nguyenduchan/coutingmachine/pcb/STM32G030C8T6/STM32_PINOUT.html

# STM32G030C8T6 — Chân GPIO & nối mạch

Tài liệu pinout cho compact counting-machine carrier (board 150×100 mm, nguồn 24 V). MCU thay ESP32-S3; nguồn chân = stm32_pinmap.py.

U1 STM32G030C8T6 Package LQFP-48 · 7×7 mm LCSC C529329 GPIO dùng 33 / 48 pad Clock HSI (không crystal MCU) Nạp USB-UART CH340 + BOOT0

## 1. Tất cả chân chip STM32G030C8T6 (LQFP-48)

Mỗi chân có hai lớp mô tả:

- General — khi nào chân này được dùng trên STM32G030 nói chung (chức năng silicon / AF điển hình), không phụ thuộc board máy đếm.
- Project — trên carrier này chân nối gì; nếu DÙNG thì tại sao chọn đúng chân đó; nếu KHÔNG DÙNG thì vì sao để trống.

Nguồn SoT project: stm32_pinmap.py. AF general theo datasheet / RM STM32G0.

48

Pad LQFP

33

GPIO tín hiệu dùng

5

Nguồn / reset

10

Không dùng (NC)

DÙNG có net trên PCB NGUỒN VDD / VSS / VBAT / VREF / NRST KHÔNG DÙNG pad để trống / floating

Chân KHÔNG DÙNG: không hàn dây, không kéo cứng lên/xuống. Đặc biệt PF0/PF1 và PC14/PC15 (OSC) — để floating; FW cấu hình Analog hoặc Input no-pull. MCU chạy HSI, không gắn crystal.

Pad | Cạnh | Tên chân | Trạng thái | Net board | General (chip) · Project (board này)
1 | W | PC13 | KHÔNG DÙNG | — | GeneralGPIO đa năng. Trên G030 còn map RTC_OUT (xung 1 Hz từ RTC), WKUP2 (đánh thức từ Standby/Shutdown), đôi khi LED status. ProjectKhông dùng. Máy đếm chạy liên tục, không Standby/RTC lịch. Giữ floating làm dự phòng LED “alive” nếu respin sau.
2 | W | PC14 | KHÔNG DÙNG | — | GeneralMặc định OSC32_IN: vào thạch anh 32,768 kHz (LSE) cho RTC chính xác. Có thể GPIO nếu LSE tắt — không hard-tie nếu có thể bật LSE sau. ProjectKhông dùng. Không cần timestamp tuyệt đối; clock hệ thống = HSI. Pad trống, không kéo GND/3V3.
3 | W | PC15 | KHÔNG DÙNG | — | GeneralMặc định OSC32_OUT: cặp với PC14 khi gắn LSE. Chỉ GPIO khi LSE off. ProjectKhông dùng. Cùng lý do PC14 — không gắn crystal 32 kHz.
4 | W | VBAT | NGUỒN | +3V3 | GeneralDomain backup (RTC, backup registers). Có thể nuôi pin lithium khi mất VDD. Không có pin riêng thì phải nối VBAT = VDD. ProjectNối chung +3V3. Vì sao: không pin backup trên carrier; vẫn cấp VBAT đúng datasheet để domain nội không float.
5 | W | VREF+ | NGUỒN | +3V3 | GeneralTham chiếu dương ADC (và analog liên quan). Thường = VDD hoặc nguồn ref ngoài ổn định hơn. Không để hở. ProjectNối +3V3. Vì sao: không đo ADC field (cảm biến digital qua opto) nhưng chân bắt buộc có nguồn; = VDD là cấu hình chuẩn khi không cần Vref riêng.
6 | W | VDD | NGUỒN | +3V3 + C_MCU | GeneralNguồn core + I/O (thường 2,0–3,6 V). Mọi GPIO lấy mức từ VDD. Cần tụ decoupling sát chân. ProjectTừ U6 AMS1117-3.3, C_MCU 100 n + C_MCU2 1 µ. Vì sao: rail logic duy nhất cho STM32, TMC logic, pull-up opto.
7 | W | VSS | NGUỒN | GND | GeneralGround chip — mốc 0 V. Nối plane GND chắc, via ngắn. ProjectNối GND board. Vì sao: mốc chung CH340, opto emitter, TMC GND.
8 | W | PF0 | KHÔNG DÙNG | — | GeneralMặc định OSC_IN (HSE): thạch anh / dao động 4–48 MHz cho clock chính xác (UART baud chặt, timer đo). GPIO nếu HSE off. ProjectKhông dùng. Clock MCU = HSI; Y1 12 MHz chỉ cho CH340. HSI đủ USART1 nạp và STEP.
9 | W | PF1 | KHÔNG DÙNG | — | GeneralMặc định OSC_OUT (HSE): cặp PF0. Không nối cứng lên/xuống nếu sau bật HSE. ProjectKhông dùng. Cùng chính sách PF0.
10 | W | NRST | NGUỒN | /NRST | GeneralReset phần cứng active-low. Chuẩn STM32: pull-up + tụ + nút (hoặc supervisor). Kéo xuống = reset core/peripheral. ProjectR_NRST PU, C_NRST, SW_NRST. Vì sao: nạp UART cần pulse NRST khi giữ BOOT0; vận hành dùng nút khôi phục treo FW.
11 | W | PA0 | DÙNG | /BUP ← U44.C | GeneralGPIO / ADC_IN0 / TIM2_CH1 / USART2_CTS… Thường: nút, cảm biến analog, PWM/timer, wake-up. Pin đầu port A — dễ nhớ trong FW. ProjectIN đếm 24 V qua PC817. Vì sao PA0: cạnh Tây sát cụm opto → trace ngắn; đủ AF timer nếu sau đếm cạnh cứng; không cần ADC vì opto đã digital.
12 | W | PA1 | DÙNG | /IN2 ← U45.C | GeneralGPIO / ADC_IN1 / TIM2_CH2 / USART2_RTS… Cùng họ PA0 — cặp tín hiệu hoặc ADC thứ hai. ProjectDI phụ J_IN2. Vì sao PA1: liền PA0 trong cụm đếm/DI; cùng cạnh W → bus opto gọn, không bắt chéo.
13 | S | PA2 | DÙNG | /IN3 ← U46.C | GeneralGPIO / ADC_IN2 / TIM2_CH3 / USART2_TX… Hay UART2 TX hoặc PWM. ProjectDI phụ J_IN3. Vì sao PA2: tiếp cụm PA0–3; USART1 đã ở PA9/10 nên không chiếm PA2 cho UART2.
14 | S | PA3 | DÙNG | /CNT5 ← U47.C | GeneralGPIO / ADC_IN3 / TIM2_CH4 / USART2_RX… Cặp RX với PA2; hoặc timer/ADC. ProjectĐếm IR 5 V (J_CNT5). Vì sao PA3 (không PD1): bốn kênh đếm/DI liền PA0–3 cạnh opto; PD1 để spare HMI. SoT = pinmap.
15 | S | PA4 | DÙNG | /STEP → U3 | GeneralGPIO / ADC_IN4 / SPI1_NSS / TIM14_CH1… Thường CS SPI hoặc GPIO xung. ProjectTMC1 STEP. Vì sao PA4: cạnh Nam hướng đế StepStick; có thể timer AF sau; R_PD tránh false-step lúc boot Hi-Z.
16 | S | PA5 | DÙNG | /DIR → U3 | GeneralGPIO / ADC_IN5 / SPI1_SCK… Clock SPI1 hoặc GPIO. ProjectTMC1 DIR. Vì sao PA5: cặp STEP trên cạnh S; board không dùng SPI1 (không flash/sensor SPI) → giải phóng cho DIR.
17 | S | PA6 | DÙNG | /EN_TMC → U3 | GeneralGPIO / ADC_IN6 / SPI1_MISO / TIM3_CH1 / TIM16_CH1… PWM hoặc MISO. ProjectTMC1 EN (active-low). Vì sao PA6: gom STEP/DIR/EN một cụm A; R2 PU→3V3 = driver tắt khi reset (fail-safe).
18 | S | PA7 | DÙNG | /STEP2 → U4 | GeneralGPIO / ADC_IN7 / SPI1_MOSI / TIM3_CH2 / TIM14… MOSI hoặc PWM. ProjectTMC2 STEP. Vì sao PA7: tiếp cụm TMC cạnh S; motor 2 cùng kiểu wiring, dễ copy FW.
19 | S | PB0 | DÙNG | /DIR2 → U4 | GeneralGPIO / ADC_IN8 / TIM3_CH3 / TIM1_CH2N… PWM / complementary timer hoặc analog. ProjectTMC2 DIR. Vì sao PB0: pad liền sau PA7 trên LQFP Nam — DIR2 cạnh STEP2.
20 | S | PB1 | DÙNG | /EN_TMC2 → U4 | GeneralGPIO / ADC_IN9 / TIM3_CH4 / TIM1_CH3N / TIM14… Cùng họ PB0. ProjectTMC2 EN. Vì sao PB1: kết thúc cụm TMC trên cạnh S; R2B PU giống TMC1.
21 | S | PB2 | DÙNG | /LED_RUN → R → D_LEDRUN → GND | GeneralGPIO “trung tính” (ít AF). Thường LED status / heartbeat / flag phần mềm. ProjectLED RUN (xanh), active-high. Vì sao PB2: spare giữa TMC/PWR; Hi-Z boot = LED tắt. FW nháy ~1–2 Hz.
22 | S | PB10 | DÙNG | /PWM_OUT1 → U_PWR1.4 | GeneralGPIO / TIM2_CH3 / I2C2_SCL… Hay PWM công suất hoặc I2C2 clock. ProjectPWM MOSFET ch1. Vì sao PB10: AF timer phù hợp PWM; cạnh S→E gần U_PWR; không dùng I2C2 → không xung đột.
23 | S | PB11 | DÙNG | /PWM_OUT2 → U_PWR2.4 | GeneralGPIO / TIM2_CH4 / I2C2_SDA… Cặp I2C với PB10 hoặc PWM kênh 2. ProjectPWM MOSFET ch2. Vì sao PB11: cặp PB10; hai PWM liền nhau, cùng timer dễ hơn rải PA11/12.
24 | S | PB12 | DÙNG | /PWR_EN1 → U_PWR1.5 | GeneralGPIO / TIM1_BKIN / SPI2_NSS… Break timer hoặc CS SPI2; thường GPIO enable tải. ProjectEN MOSFET ch1. Vì sao PB12: tách EN khỏi PWM (fail-safe 2 lớp); cạnh cụm PWR.
25 | E | PB13 | DÙNG | /PWR_EN2 → U_PWR2.5 | GeneralGPIO / TIM1_CH1N / SPI2_SCK… Complementary PWM hoặc SPI2 clock. ProjectEN MOSFET ch2. Vì sao PB13: đối xứng PB12; không dùng SPI2 trên carrier.
26 | E | PB14 | DÙNG | /PWR_FAULT ← U_PWR*.6 | GeneralGPIO / TIM1_CH2N / SPI2_MISO / TIM15_CH1… PWM/MISO; hay input fault open-drain. ProjectFault chung 2 module (OD + PU). Vì sao PB14: một GPIO wire-OR tiết kiệm chân; cạnh FAULT pin module SE.
27 | E | PB15 | DÙNG | /VIB_CTRL → U_VIB.3 | GeneralGPIO / TIM1_CH3N / SPI2_MOSI / TIM15… PWM/MOSI hoặc DO công suất. ProjectCTRL SSR rung. Vì sao PB15: liền cụm PWR cạnh E; R_PD = OFF lúc boot; SSR on/off không cần PWM cao tần.
28 | E | PA8 | DÙNG | /VIB_FAULT ← U_VIB.4 | GeneralGPIO / TIM1_CH1 / MCO (clock out)… PWM TIM1 hoặc xuất clock debug. ProjectFault rung. Vì sao PA8: tách PWR_FAULT để FW phân biệt nguồn lỗi; cạnh U_VIB; không cần MCO sản xuất.
29 | E | PA9 | DÙNG | /UART_TX → CH340 RX | GeneralUSART1_TX (AF quan trọng trên G030) / TIM1_CH2… Cổng serial chính nạp bootloader ROM và log. ProjectTX → CH340. Vì sao PA9: bắt buộc USART1 cho USB-UART boot; không remap tự do như một số dòng khác.
30 | E | PC6 | DÙNG | /LED_ERR → R → D_LEDERR → GND | GeneralGPIO / TIM3_CH1… PWM, capture, hoặc DI/LED. ProjectLED ERR (đỏ). Vì sao PC6: cạnh E gần USB/STATUS silk; báo PWR_FAULT / VIB_FAULT / lỗi SW.
31 | E | PC7 | KHÔNG DÙNG | — | GeneralGPIO / TIM3_CH2… Cặp timer với PC6. ProjectKhông dùng. PC6 đã lấy cho ERR; giữ spare.
32 | E | PA10 | DÙNG | /UART_RX ← CH340 TX | GeneralUSART1_RX / TIM1_CH3… Cặp bắt buộc với PA9 cho USART1. ProjectRX ← CH340. Vì sao PA10: cặp USART1 cố định với PA9; chéo TX/RX chuẩn.
33 | E | PA11 | KHÔNG DÙNG | — | GeneralGPIO / USART1_CTS / TIM1_CH4… Flow-control hoặc timer. Trên G030 không phải USB_DM (không có USB device). ProjectKhông dùng. USB đi CH340; PWM tải đã ở PB10/11. Không nối D−.
34 | E | PA12 | KHÔNG DÙNG | — | GeneralGPIO / USART1_RTS / TIM1_ETR… Cặp flow-control PA11. Không phải USB_DP trên G030. ProjectKhông dùng. Không RTS/CTS (nạp thủ công BOOT+NRST). Không nối D+.
35 | E | PA13 | DÙNG | /SWDIO + R_SWDIO PU | GeneralSWDIO — dữ liệu Serial Wire Debug. Hầu hết board giữ + pull-up cho ST-Link nạp/breakpoint. AF IR_OUT hiếm dùng. ProjectSWD data + PU 10k. Vì sao vẫn nối: bỏ J_DBG (lot nhỏ) nhưng pad + R cho phép kẹp probe sửa FW; không để float.
36 | E | PA14 | DÙNG | /SWCLK + SW_BOOT | GeneralSWCLK (clock SWD) và trên G030 lấy mẫu BOOT0 lúc reset: cao = bootloader hệ thống, thấp = flash user. ProjectSWCLK + nút BOOT lên 3V3, R_BOOT PD. Vì sao PA14: một chân làm debug clock và chọn boot UART qua USB — không cần chân BOOT0 rời.
37 | N | PA15 | DÙNG | /TM_CLK → J_DISP.1 | GeneralGPIO / SPI1_NSS / TIM2_CH1 / USART2_RX… CS SPI hoặc GPIO bit-bang (protocol LED). ProjectTM1637 CLK. Vì sao PA15: cạnh Bắc gần J_DISP; bit-bang không cần SPI HW; SPI1 đã giải phóng cho TMC GPIO.
38 | N | PD0 | DÙNG | /TM_DIO → J_DISP.2 | GeneralGPIO trên G030C8 (port D ở LQFP48). Ít AF bắt buộc; thường GPIO / EVENTOUT. ProjectTM1637 DIO. Vì sao PD0: liền PA15 cạnh N → CLK/DIO ngắn tới XH-4; open-drain bit-bang phù hợp module 5 V.
39 | N | PD1 | KHÔNG DÙNG | — | GeneralGPIO (LQFP48). Có thể SPI2_SCK trên một số map; chủ yếu spare. ProjectKhông dùng. Không phải /CNT5. Để trống cạnh HMI; đếm 5 V = PA3.
40 | N | PD2 | KHÔNG DÙNG | — | GeneralGPIO / TIM3_ETR… Trigger timer ngoài hoặc DI. ProjectKhông dùng. Spare HMI / mở rộng sau.
41 | N | PD3 | DÙNG | /KEY_C3 → J_KEY.8 | GeneralGPIO. Ít AF bắt buộc — phù hợp ma trận phím, LED, CS. ProjectKeypad COL3. Vì sao PD3: pad Bắc W→E khớp J_KEY pin8 (đông nhất) → zero crossover PCB.
42 | N | PB3 | DÙNG | /KEY_C2 → J_KEY.7 | GeneralGPIO / SPI1_SCK / TIM2_CH2… Sau khi bỏ JTAG full, PB3 thường free SPI/GPIO. ProjectKeypad COL2. Vì sao PB3: tiếp chuỗi Bắc map J_KEY; không dùng SPI1.
43 | N | PB4 | DÙNG | /KEY_C1 → J_KEY.6 | GeneralGPIO / SPI1_MISO / TIM3_CH1… ProjectKeypad COL1. Vì sao PB4: cùng chuỗi map keypad không bắt chéo.
44 | N | PB5 | DÙNG | /KEY_C0 → J_KEY.5 | GeneralGPIO / SPI1_MOSI / TIM3_CH2 / I2C1_SMBA… ProjectKeypad COL0. Vì sao PB5: hết khối COL; I2C1 không dùng (không EEPROM/sensor I2C).
45 | N | PB6 | DÙNG | /KEY_R3 → J_KEY.4 | GeneralGPIO / I2C1_SCL / USART1_TX (remap) / TIM1… Thường SCL hoặc UART remap. ProjectKeypad ROW3. Vì sao PB6: USART1 cố định PA9/10 → PB6 rảnh cho hàng phím; map đúng J_KEY pin4.
46 | N | PB7 | DÙNG | /KEY_R2 → J_KEY.3 | GeneralGPIO / I2C1_SDA / USART1_RX remap… ProjectKeypad ROW2. Vì sao PB7: cặp I2C không dùng → giải phóng làm ROW; liền PB6.
47 | N | PB8 | DÙNG | /KEY_R1 → J_KEY.2 | GeneralGPIO / I2C1_SCL (AF khác) / TIM16_CH1… ProjectKeypad ROW1. Vì sao PB8: tiếp chuỗi ROW Bắc → J_KEY.
48 | N | PB9 | DÙNG | /KEY_R0 → J_KEY.1 | GeneralGPIO / I2C1_SDA / TIM17_CH1 / IR_OUT… ProjectKeypad ROW0 (J_KEY pin1). Vì sao PB9: pad 48 góc NW Bắc khớp pad1 giắc → ROW0–3 rồi COL0–3 đúng thứ tự vật lý.

### Tóm tắt chân không dùng trên board

Pin | Pad | General — khi nào dùng | Vì sao project không dùng
PC13 | 1 | RTC_OUT, WKUP2, GPIO status | Không Standby/RTC lịch
PC14, PC15 | 2–3 | Thạch anh LSE 32 kHz cho RTC | Không cần giờ tuyệt đối; HSI đủ
PF0, PF1 | 8–9 | Thạch anh HSE clock chính | HSI; Y1 chỉ cho CH340
PC7 | 31 | TIM3 PWM / capture | PC6 đã dùng LED ERR
PA11, PA12 | 33–34 | USART1 CTS/RTS, TIM1; không USB trên G030 | USB=CH340; không flow-control
PD1, PD2 | 39–40 | GPIO / timer ETR | Spare HMI; CNT5 = PA3

### LED ngoài GPIO (thụ động)

Ngoài RUN/ERR trên PB2/PC6, board có LED nguồn và LED hoạt động cảm biến không tốn GPIO:

- D_LED24 / D_LED3V3 — rail +24V / +3V3 có điện.
- D_LEDBUP / D_LEDCNT5 — đếm: +3V3 → R → LED → /BUP hoặc /CNT5; sáng khi opto kéo collector thấp (có vật chắn).
- D_LEDIN2 / D_LEDIN3 — cùng kiểu cho DI phụ.

Pad đã gán net trên PCB; track để đi dây tay.

## 2. Vai trò MCU trong project

Board carrier điều khiển máy đếm viên: đọc cảm biến đếm (cách ly opto), chạy tối đa 2 động cơ bước (TMC2209), điều khiển tải 24 V (module MOSFET), rung máng (SSR), hiển thị TM1637 + keypad, nạp/log qua USB.

#### Vì sao STM32G030?

Đủ GPIO (31 chân dùng), USART1 cố định cho CH340, giá SMT JLCPCB thấp, LQFP48 dễ layout cạnh DIN. Không cần Wi-Fi/BT như ESP32 cũ.

#### SoT (source of truth)

pcb/STM32G030C8T6/stm32_pinmap.py → gen_compact_carrier.py · verify_compact.py · BOM.md. Firmware Cube chưa có trong repo — tài liệu này mô tả phần cứng.

## 3. Chính sách định chân — lý do tổng thể

Quy tắc vàng: nhóm tín hiệu theo cạnh LQFP để dây PCB ngắn, khớp vị trí giắc field (N/S) và module driver (S/SE).

Tây (W) → Opto / đếm Nam (S) → TMC Đông/SE → PWR / VIB / UART Bắc (N) → HMI

Cạnh LQFP | Pad | Nhóm chức năng | Lý do
Tây (W) | 1–12 | PA0–PA3 đếm + nguồn | Opto U44–U47 nằm giữa board, gần cạnh Bắc (giắc cảm biến). PA0–3 sát cụm opto → trace ngắn, nhiễu ít.
Nam (S) | 13–24 | TMC1/TMC2 STEP·DIR·EN | Đế StepStick + J_MOT* ở cạnh dưới. STEP/DIR cần cạnh xung sạch — gom một cạnh, có R pull-down fail-safe.
Đông (E) | 25–36 | PWM/EN/FAULT, VIB, USART1, SWD | U_PWR / U_VIB ở SE; CH340 + USB ở NE. USART1 chỉ có trên PA9/PA10 (fixed AF).
Bắc (N) | 37–48 | TM1637 + keypad | J_DISP / J_KEY ở cạnh trên. Keypad ROW/COL map đúng thứ tự pad1→8 (W→E) → 0 crossover.

## 4. Sơ đồ khối hệ thống

## 5. Sơ đồ chân LQFP-48 (nhìn từ trên, pin 1 góc NW)

Màu theo nhóm chức năng. Chân xám = nguồn / NC. Số = pad LQFP.

Opto TMC PWR/VIB HMI UART/SWD Power/Reset NC / spare

## 6. Đếm & DI — Opto PC817 (U44–U47)

Cảm biến field 24 V / 5 V không nối thẳng vào GPIO. NPN open-collector kéo LED phía primary của PC817; collector phía MCU kéo xuống → GPIO đọc mức thấp khi có tín hiệu.

STM32 | Net | Opto | Giắc field | Chân linh kiện | Lý do dùng
PA0 pad11 | /BUP | U44 pin4 (C) | J14 pin3 OUT · hoặc J15 pin3 | BUP-30S Black OUT · fiber OUT | Kênh đếm chính 24 V. PA0 sát cạnh W → gần cụm opto. Pull-up R48 10k.
PA1 pad12 | /IN2 | U45 pin4 | J_IN2 pin3 SIG | PLC start / jam / DI phụ | DI dự phòng cùng rail SNS 24 V; cách ly giống BUP.
PA2 pad13 | /IN3 | U46 pin4 | J_IN3 pin3 SIG | Stop / dự phòng | Cặp với IN2; pad13 vẫn gần W/S góc — vẫn cụm opto.
PA3 pad14 | /CNT5 | U47 pin4 | J_CNT5 pin3 OUT | IR through-beam 5 V | SKU rẻ đếm 5 V; R series 1k (không 2k2). Không dùng PD1 — SoT là PA3.

### Pinout giắc liên quan

#### J14 BUP-30S (XH-4)

1 +24V_SNS (Brn) · 2 GND (Blu) · 3 OUT (Blk) → opto · 4 CTRL→+V Light ON (Wht)

#### J_CNT5 (XH-3)

1 +5V · 2 GND · 3 /OPTO_IN_5V → U47. Module TTL active-high cần transistor OC ngoài.

## 7. Động cơ bước — TMC2209 (U3 / U4)

MCU chỉ điều khiển logic STEP / DIR / EN. Pha động cơ ra J_MOT* từ module — không lấy giắc sẵn trên StepStick (layout DIN cạnh dưới).

STM32 PA4 STEP → U3 pad STEP + R_PD → TMC2209 → J_MOT1 A1/A2/B1/B2 → NEMA17

STM32 | Net | Module | Chân TMC (StepStick) | Fail-safe | Lý do
PA4 | /STEP | U3 | STEP | R_PD_STEP → GND | Xung bước motor 1. Timer PWM/GPIO toggle trong FW. PD tránh false-step khi MCU Hi-Z lúc boot.
PA5 | /DIR | U3 | DIR | R_PD_DIR | Hướng quay. Cùng cạnh S với STEP → cặp tín hiệu ngắn.
PA6 | /EN_TMC | U3 | EN (active-low) | R2 pull-up → 3V3 | PU giữ driver tắt khi reset/boot (an toàn). FW kéo LOW để enable.
PA7 | /STEP2 | U4 | STEP | R_PD_STEP2 | Motor 2 — SKU đắt / trục phụ.
PB0 | /DIR2 | U4 | DIR | R_PD_DIR2 | Liền pad với STEP2 trên cạnh Nam.
PB1 | /EN_TMC2 | U4 | EN | R2B PU | Cùng chính sách fail-safe như TMC1.

MS1/MS2/UART trên module TMC NC trên carrier — microstep cấu hình trên Jumpers module. VMOT qua PTC_MOT 1.1 A riêng từng kênh.

## 8. Tải 24 V — MOSFET + rung (U_PWR / U_VIB)

STM32 | Net | Đích | Chân module | Lý do
PB10 | /PWM_OUT1 | U_PWR1 | pin 4 | PWM điều khiển duty tải 24 V (van, blower…). R_PD_PWM1: boot Hi-Z = OFF.
PB11 | /PWM_OUT2 | U_PWR2 | pin 4 | Kênh 2 độc lập — 1 output = 1 module cắm rời.
PB12 | /PWR_EN1 | U_PWR1 | pin 5 | Enable cứng; tách khỏi PWM để fail-safe 2 lớp (EN OFF + PWM PD).
PB13 | /PWR_EN2 | U_PWR2 | pin 5 | Tương tự kênh 2.
PB14 | /PWR_FAULT | U_PWR1+2 | pin 6 (wire-OR OD) | Chung một net + R_PWR_FLT PU — tiết kiệm GPIO; FW đọc lỗi quá dòng/quá nhiệt module.
PB15 | /VIB_CTRL | U_VIB | pin 3 | Bật/tắt SSR máng rung (bowl feeder). R_PD_VIB = OFF lúc boot.
PA8 | /VIB_FAULT | U_VIB | pin 4 | Fault riêng rung; R_VIB_FLT PU. Tách khỏi PWR_FAULT để FW biết nguồn lỗi.

## 9. HMI — TM1637 + Keypad 4×4

### TM1637 (J_DISP)

STM32 | Net | J_DISP | Module | Lý do
PA15 | /TM_CLK | pin 1 | CLK | Bit-bang TM1637. Cạnh Bắc gần J_DISP. Gợi ý FW: open-drain (module thường 5 V logic, MCU 3.3 V OK với hầu hết module).
PD0 | /TM_DIO | pin 2 | DIO | Data 2-wire. J_DISP pin3=+5V, pin4=GND — driver trên module, không hàn SOP-20 trên board.

### Keypad (J_KEY) — map không bắt chéo

J_KEY xoay 90°: pad1 Tây → pad8 Đông. LQFP cạnh Bắc từ Tây→Đông: PB9…PB3 rồi PD3. Gán ROW0–3 rồi COL0–3 đúng thứ tự đó → PCB không cần vias bắt chéo.

J_KEY pin | STM32 | Net | Vai trò
1 | PB9 pad48 | /KEY_R0 | Hàng 0
2 | PB8 pad47 | /KEY_R1 | Hàng 1
3 | PB7 pad46 | /KEY_R2 | Hàng 2
4 | PB6 pad45 | /KEY_R3 | Hàng 3
5 | PB5 pad44 | /KEY_C0 | Cột 0
6 | PB4 pad43 | /KEY_C1 | Cột 1
7 | PB3 pad42 | /KEY_C2 | Cột 2
8 | PD3 pad41 | /KEY_C3 | Cột 3

FW điển hình: scan matrix — drive ROW lần lượt, đọc COL (hoặc ngược lại) với debounce.

## 10. USB-UART & Boot (CH340C)

STM32 | Net | Nối tới | Lý do
PA9 | /UART_TX | CH340 RX (chéo TX→RX) | USART1_TX là AF cố định trên G030 — bắt buộc cặp này cho USB-UART.
PA10 | /UART_RX | CH340 TX | USART1_RX. Không DTR/RTS auto-boot — nạp thủ công bằng nút.
PA13 | /SWDIO | R_SWDIO 10k → 3V3 | SWD data; không hàn J_DBG (lot nhỏ tiết kiệm). Vẫn có thể gắn đầu dò nếu cần.
PA14 | /SWCLK + BOOT0 | R_BOOT 10k→GND; SW_BOOT kéo lên 3V3 | Trên G030, PA14 đóng vai trò SWCLK và lấy mẫu BOOT0. Giữ BOOT + pulse NRST → vào bootloader UART.
NRST pad10 | /NRST | R_NRST PU, C_NRST, SW_NRST | Reset phần cứng chuẩn ST.

Quy trình nạp: giữ SW_BOOT → nhấn/nhả SW_NRST → nhả BOOT → flash qua cổng COM CH340 (STM32CubeProgrammer / stm32flash).

## 11. Chân nguồn MCU

Pad | Tên | Net | Ghi chú
4 | VBAT | +3V3 | Không dùng pin pin — nối chung 3V3.
5 | VREF+ | +3V3 | Tham chiếu ADC = VDD (chưa dùng ADC field).
6 | VDD | +3V3 | Từ AMS1117 U6; có C_MCU / C_MCU2.
7 | VSS | GND | Ground.

Chuỗi nguồn board: J1 → D3 → F1 → +24V → U2(MP1584) → +5V → U6(AMS1117) → +3V3 → U1. Crystal Y1 12 MHz chỉ cho CH340 — MCU chạy HSI, không gắn HSE.

## 12. Chân chưa dùng (NC) — nhắc lại

Trên carrier này các chân dưới không bao giờ được đọc/xuất trong vận hành. Cột General ở mục 1 mô tả khi nào chân đó dùng trên chip nói chung. Để floating; FW Analog hoặc Input no-pull. Không hard-tie PF0/PF1 hay PC14/PC15.

Pin | Pad | General — khi nào dùng | Vì sao không dùng trên board
PC13 | 1 | RTC_OUT / WKUP2 / GPIO | Không Standby, không RTC lịch
PC14, PC15 | 2–3 | LSE 32 kHz | HSI đủ; không cần giờ tuyệt đối
PF0, PF1 | 8–9 | HSE crystal | HSI; Y1 chỉ nuôi CH340
PC7 | 31 | TIM3 PWM / capture | PC6 đã dùng LED ERR
PA11, PA12 | 33–34 | USART1 CTS/RTS (không phải USB) | USB = CH340; không flow-control
PD1, PD2 | 39–40 | GPIO / TIM3_ETR | Spare HMI; CNT5 = PA3

## 13. Bảng tổng hợp GPIO đã dùng

Pad | Pin | Net | Hướng | Nối tới | Chân đích | Lý do ngắn
11 | PA0 | /BUP | IN | U44 | C (4) | Đếm 24V chính
12 | PA1 | /IN2 | IN | U45 | C (4) | DI phụ
13 | PA2 | /IN3 | IN | U46 | C (4) | DI phụ
14 | PA3 | /CNT5 | IN | U47 | C (4) | Đếm IR 5V
15 | PA4 | /STEP | OUT | U3 TMC1 | STEP | Xung bước M1
16 | PA5 | /DIR | OUT | U3 | DIR | Hướng M1
17 | PA6 | /EN_TMC | OUT | U3 | EN | Enable M1 (AL)
18 | PA7 | /STEP2 | OUT | U4 TMC2 | STEP | Xung bước M2
19 | PB0 | /DIR2 | OUT | U4 | DIR | Hướng M2
20 | PB1 | /EN_TMC2 | OUT | U4 | EN | Enable M2
22 | PB10 | /PWM_OUT1 | OUT | U_PWR1 | 4 | PWM tải 1
23 | PB11 | /PWM_OUT2 | OUT | U_PWR2 | 4 | PWM tải 2
24 | PB12 | /PWR_EN1 | OUT | U_PWR1 | 5 | EN tải 1
25 | PB13 | /PWR_EN2 | OUT | U_PWR2 | 5 | EN tải 2
26 | PB14 | /PWR_FAULT | IN | U_PWR1+2 | 6 OD | Fault chung
27 | PB15 | /VIB_CTRL | OUT | U_VIB | 3 | SSR rung
28 | PA8 | /VIB_FAULT | IN | U_VIB | 4 | Fault rung
29 | PA9 | /UART_TX | OUT | CH340 U5 | RX | USART1 TX
32 | PA10 | /UART_RX | IN | CH340 U5 | TX | USART1 RX
35 | PA13 | /SWDIO | I/O | R_SWDIO | — | SWD
36 | PA14 | /SWCLK | I/O | SW_BOOT | — | SWCLK+BOOT0
37 | PA15 | /TM_CLK | OUT | J_DISP | 1 | TM1637 CLK
38 | PD0 | /TM_DIO | I/O | J_DISP | 2 | TM1637 DIO
41 | PD3 | /KEY_C3 | I/O | J_KEY | 8 | Key col3
42 | PB3 | /KEY_C2 | I/O | J_KEY | 7 | Key col2
43 | PB4 | /KEY_C1 | I/O | J_KEY | 6 | Key col1
44 | PB5 | /KEY_C0 | I/O | J_KEY | 5 | Key col0
45 | PB6 | /KEY_R3 | I/O | J_KEY | 4 | Key row3
46 | PB7 | /KEY_R2 | I/O | J_KEY | 3 | Key row2
47 | PB8 | /KEY_R1 | I/O | J_KEY | 2 | Key row1
48 | PB9 | /KEY_R0 | I/O | J_KEY | 1 | Key row0

## Tham chiếu file

- pcb/STM32G030C8T6/stm32_pinmap.py — SoT tên chân
- pcb/STM32G030C8T6/gen_compact_carrier.py — netlist & placement
- pcb/STM32G030C8T6/BOM.md — BOM + pinout giắc
- pcb/STM32G030C8T6/verify_compact.py — kiểm tra pinmap

Một số đoạn cũ trong PCB_REVIEW.md / README ESP32 mô tả pin khác (ESP32-S3 hoặc map PWM cũ). Khi lệch, luôn tin stm32_pinmap.py.

Counting Machine · STM32G030C8T6 pinout · sinh từ pinmap project · mở file này bằng trình duyệt
