nguyenduchan/coutingmachine/3d_model/freecad/out/_snapshot_front.png

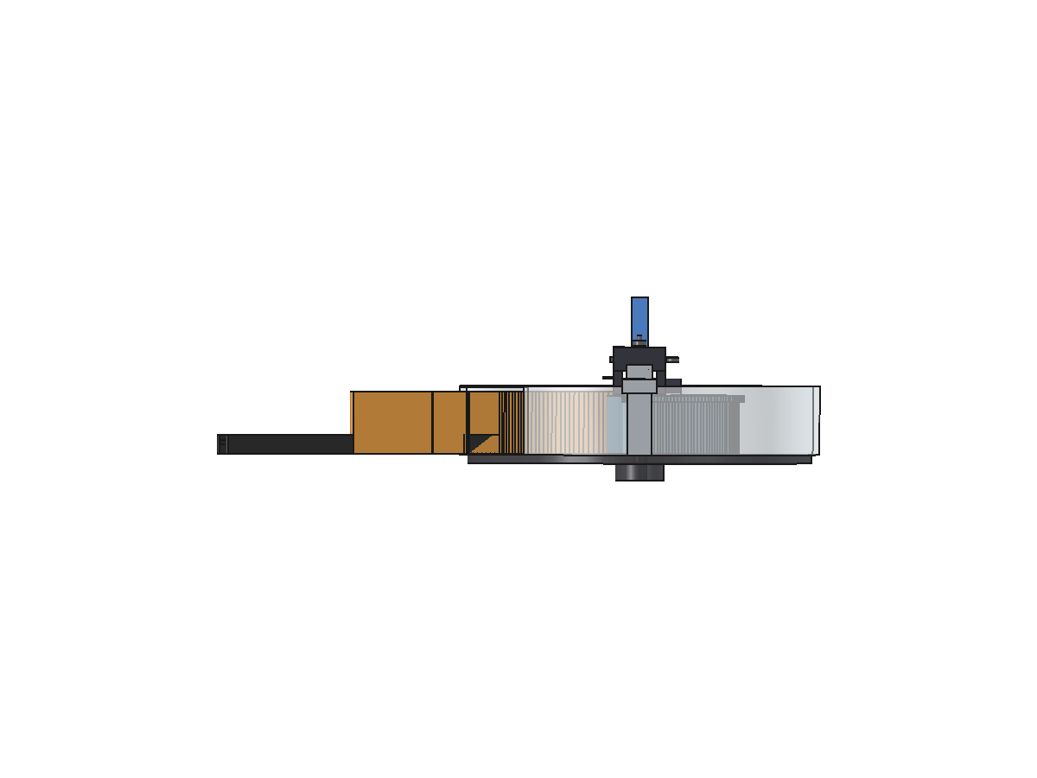
3d_model/freecad/out/_snapshot_front.png
