nguyenduchan/coutingmachine/3d_model/freecad/out/_snapshot_iso.png

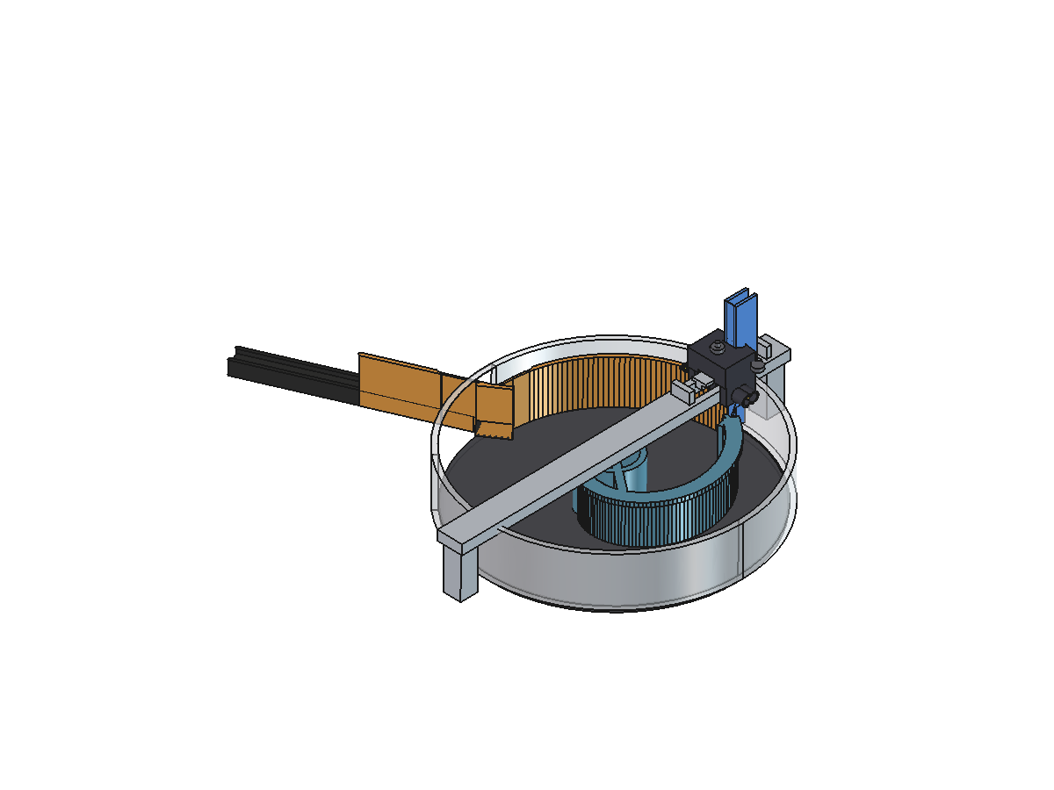
3d_model/freecad/out/_snapshot_iso.png
