nguyenduchan/coutingmachine/3d_model/freecad/out/exit_tray_topview.png

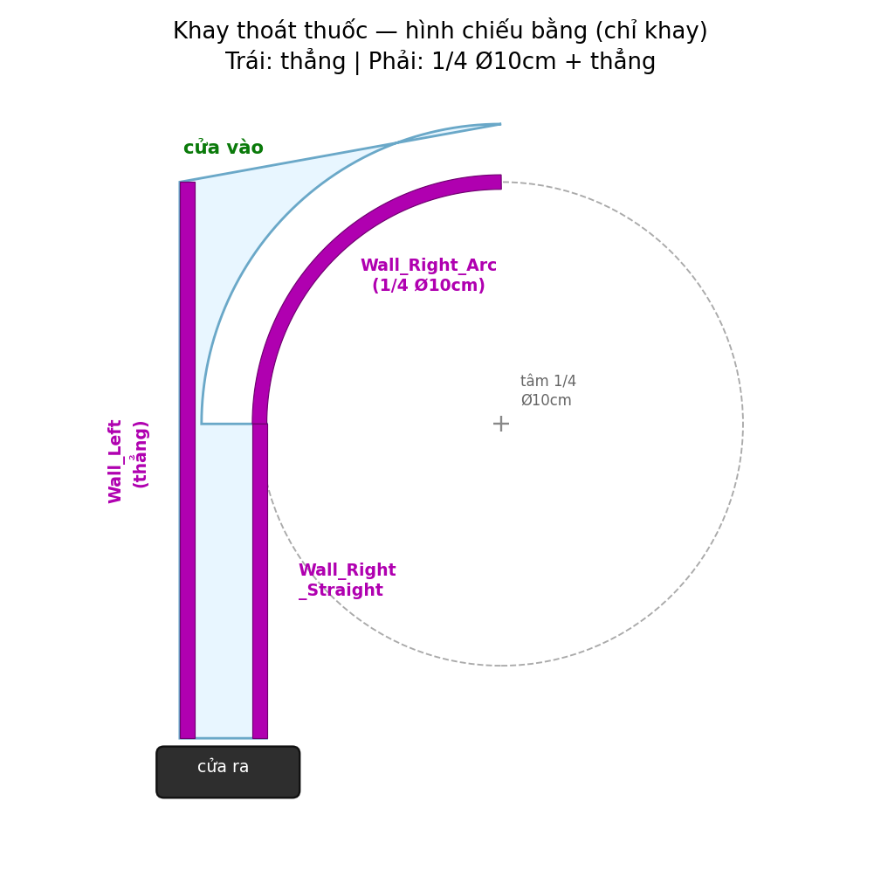
3d_model/freecad/out/exit_tray_topview.png
