nguyenduchan/coutingmachine/3d_model/freecad/out/l_flap_pill_path_choice.png

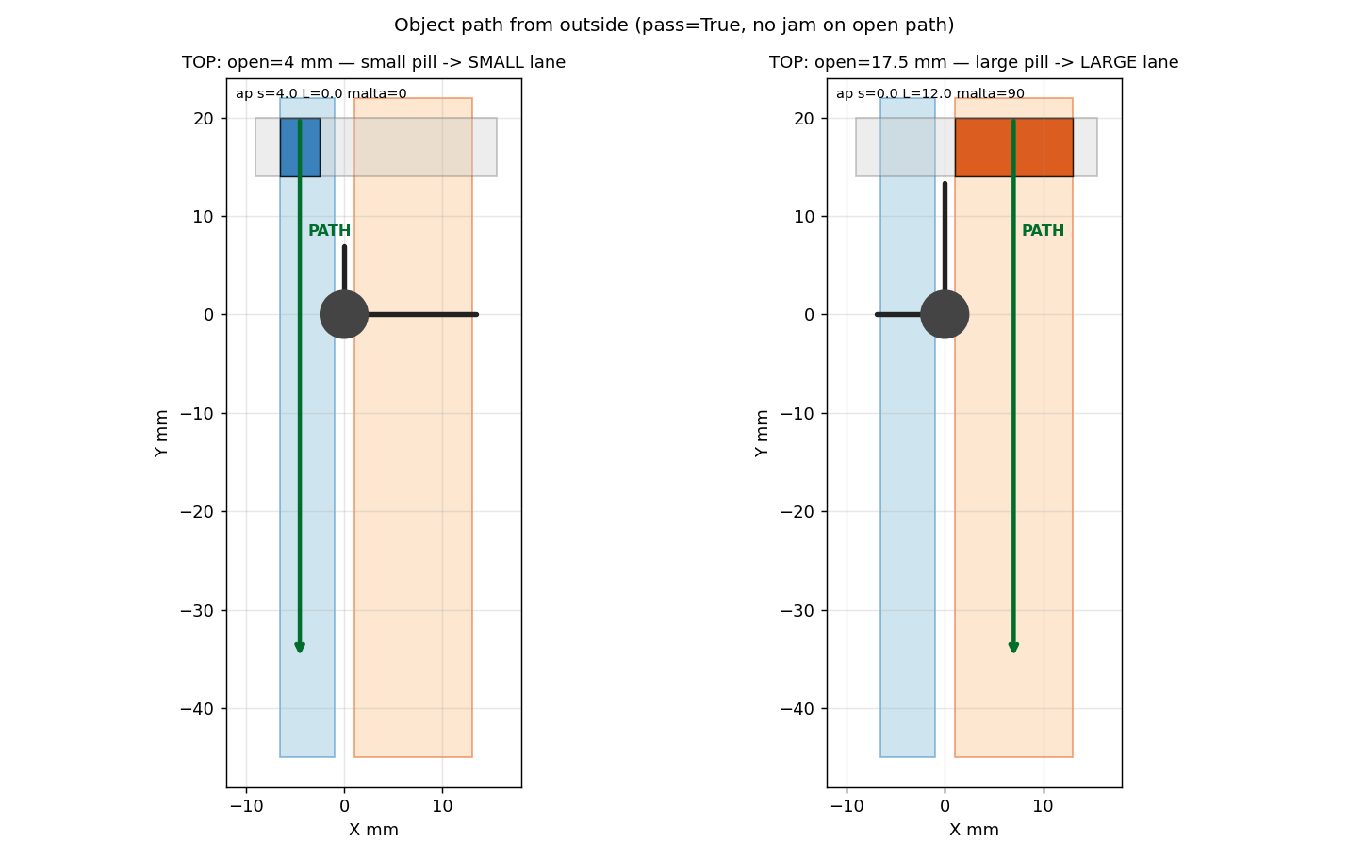
3d_model/freecad/out/l_flap_pill_path_choice.png
