nguyenduchan/coutingmachine/3d_model/freecad/out/l_flap_topview_open0_cover_small.png

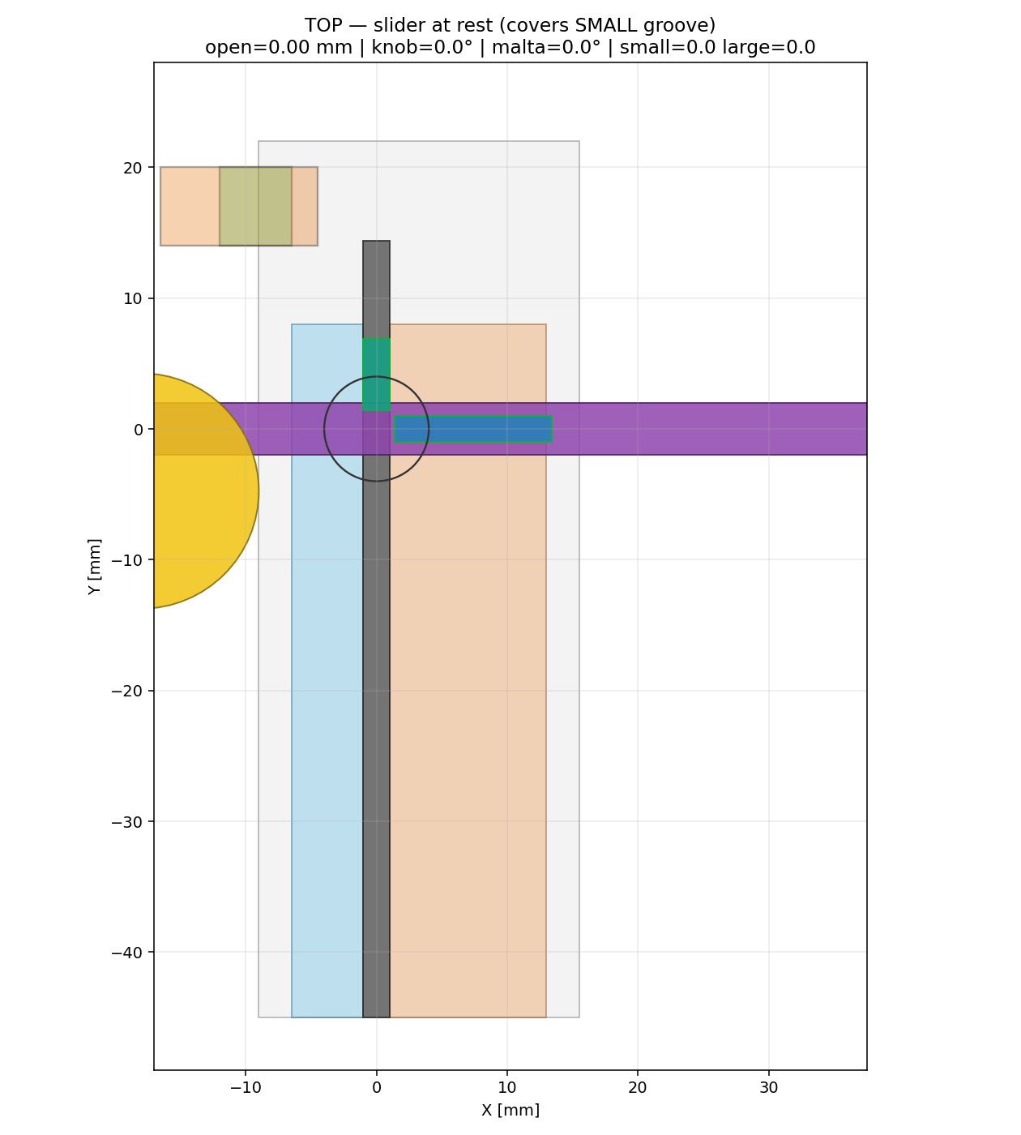
3d_model/freecad/out/l_flap_topview_open0_cover_small.png
