nguyenduchan/coutingmachine/3d_model/freecad/out/ref_frame_01.jpg

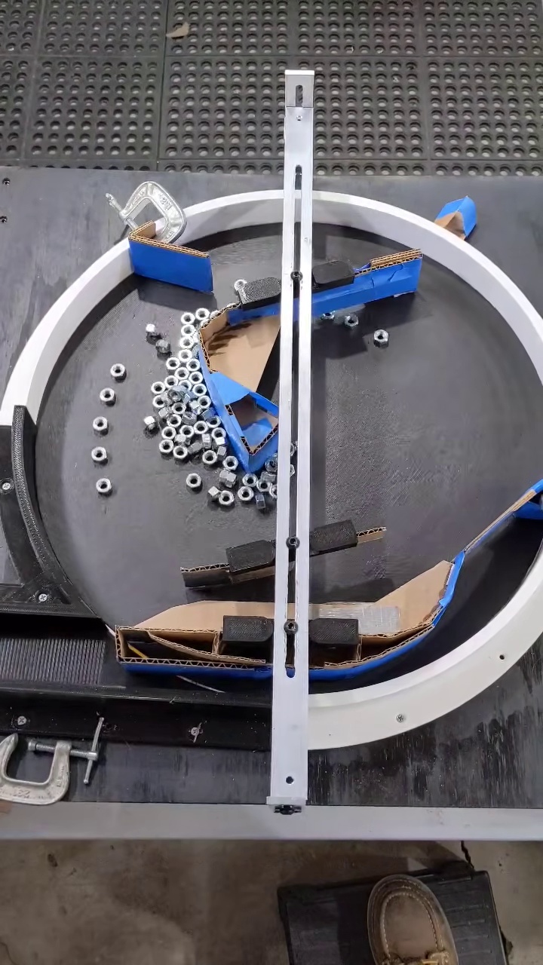
3d_model/freecad/out/ref_frame_01.jpg
