nguyenduchan/coutingmachine/3d_model/freecad/out/ref_schaner_thumb2.jpg

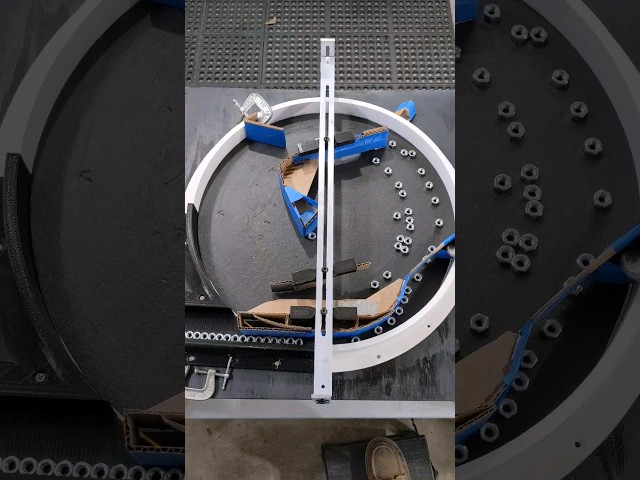
3d_model/freecad/out/ref_schaner_thumb2.jpg
