nguyenduchan/coutingmachine/3d_model/out/base_cavity.png

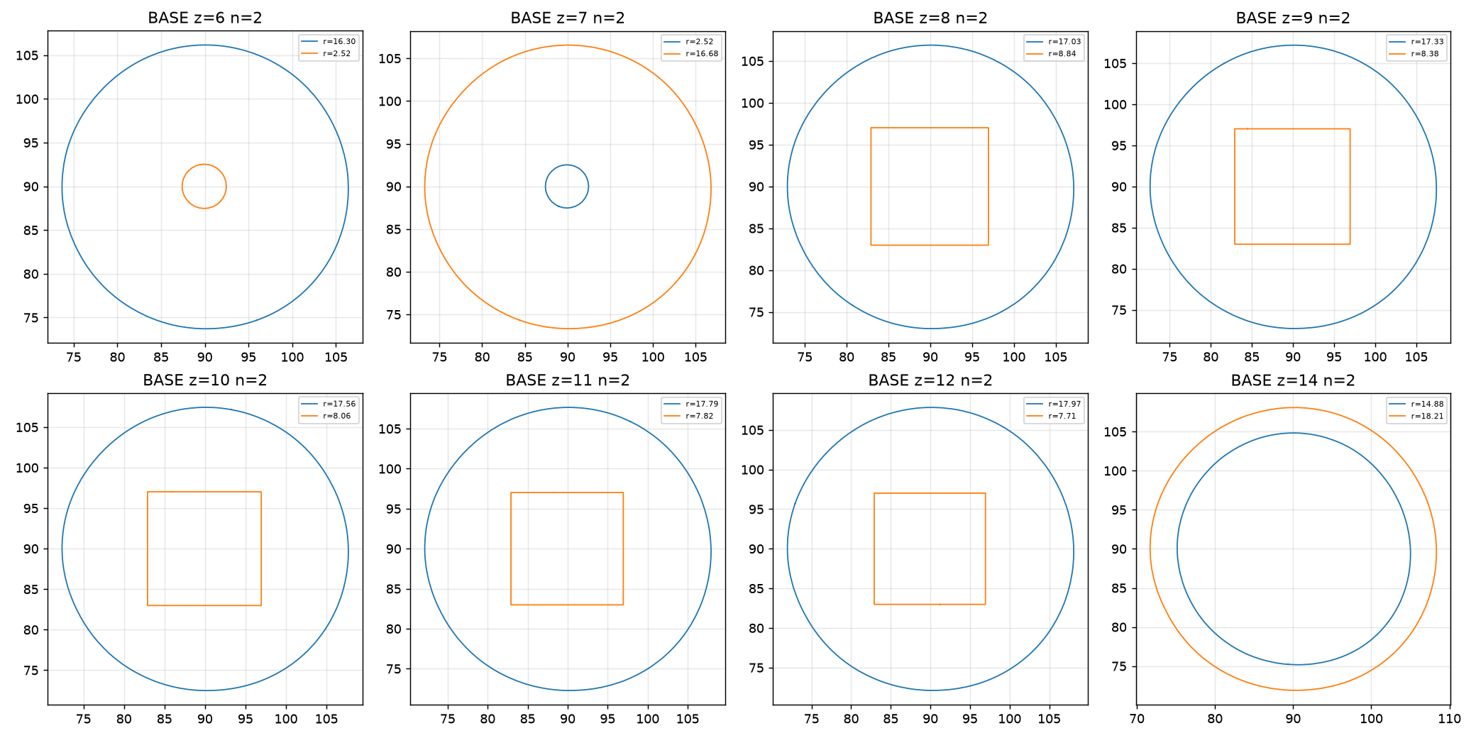
3d_model/out/base_cavity.png
