nguyenduchan/coutingmachine/3d_model/out/khop_noi_preview.png

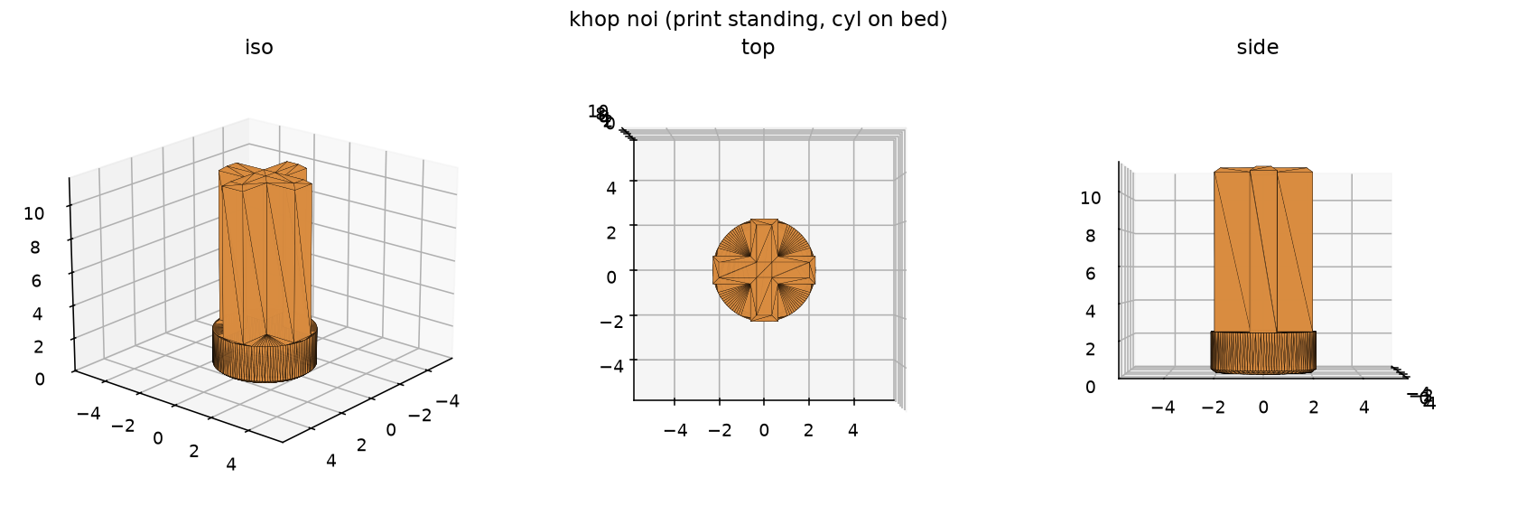
3d_model/out/khop_noi_preview.png
