nguyenduchan/coutingmachine/3d_model/out/slice_base.png

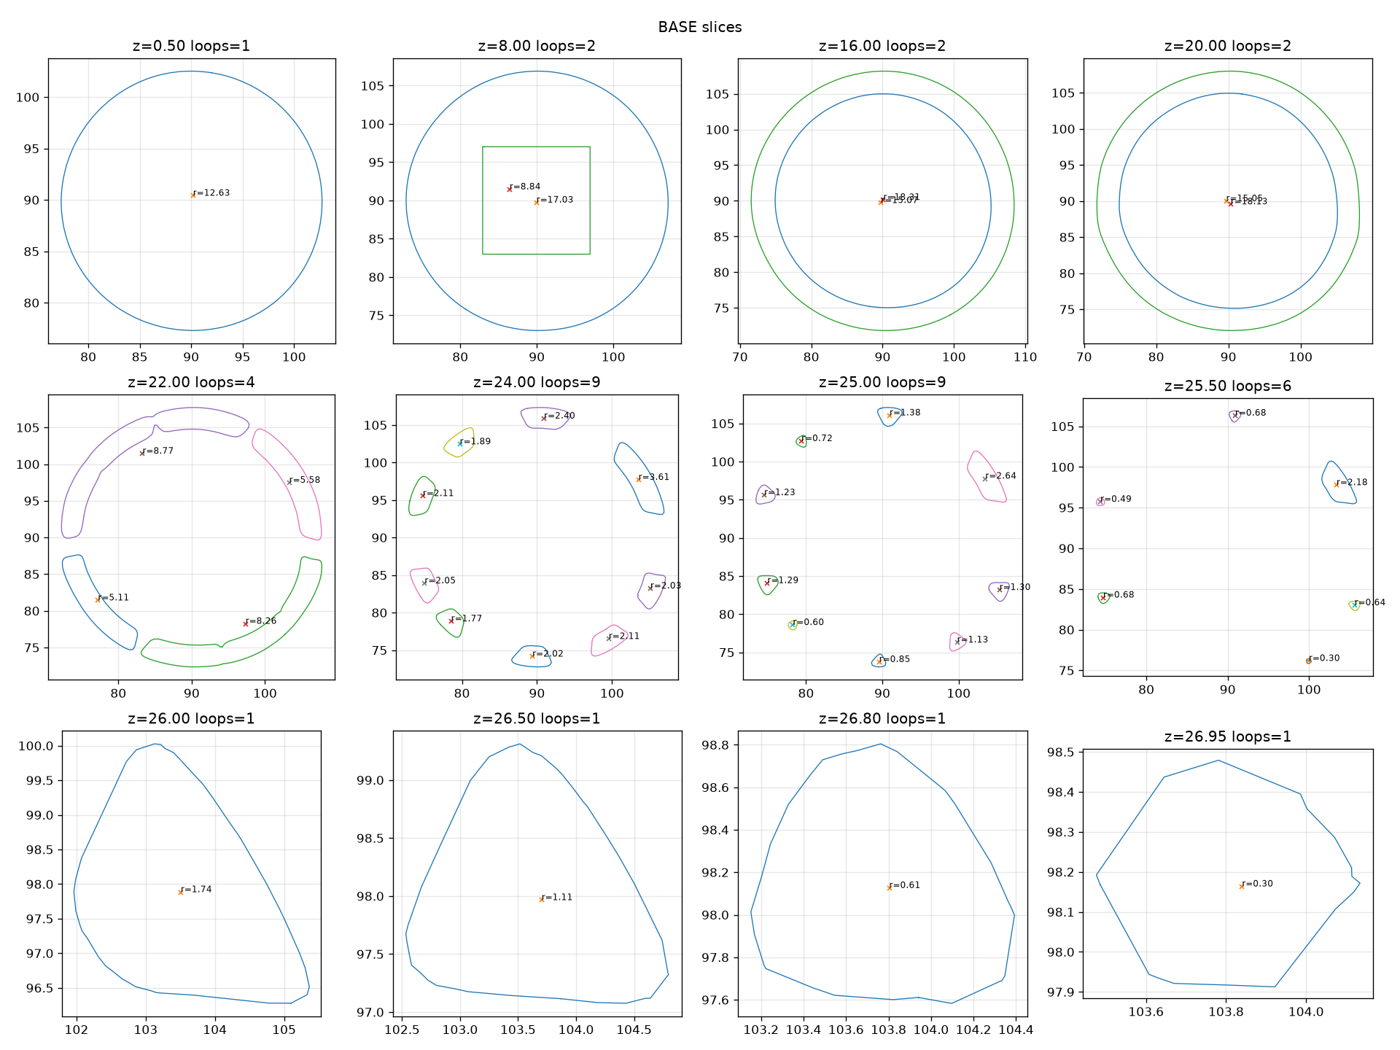
3d_model/out/slice_base.png
