nguyenduchan/coutingmachine/3d_model/out/slice_conejo.png

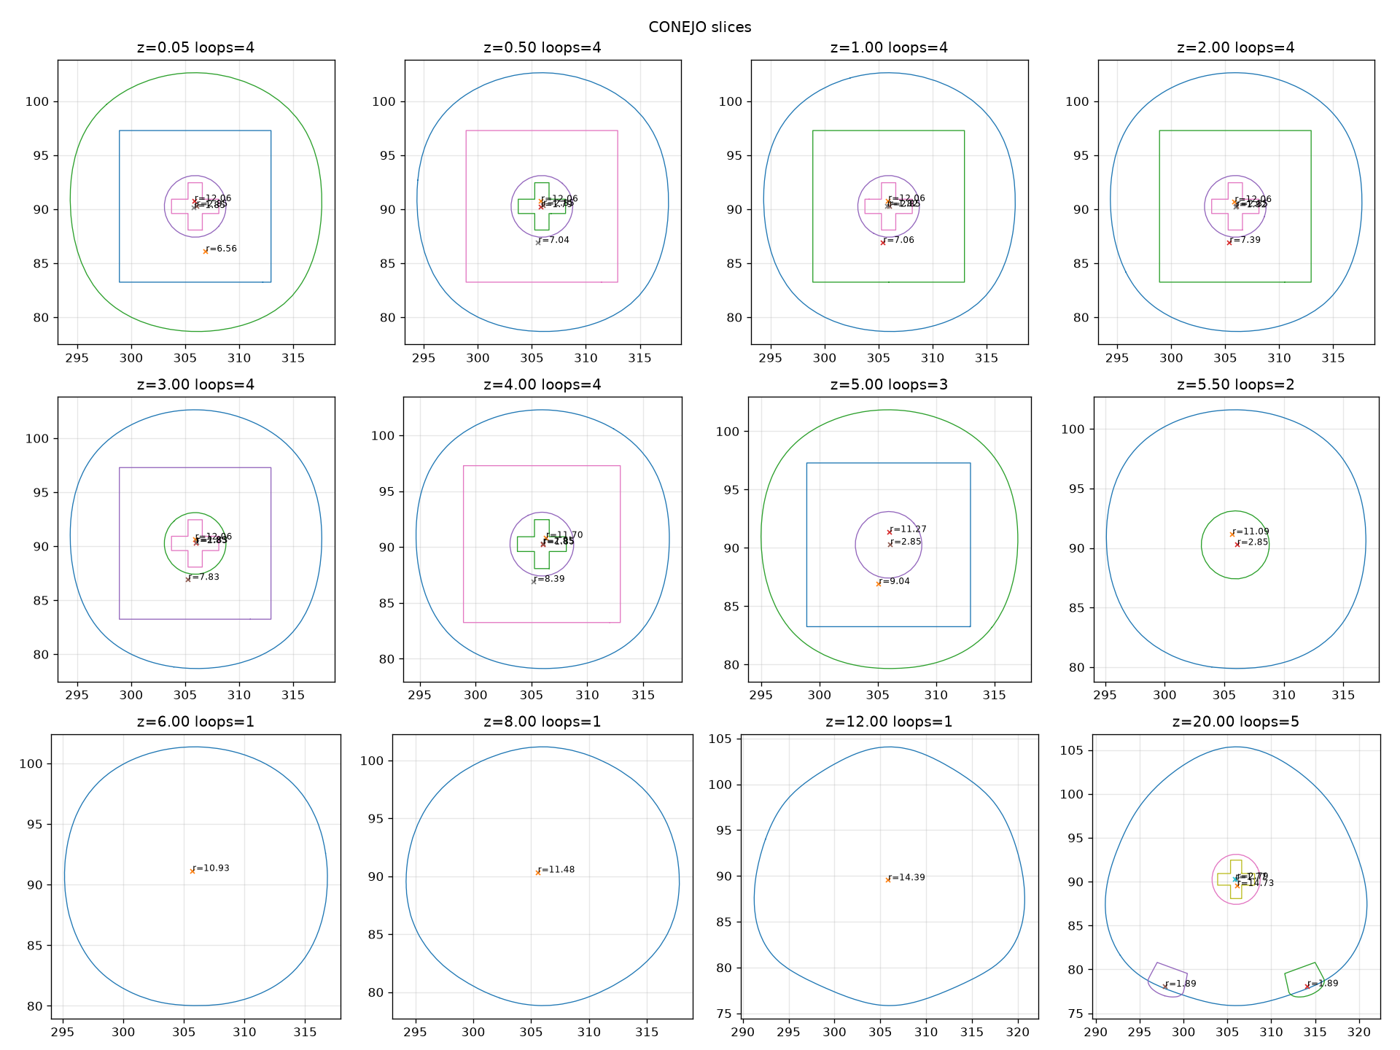
3d_model/out/slice_conejo.png
