nguyenduchan/coutingmachine/3d_model/out/view_base.png

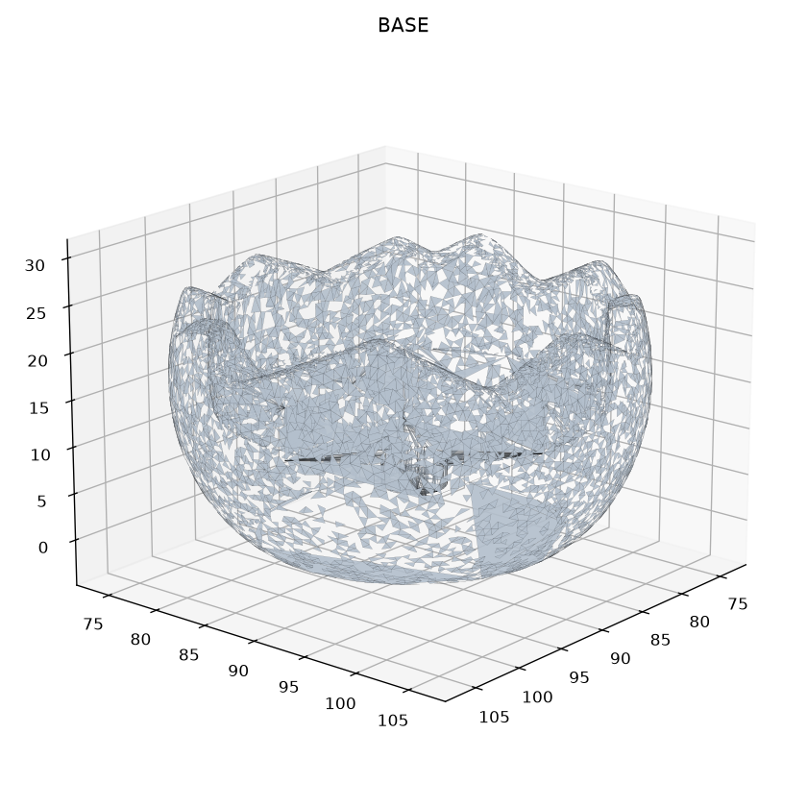
3d_model/out/view_base.png
