nguyenduchan/coutingmachine/3d_model/out/view_base_top.png

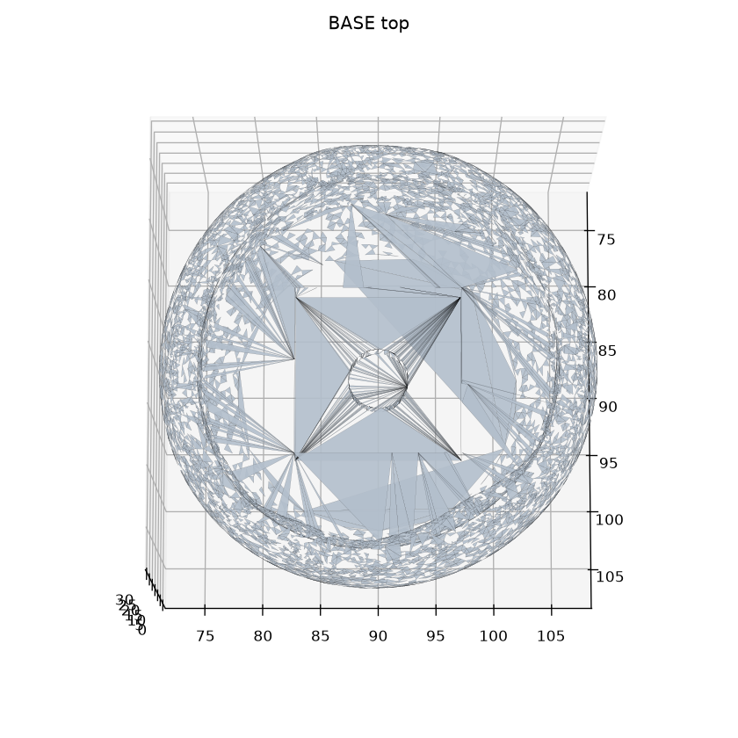
3d_model/out/view_base_top.png
