nguyenduchan/coutingmachine/3d_model/out/view_conejo.png

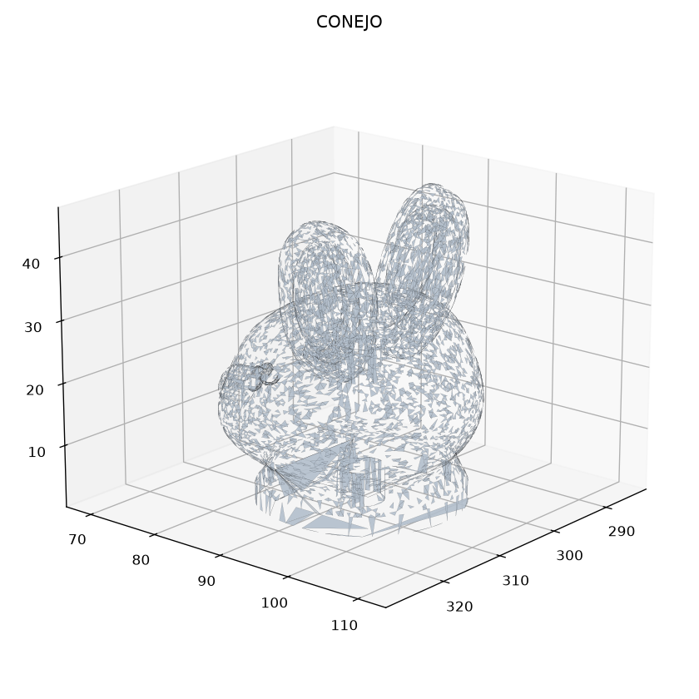
3d_model/out/view_conejo.png
