nguyenduchan/coutingmachine/3d_model/out/view_conejo_bot.png

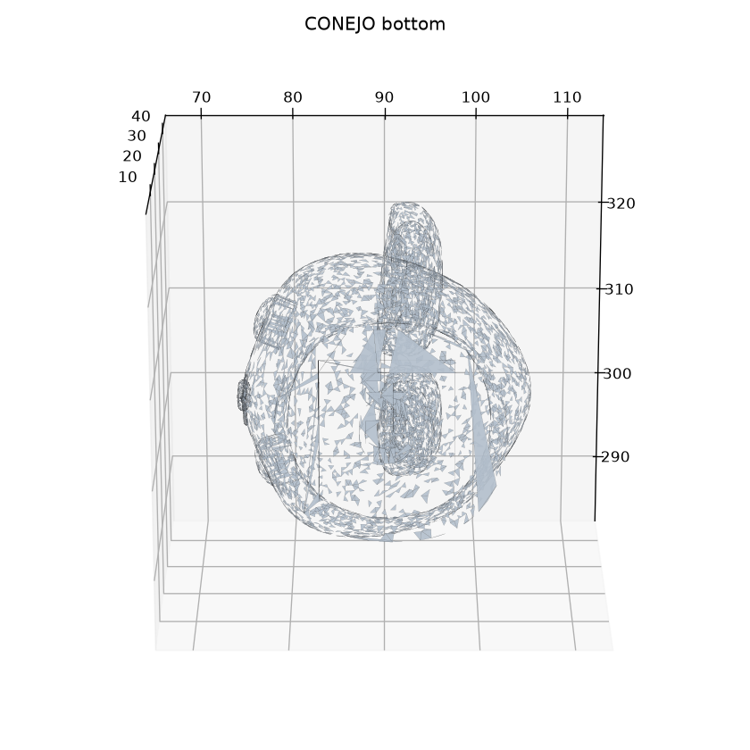
3d_model/out/view_conejo_bot.png
