nguyenduchan/coutingmachine/3d_model/out/zoom_plus.png

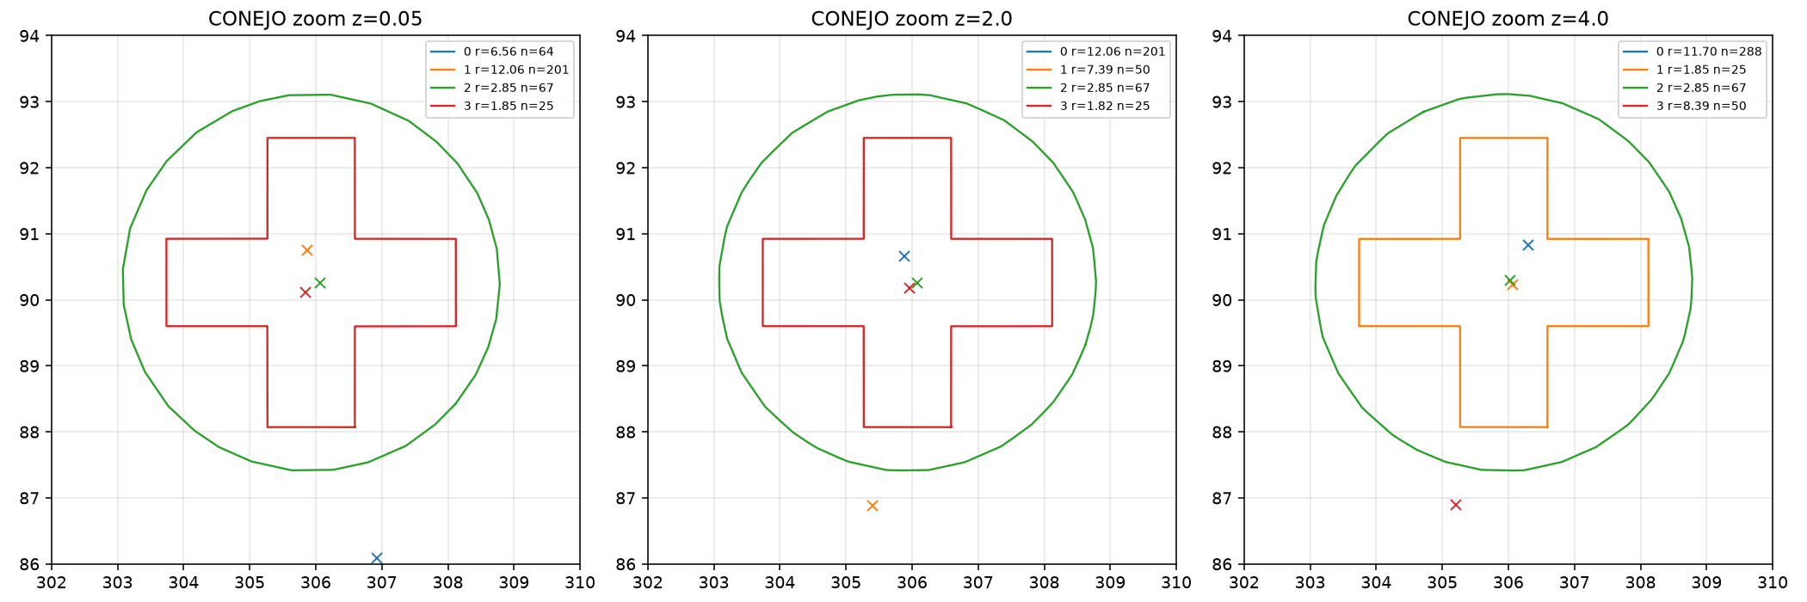
3d_model/out/zoom_plus.png
