nguyenduchan/coutingmachine/3d_model/sim/meshes/tube_l_exit/_disc_texture.png

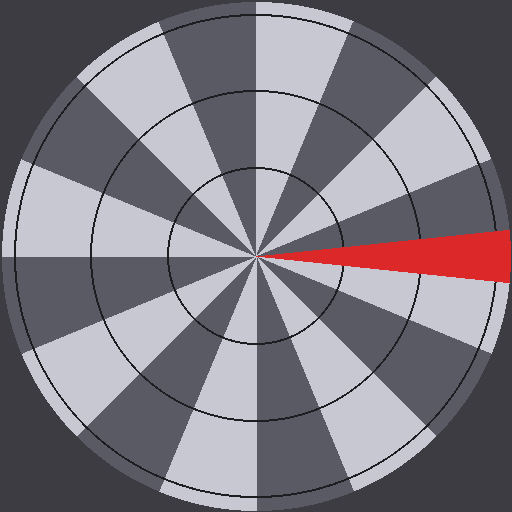
3d_model/sim/meshes/tube_l_exit/_disc_texture.png
