nguyenduchan/coutingmachine/3d_model/step_cq/step_feeder/assembly_reference.step

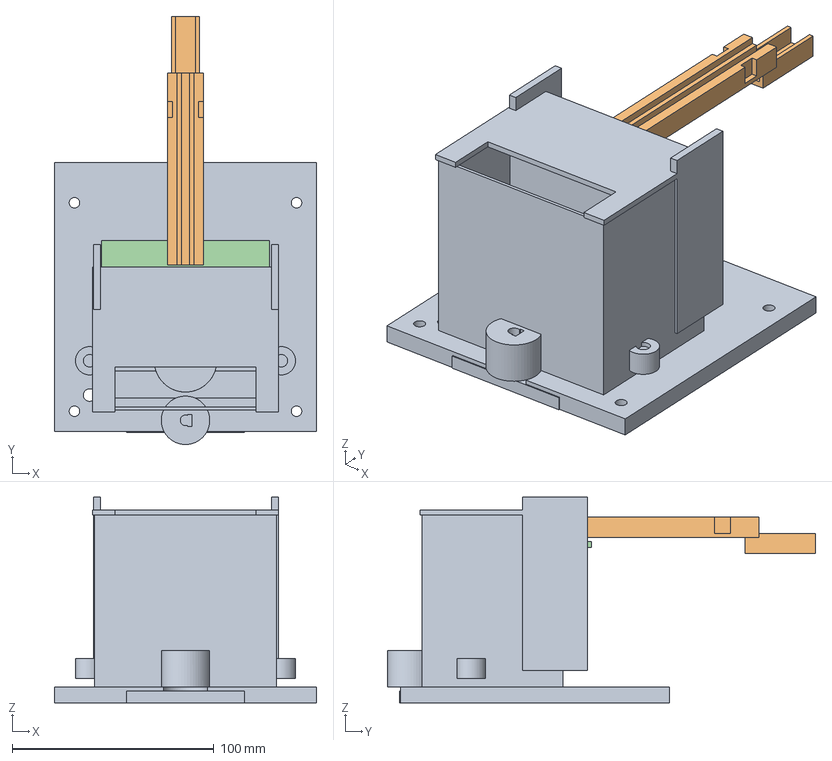
[picture p23: CAD file, 2026-07-30]
3d_model/step_cq/step_feeder/assembly_reference.step
130.0 x 212.0 x 102.0 mm
