nguyenduchan/coutingmachine/3d_model/stl_cq/assembly_spiral_exploded.stl

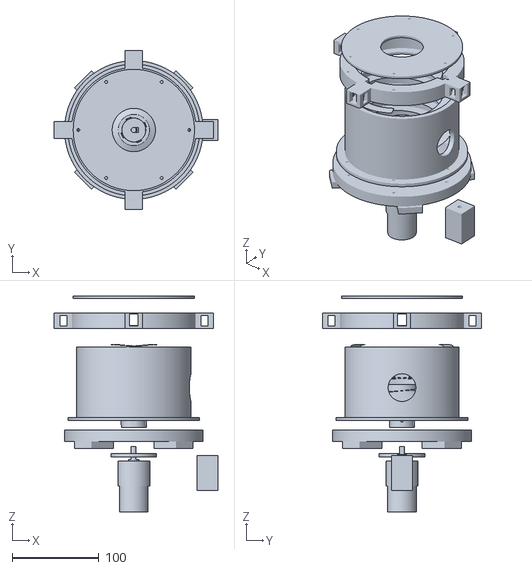
[picture p24: CAD file, 2026-07-28]
3d_model/stl_cq/assembly_spiral_exploded.stl
189.0 x 184.0 x 249.4
