nguyenduchan/coutingmachine/3d_model/stl_cq/step_feeder/assembly_exploded.stl

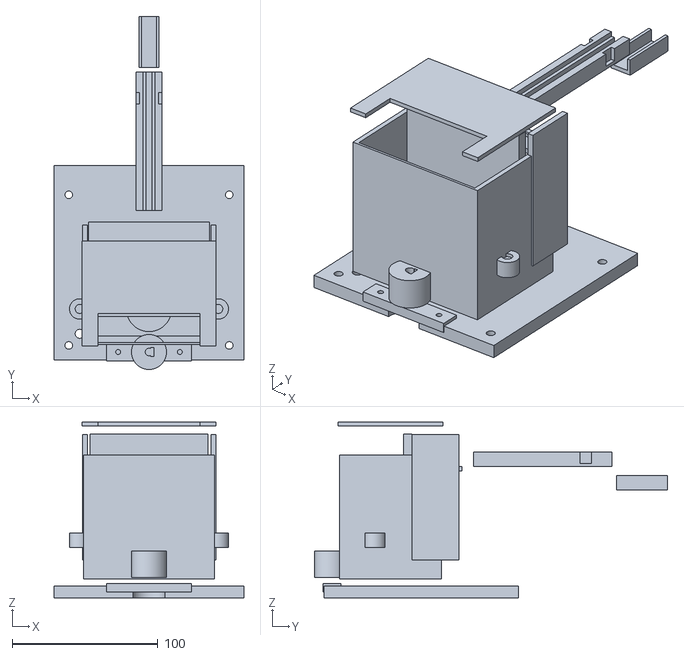
[picture p25: CAD file, 2026-07-30]
3d_model/stl_cq/step_feeder/assembly_exploded.stl
130.0 x 242.0 x 120.5
