nguyenduchan/coutingmachine/3d_model/out/Classic_Style_assembled.stl

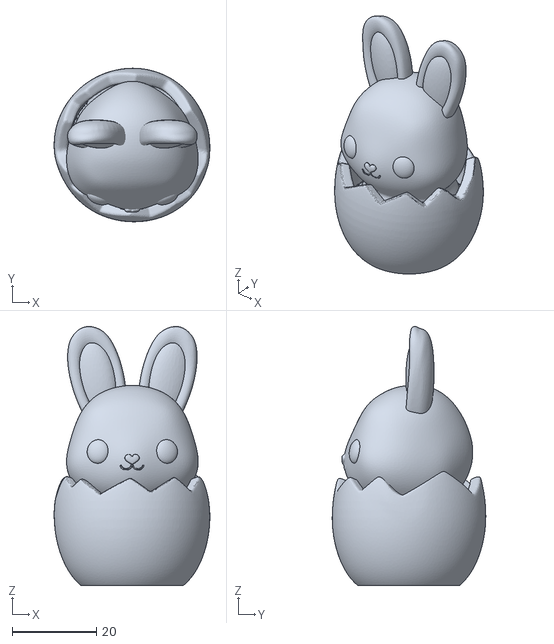
[picture p26: CAD file, 2026-09-13]
3d_model/out/Classic_Style_assembled.stl
36.9 x 36.4 x 61.3
