nguyenduchan/coutingmachine/3d_model/stl/assembly_reference.stl

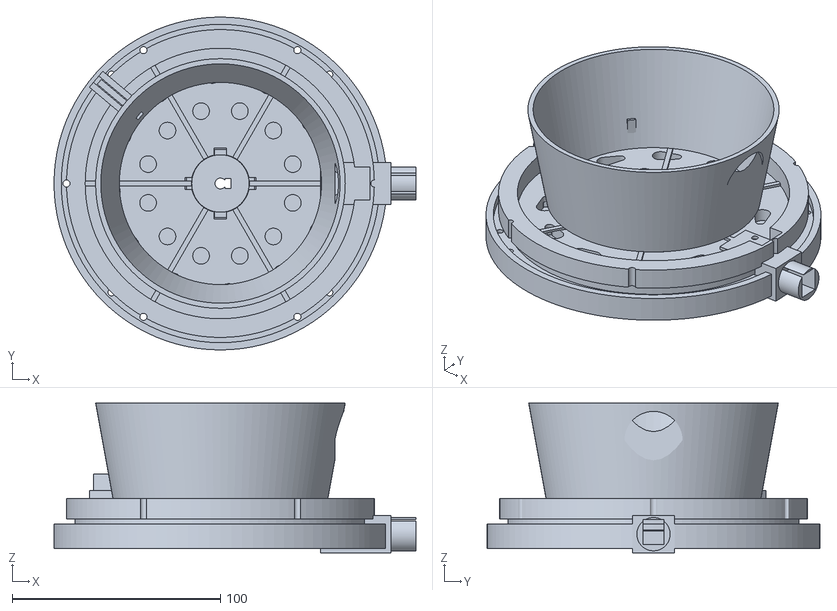
[picture p27: CAD file, 2026-07-28]
3d_model/stl/assembly_reference.stl
174.0 x 160.0 x 72.0
