nguyenduchan/coutingmachine/3d_model/stl_cq/assembly_with_motor_preview.stl

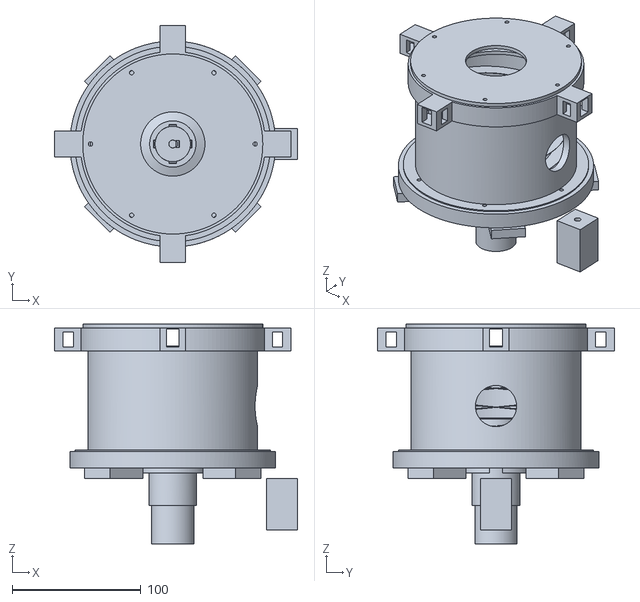
[picture p28: CAD file, 2026-07-28]
3d_model/stl_cq/assembly_with_motor_preview.stl
189.0 x 184.0 x 171.0
