nguyenduchan/coutingmachine/3d_model/step_cq/assembly_spiral_reference.step

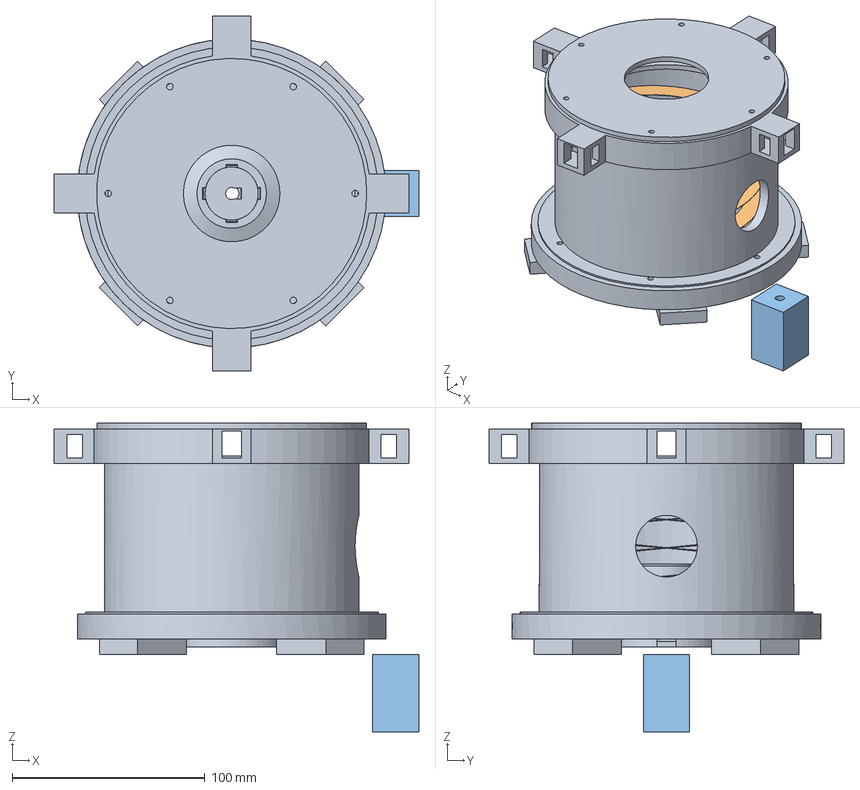
[picture p29: CAD file, 2026-07-28]
3d_model/step_cq/assembly_spiral_reference.step
189.0 x 184.0 x 160.0 mm
