nguyenduchan/coutingmachine/3d_model/step_cq/assembly_reference.step

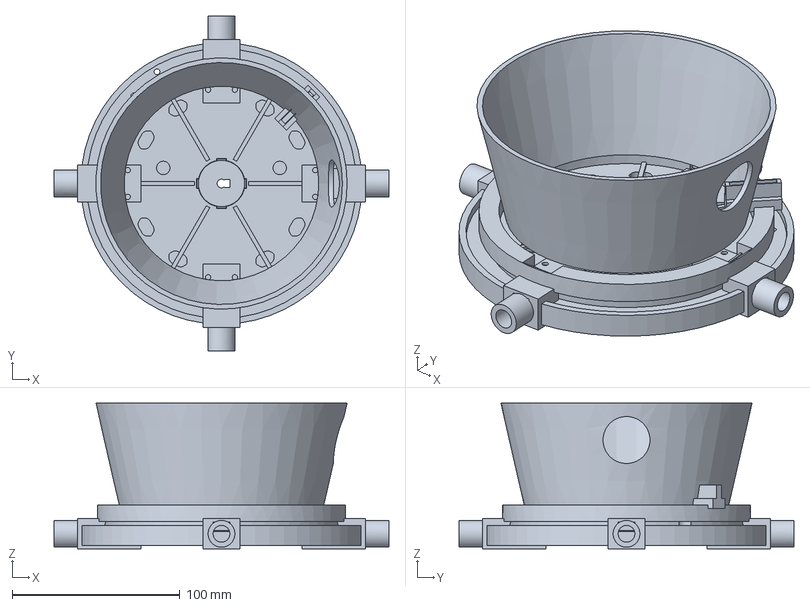
[picture p30: CAD file, 2026-07-28]
3d_model/step_cq/assembly_reference.step
200.0 x 200.0 x 87.0 mm
