nguyenduchan/coutingmachine/3d_model/step_cq/assembly_exploded.step

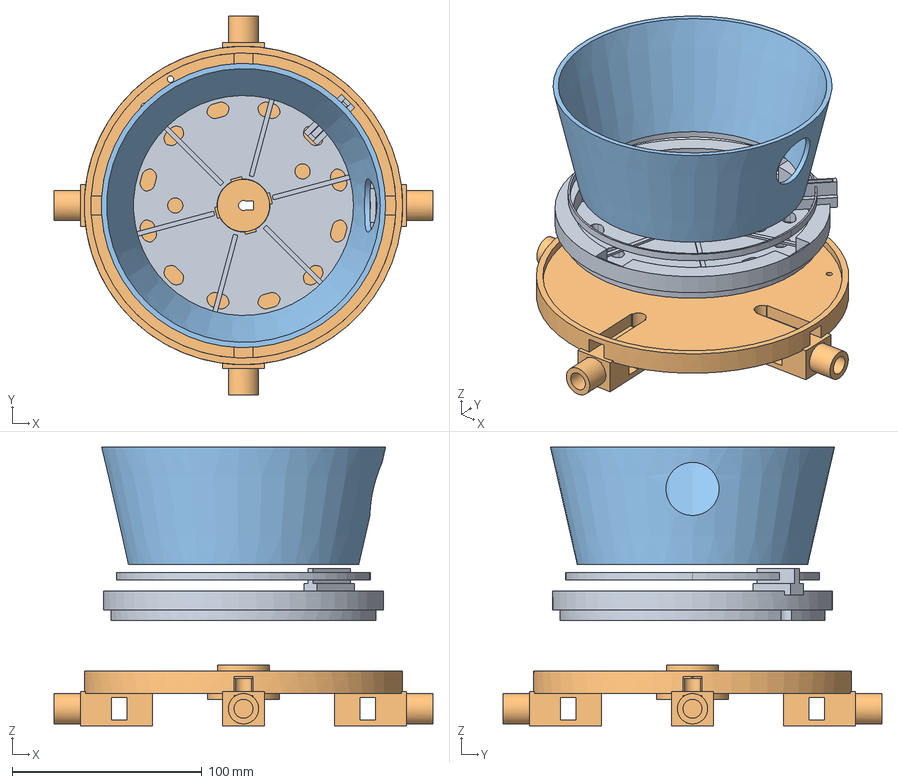
[picture p31: CAD file, 2026-07-28]
3d_model/step_cq/assembly_exploded.step
200.0 x 200.0 x 147.0 mm
