nguyenduchan/coutingmachine/3d_model/freecad/out/28byj48_reference_split.FCStd

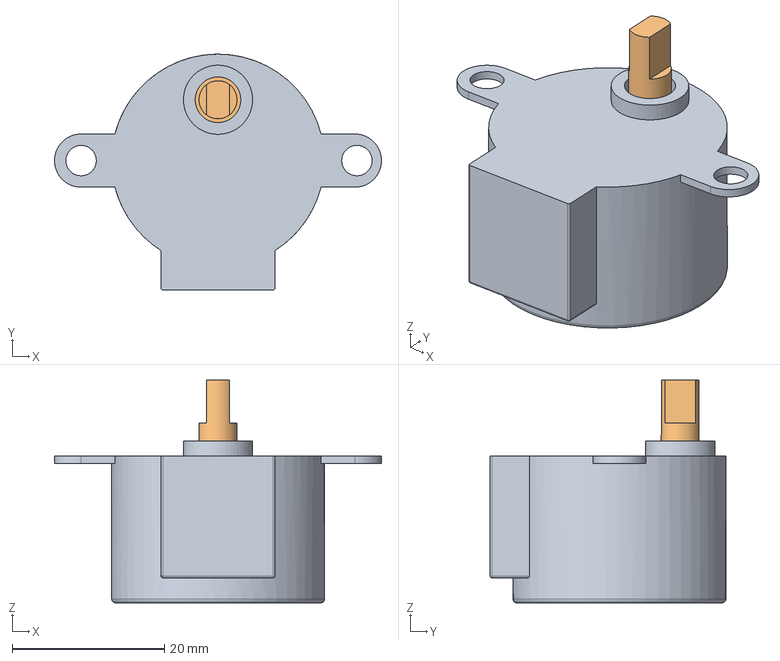
[picture p32: CAD file, 2026-09-07]
3d_model/freecad/out/28byj48_reference_split.FCStd
43.0 x 31.0 x 29.3 mm
BYJ_Motor_Ref
BYJ_Motor_Shaft_Ref
