nguyenduchan/coutingmachine/3d_model/freecad/out/byj_motor_print_in_place/BYJ_Motor_PrintInPlace.stl

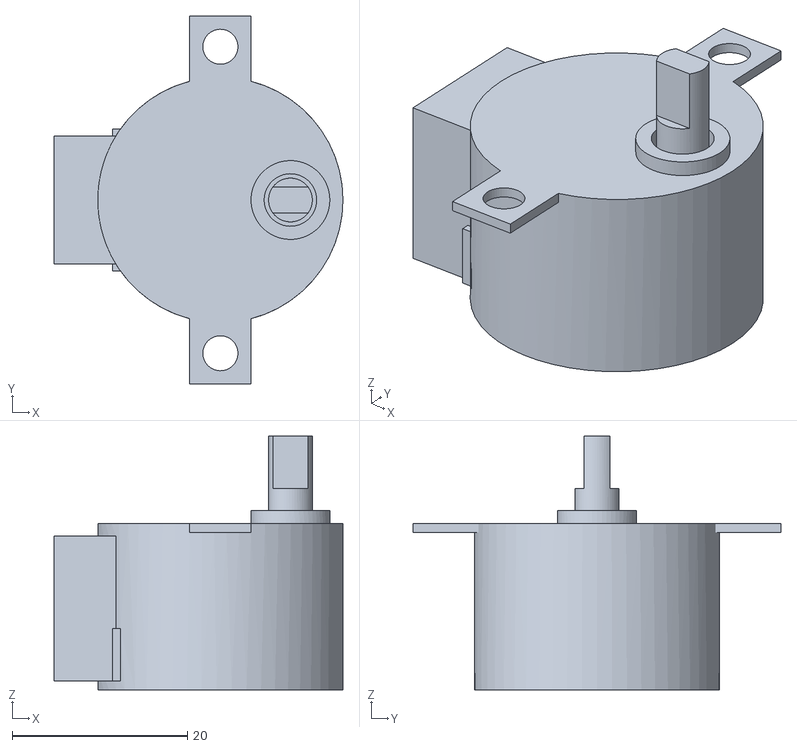
[picture p33: CAD file, 2026-09-07]
3d_model/freecad/out/byj_motor_print_in_place/BYJ_Motor_PrintInPlace.stl
33.0 x 42.0 x 29.0
