nguyenduchan/coutingmachine/3d_model/freecad/out/byj_rack_print/Guide_Rod_Cap_A.stl

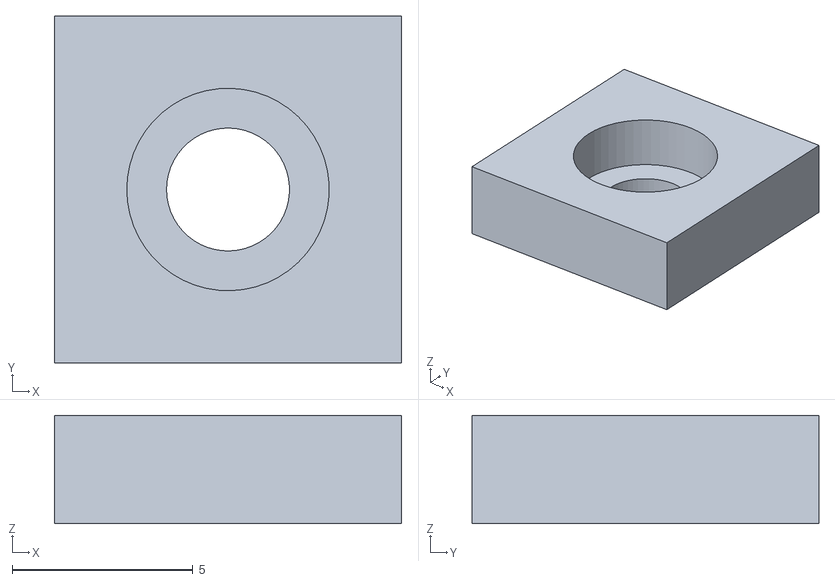
[picture p34: CAD file, 2026-09-07]
3d_model/freecad/out/byj_rack_print/Guide_Rod_Cap_A.stl
9.60 x 9.60 x 3.00
