nguyenduchan/coutingmachine/3d_model/freecad/out/tube_l_exit_gate_parts/Exit_Dial.FCStd

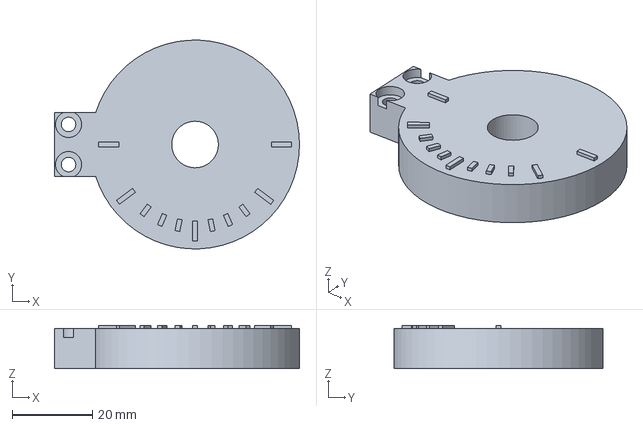
[picture p35: CAD file, 2026-08-18]
3d_model/freecad/out/tube_l_exit_gate_parts/Exit_Dial.FCStd
61.0 x 51.9 x 10.8 mm
