nguyenduchan/coutingmachine/3d_model/freecad/reference/28BYJ-48_original.FCStd

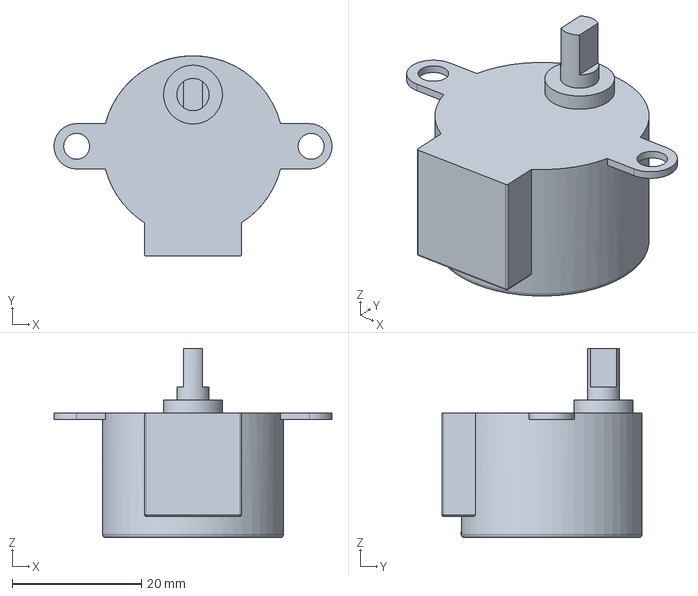
[picture p36: CAD file, 2026-09-07]
3d_model/freecad/reference/28BYJ-48_original.FCStd
43.0 x 31.0 x 29.3 mm
