nguyenduchan/coutingmachine/3d_model/out/Classic_Style_khop_noi.stl

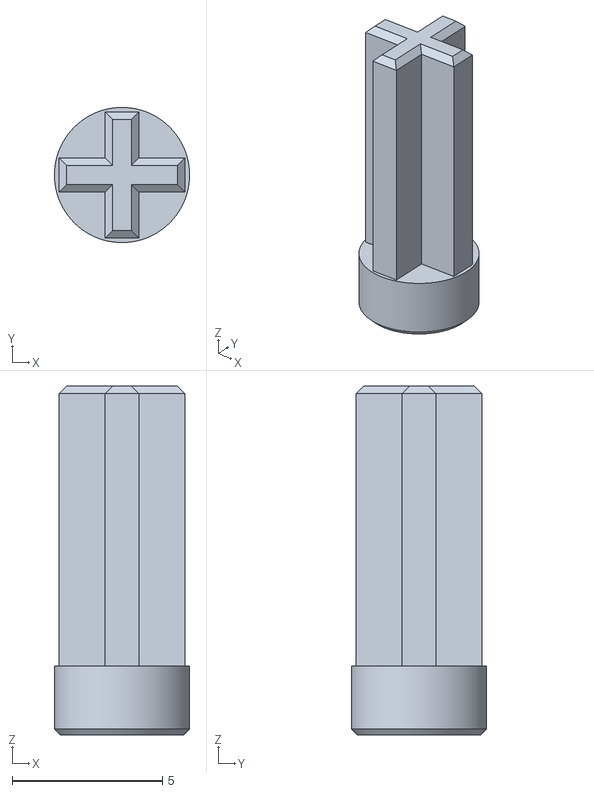
[picture p37: CAD file, 2026-09-13]
3d_model/out/Classic_Style_khop_noi.stl
4.49 x 4.49 x 11.6
