nguyenduchan/coutingmachine/3d_model/sim/meshes/rotary_linear/RL_Bearing_Rail_N.stl

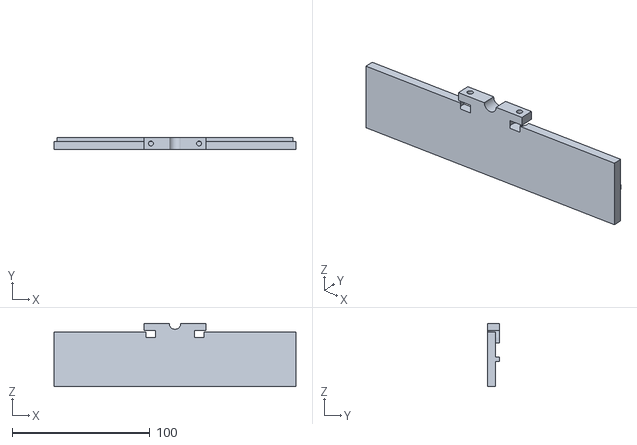
[picture p38: CAD file, 2026-08-03]
3d_model/sim/meshes/rotary_linear/RL_Bearing_Rail_N.stl
175.9 x 8.50 x 45.9
