nguyenduchan/coutingmachine/3d_model/step_cq/cover.step

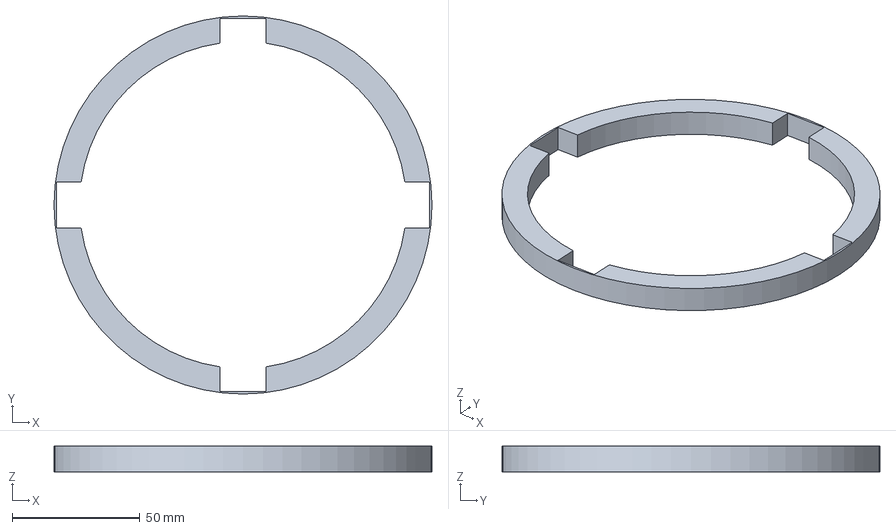
[picture p39: CAD file, 2026-07-28]
3d_model/step_cq/cover.step
148.0 x 148.0 x 10.0 mm
