nguyenduchan/coutingmachine/3d_model/step_cq/fixed/base.step

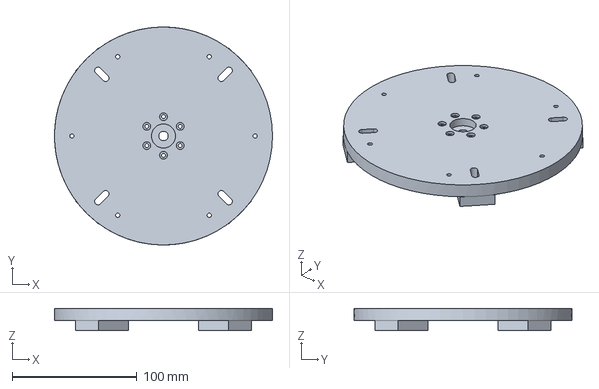
[picture p40: CAD file, 2026-07-28]
3d_model/step_cq/fixed/base.step
175.0 x 175.0 x 18.0 mm
