nguyenduchan/coutingmachine/3d_model/step_cq/moving/rotor_spiral.step

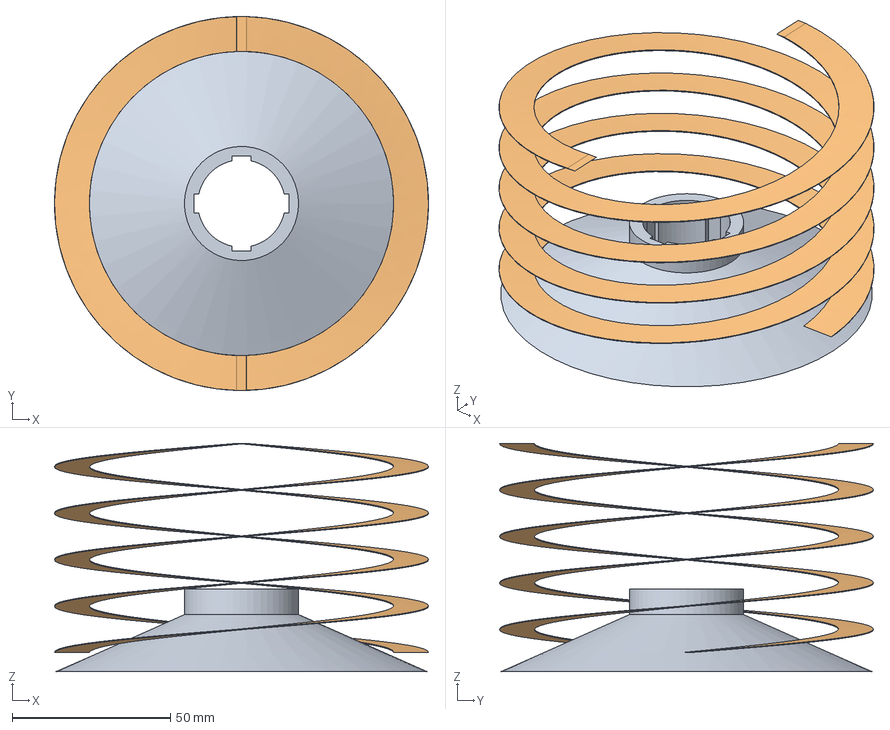
[picture p41: CAD file, 2026-07-28]
3d_model/step_cq/moving/rotor_spiral.step
118.0 x 118.0 x 72.0 mm
