nguyenduchan/coutingmachine/3d_model/step_cq/reference/geared_motor_GB37_24V.step

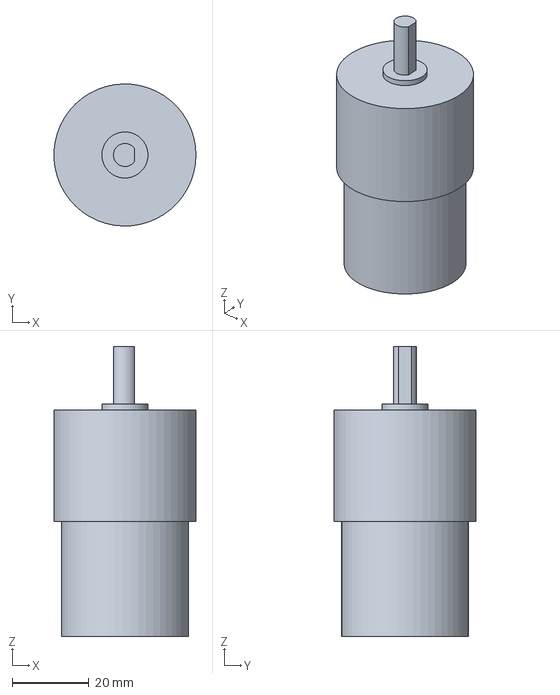
[picture p42: CAD file, 2026-07-28]
3d_model/step_cq/reference/geared_motor_GB37_24V.step
37.0 x 37.0 x 75.5 mm
