nguyenduchan/coutingmachine/3d_model/step_cq/step_alt/fixed/funnel_V.step

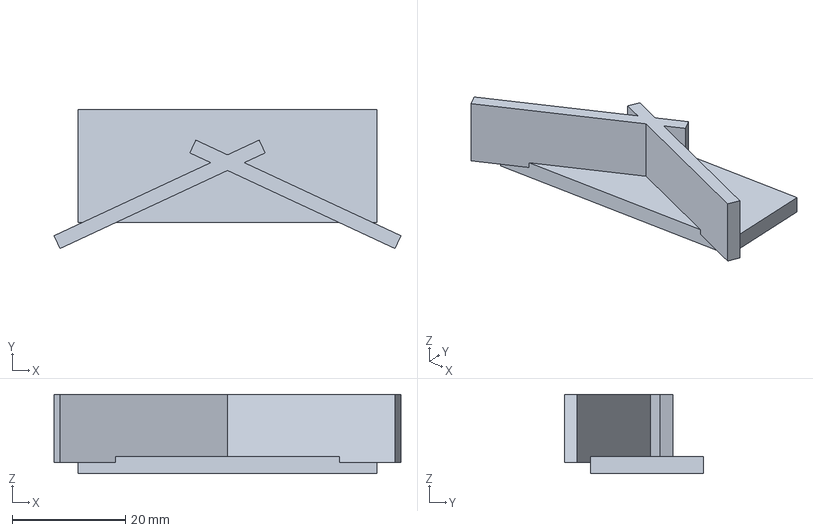
[picture p43: CAD file, 2026-07-30]
3d_model/step_cq/step_alt/fixed/funnel_V.step
61.3 x 24.6 x 14.0 mm
