nguyenduchan/coutingmachine/3d_model/step_cq/step_alt/moving/yoke_group_B.step

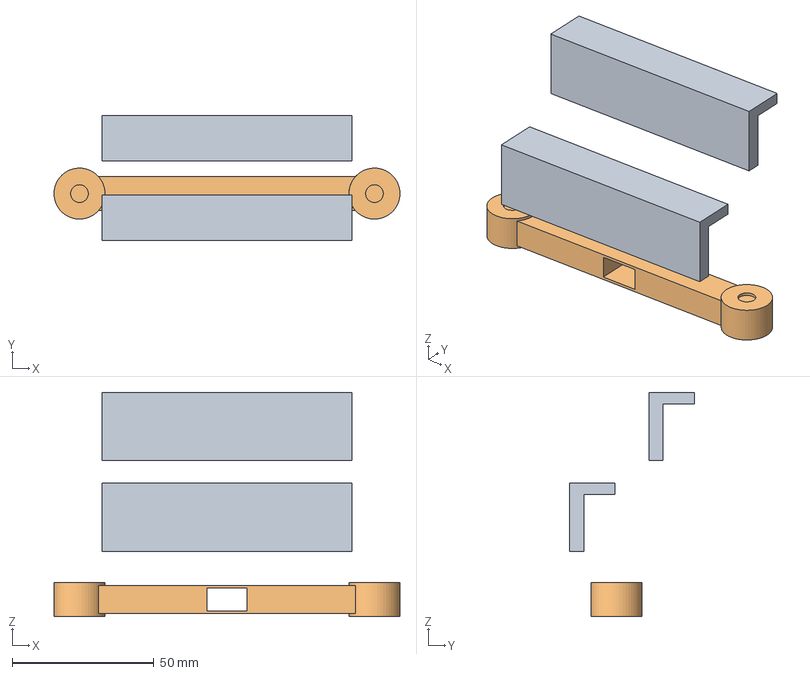
[picture p44: CAD file, 2026-07-30]
3d_model/step_cq/step_alt/moving/yoke_group_B.step
122.0 x 44.0 x 79.0 mm
