nguyenduchan/coutingmachine/3d_model/step_cq/step_feeder/fixed/fixed_steps.step

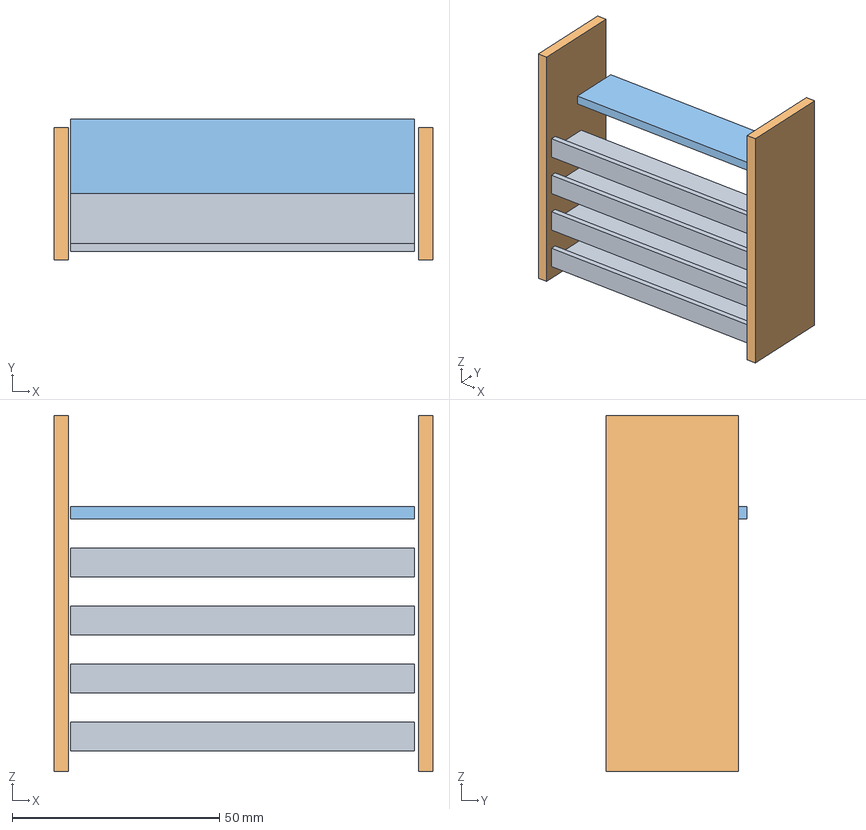
[picture p45: CAD file, 2026-07-30]
3d_model/step_cq/step_feeder/fixed/fixed_steps.step
91.5 x 34.0 x 86.0 mm
