nguyenduchan/coutingmachine/3d_model/step_cq/step_feeder/moving/drive_hub.step

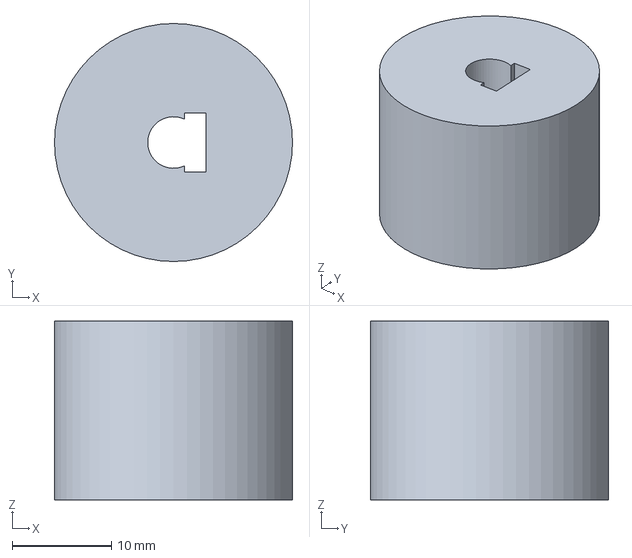
[picture p46: CAD file, 2026-07-30]
3d_model/step_cq/step_feeder/moving/drive_hub.step
24.0 x 24.0 x 18.0 mm
