nguyenduchan/coutingmachine/3d_model/stl/outlet_chute.stl

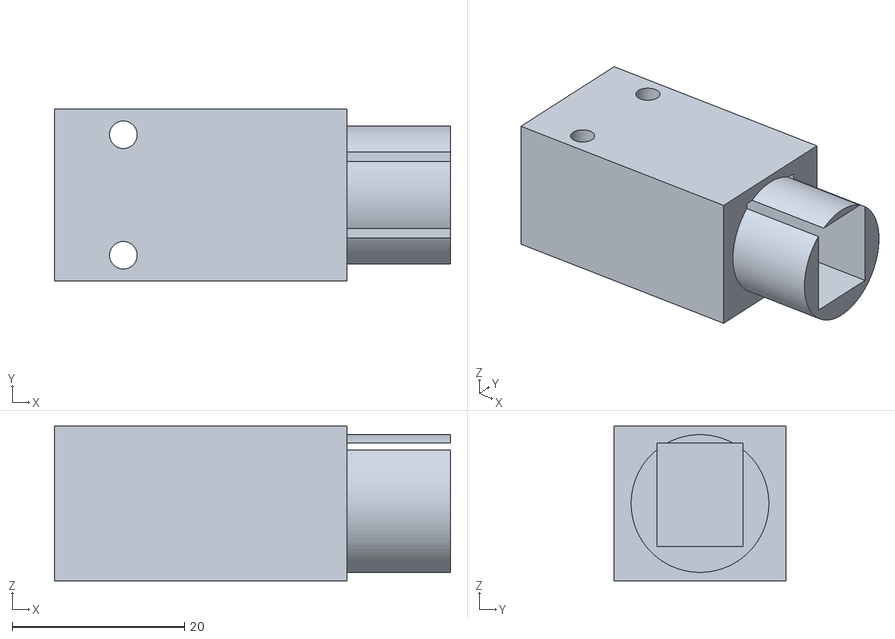
[picture p47: CAD file, 2026-07-28]
3d_model/stl/outlet_chute.stl
46.0 x 20.0 x 18.0
