nguyenduchan/coutingmachine/3d_model/freecad/out/byj_rack_print/Slide_Bar.stl

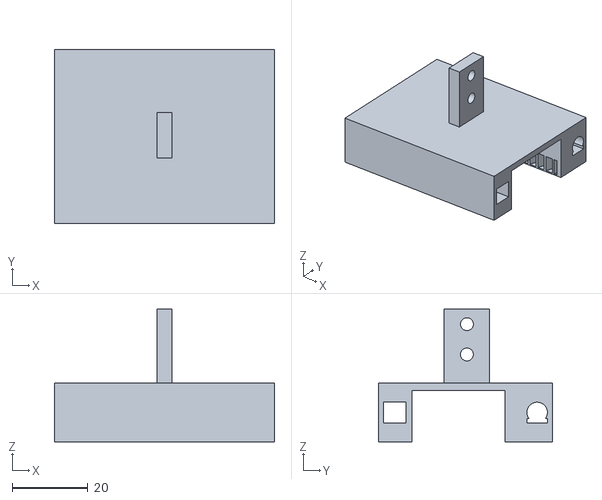
[picture p48: CAD file, 2026-09-07]
3d_model/freecad/out/byj_rack_print/Slide_Bar.stl
58.1 x 45.9 x 35.1
