nguyenduchan/coutingmachine/3d_model/freecad/out/byj_rack_stage.FCStd

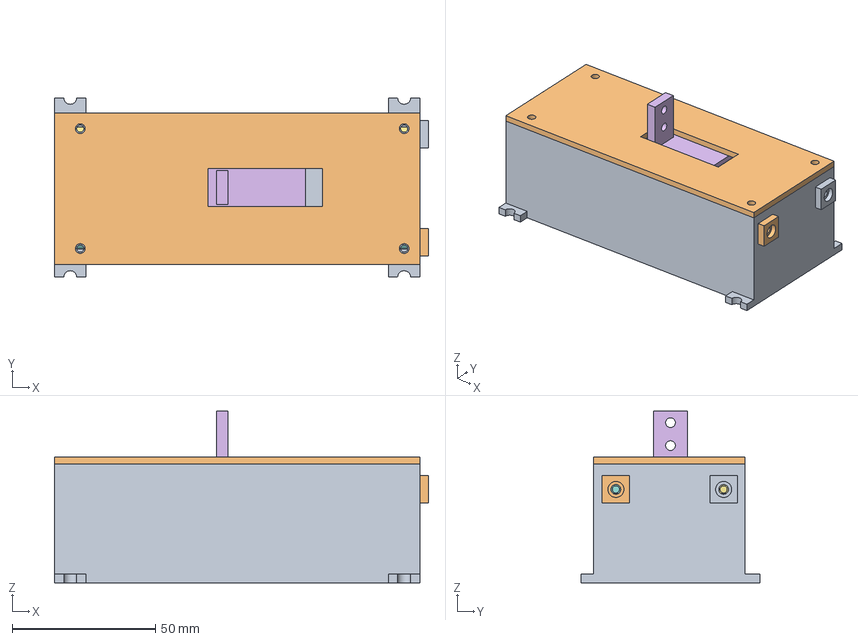
[picture p49: CAD file, 2026-09-07]
3d_model/freecad/out/byj_rack_stage.FCStd
130.6 x 62.6 x 59.9 mm
Housing
Housing_Lid
BYJ_Motor
BYJ_Motor_Shaft
Pinion
Slide_Bar
Guide_Rod_A
Guide_Rod_B
Guide_Rod_Cap_A
Guide_Rod_Cap_B
Limit_Switch_Min
