nguyenduchan/coutingmachine/3d_model/freecad/out/tube_l_exit_gate_parts/Entry_Gate_Post.FCStd

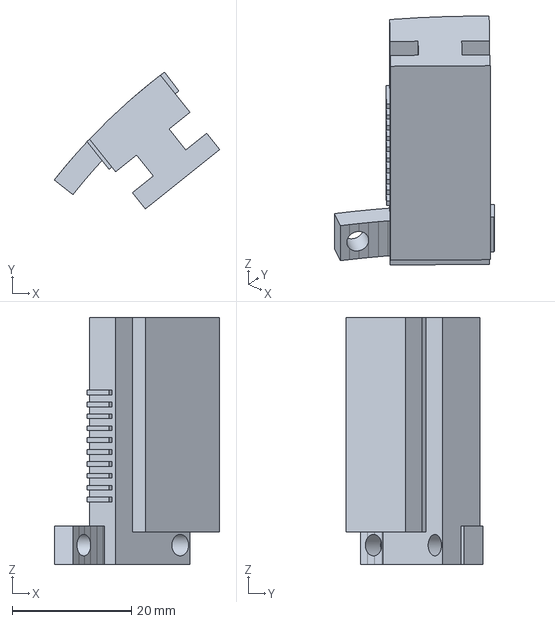
[picture p50: CAD file, 2026-08-18]
3d_model/freecad/out/tube_l_exit_gate_parts/Entry_Gate_Post.FCStd
27.8 x 23.0 x 41.5 mm
