nguyenduchan/coutingmachine/3d_model/sim/meshes/rotary_linear/RL_Knob.stl

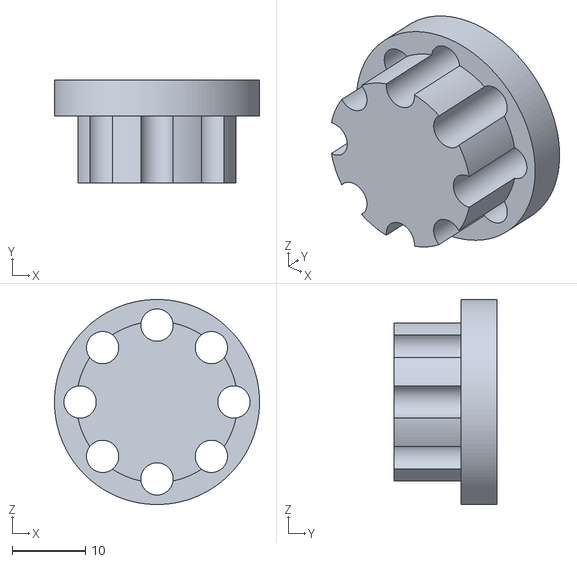
[picture p51: CAD file, 2026-08-03]
3d_model/sim/meshes/rotary_linear/RL_Knob.stl
28.0 x 14.0 x 28.0
