nguyenduchan/coutingmachine/3d_model/sim/meshes/tube_l_exit/Spring_Height_2.stl

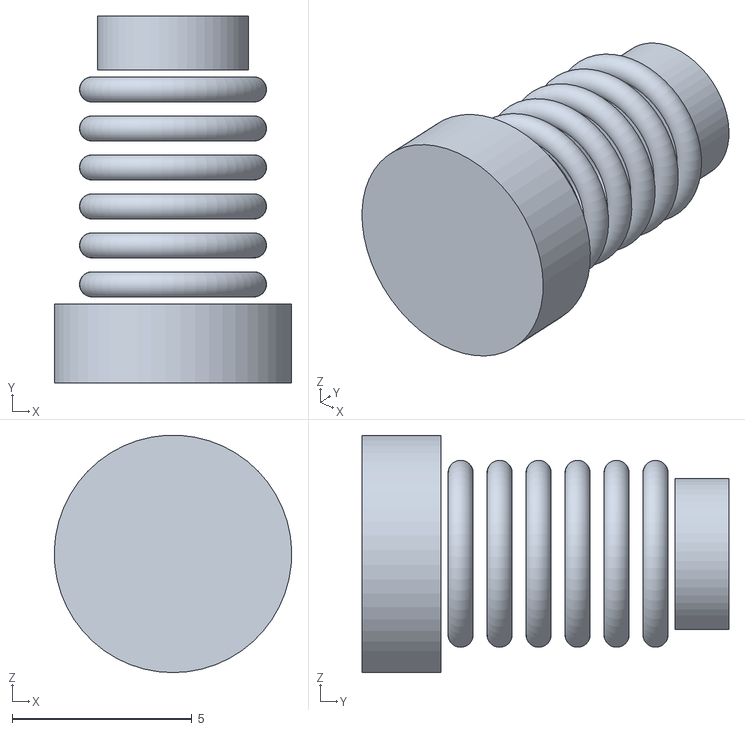
[picture p52: CAD file, 2026-08-13]
3d_model/sim/meshes/tube_l_exit/Spring_Height_2.stl
6.60 x 10.2 x 6.59
