nguyenduchan/coutingmachine/3d_model/step_cq/drive_hub.step

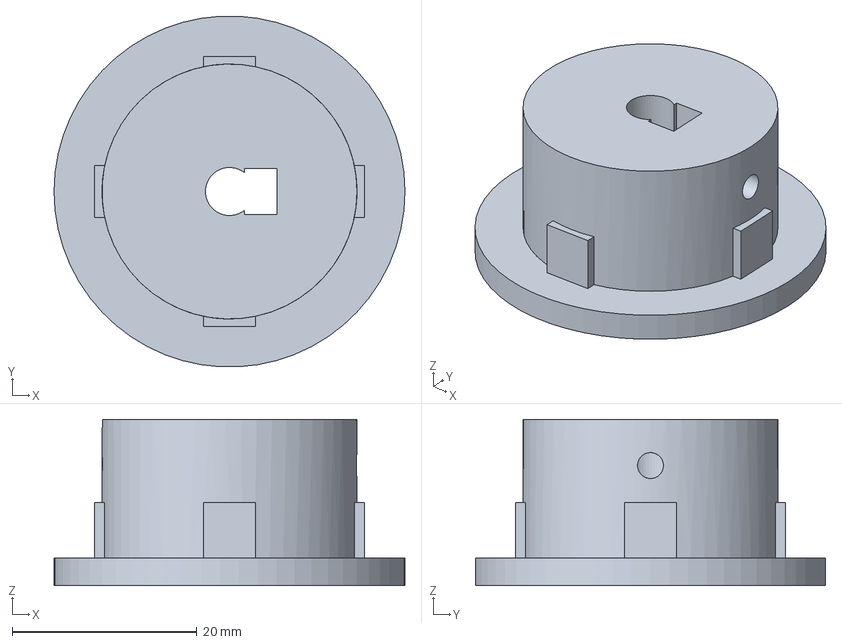
[picture p53: CAD file, 2026-07-28]
3d_model/step_cq/drive_hub.step
38.0 x 37.9 x 18.0 mm
