nguyenduchan/coutingmachine/3d_model/step_cq/fixed/motor_clamp.step

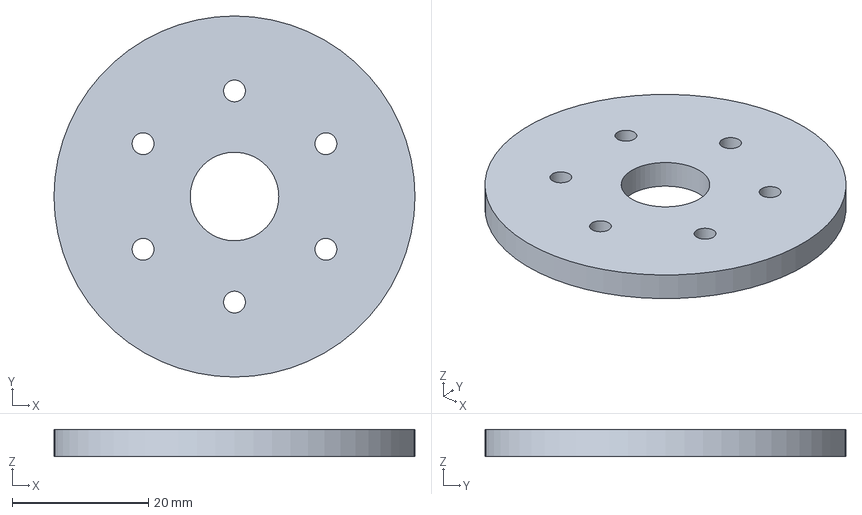
[picture p54: CAD file, 2026-07-28]
3d_model/step_cq/fixed/motor_clamp.step
53.0 x 53.0 x 4.00 mm
