nguyenduchan/coutingmachine/3d_model/step_cq/moving/shaft_collar.step

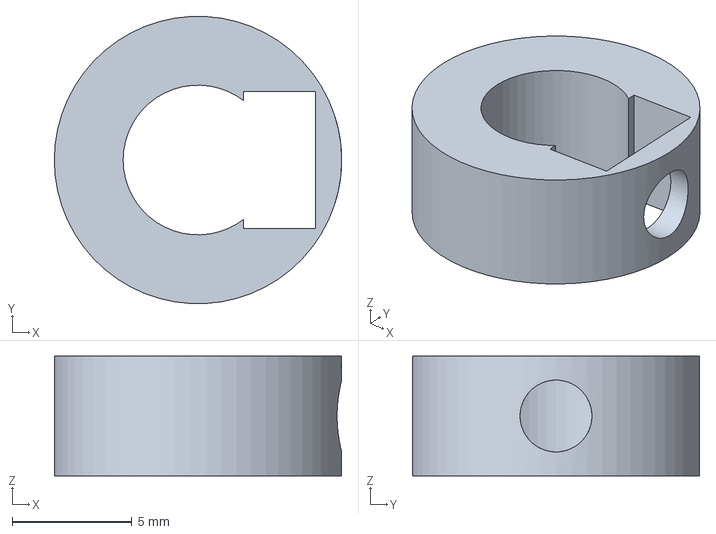
[picture p55: CAD file, 2026-07-28]
3d_model/step_cq/moving/shaft_collar.step
12.0 x 12.0 x 5.00 mm
