nguyenduchan/coutingmachine/3d_model/step_cq/step_alt/fixed/rail.step

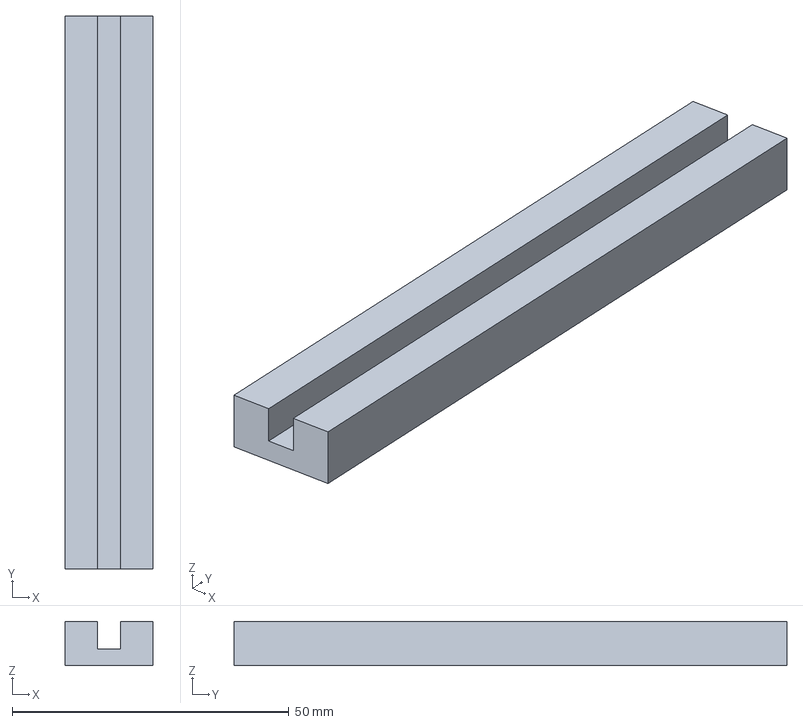
[picture p56: CAD file, 2026-07-30]
3d_model/step_cq/step_alt/fixed/rail.step
16.0 x 100.0 x 8.00 mm
