nguyenduchan/coutingmachine/3d_model/step_cq/step_alt/moving/cam_A.step

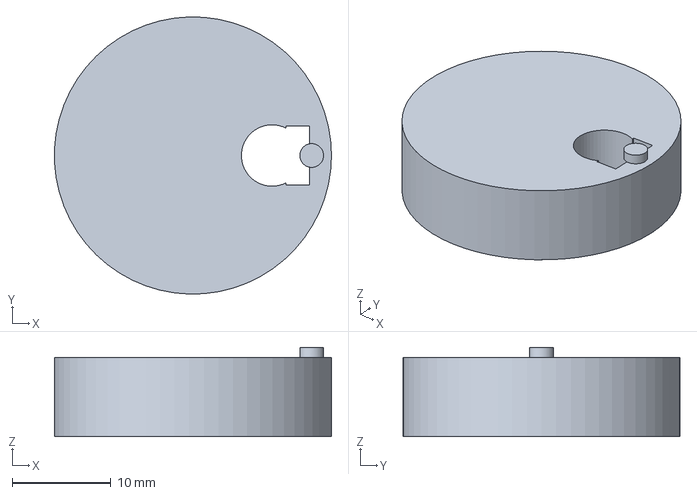
[picture p57: CAD file, 2026-07-30]
3d_model/step_cq/step_alt/moving/cam_A.step
28.0 x 28.0 x 9.00 mm
