nguyenduchan/coutingmachine/3d_model/step_cq/step_feeder/fixed/motor_clamp.step

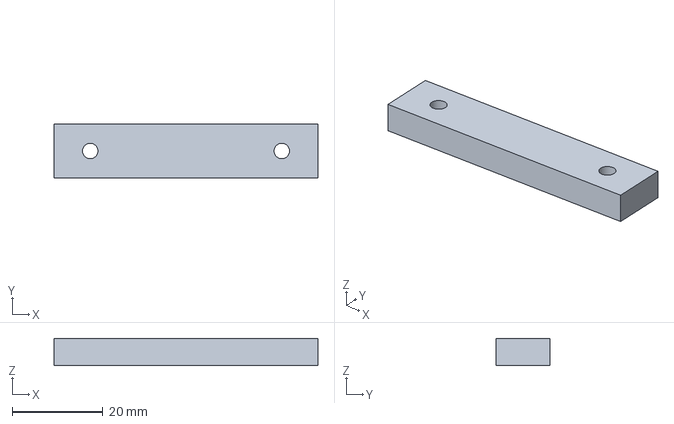
[picture p58: CAD file, 2026-07-30]
3d_model/step_cq/step_feeder/fixed/motor_clamp.step
58.3 x 12.0 x 6.00 mm
