nguyenduchan/coutingmachine/3d_model/step_cq/step_feeder/moving/move_plates.step

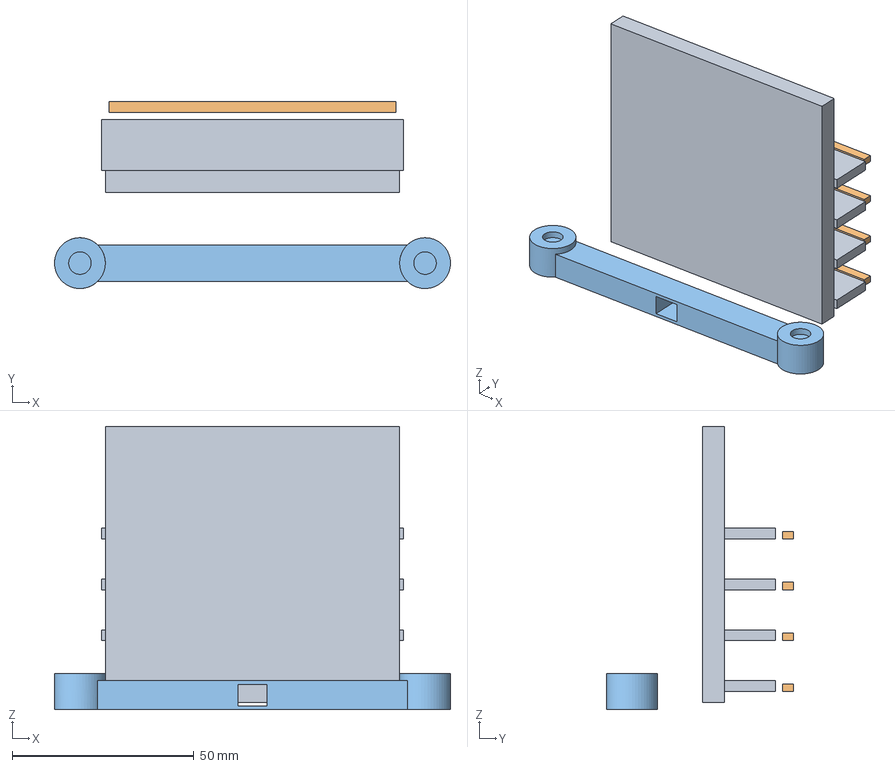
[picture p59: CAD file, 2026-07-30]
3d_model/step_cq/step_feeder/moving/move_plates.step
109.0 x 51.5 x 78.0 mm
