nguyenduchan/coutingmachine/3d_model/freecad/out/byj_rack_print/Guide_Rod_B.stl

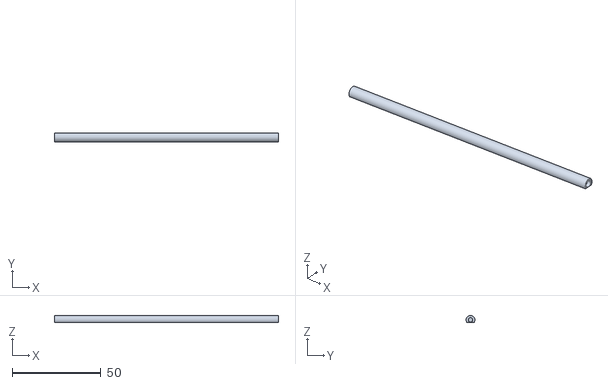
[picture p60: CAD file, 2026-09-07]
3d_model/freecad/out/byj_rack_print/Guide_Rod_B.stl
126.0 x 5.00 x 4.00
