nguyenduchan/coutingmachine/3d_model/freecad/out/tube_l_exit_gate_parts/Exit_Knob.FCStd

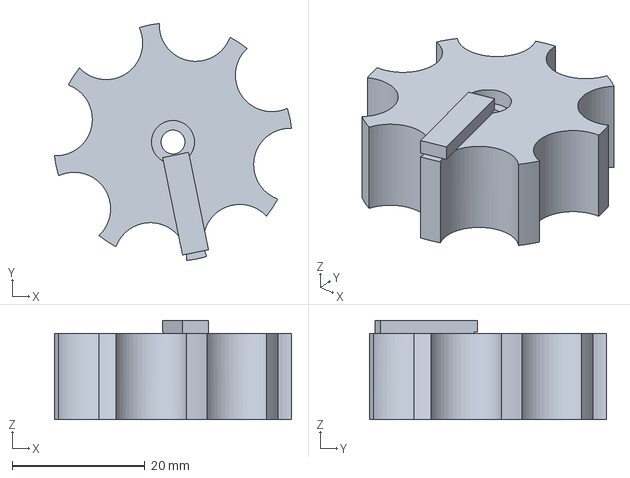
[picture p61: CAD file, 2026-08-18]
3d_model/freecad/out/tube_l_exit_gate_parts/Exit_Knob.FCStd
35.8 x 35.8 x 15.0 mm
