nguyenduchan/coutingmachine/3d_model/sim/meshes/rotary_linear/RL_Bearing_Cap_S.stl

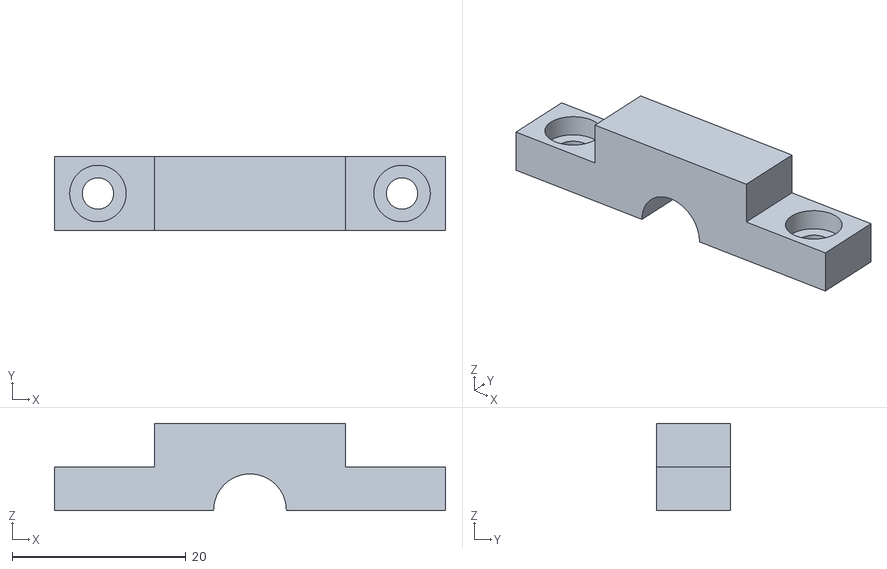
[picture p62: CAD file, 2026-08-03]
3d_model/sim/meshes/rotary_linear/RL_Bearing_Cap_S.stl
45.0 x 8.50 x 10.1
