nguyenduchan/coutingmachine/3d_model/sim/meshes/tube_l_exit/Height_Scraper.stl

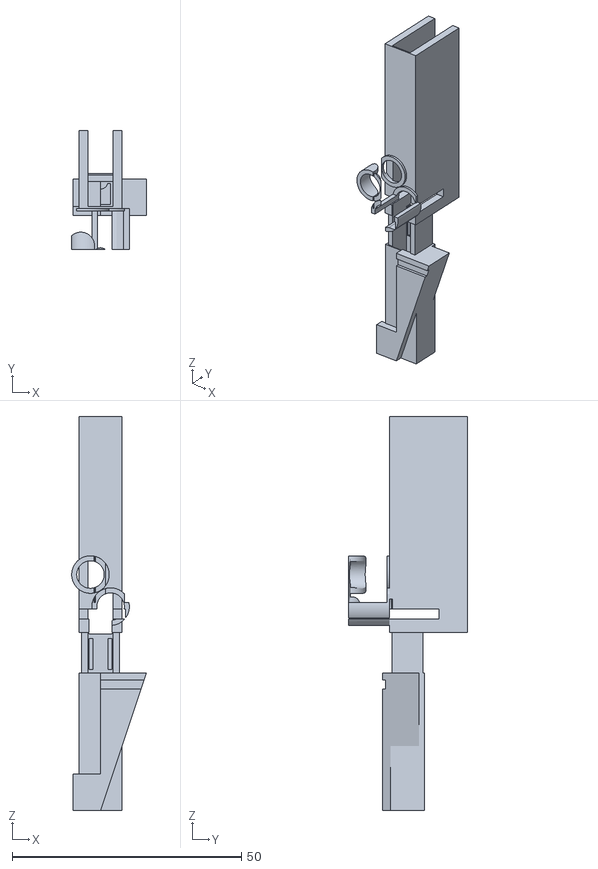
[picture p63: CAD file, 2026-08-13]
3d_model/sim/meshes/tube_l_exit/Height_Scraper.stl
16.3 x 26.0 x 86.0
