nguyenduchan/coutingmachine/3d_model/step_cq/fixed/outlet_chute.step

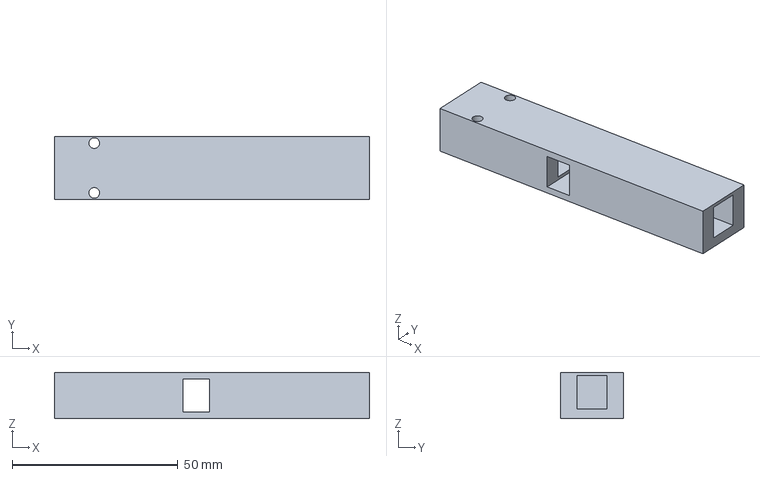
[picture p64: CAD file, 2026-07-28]
3d_model/step_cq/fixed/outlet_chute.step
95.0 x 19.0 x 14.0 mm
