nguyenduchan/coutingmachine/3d_model/step_cq/moving/rotor_grooved.step

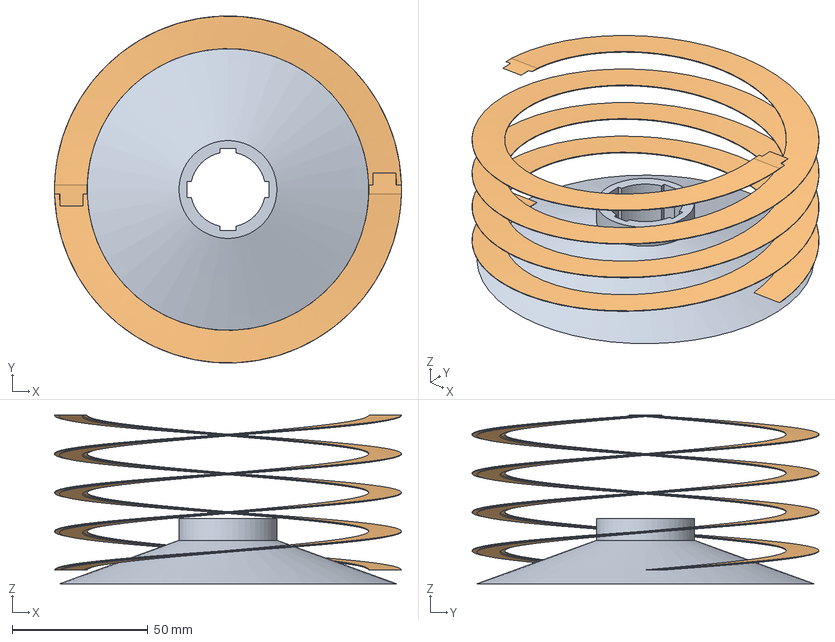
[picture p65: CAD file, 2026-07-28]
3d_model/step_cq/moving/rotor_grooved.step
127.6 x 127.6 x 62.0 mm
