nguyenduchan/coutingmachine/3d_model/step_cq/outlet_chute.step

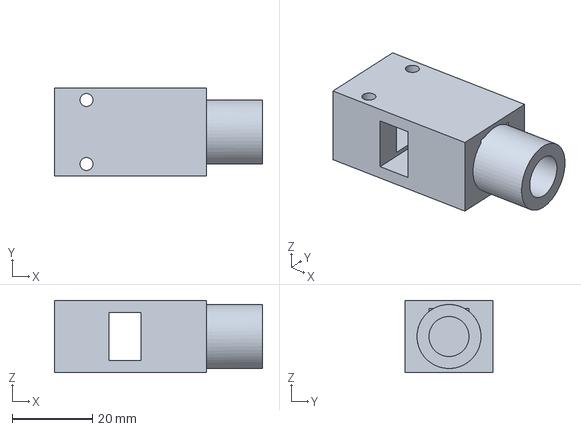
[picture p66: CAD file, 2026-07-28]
3d_model/step_cq/outlet_chute.step
52.0 x 22.0 x 18.0 mm
