nguyenduchan/coutingmachine/3d_model/step_cq/step_alt/fixed/base.step

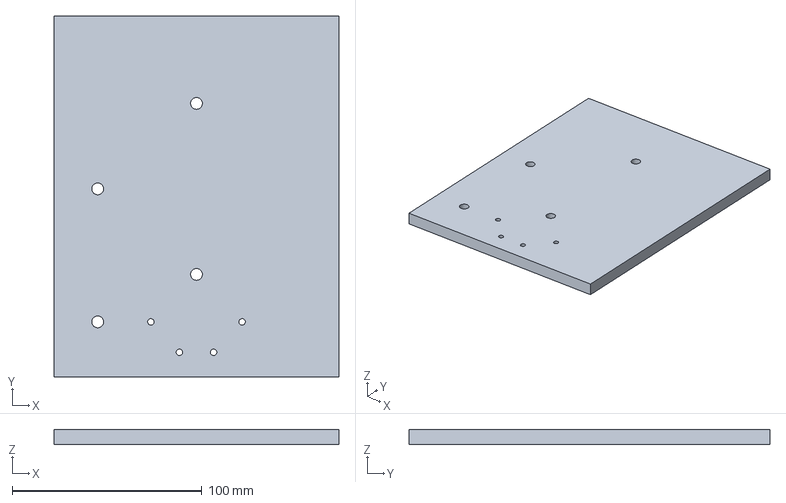
[picture p67: CAD file, 2026-07-30]
3d_model/step_cq/step_alt/fixed/base.step
150.0 x 190.0 x 8.00 mm
