nguyenduchan/coutingmachine/3d_model/step_cq/step_alt/moving/follower_pin.step

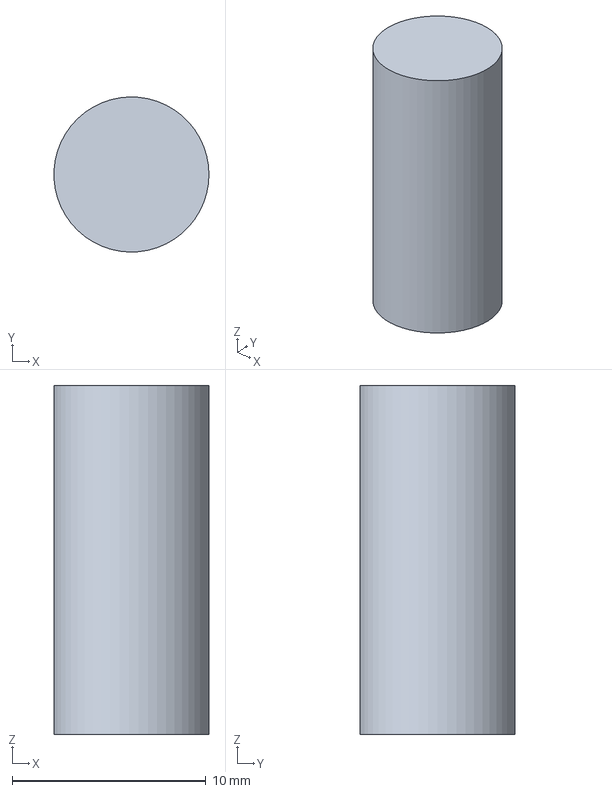
[picture p68: CAD file, 2026-07-30]
3d_model/step_cq/step_alt/moving/follower_pin.step
7.99 x 8.00 x 18.0 mm
