nguyenduchan/coutingmachine/3d_model/step_cq/step_feeder/fixed/lid.step

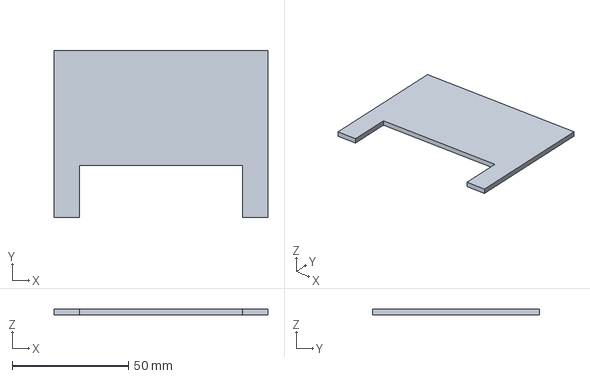
[picture p69: CAD file, 2026-07-30]
3d_model/step_cq/step_feeder/fixed/lid.step
92.0 x 72.0 x 2.50 mm
