nguyenduchan/coutingmachine/3d_model/step_cq/step_feeder/moving/cam.step

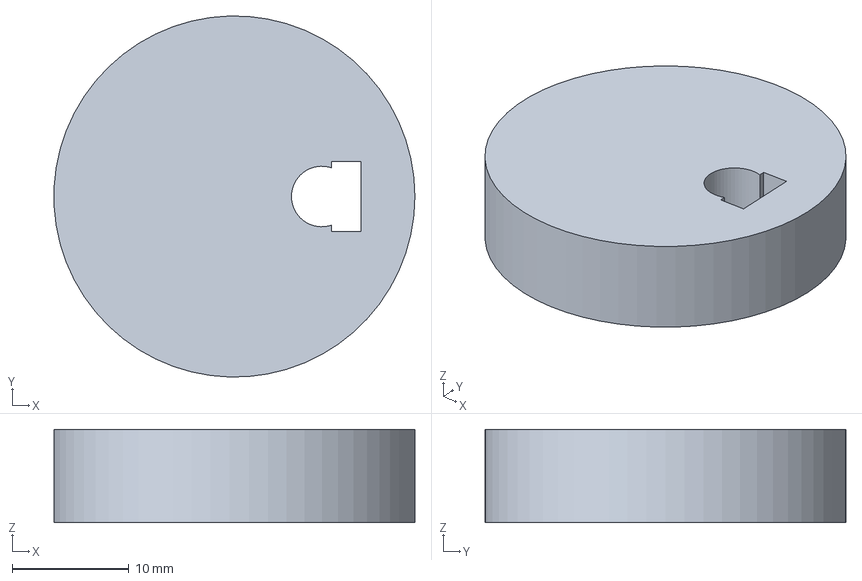
[picture p70: CAD file, 2026-07-30]
3d_model/step_cq/step_feeder/moving/cam.step
31.0 x 31.0 x 8.00 mm
