nguyenduchan/coutingmachine/3d_model/stl/brush_arm.stl

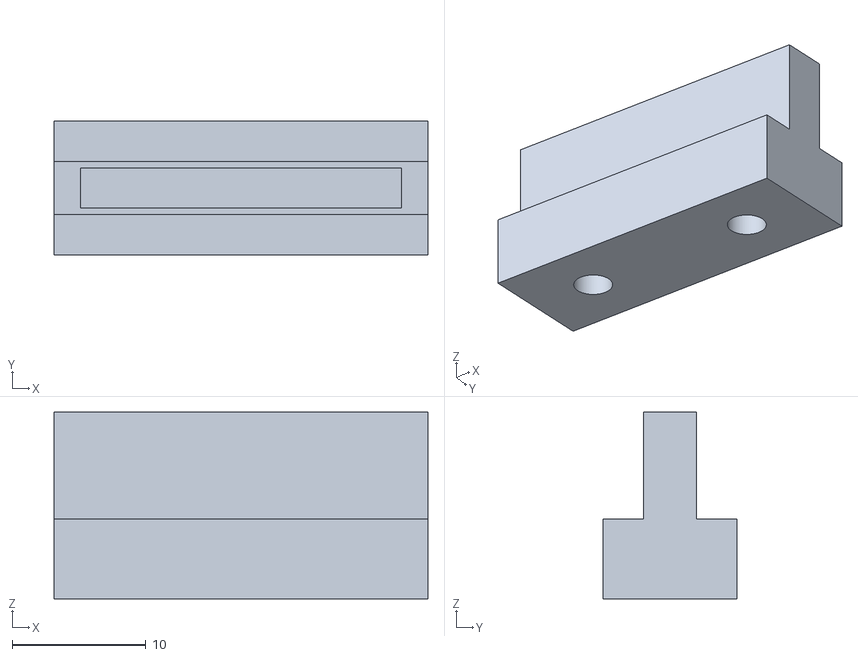
[picture p71: CAD file, 2026-07-28]
3d_model/stl/brush_arm.stl
28.0 x 10.0 x 14.0
