nguyenduchan/coutingmachine/3d_model/freecad/out/disc_access_lid.FCStd

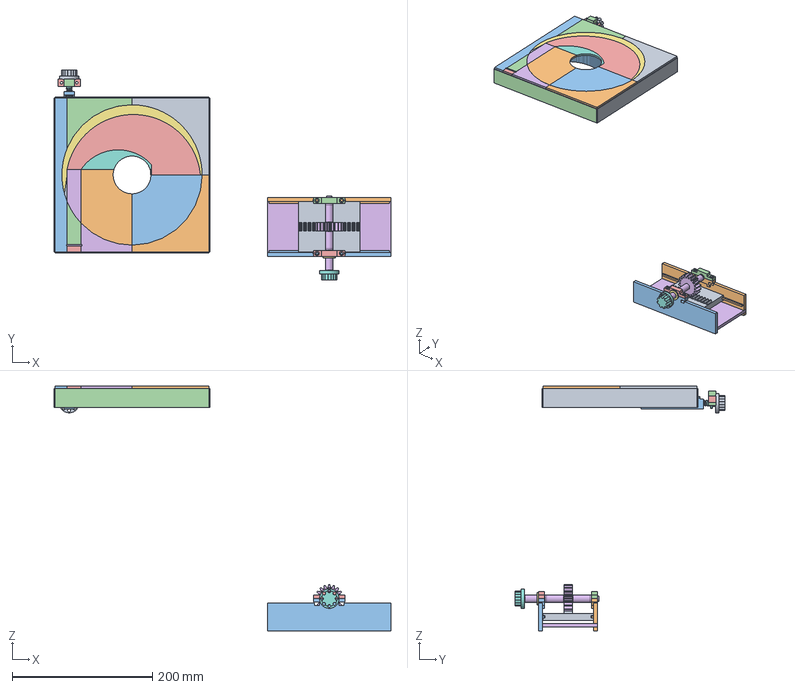
[picture p72: CAD file, 2026-08-14]
3d_model/freecad/out/disc_access_lid.FCStd
480.3 x 299.8 x 348.5 mm
Lid_Top_Out_NE
Lid_Top_Out_SE
Lid_Top_Out_W
Lid_Top_Out_NW
Lid_Top_Funnel_Roof
Lid_Top_Chute_Roof
Lid_Top_Rim_Pocket
Lid_Top_Deck_N
Lid_Top_Deck_S_Rim
Lid_Top_Deck_S_Hub_L
Lid_Top_Deck_S_Hub_R
Lid_Top_Out_SW_Chute_Above
Lid_Top_Out_SW_Chute_Below
Lid_Top_Out_SW_Rest
Lid_Bottom_Floor
Lid_Bottom_Rim_Pocket
Lid_Bottom_Deck_S_Rim
Lid_Fill_Outside
Lid_Wall_Arc_In
Lid_Wall_Arc_Out
Lid_Wall_Chute_In
Lid_Wall_Chute_Out
Lid_Wall_Wide
Lid_Wall_Mouth
Lid_Wall_Sq_E
Lid_Wall_Sq_N
Lid_Wall_Sq_W
Lid_Wall_Sq_S
Lid_Wall_Rim_Arc
Lid_Wall_Chute_End
Width_Adjust_Bar
Width_Lead_Screw
Width_Knob
Width_Nut
Width_Rail
Width_Retainer_Base
Width_Retainer_Cap
Height_Pinion_Shaft
Height_Friction_Washer
Height_Knob
Height_Adjust_Bar
Height_Bearing_Rail_S
Height_Bearing_Rail_N
Height_Bearing_Cap_S
Height_Bearing_Cap_N
RL_Rail_Bridge
