nguyenduchan/coutingmachine/3d_model/freecad/out/tube_l_exit_gate_parts/Exit_Inner_Wall_2.FCStd

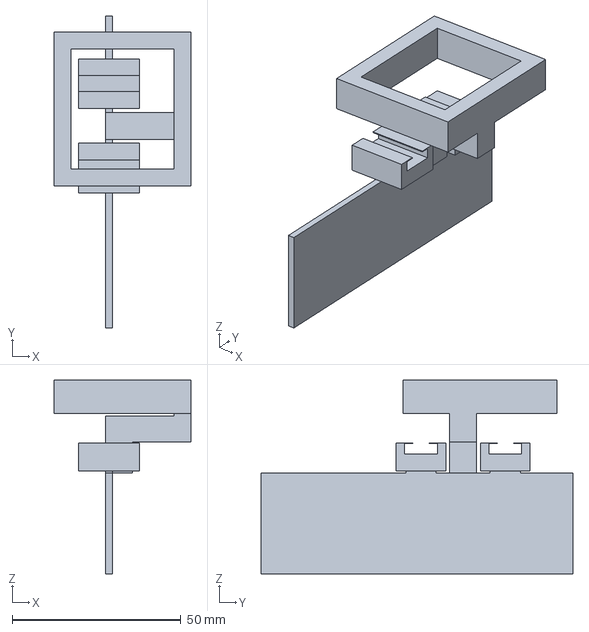
[picture p73: CAD file, 2026-08-18]
3d_model/freecad/out/tube_l_exit_gate_parts/Exit_Inner_Wall_2.FCStd
40.6 x 92.4 x 57.5 mm
