nguyenduchan/coutingmachine/3d_model/sim/meshes/rotary_linear/RL_Pinion_Shaft.stl

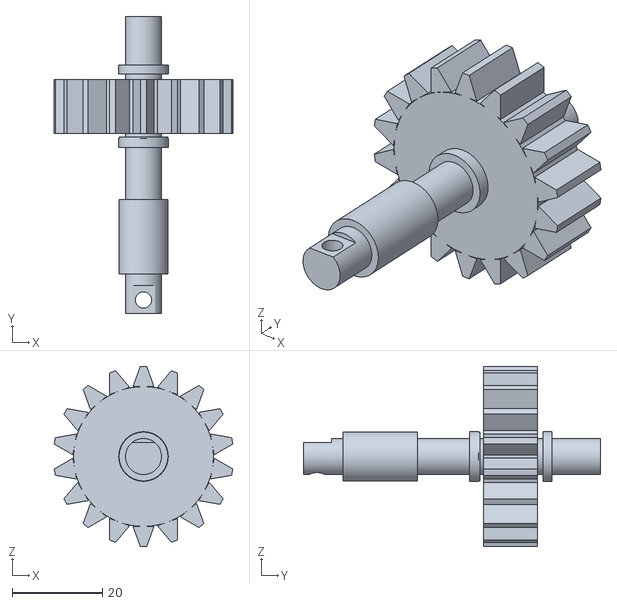
[picture p74: CAD file, 2026-08-03]
3d_model/sim/meshes/rotary_linear/RL_Pinion_Shaft.stl
39.6 x 65.9 x 40.0
