nguyenduchan/coutingmachine/3d_model/step_cq/fixed/rim_rail_gate.step

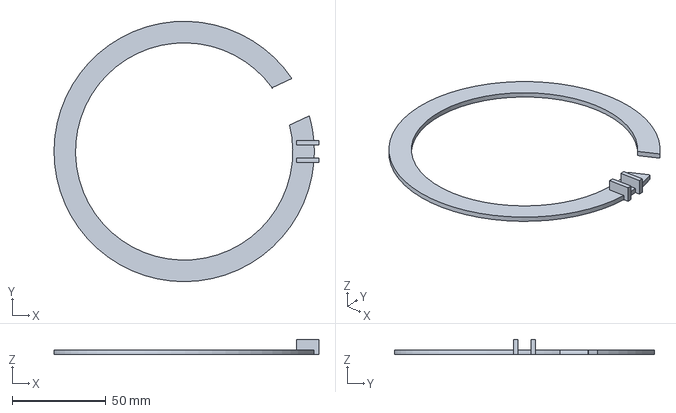
[picture p75: CAD file, 2026-07-28]
3d_model/step_cq/fixed/rim_rail_gate.step
141.5 x 139.0 x 8.00 mm
