nguyenduchan/coutingmachine/3d_model/step_cq/moving/conical_disc.step

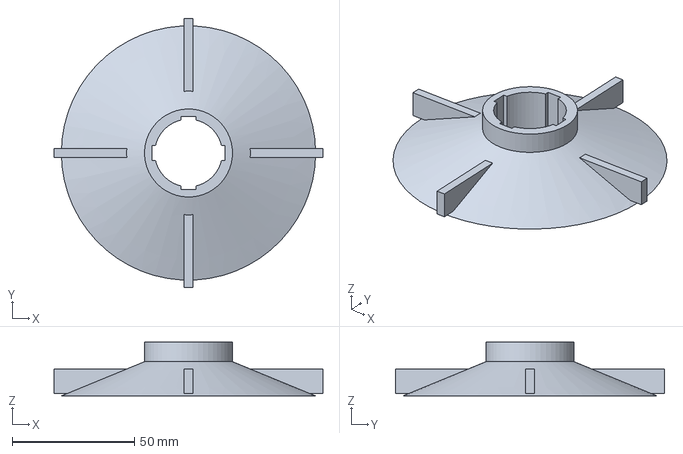
[picture p76: CAD file, 2026-07-28]
3d_model/step_cq/moving/conical_disc.step
110.0 x 110.0 x 22.0 mm
