nguyenduchan/coutingmachine/3d_model/step_cq/step_alt/moving/drive_hub.step

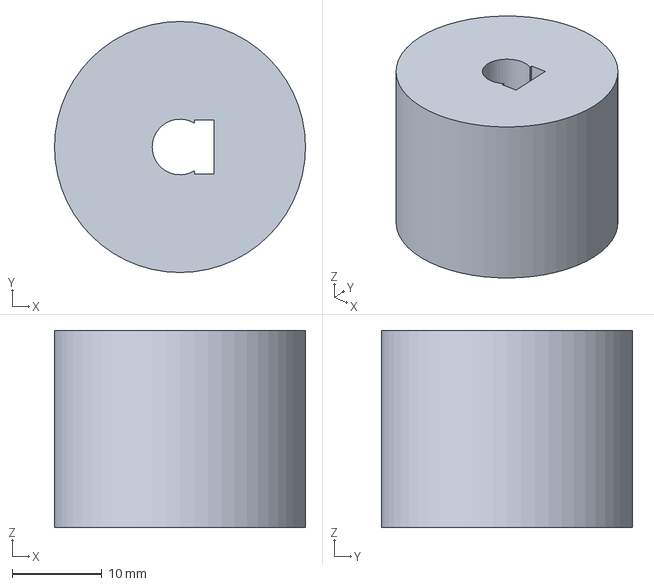
[picture p78: CAD file, 2026-07-30]
3d_model/step_cq/step_alt/moving/drive_hub.step
28.0 x 28.0 x 22.0 mm
