nguyenduchan/coutingmachine/3d_model/step_cq/step_feeder/fixed/base.step

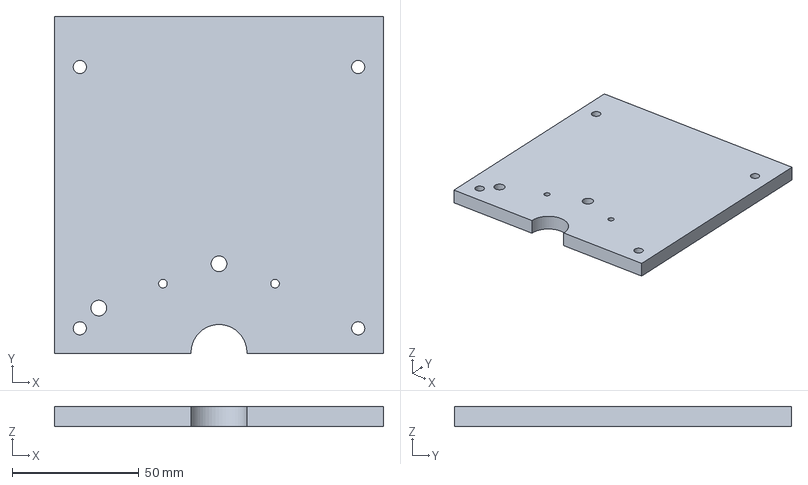
[picture p79: CAD file, 2026-07-30]
3d_model/step_cq/step_feeder/fixed/base.step
130.0 x 133.2 x 8.00 mm
