nguyenduchan/coutingmachine/3d_model/freecad/out/byj_rack_print/Housing.stl

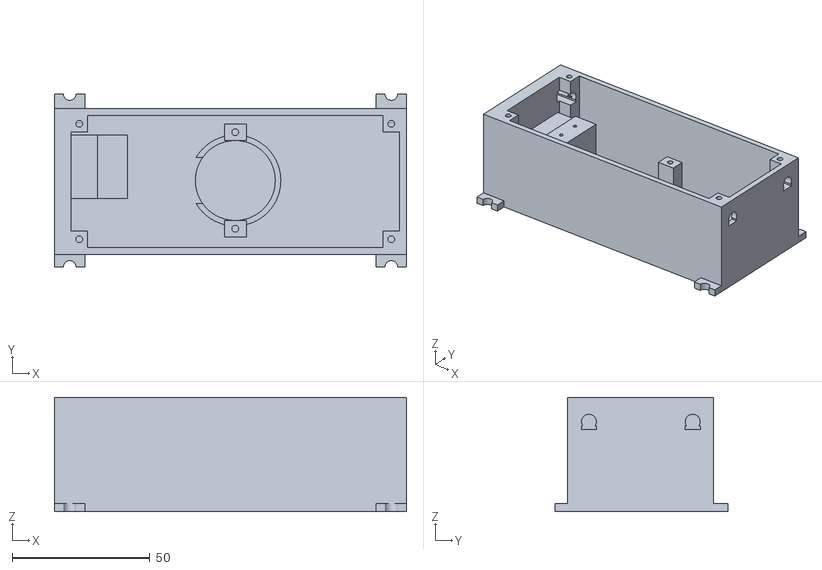
[picture p80: CAD file, 2026-09-07]
3d_model/freecad/out/byj_rack_print/Housing.stl
127.6 x 62.6 x 41.4
