nguyenduchan/coutingmachine/3d_model/freecad/out/jgb37_motor_bracket.FCStd

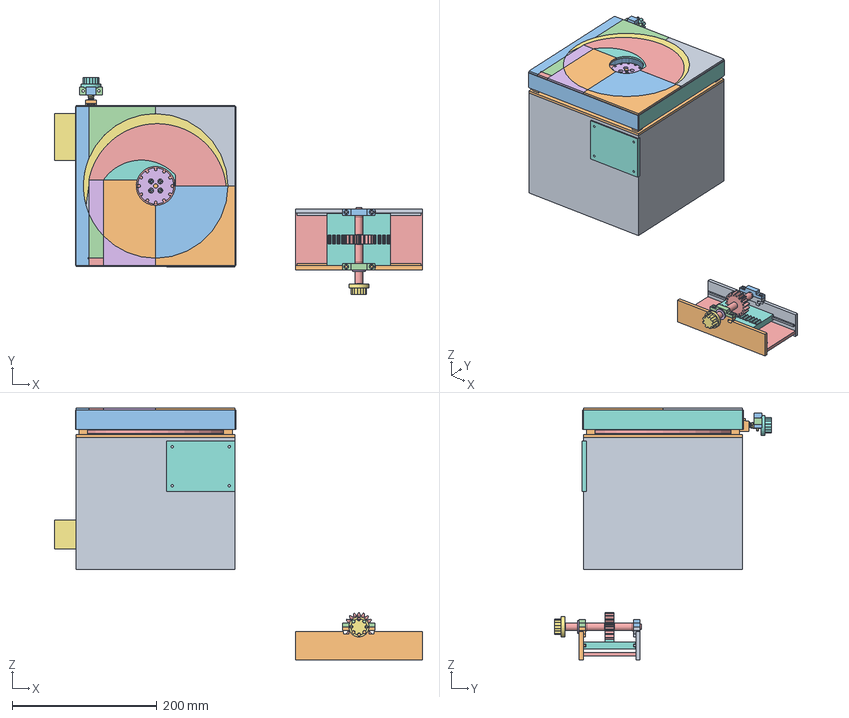
[picture p81: CAD file, 2026-08-14]
3d_model/freecad/out/jgb37_motor_bracket.FCStd
509.1 x 299.8 x 348.5 mm
Housing_Shell
Housing_Lid
Housing_Shelf
Mount_Stem
Mount_Lid
Mount_Web
Mount_Floor_Pad
Mount_Brace_0
Mount_Brace_1
JGB37_Gearbox
JGB37_Boss
JGB37_Shaft
JGB37_Can
JGB37_Rear_Boss
JGB37_Terminal_L
JGB37_Terminal_R
Coupler_Body
Shaft_Cylinder
Bearing_Upper_Race
Bearing_Lower_Race
Disc_Plate
Hub_Body
Drawer_Shell
Panel_Bezel
Lid_Top_Out_NE
Lid_Top_Out_SE
Lid_Top_Out_W
Lid_Top_Out_NW
Lid_Top_Funnel_Roof
Lid_Top_Chute_Roof
Lid_Top_Rim_Pocket
Lid_Top_Deck_N
Lid_Top_Deck_S_Rim
Lid_Top_Deck_S_Hub_L
Lid_Top_Deck_S_Hub_R
Lid_Top_Out_SW_Chute_Above
Lid_Top_Out_SW_Chute_Below
Lid_Top_Out_SW_Rest
Lid_Bottom_Floor
Lid_Bottom_Rim_Pocket
Lid_Bottom_Deck_S_Rim
Lid_Fill_Outside
Lid_Wall_Arc_In
Lid_Wall_Arc_Out
Lid_Wall_Chute_In
Lid_Wall_Chute_Out
Lid_Wall_Mouth
Lid_Wall_Sq_E
Lid_Wall_Sq_N
Lid_Wall_Sq_W
Lid_Wall_Sq_S
Lid_Wall_Rim_Arc
Lid_Wall_Chute_End
Width_Adjust_Bar
Width_Lead_Screw
Width_Knob
Width_Nut
Width_Rail
Width_Retainer_Base
Width_Retainer_Cap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
