nguyenduchan/coutingmachine/3d_model/freecad/out/tube_l_exit_gate_parts/Bowl_Tube.FCStd

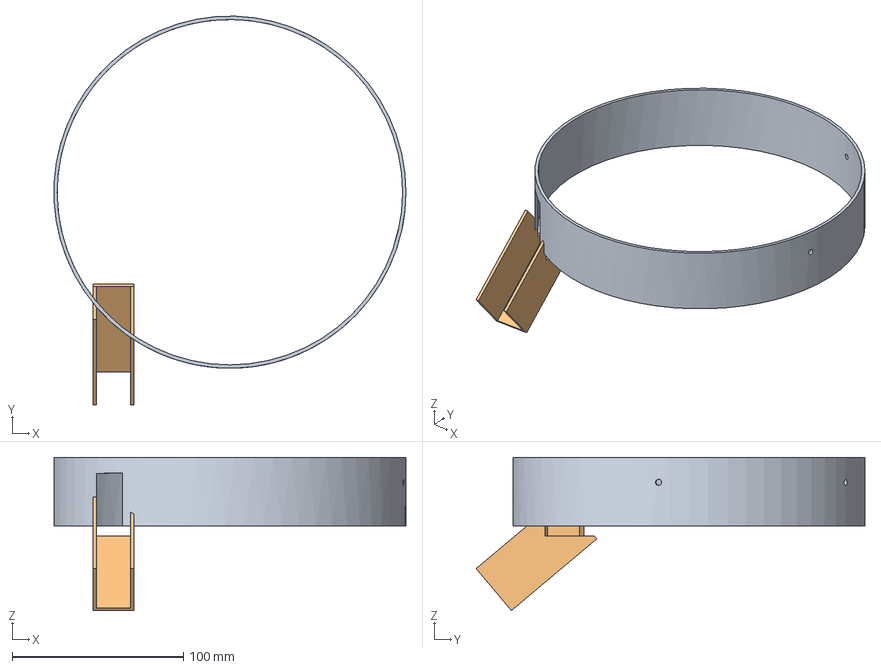
[picture p82: CAD file, 2026-08-18]
3d_model/freecad/out/tube_l_exit_gate_parts/Bowl_Tube.FCStd
205.5 x 226.9 x 89.4 mm
Bowl_Tube_Wall
Bowl_Tube_Exit_Chute
