nguyenduchan/coutingmachine/3d_model/step_cq/fixed/spiral_track.step

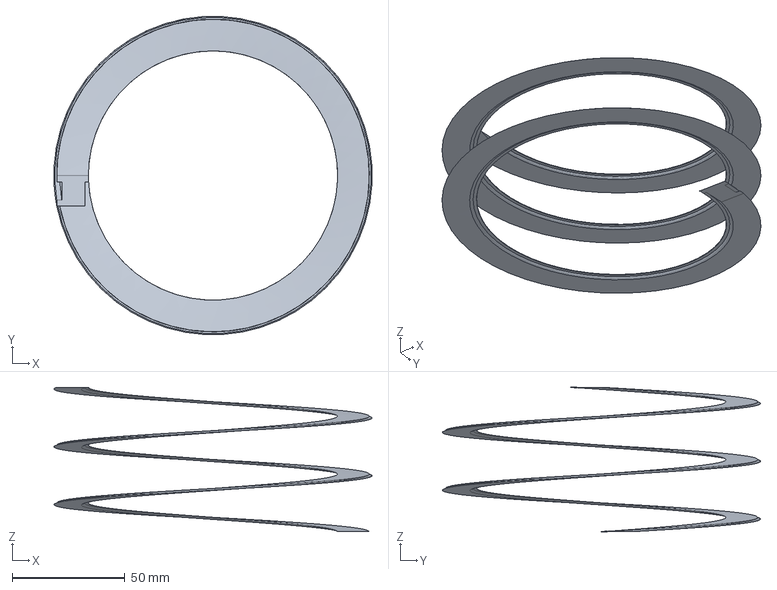
[picture p83: CAD file, 2026-07-28]
3d_model/step_cq/fixed/spiral_track.step
140.9 x 140.9 x 64.0 mm
