nguyenduchan/coutingmachine/3d_model/step_cq/moving/drive_hub.step

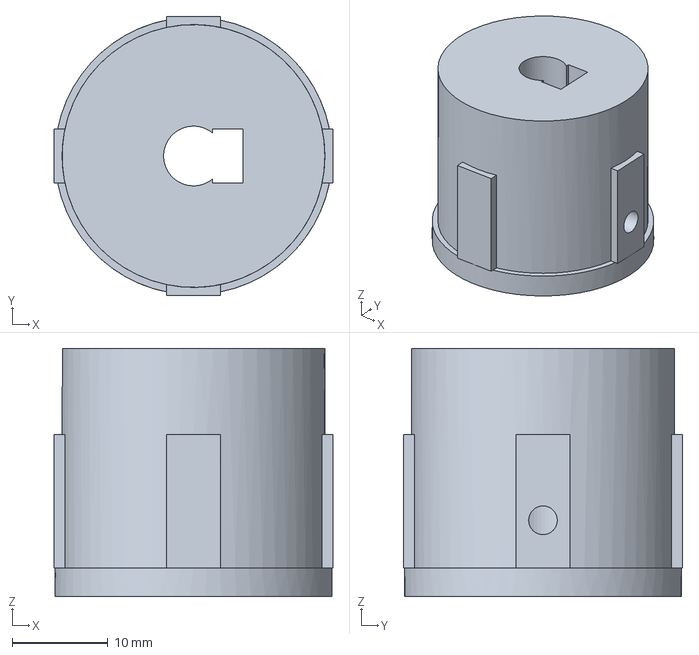
[picture p84: CAD file, 2026-07-28]
3d_model/step_cq/moving/drive_hub.step
29.2 x 29.2 x 26.0 mm
