nguyenduchan/coutingmachine/3d_model/step_cq/step_alt/fixed/motor_clamp.step

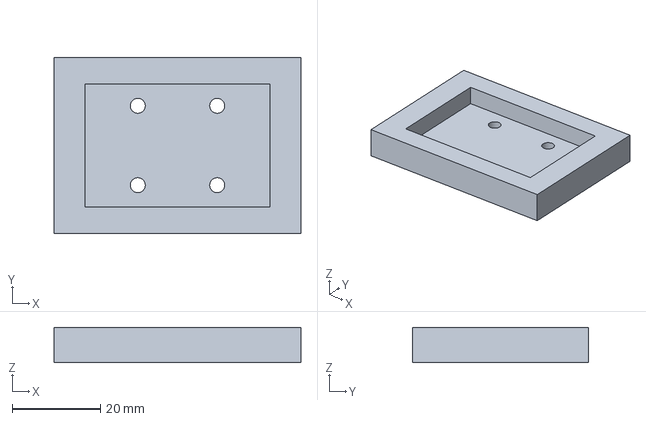
[picture p85: CAD file, 2026-07-30]
3d_model/step_cq/step_alt/fixed/motor_clamp.step
56.0 x 40.0 x 8.00 mm
