nguyenduchan/coutingmachine/3d_model/step_cq/step_alt/moving/yoke_group_A.step

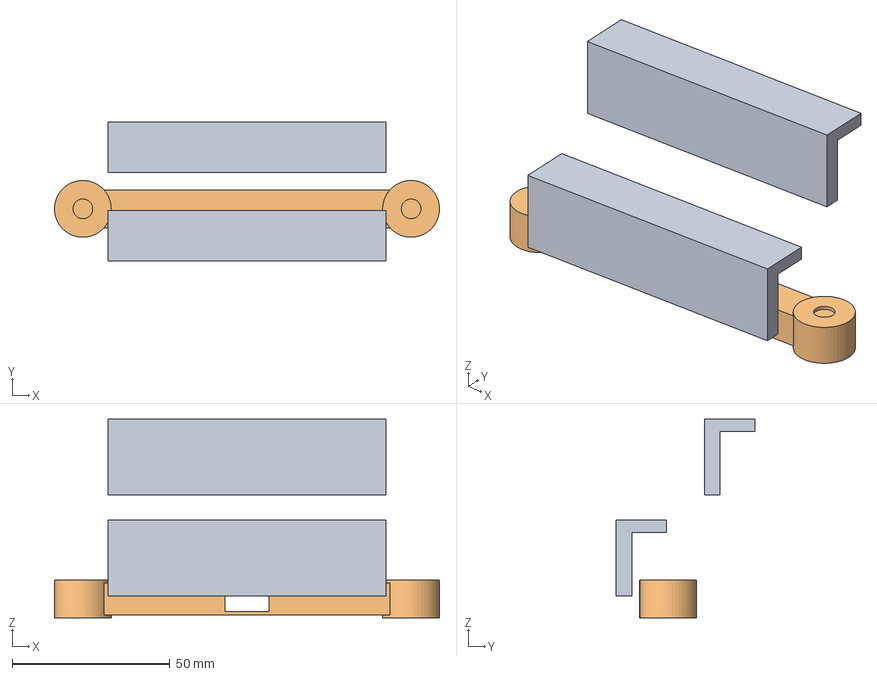
[picture p86: CAD file, 2026-07-30]
3d_model/step_cq/step_alt/moving/yoke_group_A.step
122.0 x 44.0 x 63.0 mm
