nguyenduchan/coutingmachine/3d_model/step_cq/step_feeder/fixed/hopper.step

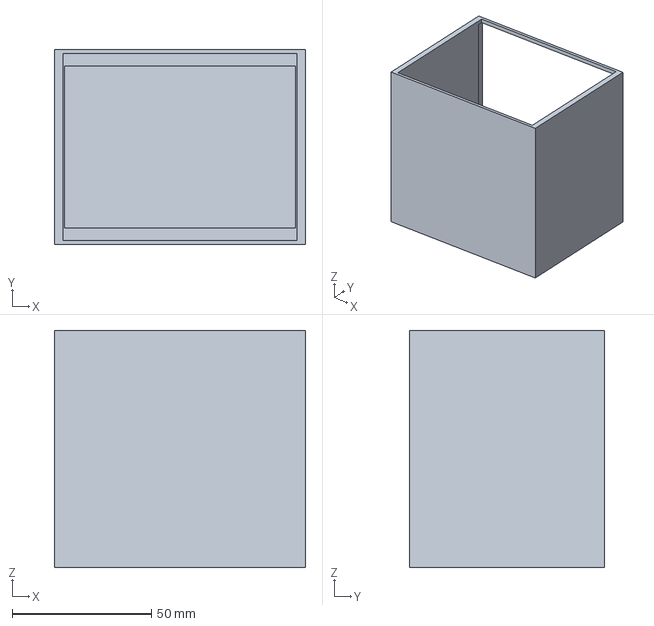
[picture p87: CAD file, 2026-07-30]
3d_model/step_cq/step_feeder/fixed/hopper.step
90.0 x 70.0 x 85.0 mm
