nguyenduchan/coutingmachine/3d_model/stl/base_plate.stl

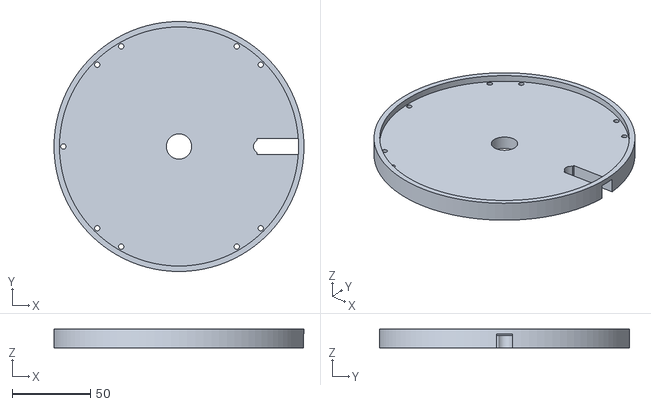
[picture p88: CAD file, 2026-07-28]
3d_model/stl/base_plate.stl
160.0 x 160.0 x 12.0
