nguyenduchan/coutingmachine/3d_model/freecad/out/byj_rack_print/byj_rack_print_plate.stl

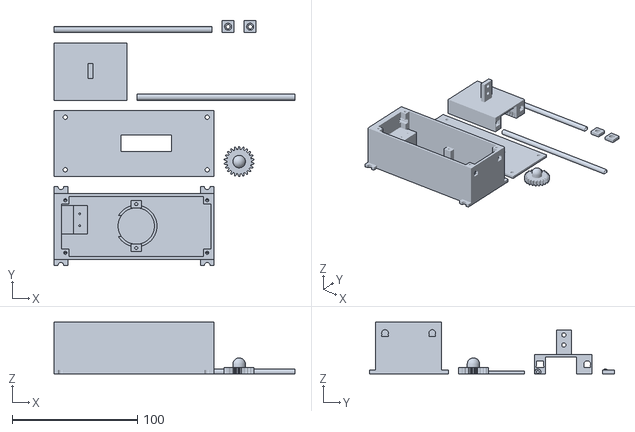
[picture p89: CAD file, 2026-09-07]
3d_model/freecad/out/byj_rack_print/byj_rack_print_plate.stl
192.1 x 195.0 x 41.4
