nguyenduchan/coutingmachine/3d_model/freecad/out/rotary_linear.FCStd

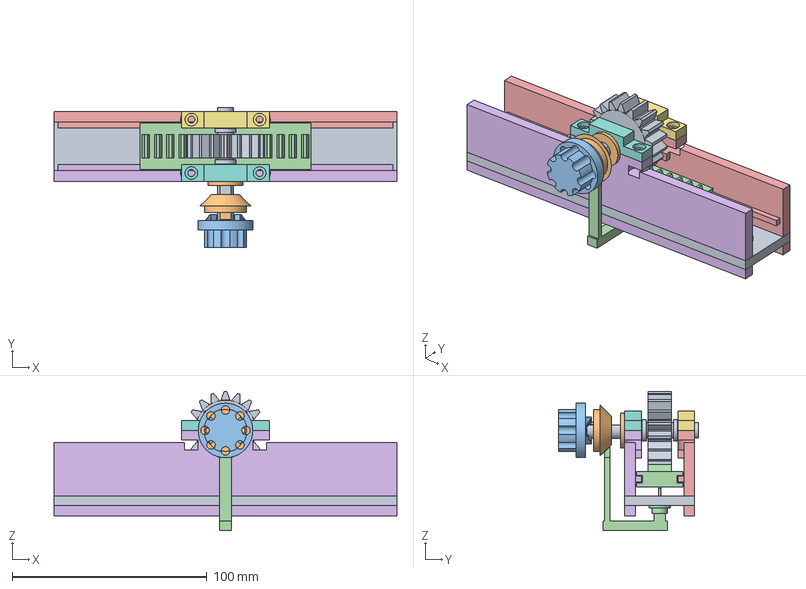
[picture p90: CAD file, 2026-08-14]
3d_model/freecad/out/rotary_linear.FCStd
175.9 x 71.9 x 71.3 mm
RL_Pinion_Shaft
RL_Friction_Washer
RL_Knob
RL_Follower
RL_Bearing_Rail_S
RL_Bearing_Rail_N
RL_Bearing_Cap_S
RL_Bearing_Cap_N
RL_Rail_Bridge
RL_Cam_Sleeve
RL_Cam_StopPin
RL_Detent
