nguyenduchan/coutingmachine/3d_model/freecad/out/tube_l_exit_gate_parts/Entry_Gate_Knob.FCStd

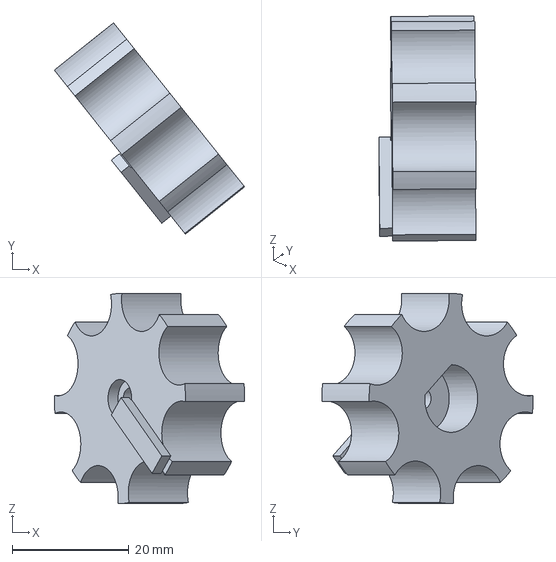
[picture p91: CAD file, 2026-08-18]
3d_model/freecad/out/tube_l_exit_gate_parts/Entry_Gate_Knob.FCStd
32.6 x 36.2 x 36.0 mm
