nguyenduchan/coutingmachine/3d_model/sim/meshes/tube_l_exit/Scale_Width.stl

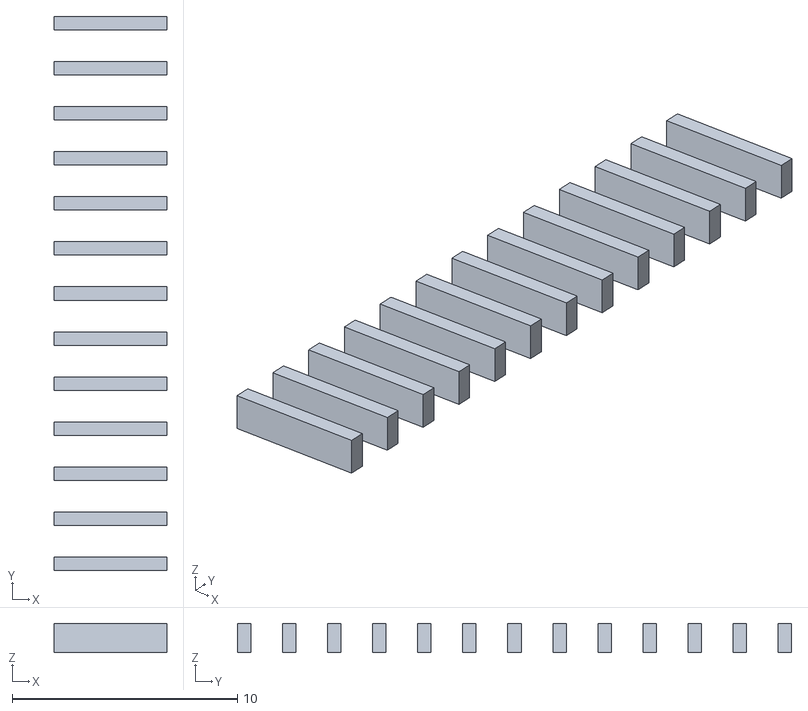
[picture p92: CAD file, 2026-08-13]
3d_model/sim/meshes/tube_l_exit/Scale_Width.stl
5.00 x 24.6 x 1.30
