nguyenduchan/coutingmachine/3d_model/step_cq/fixed/lid.step

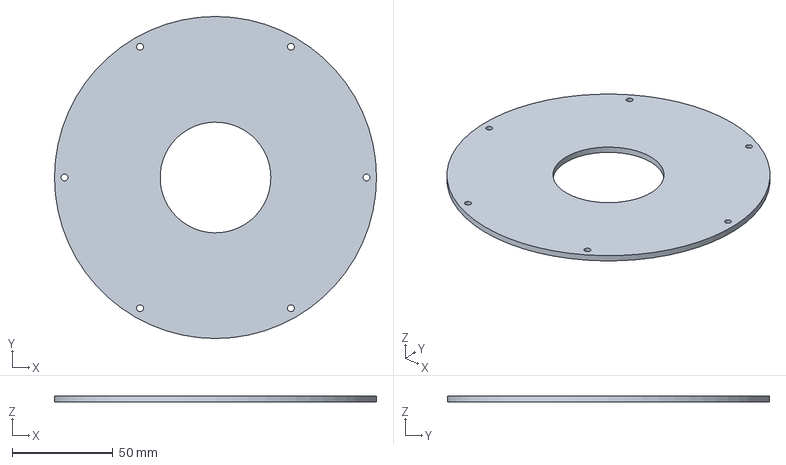
[picture p93: CAD file, 2026-07-28]
3d_model/step_cq/fixed/lid.step
160.0 x 160.0 x 3.00 mm
