nguyenduchan/coutingmachine/3d_model/step_cq/step_alt/fixed/hopper.step

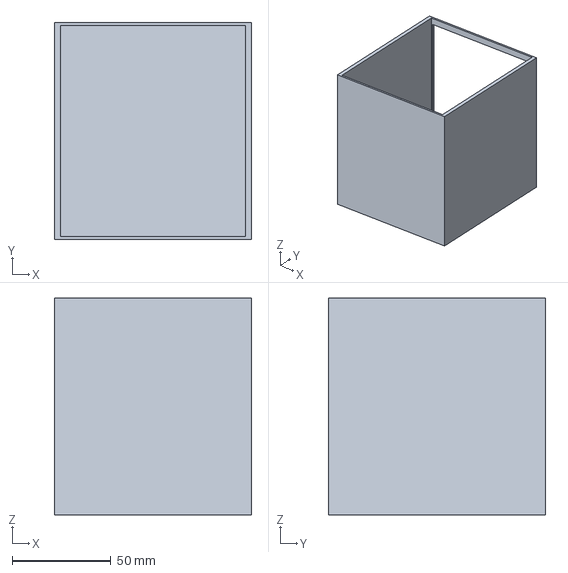
[picture p94: CAD file, 2026-07-30]
3d_model/step_cq/step_alt/fixed/hopper.step
100.0 x 110.0 x 110.0 mm
