nguyenduchan/coutingmachine/3d_model/step_cq/step_feeder/fixed/guide_rod.step

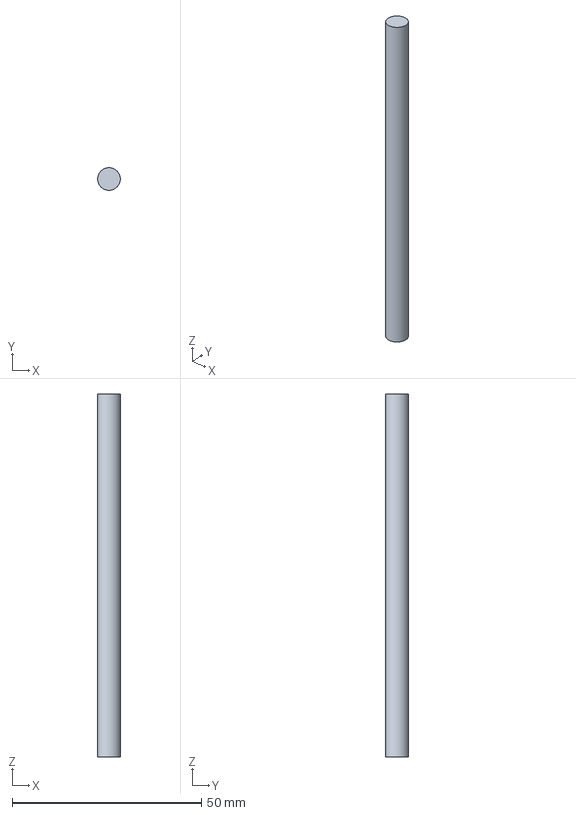
[picture p95: CAD file, 2026-07-30]
3d_model/step_cq/step_feeder/fixed/guide_rod.step
5.99 x 6.00 x 96.0 mm
