nguyenduchan/coutingmachine/3d_model/stl/hopper.stl

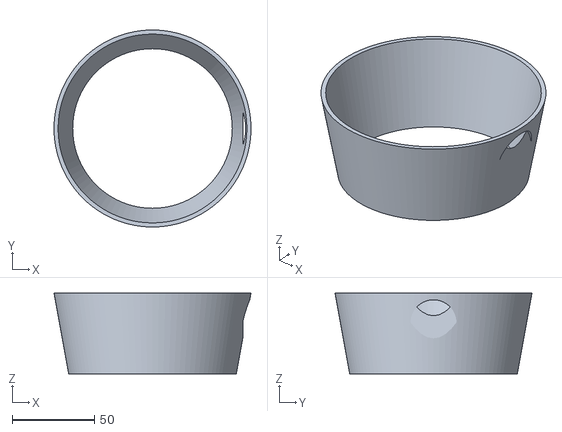
[picture p96: CAD file, 2026-07-28]
3d_model/stl/hopper.stl
120.0 x 120.0 x 49.0
