nguyenduchan/coutingmachine/3d_model/freecad/out/byj_rack_print/Housing_Lid.stl

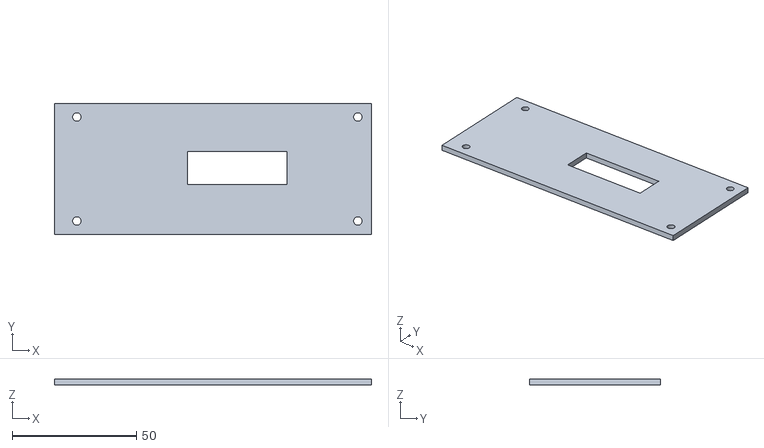
[picture p97: CAD file, 2026-09-07]
3d_model/freecad/out/byj_rack_print/Housing_Lid.stl
127.6 x 52.9 x 2.50
