nguyenduchan/coutingmachine/3d_model/freecad/out/l_flap_divert.FCStd

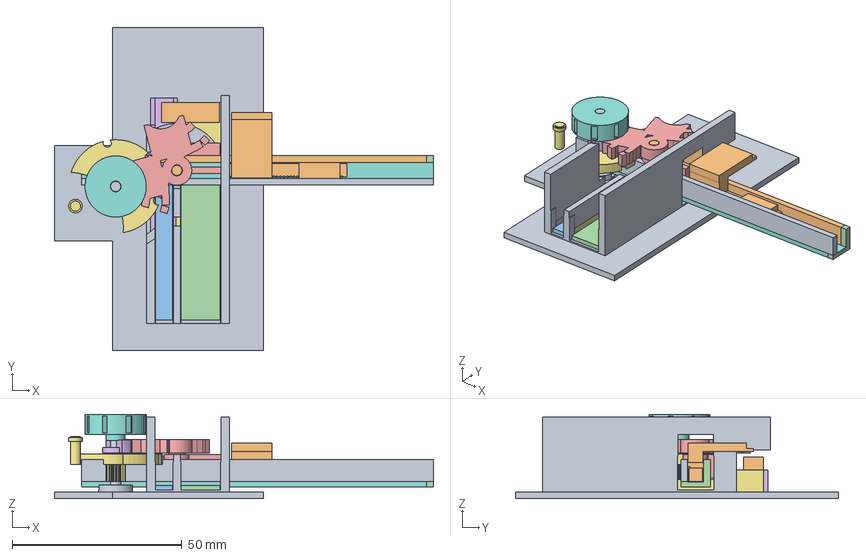
[picture p98: CAD file, 2026-08-10]
3d_model/freecad/out/l_flap_divert.FCStd
111.5 x 95.0 x 24.8 mm
Divert_Frame
Gap_Slider
Lane_Fill_Small_5p5
Lane_Fill_Large_12
Inlet_Pill_Passage
Guide_Chute_Small
Guide_Chute_Large
Slider_Rail_Base
Slider_Rail_Wall_NegY
Slider_Rail_Wall_PosY
Slider_Rail_Stop_L
Slider_Rail_Stop_R
Malta_Cross
Geneva_Driver
Gear_Drive_Disc
Drive_Knob
Knob_Shaft
Pivot_Pin
