nguyenduchan/coutingmachine/3d_model/freecad/out/tube_l_exit_gate_parts/Entry_Gate_Cam.FCStd

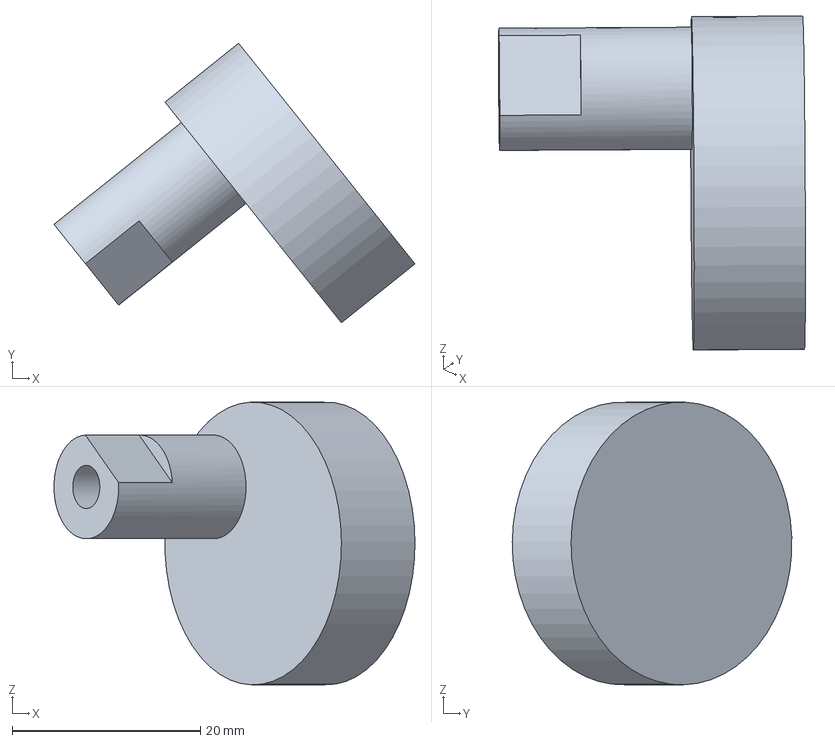
[picture p99: CAD file, 2026-08-18]
3d_model/freecad/out/tube_l_exit_gate_parts/Entry_Gate_Cam.FCStd
38.3 x 29.7 x 30.0 mm
