nguyenduchan/coutingmachine/3d_model/sim/meshes/rotary_linear/RL_Follower.stl

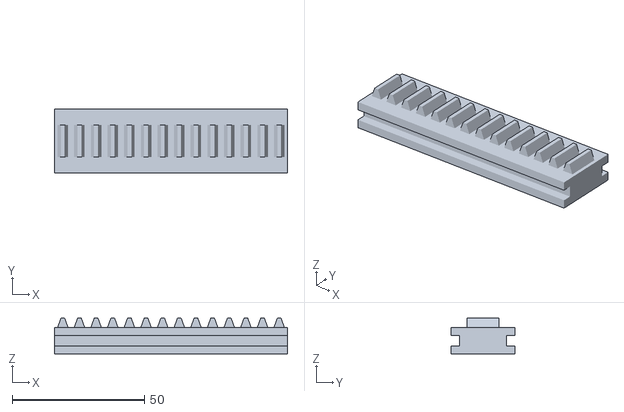
[picture p100: CAD file, 2026-08-03]
3d_model/sim/meshes/rotary_linear/RL_Follower.stl
88.0 x 24.0 x 13.5
