nguyenduchan/coutingmachine/3d_model/step_cq/base_plate.step

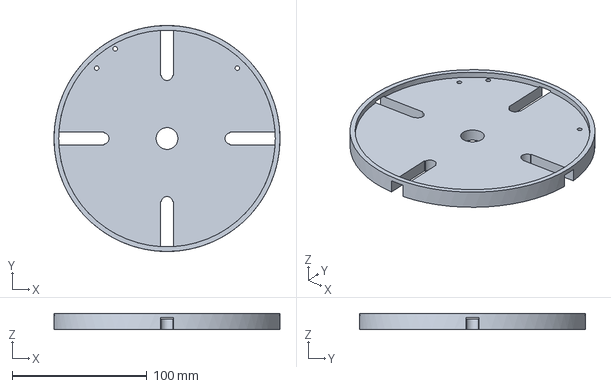
[picture p101: CAD file, 2026-07-28]
3d_model/step_cq/base_plate.step
168.0 x 168.0 x 12.0 mm
