nguyenduchan/coutingmachine/3d_model/step_cq/fixed/frame_riser.step

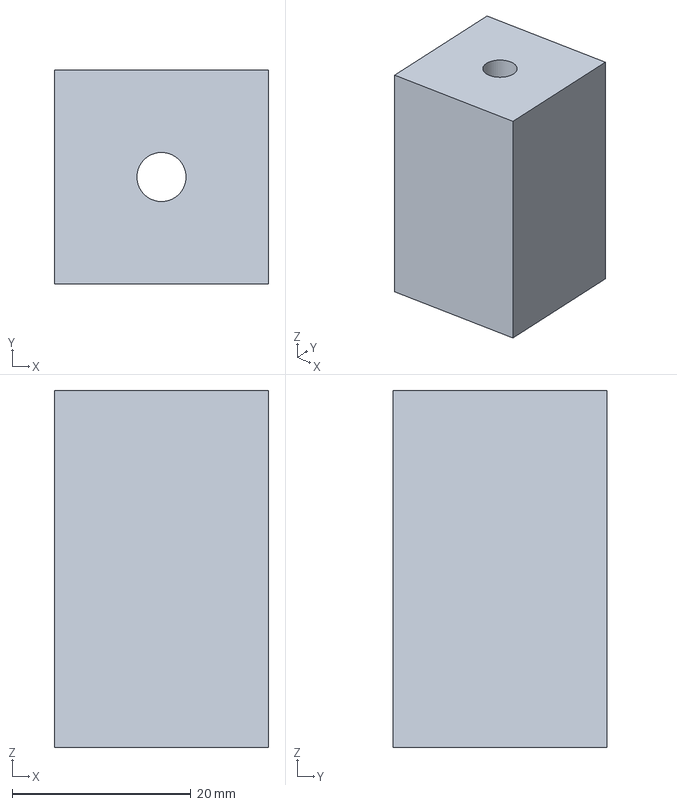
[picture p102: CAD file, 2026-07-28]
3d_model/step_cq/fixed/frame_riser.step
24.0 x 24.0 x 40.0 mm
