nguyenduchan/coutingmachine/3d_model/step_cq/step_feeder/fixed/orientation_rail.step

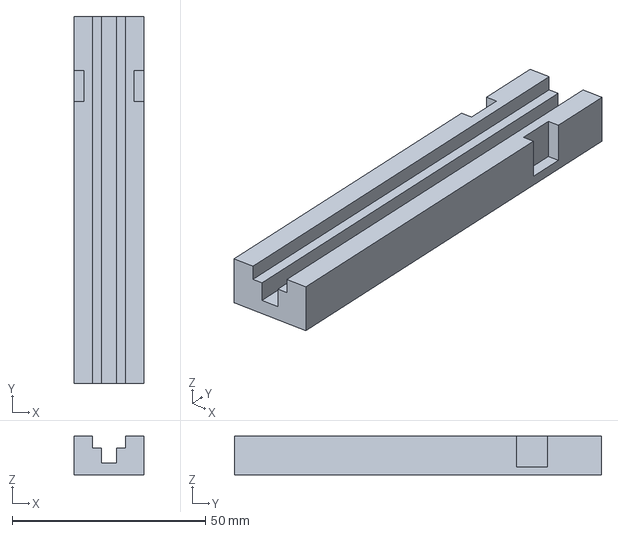
[picture p103: CAD file, 2026-07-30]
3d_model/step_cq/step_feeder/fixed/orientation_rail.step
18.0 x 95.0 x 10.0 mm
