nguyenduchan/coutingmachine/3d_model/stl/drive_hub.stl

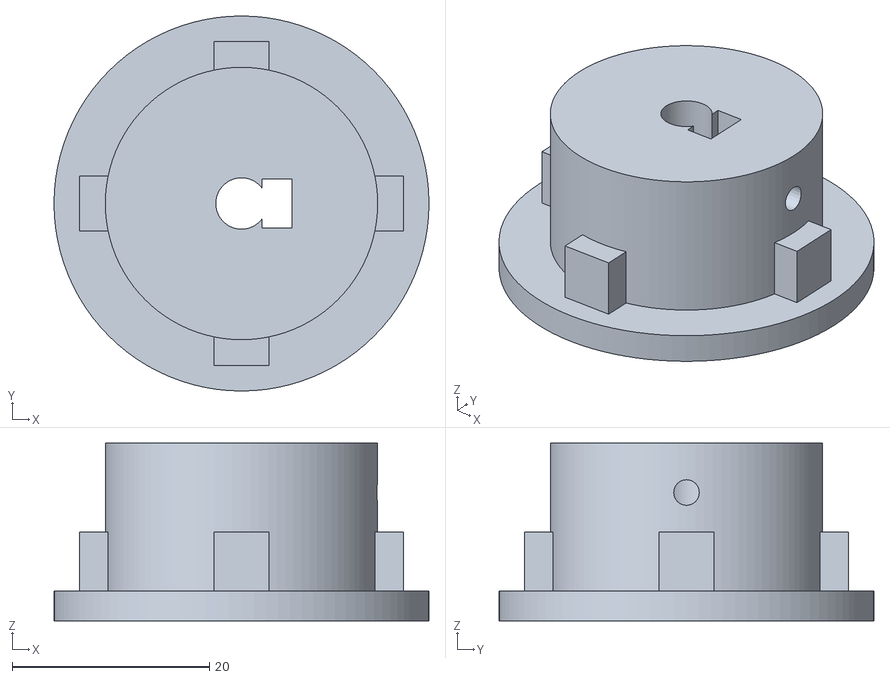
[picture p104: CAD file, 2026-07-28]
3d_model/stl/drive_hub.stl
38.0 x 38.0 x 18.0
