nguyenduchan/coutingmachine/3d_model/freecad/out/tube_l_exit_gate_parts/Exit_Slide.FCStd

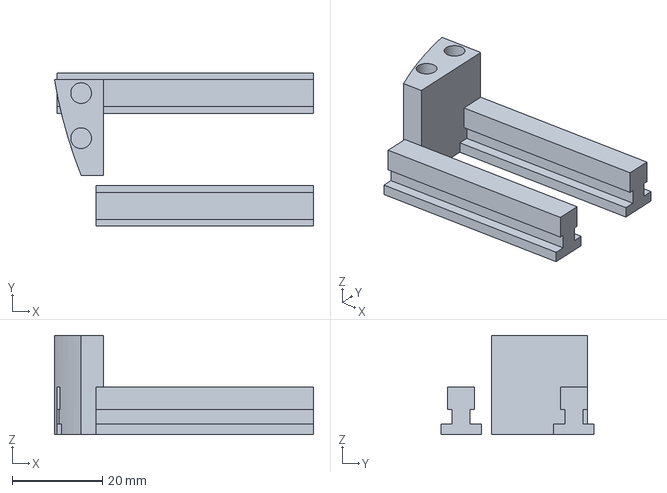
[picture p105: CAD file, 2026-08-18]
3d_model/freecad/out/tube_l_exit_gate_parts/Exit_Slide.FCStd
57.4 x 34.0 x 22.0 mm
