nguyenduchan/coutingmachine/3d_model/freecad/out/width_chute_selector.FCStd

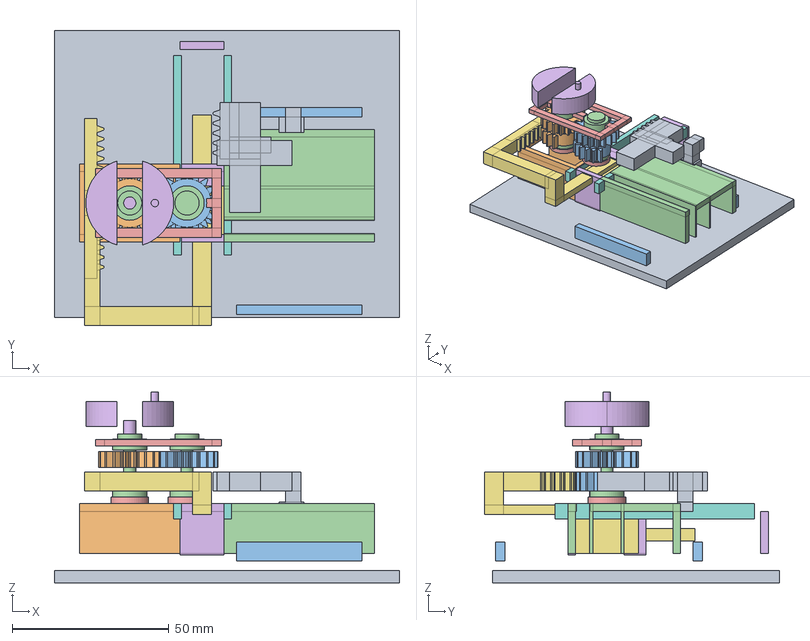
[picture p106: CAD file, 2026-08-10]
3d_model/freecad/out/width_chute_selector.FCStd
110.0 x 94.0 x 60.8 mm
Base_Plate
Inlet_Chute_20mm
Cassette_Rails
Chute_Cassette_Body
Gear_Deck_On_Inlet
Width_Gate_Fixed
Slider1_Aperture_Rack
Slider1_Y_Rails
Slider2_Cassette_Rack
Gear1_Knob_Drive
Gear2_Cassette_Drive
Shaft_Bearings_Both_Sides
Upper_Bearing_Frame
Knob_Shaft
