nguyenduchan/coutingmachine/3d_model/sim/meshes/tube_l_exit/Guide_System.stl

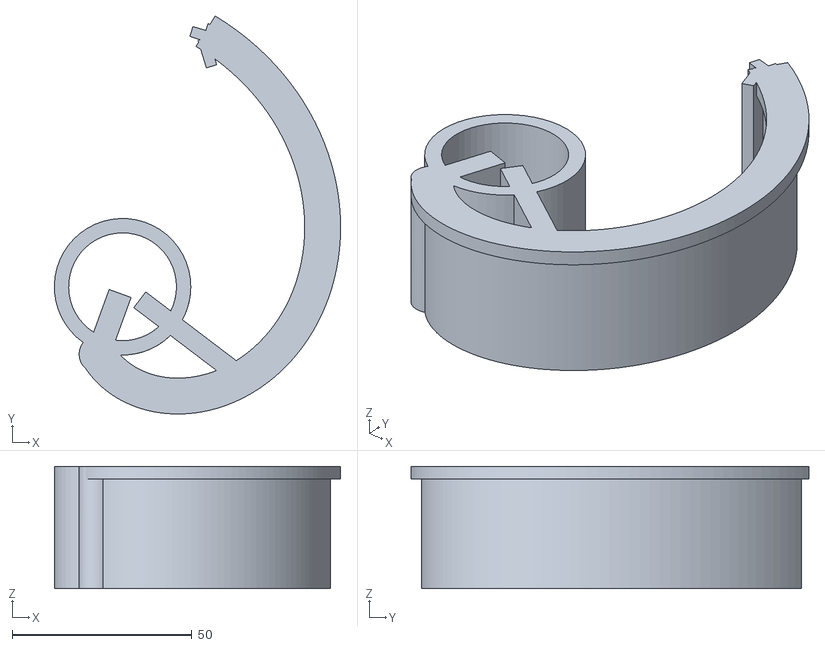
[picture p107: CAD file, 2026-08-13]
3d_model/sim/meshes/tube_l_exit/Guide_System.stl
79.7 x 110.8 x 34.0
