nguyenduchan/coutingmachine/3d_model/step_cq/fixed/bowl.step

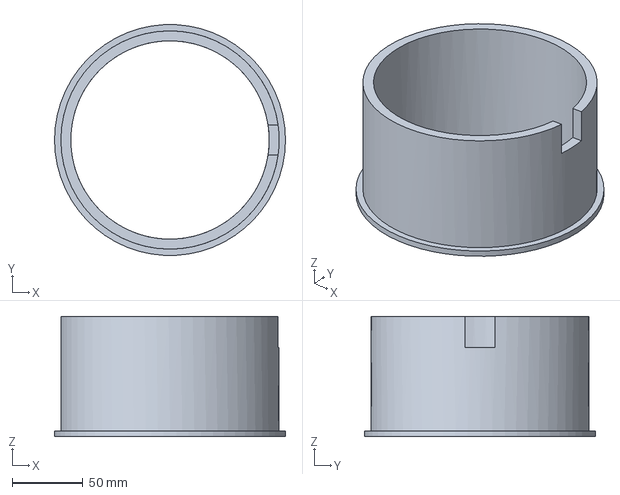
[picture p108: CAD file, 2026-07-28]
3d_model/step_cq/fixed/bowl.step
163.0 x 162.8 x 85.0 mm
