nguyenduchan/coutingmachine/3d_model/step_cq/rotary_disc.step

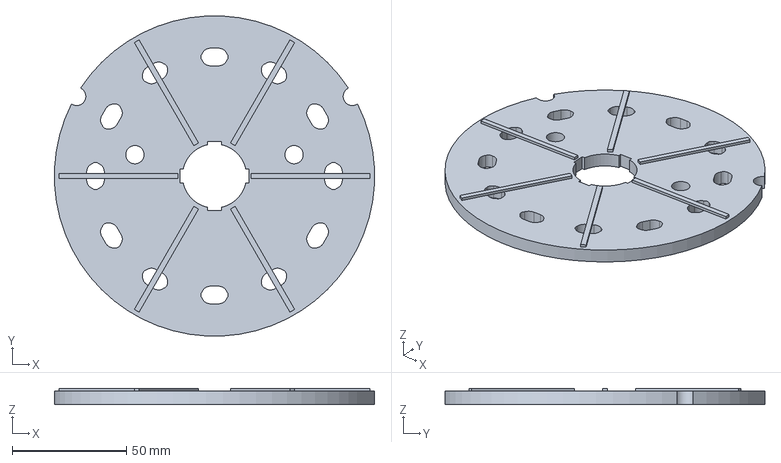
[picture p109: CAD file, 2026-07-28]
3d_model/step_cq/rotary_disc.step
139.8 x 139.8 x 7.20 mm
