nguyenduchan/coutingmachine/3d_model/step_cq/step_feeder/fixed/outlet_chute.step

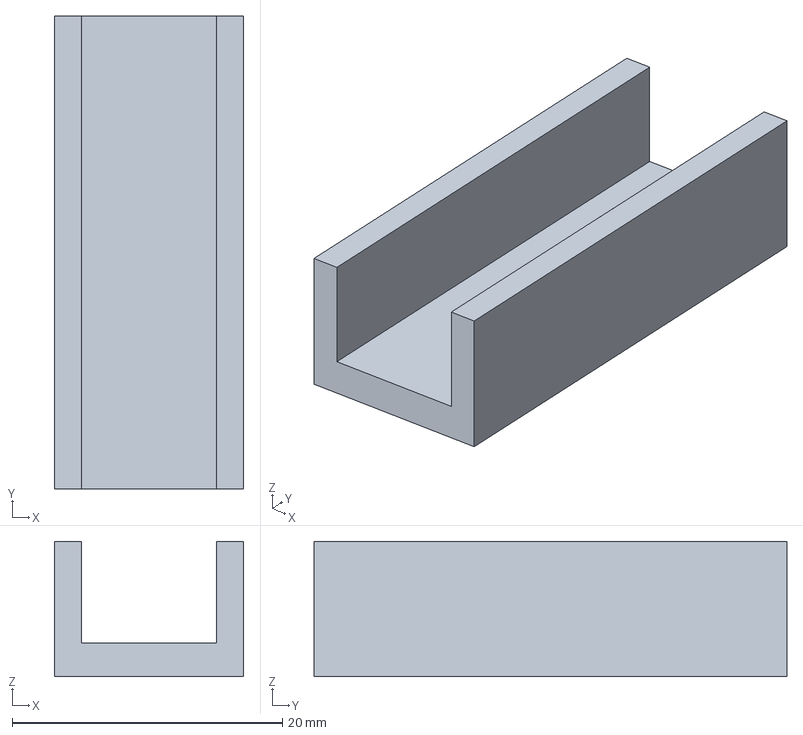
[picture p110: CAD file, 2026-07-30]
3d_model/step_cq/step_feeder/fixed/outlet_chute.step
14.0 x 35.0 x 10.0 mm
