nguyenduchan/coutingmachine/3d_model/stl/rotary_disc.stl

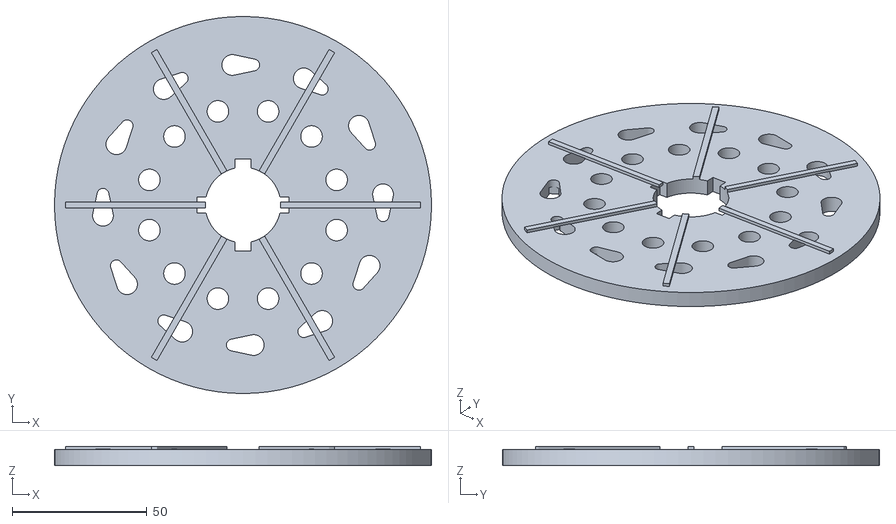
[picture p111: CAD file, 2026-07-28]
3d_model/stl/rotary_disc.stl
140.0 x 140.0 x 7.20
