nguyenduchan/coutingmachine/3d_model/freecad/out/adjustable_chute.FCStd

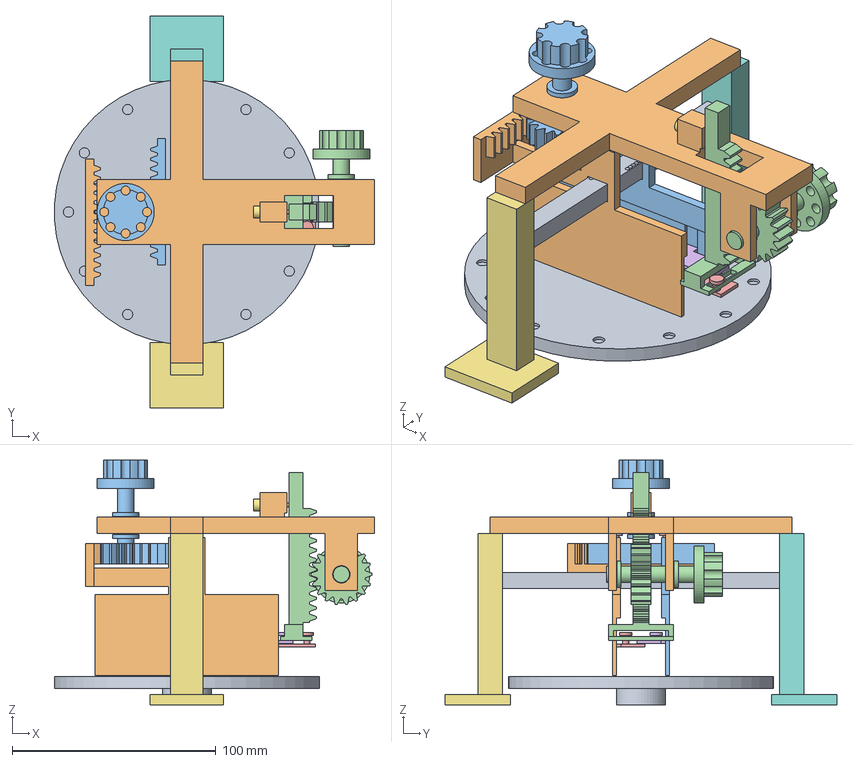
[picture p112: CAD file, 2026-08-06]
3d_model/freecad/out/adjustable_chute.FCStd
156.9 x 192.0 x 120.0 mm
Rotor_Disc
Side_Wall_S
Side_Wall_N
Height_Gate
Roof_S
Roof_N
Frame_Column_S
Frame_Column_N
Frame_Rail_Beam
Frame_Top_Bridge
Width_Knob_Pinion
Height_Knob_Pinion
Detent_WN
Detent_WS
Detent_H
