nguyenduchan/coutingmachine/3d_model/freecad/out/byj_rack_print/Pinion.stl

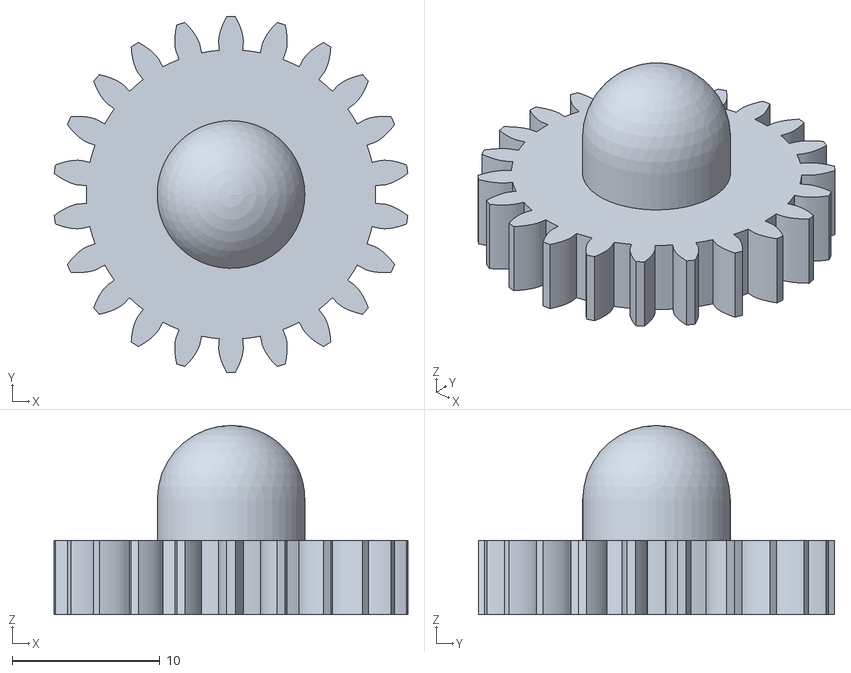
[picture p113: CAD file, 2026-09-07]
3d_model/freecad/out/byj_rack_print/Pinion.stl
23.9 x 24.1 x 12.8
