nguyenduchan/coutingmachine/3d_model/sim/meshes/rotary_linear/RL_Rail_Bridge.stl

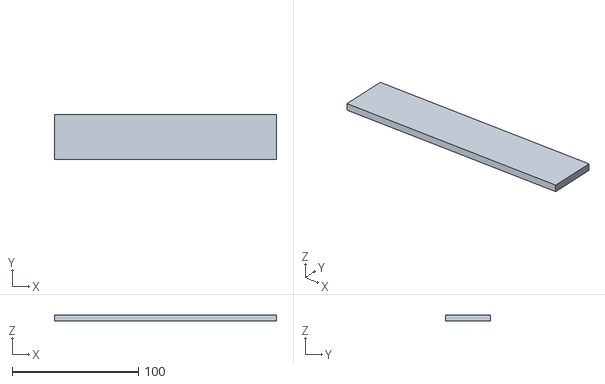
[picture p114: CAD file, 2026-08-03]
3d_model/sim/meshes/rotary_linear/RL_Rail_Bridge.stl
175.9 x 35.9 x 5.00
