nguyenduchan/coutingmachine/3d_model/sim/meshes/tube_l_exit/Width_Carriage.stl

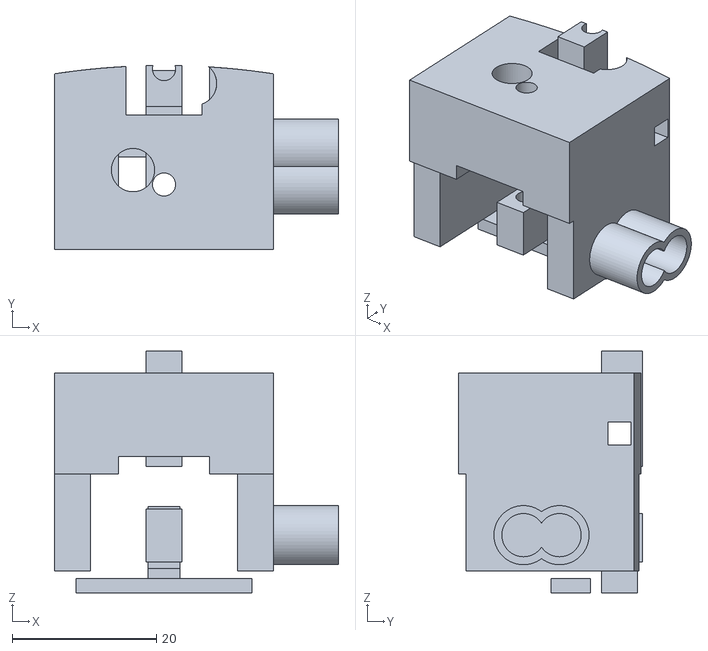
[picture p115: CAD file, 2026-08-13]
3d_model/sim/meshes/tube_l_exit/Width_Carriage.stl
39.4 x 25.5 x 33.5
