nguyenduchan/coutingmachine/3d_model/step_cq/bowl.step

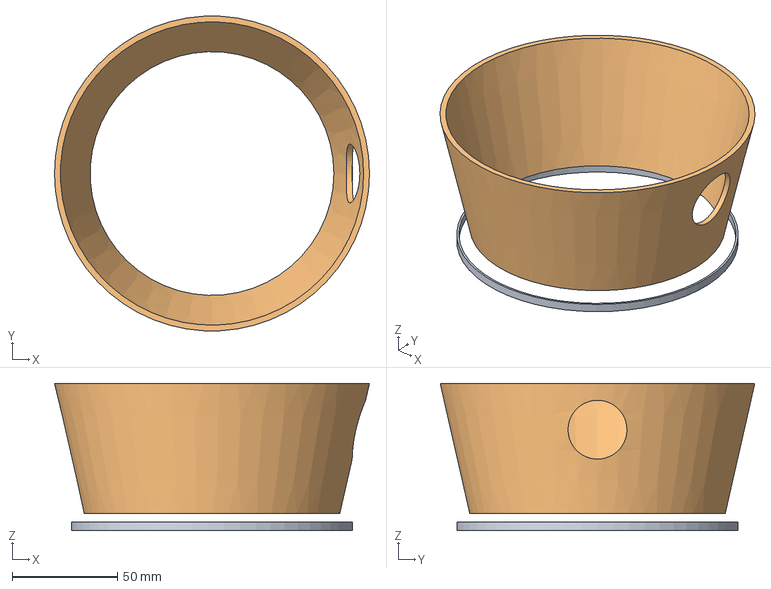
[picture p116: CAD file, 2026-07-28]
3d_model/step_cq/bowl.step
150.0 x 149.8 x 70.0 mm
