nguyenduchan/coutingmachine/3d_model/step_cq/fixed/outlet_ring.step

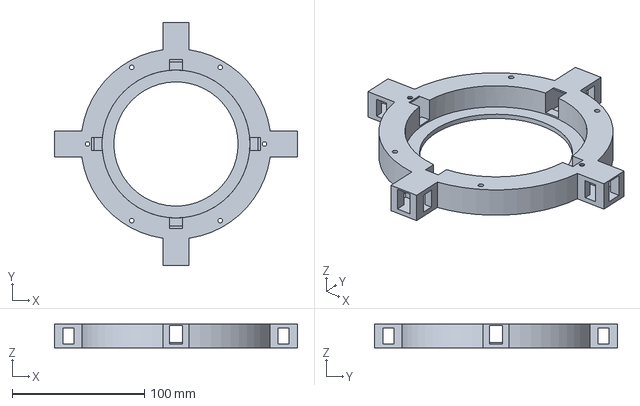
[picture p117: CAD file, 2026-07-28]
3d_model/step_cq/fixed/outlet_ring.step
184.0 x 184.0 x 18.0 mm
