nguyenduchan/coutingmachine/3d_model/freecad/out/tube_l_exit_gate_parts/Entry_Gate_Dial.FCStd

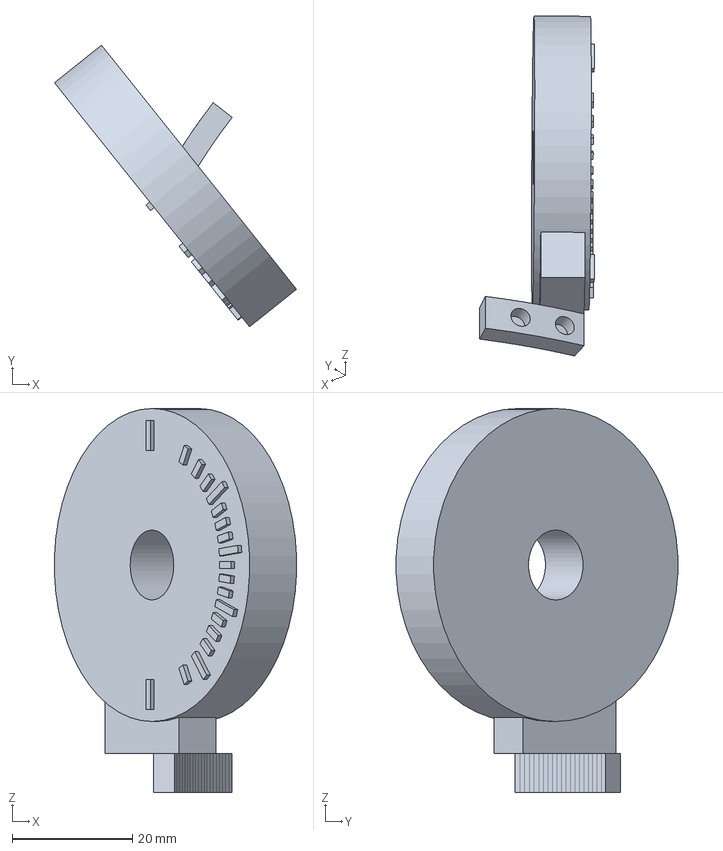
[picture p118: CAD file, 2026-08-18]
3d_model/freecad/out/tube_l_exit_gate_parts/Entry_Gate_Dial.FCStd
40.2 x 46.8 x 63.8 mm
