nguyenduchan/coutingmachine/3d_model/sim/meshes/tube_l_exit/Crossbar_Bridge.stl

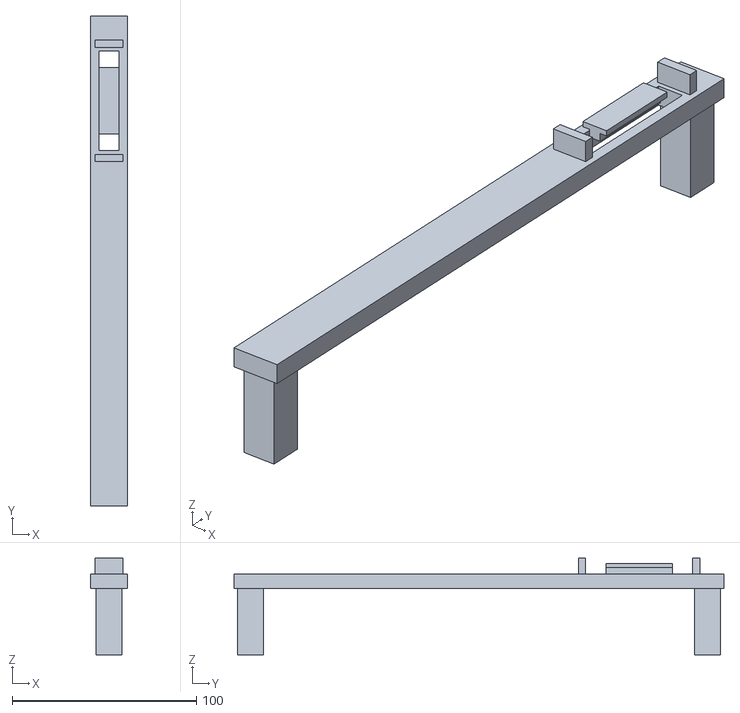
[picture p119: CAD file, 2026-08-13]
3d_model/sim/meshes/tube_l_exit/Crossbar_Bridge.stl
20.0 x 265.6 x 52.5
