nguyenduchan/coutingmachine/3d_model/freecad/out/tube_l_exit_gate_parts/Entry_Gate_Slider.FCStd

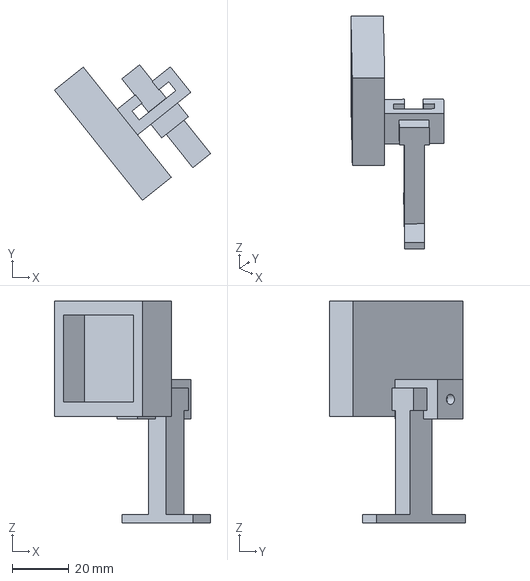
[picture p120: CAD file, 2026-08-18]
3d_model/freecad/out/tube_l_exit_gate_parts/Entry_Gate_Slider.FCStd
54.9 x 47.7 x 78.1 mm
