nguyenduchan/coutingmachine/3d_model/freecad/out/tube_l_exit_gate_parts/Exit_Cam.FCStd

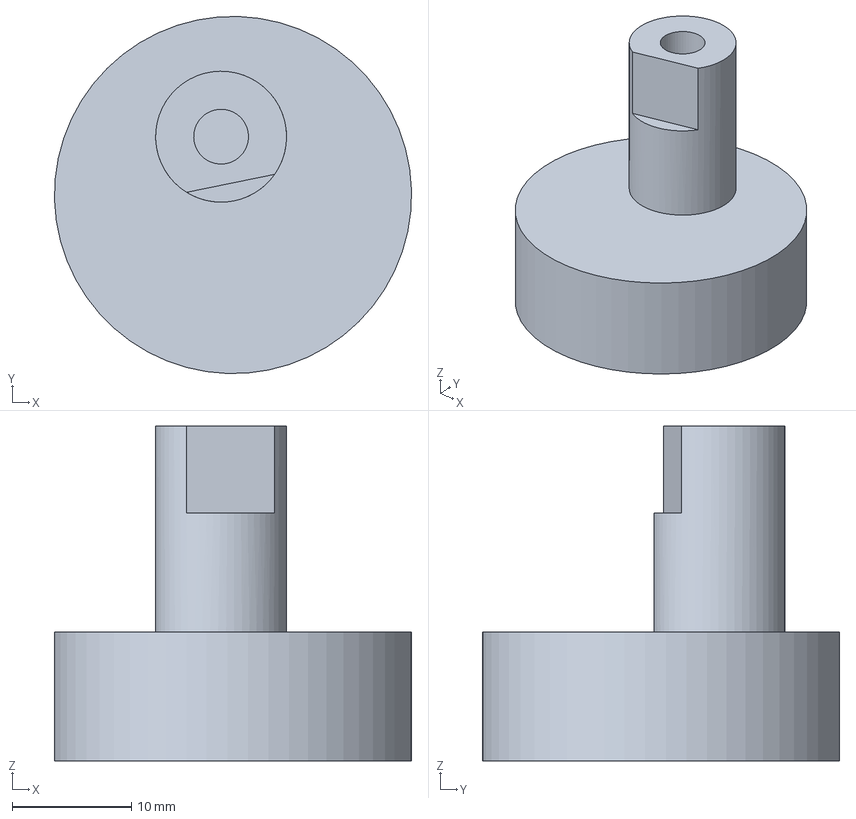
[picture p121: CAD file, 2026-08-18]
3d_model/freecad/out/tube_l_exit_gate_parts/Exit_Cam.FCStd
30.0 x 30.0 x 28.1 mm
