nguyenduchan/coutingmachine/3d_model/sim/meshes/tube_l_exit/Rotor_Disc.stl

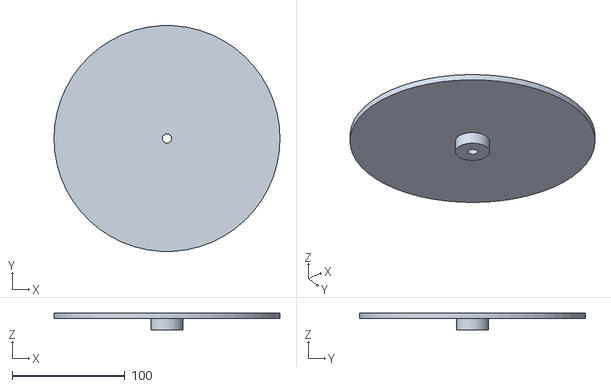
[picture p122: CAD file, 2026-08-13]
3d_model/sim/meshes/tube_l_exit/Rotor_Disc.stl
200.0 x 199.7 x 15.0
