nguyenduchan/coutingmachine/3d_model/freecad/out/tube_l_exit_gate_parts/Backlight_Panel.FCStd

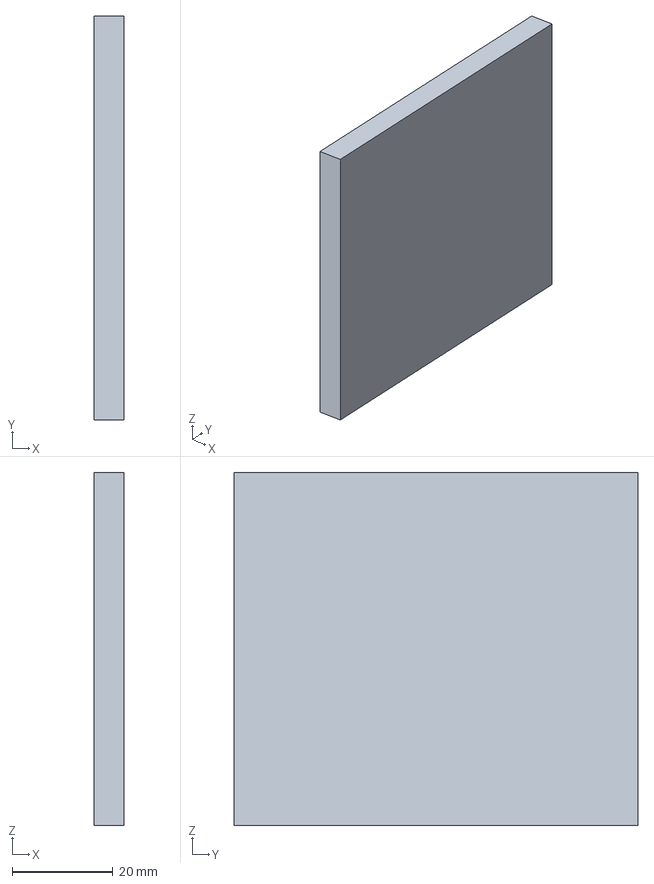
[picture p123: CAD file, 2026-08-18]
3d_model/freecad/out/tube_l_exit_gate_parts/Backlight_Panel.FCStd
6.00 x 80.0 x 70.0 mm
