nguyenduchan/coutingmachine/3d_model/sim/meshes/tube_l_exit/Spring_Width_Top_2.stl

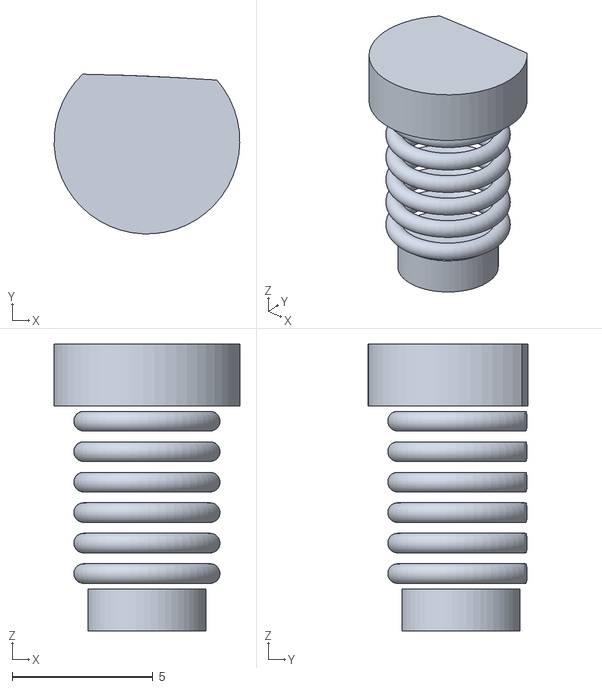
[picture p124: CAD file, 2026-08-13]
3d_model/sim/meshes/tube_l_exit/Spring_Width_Top_2.stl
6.59 x 5.68 x 10.2
