nguyenduchan/coutingmachine/3d_model/freecad/out/tube_l_exit_gate_parts/Exit_Camera.FCStd

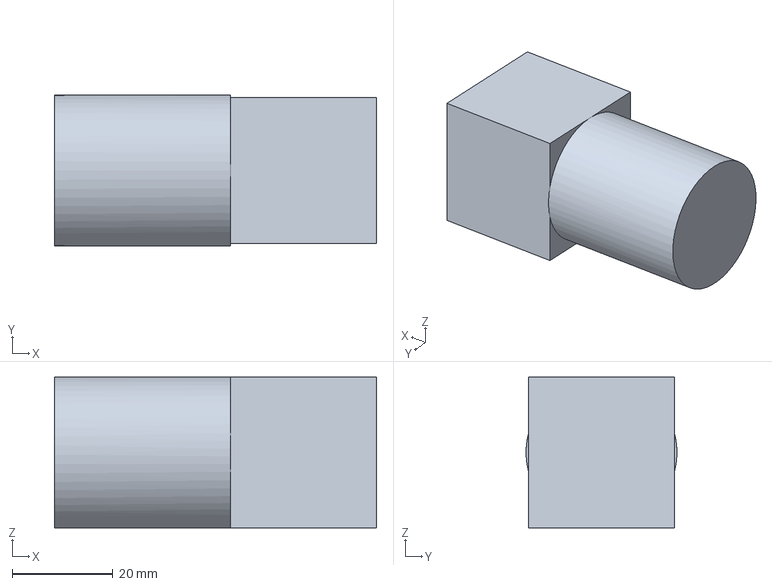
[picture p125: CAD file, 2026-08-18]
3d_model/freecad/out/tube_l_exit_gate_parts/Exit_Camera.FCStd
64.0 x 30.0 x 30.0 mm
