nguyenduchan/coutingmachine/3d_model/sim/meshes/tube_l_exit/Exit_Track.stl

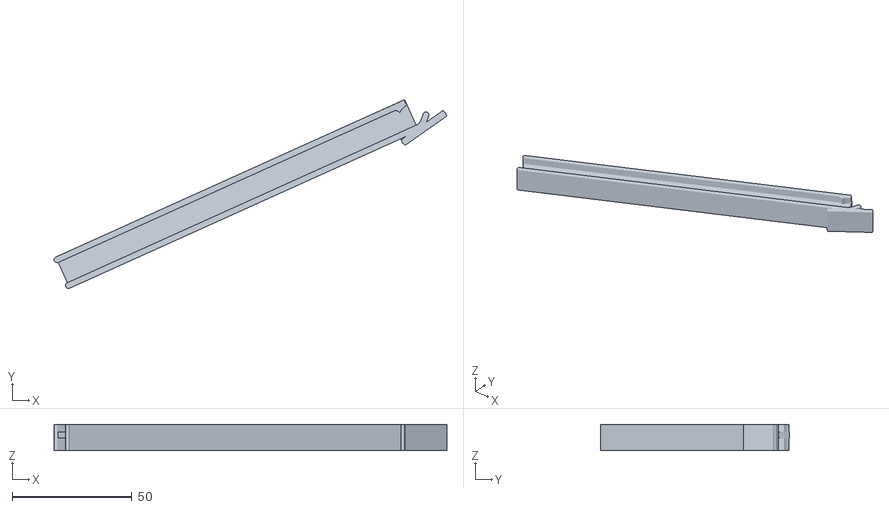
[picture p126: CAD file, 2026-08-13]
3d_model/sim/meshes/tube_l_exit/Exit_Track.stl
164.1 x 78.8 x 11.0
