nguyenduchan/coutingmachine/3d_model/freecad/out/tube_l_exit_gate_parts/Collection_Funnel.FCStd

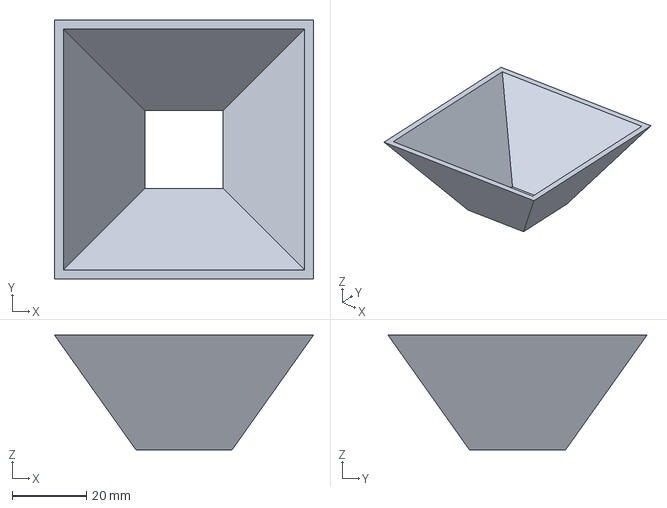
[picture p127: CAD file, 2026-08-18]
3d_model/freecad/out/tube_l_exit_gate_parts/Collection_Funnel.FCStd
70.0 x 70.0 x 31.0 mm
