nguyenduchan/coutingmachine/3d_model/freecad/out/tube_l_exit_gate_parts/Exit_Inner_Wall.FCStd

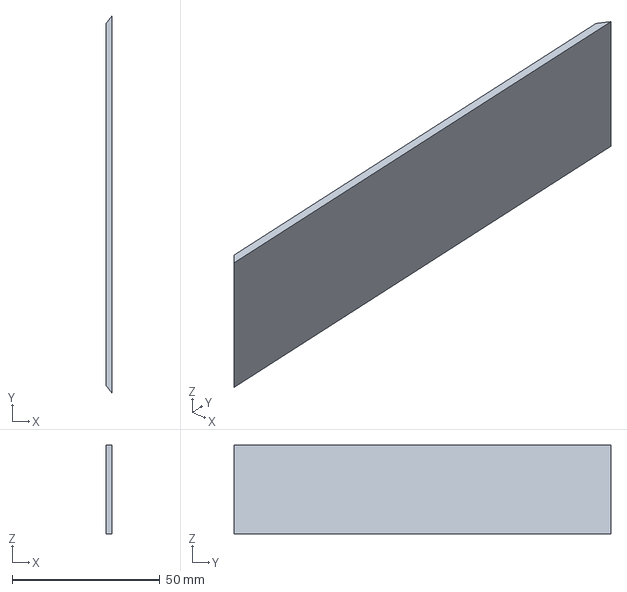
[picture p128: CAD file, 2026-08-18]
3d_model/freecad/out/tube_l_exit_gate_parts/Exit_Inner_Wall.FCStd
2.00 x 127.7 x 30.0 mm
