nguyenduchan/coutingmachine/3d_model/sim/meshes/tube_l_exit/Scale_Height.stl

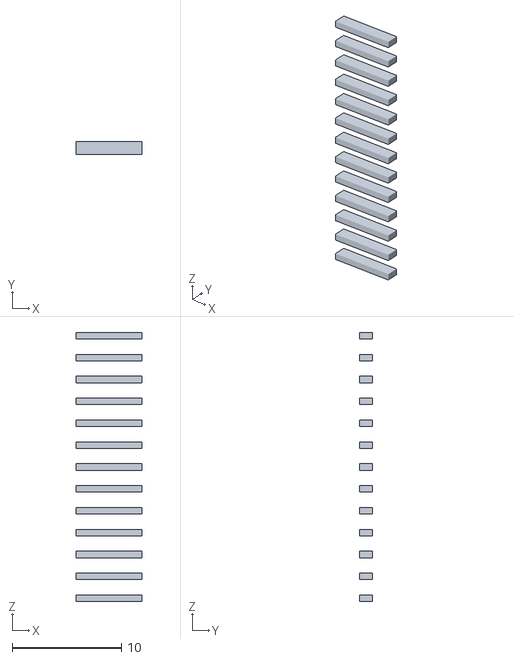
[picture p129: CAD file, 2026-08-13]
3d_model/sim/meshes/tube_l_exit/Scale_Height.stl
6.00 x 1.20 x 24.6
