nguyenduchan/coutingmachine/3d_model/freecad/out/tube_l_exit_gate_parts/Backlight_Mount.FCStd

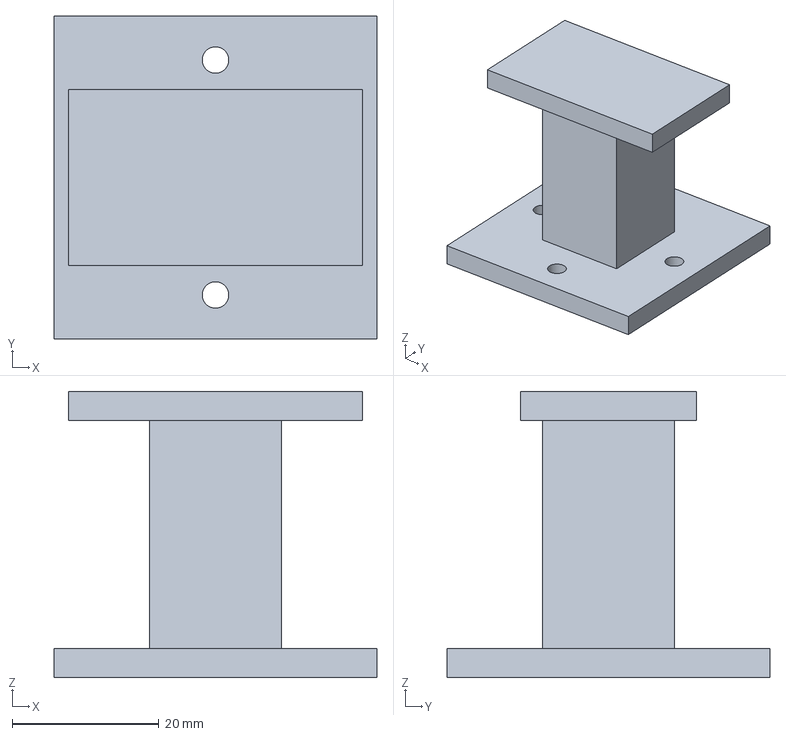
[picture p130: CAD file, 2026-08-18]
3d_model/freecad/out/tube_l_exit_gate_parts/Backlight_Mount.FCStd
44.0 x 44.0 x 39.0 mm
