nguyenduchan/coutingmachine/3d_model/sim/meshes/tube_l_exit/Bowl_Tube.stl

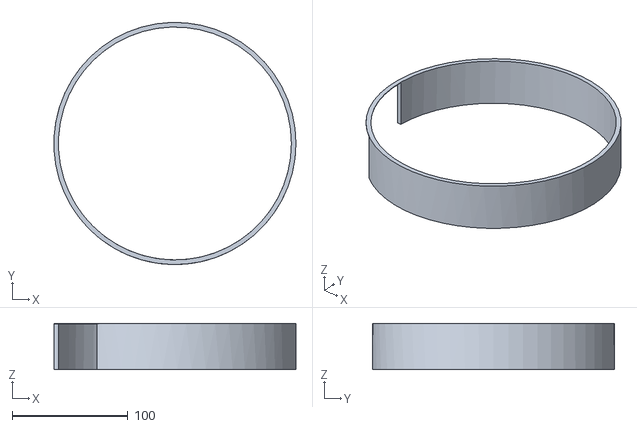
[picture p131: CAD file, 2026-08-13]
3d_model/sim/meshes/tube_l_exit/Bowl_Tube.stl
209.5 x 209.5 x 40.0
