nguyenduchan/coutingmachine/3d_model/freecad/out/tube_l_exit_gate_parts/Camera_Mount.FCStd

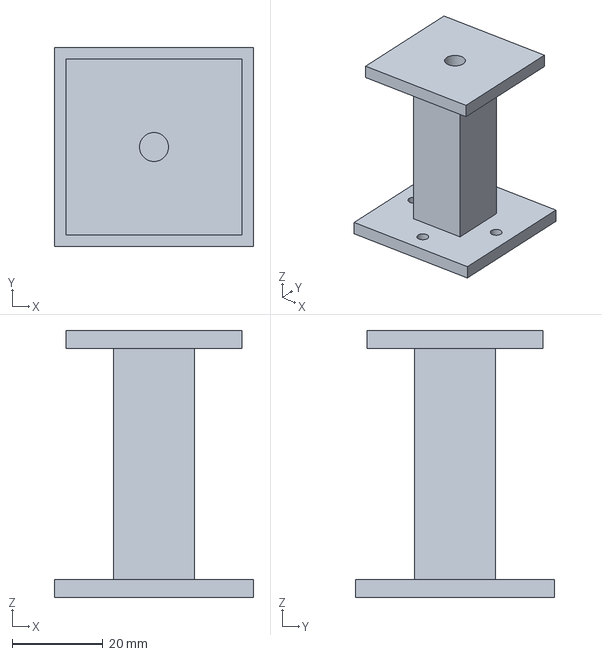
[picture p132: CAD file, 2026-08-18]
3d_model/freecad/out/tube_l_exit_gate_parts/Camera_Mount.FCStd
44.0 x 44.0 x 59.0 mm
