nguyenduchan/coutingmachine/3d_model/freecad/out/tube_l_exit_gate_parts/Hub_Body.FCStd

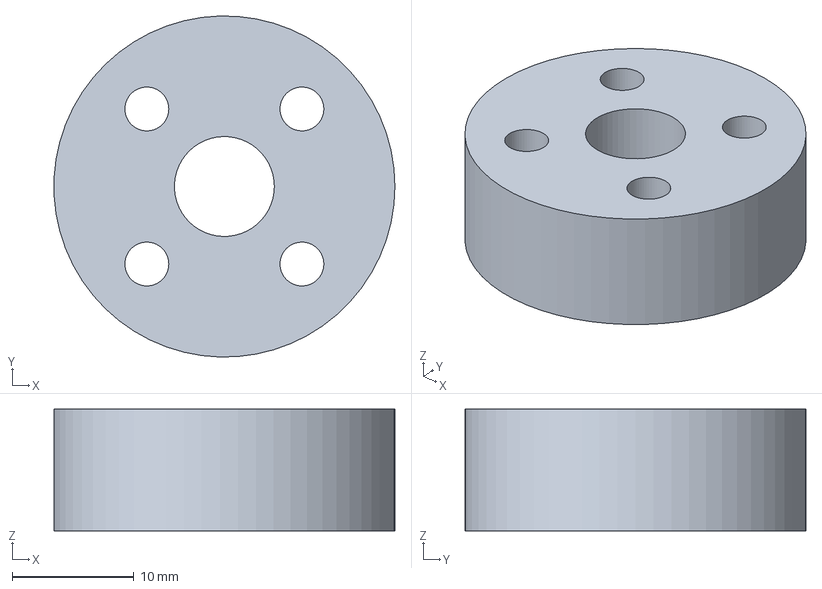
[picture p133: CAD file, 2026-08-18]
3d_model/freecad/out/tube_l_exit_gate_parts/Hub_Body.FCStd
28.0 x 28.0 x 10.0 mm
