nguyenduchan/coutingmachine/3d_model/sim/meshes/tube_l_exit/Inner_Lane_Rail.stl

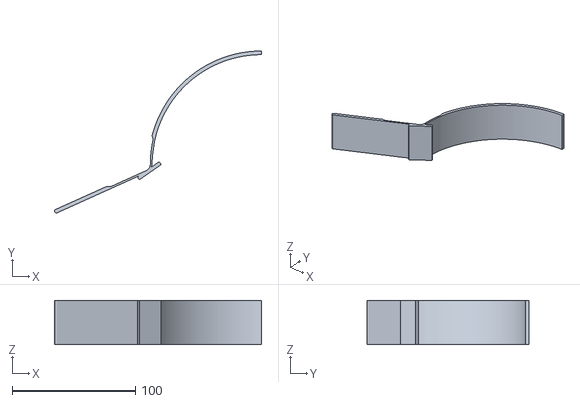
[picture p134: CAD file, 2026-08-13]
3d_model/sim/meshes/tube_l_exit/Inner_Lane_Rail.stl
168.2 x 131.6 x 36.0
