nguyenduchan/coutingmachine/3d_model/freecad/out/tube_l_exit_gate_parts/Entry_Gate_Barrier.FCStd

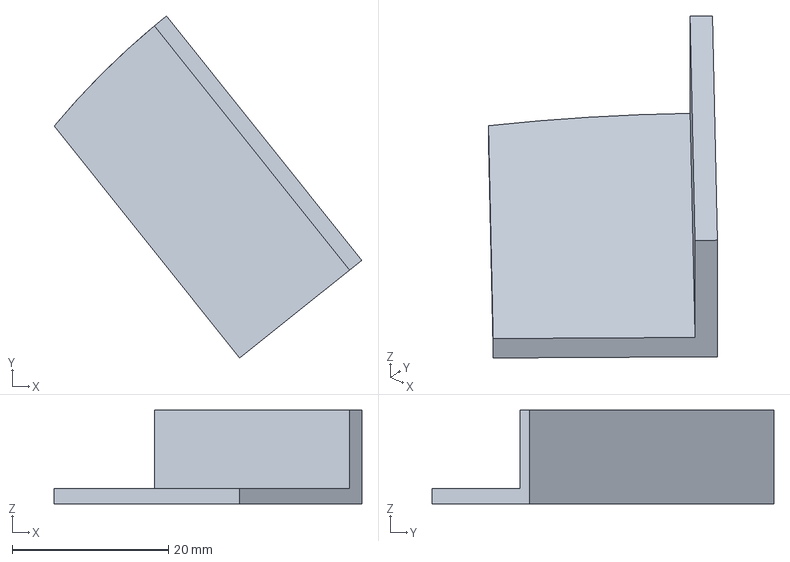
[picture p135: CAD file, 2026-08-18]
3d_model/freecad/out/tube_l_exit_gate_parts/Entry_Gate_Barrier.FCStd
39.3 x 43.7 x 12.0 mm
