nguyenduchan/coutingmachine/3d_model/freecad/out/tube_l_exit_gate_parts/Guide_System.FCStd

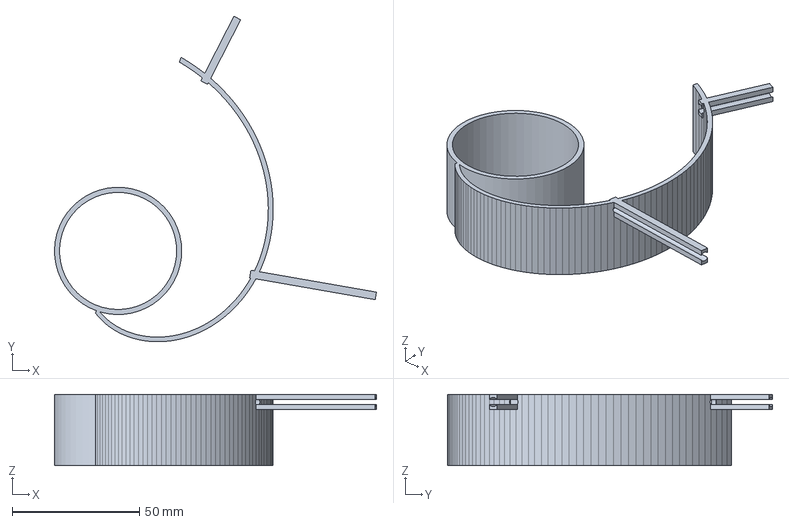
[picture p136: CAD file, 2026-08-18]
3d_model/freecad/out/tube_l_exit_gate_parts/Guide_System.FCStd
126.5 x 127.9 x 28.0 mm
