nguyenduchan/coutingmachine/3d_model/freecad/out/tube_l_exit_gate_parts/Rotor_Disc.FCStd

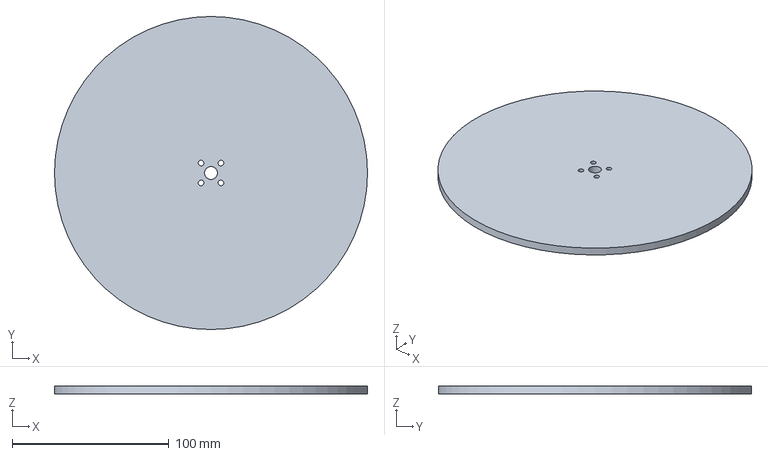
[picture p137: CAD file, 2026-08-18]
3d_model/freecad/out/tube_l_exit_gate_parts/Rotor_Disc.FCStd
200.0 x 200.0 x 5.00 mm
