nguyenduchan/coutingmachine/3d_model/export/brush_arm.scad

use <../screw_rotary_feeder.scad>
brush_arm();
