nguyenduchan/coutingmachine/3d_model/export/drive_hub.scad

use <../screw_rotary_feeder.scad>
drive_hub();
