nguyenduchan/coutingmachine/3d_model/export_assembly.scad

use <screw_rotary_feeder.scad>
assembly(0, true, 0);
