nguyenduchan/coutingmachine/3d_model/export_assembly_noscrews.scad

use <screw_rotary_feeder.scad>
assembly(0, false, 0);
