nguyenduchan/coutingmachine/3d_model/export_exploded.scad

use <screw_rotary_feeder.scad>
assembly(1, true, 15);
