nguyenduchan/coutingmachine/3d_model/export/base_plate.scad

use <../screw_rotary_feeder.scad>
base_plate();
