nguyenduchan/coutingmachine/3d_model/export/cover.scad

use <../screw_rotary_feeder.scad>
cover();
