nguyenduchan/coutingmachine/3d_model/export/hopper.scad

use <../screw_rotary_feeder.scad>
hopper();
