nguyenduchan/coutingmachine/3d_model/export/outlet_chute.scad

use <../screw_rotary_feeder.scad>
outlet_chute();
