nguyenduchan/coutingmachine/3d_model/export/rotary_disc.scad

use <../screw_rotary_feeder.scad>
rotary_disc();
