nguyenduchan/coutingmachine/(list of files, cad)

Other CAD files:
3d_model/freecad/out/byj_rack_print/Guide_Rod_Cap_B.stl
3d_model/sim/meshes/tube_l_exit/Spring_Width_Jaw_2.stl
3d_model/stl/cover.stl
3d_model/sim/meshes/rotary_linear/RL_Bearing_Cap_N.stl
3d_model/sim/meshes/tube_l_exit/Spring_Width_Jaw_1.stl
3d_model/step_cq/brush_arm.step
3d_model/step_cq/step_alt/moving/cam_B.step
3d_model/freecad/out/byj_rack_print/Guide_Rod_A.stl
3d_model/sim/meshes/rotary_linear/RL_Bearing_Rail_S.stl
3d_model/freecad/out/tube_l_exit_gate_parts/tube_l_exit_gate.FCStd
3d_model/sim/meshes/tube_l_exit/Spring_Width_Top_1.stl
3d_model/sim/meshes/tube_l_exit/Spring_Height_1.stl
3d_model/freecad/out/n20_leadscrew_stage.FCStd
3d_model/freecad/out/out/n20_leadscrew_stage.FCStd
3d_model/sim/meshes/rotary_linear/RL_Friction_Washer.stl
3d_model/sim/meshes/tube_l_exit/Screw_Height.stl
3d_model/sim/meshes/tube_l_exit/Screw_Width_1.stl
3d_model/sim/meshes/tube_l_exit/Screw_Width_2.stl
3d_model/stl_cq/assembly_exploded.stl
3d_model/stl_cq/assembly_reference.stl
3d_model/stl_cq/assembly_spiral_reference.stl
3d_model/stl_cq/base_plate.stl
3d_model/stl_cq/bowl.stl
3d_model/stl_cq/brush_arm.stl
3d_model/stl_cq/cover.stl
3d_model/stl_cq/drive_hub.stl
3d_model/stl_cq/fixed/base.stl
3d_model/stl_cq/fixed/bowl.stl
3d_model/stl_cq/fixed/frame_riser.stl
3d_model/stl_cq/fixed/lid.stl
3d_model/stl_cq/fixed/motor_clamp.stl
3d_model/stl_cq/fixed/outlet_chute.stl
3d_model/stl_cq/fixed/outlet_ring.stl
3d_model/stl_cq/fixed/rim_rail_gate.stl
3d_model/stl_cq/fixed/spiral_track.stl
3d_model/stl_cq/moving/conical_disc.stl
3d_model/stl_cq/moving/drive_hub.stl
3d_model/stl_cq/moving/rotor_grooved.stl
3d_model/stl_cq/moving/rotor_spiral.stl
3d_model/stl_cq/moving/shaft_collar.stl
3d_model/stl_cq/outlet_chute.stl
3d_model/stl_cq/reference/geared_motor_GB37_24V.stl
3d_model/stl_cq/rotary_disc.stl
3d_model/stl_cq/step_alt/fixed/base.stl
3d_model/stl_cq/step_alt/fixed/funnel_V.stl
3d_model/stl_cq/step_alt/fixed/guide_rod.stl
3d_model/stl_cq/step_alt/fixed/hopper.stl
3d_model/stl_cq/step_alt/fixed/motor_clamp.stl
3d_model/stl_cq/step_alt/fixed/rail.stl
3d_model/stl_cq/step_alt/moving/cam_A.stl
3d_model/stl_cq/step_alt/moving/cam_B.stl
3d_model/stl_cq/step_alt/moving/drive_hub.stl
3d_model/stl_cq/step_alt/moving/follower_pin.stl
3d_model/stl_cq/step_alt/moving/yoke_group_A.stl
3d_model/stl_cq/step_alt/moving/yoke_group_B.stl
3d_model/stl_cq/step_feeder/assembly_reference.stl
3d_model/stl_cq/step_feeder/fixed/base.stl
3d_model/stl_cq/step_feeder/fixed/fixed_steps.stl
3d_model/stl_cq/step_feeder/fixed/guide_rod.stl
3d_model/stl_cq/step_feeder/fixed/hopper.stl
3d_model/stl_cq/step_feeder/fixed/lid.stl
3d_model/stl_cq/step_feeder/fixed/motor_clamp.stl
3d_model/stl_cq/step_feeder/fixed/orientation_rail.stl
3d_model/stl_cq/step_feeder/fixed/outlet_chute.stl
3d_model/stl_cq/step_feeder/moving/cam.stl
3d_model/stl_cq/step_feeder/moving/drive_hub.stl
3d_model/stl_cq/step_feeder/moving/move_plates.stl
