nguyenduchan/coutingmachine/3d_model/out/classic_assembled_side.png

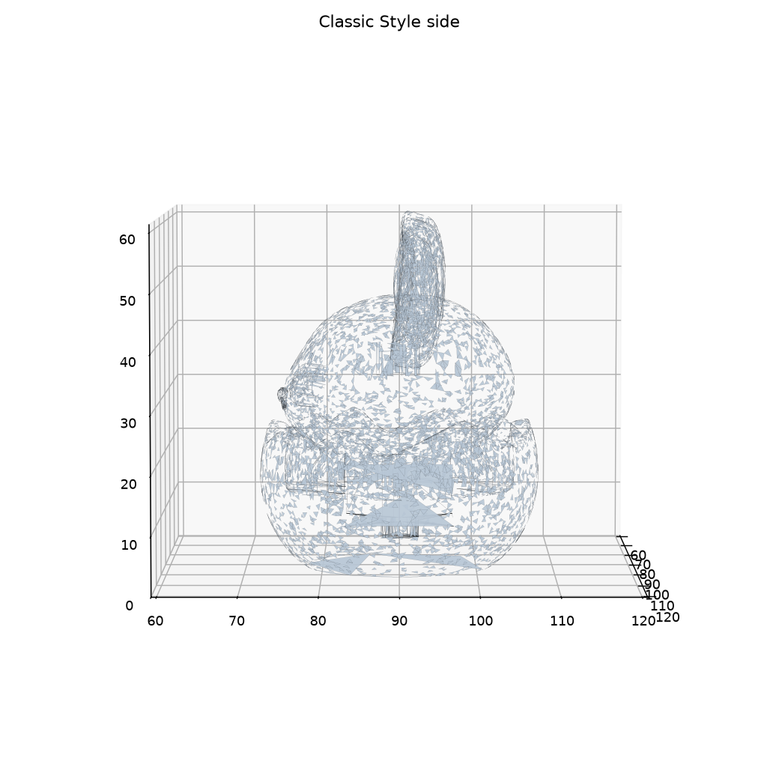
3d_model/out/classic_assembled_side.png
