nguyenduchan/coutingmachine/3d_model/out/classic_assembled_top.png

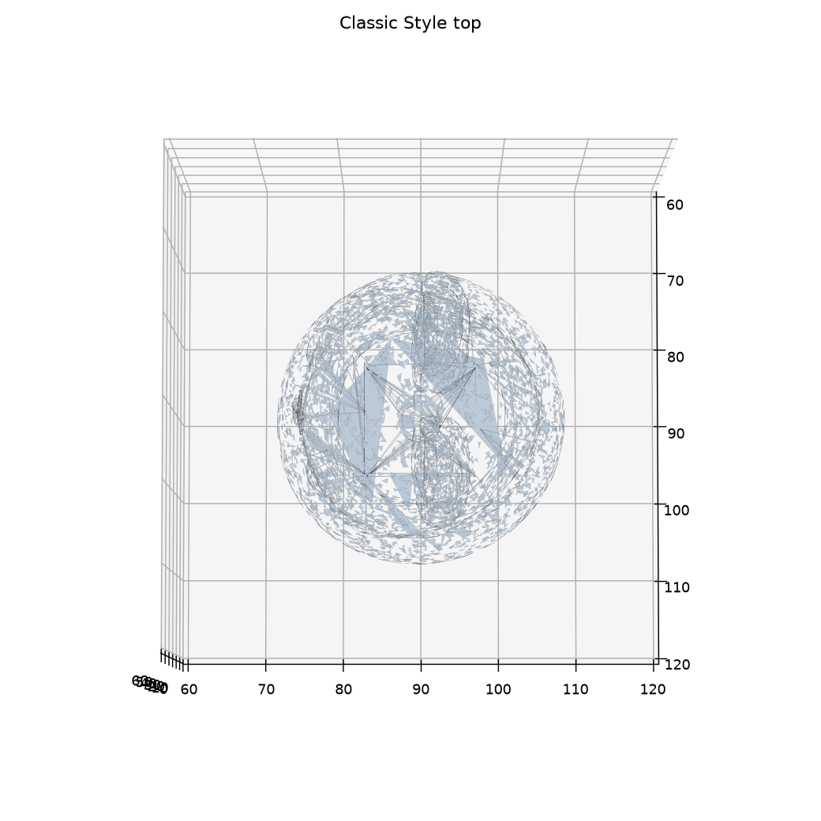
3d_model/out/classic_assembled_top.png
