nguyenduchan/coutingmachine/3d_model/freecad/out/verify_log2.txt

freecadcmd.exe : Traceback (most recent call last):
At C:\Users\Admin\AppData\Local\Temp\ps-script-bff75b0d-c152-4d05-8e4c-8d7ed4e4eb87.ps1:80 char:68
+ ... adcmd.exe"; & $fc -c "exec(open(r'c:\workspace\embedded\CountingMachi ...
+                 ~~~~~~~~~~~~~~~~~~~~~~~~~~~~~~~~~~~~~~~~~~~~~~~~~~~~~~~~~
    + CategoryInfo          : NotSpecified: (Traceback (most recent call last)::String) [], RemoteException
    + FullyQualifiedErrorId : NativeCommandError
 
  File "<string>", line 1, in <module>
  File "<string>", line 8, in <module>
<class 'NameError'>: name '__file__' is not defined
