nguyenduchan/coutingmachine/3d_model/freecad/out/verify_log.txt

FreeCAD 1.1.3, Libs: 1.1.3R20260725 (Git shallow)
(C) 2001-2026 FreeCAD contributors
FreeCAD is free and open-source software licensed under the terms of LGPL2+ license.
