nguyenduchan/coutingmachine/3d_model/freecad/_build_log.txt

freecadcmd.exe : Exception while processing file: d:/Project/coutingmachine/3d_model/freecad/show_jgb37_gui.py 
['charmap' codec can't encode character '\u2192' in position 48: character maps to <undefined>]
At C:\Users\duchan.nguyen\AppData\Local\Temp\ps-script-e4d4c88c-114c-4418-b69a-ba6d0bc51569.ps1:91 char:1
+ & "$env:LOCALAPPDATA\Programs\FreeCAD 1.1\bin\freecadcmd.exe" "d:\Pro ...
+ ~~~~~~~~~~~~~~~~~~~~~~~~~~~~~~~~~~~~~~~~~~~~~~~~~~~~~~~~~~~~~~~~~~~~~
    + CategoryInfo          : NotSpecified: (Exception while...to <undefined>]:String) [], RemoteException
    + FullyQualifiedErrorId : NativeCommandError
 
Captured state from FCStd on disk: 277 objects
Outer_guide split: Floor + 36 wall sectors @ 10░ (full circle)
Gap_Lining_Up: drive box clearance-swept | rack free stroke 20mm | M1.5 ARC_C=(-24.0,0.0)
Captured state from FCStd on disk: 277 objects
Outer_guide split: Floor + 36 wall sectors @ 10░ (full circle)
Gap_Lining_Up: drive box clearance-swept | rack free stroke 20mm | M1.5 ARC_C=(-24.0,0.0)
FreeCAD 1.1.3, Libs: 1.1.3R20260725 (Git shallow)
(C) 2001-2026 FreeCAD contributors
FreeCAD is free and open-source software licensed under the terms of LGPL2+ license.
