nguyenduchan/coutingmachine/pcb/STM32G030C8T6/STM32G030C8T6.kicad_pcb

## KiCad design pcb/STM32G030C8T6/STM32G030C8T6.kicad_pcb (2026-09-22)

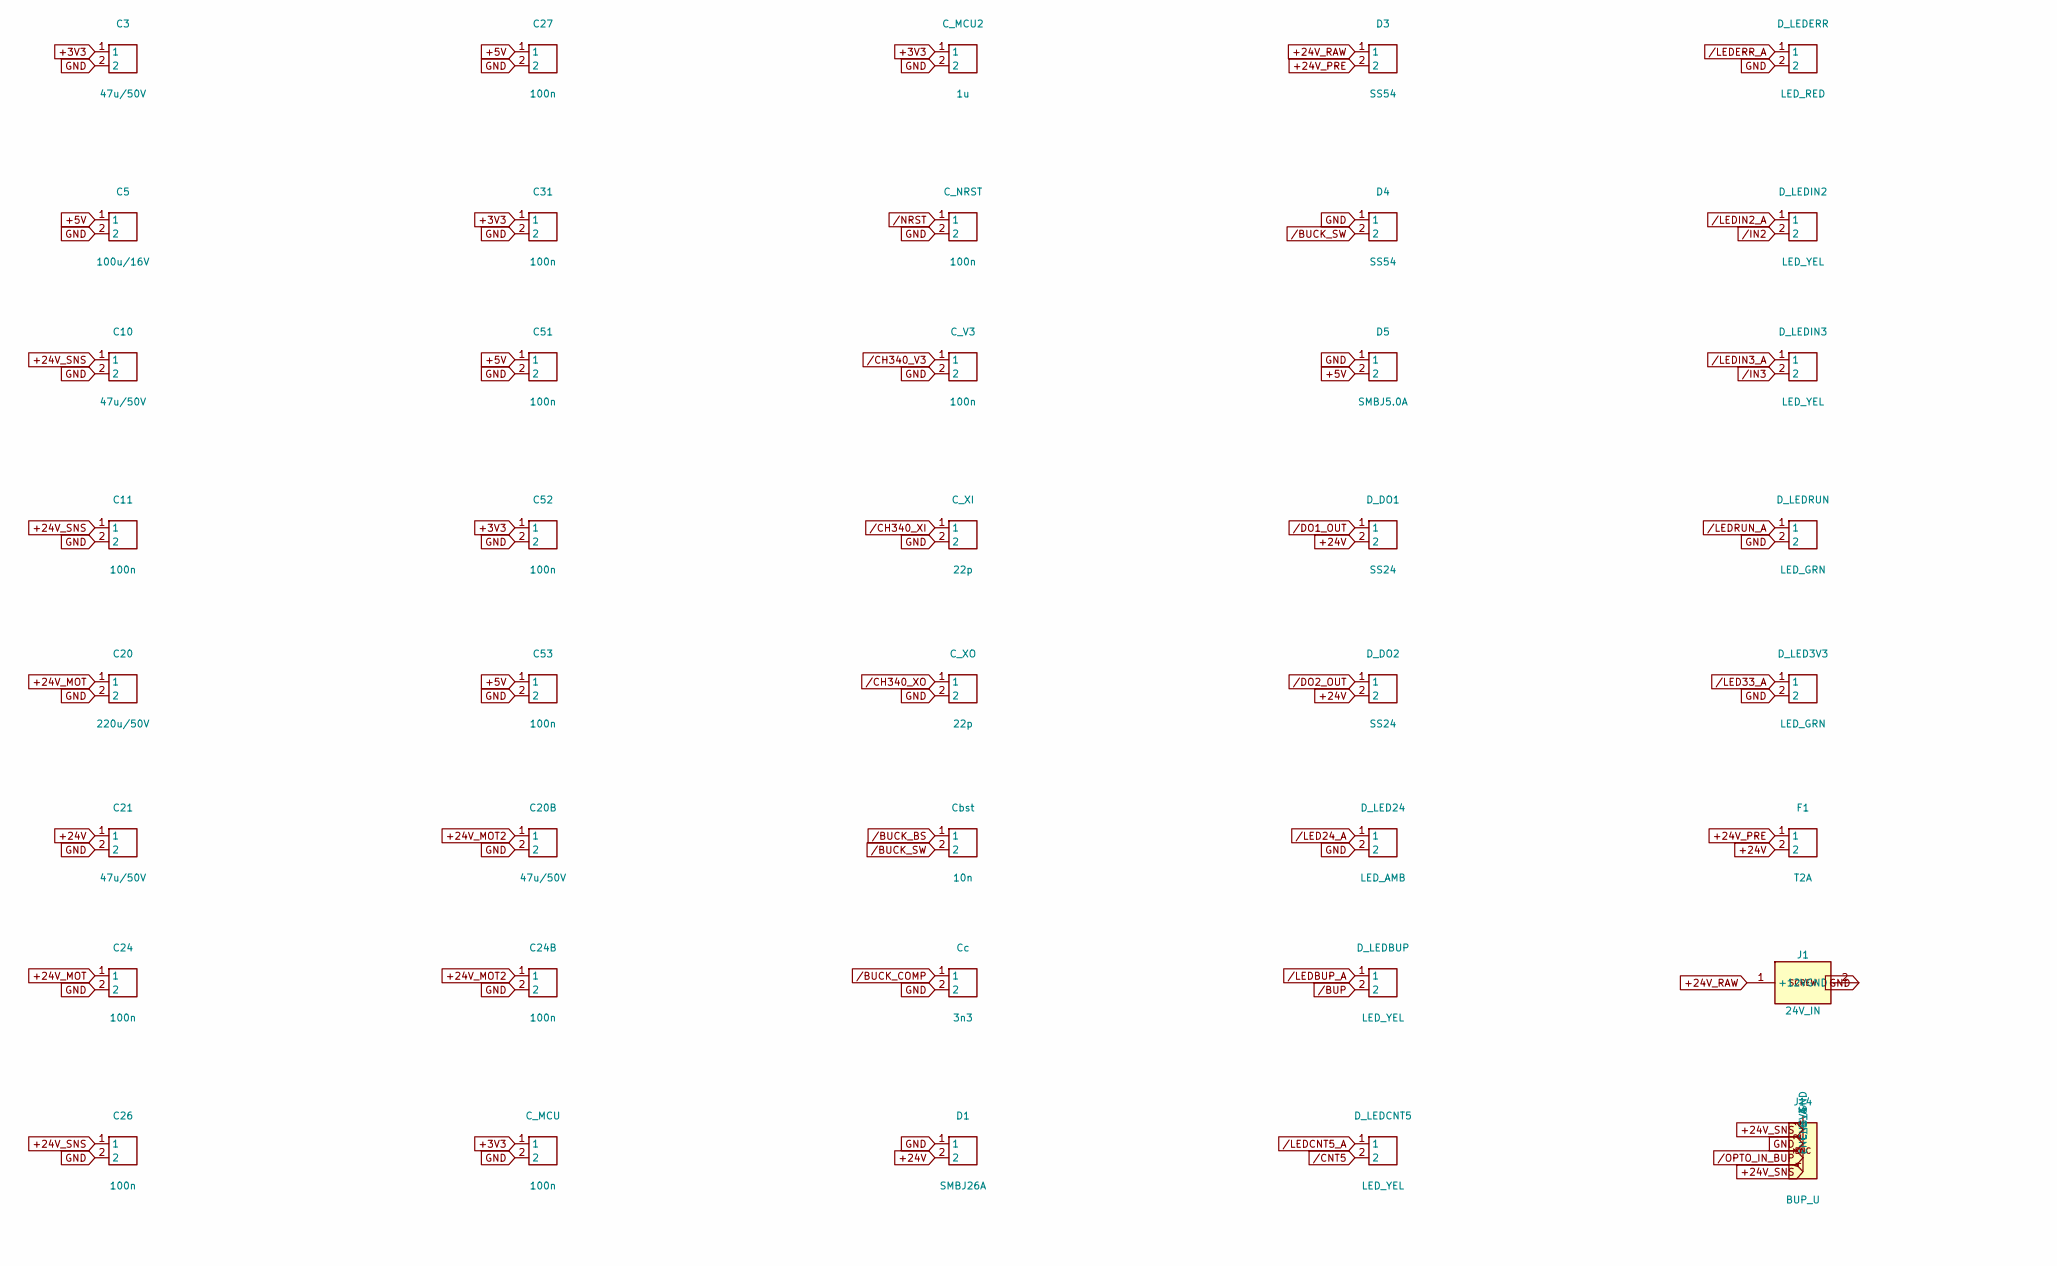
[picture p140: schematic STM32G030C8T6.kicad_sch, part in row 1, column 1]

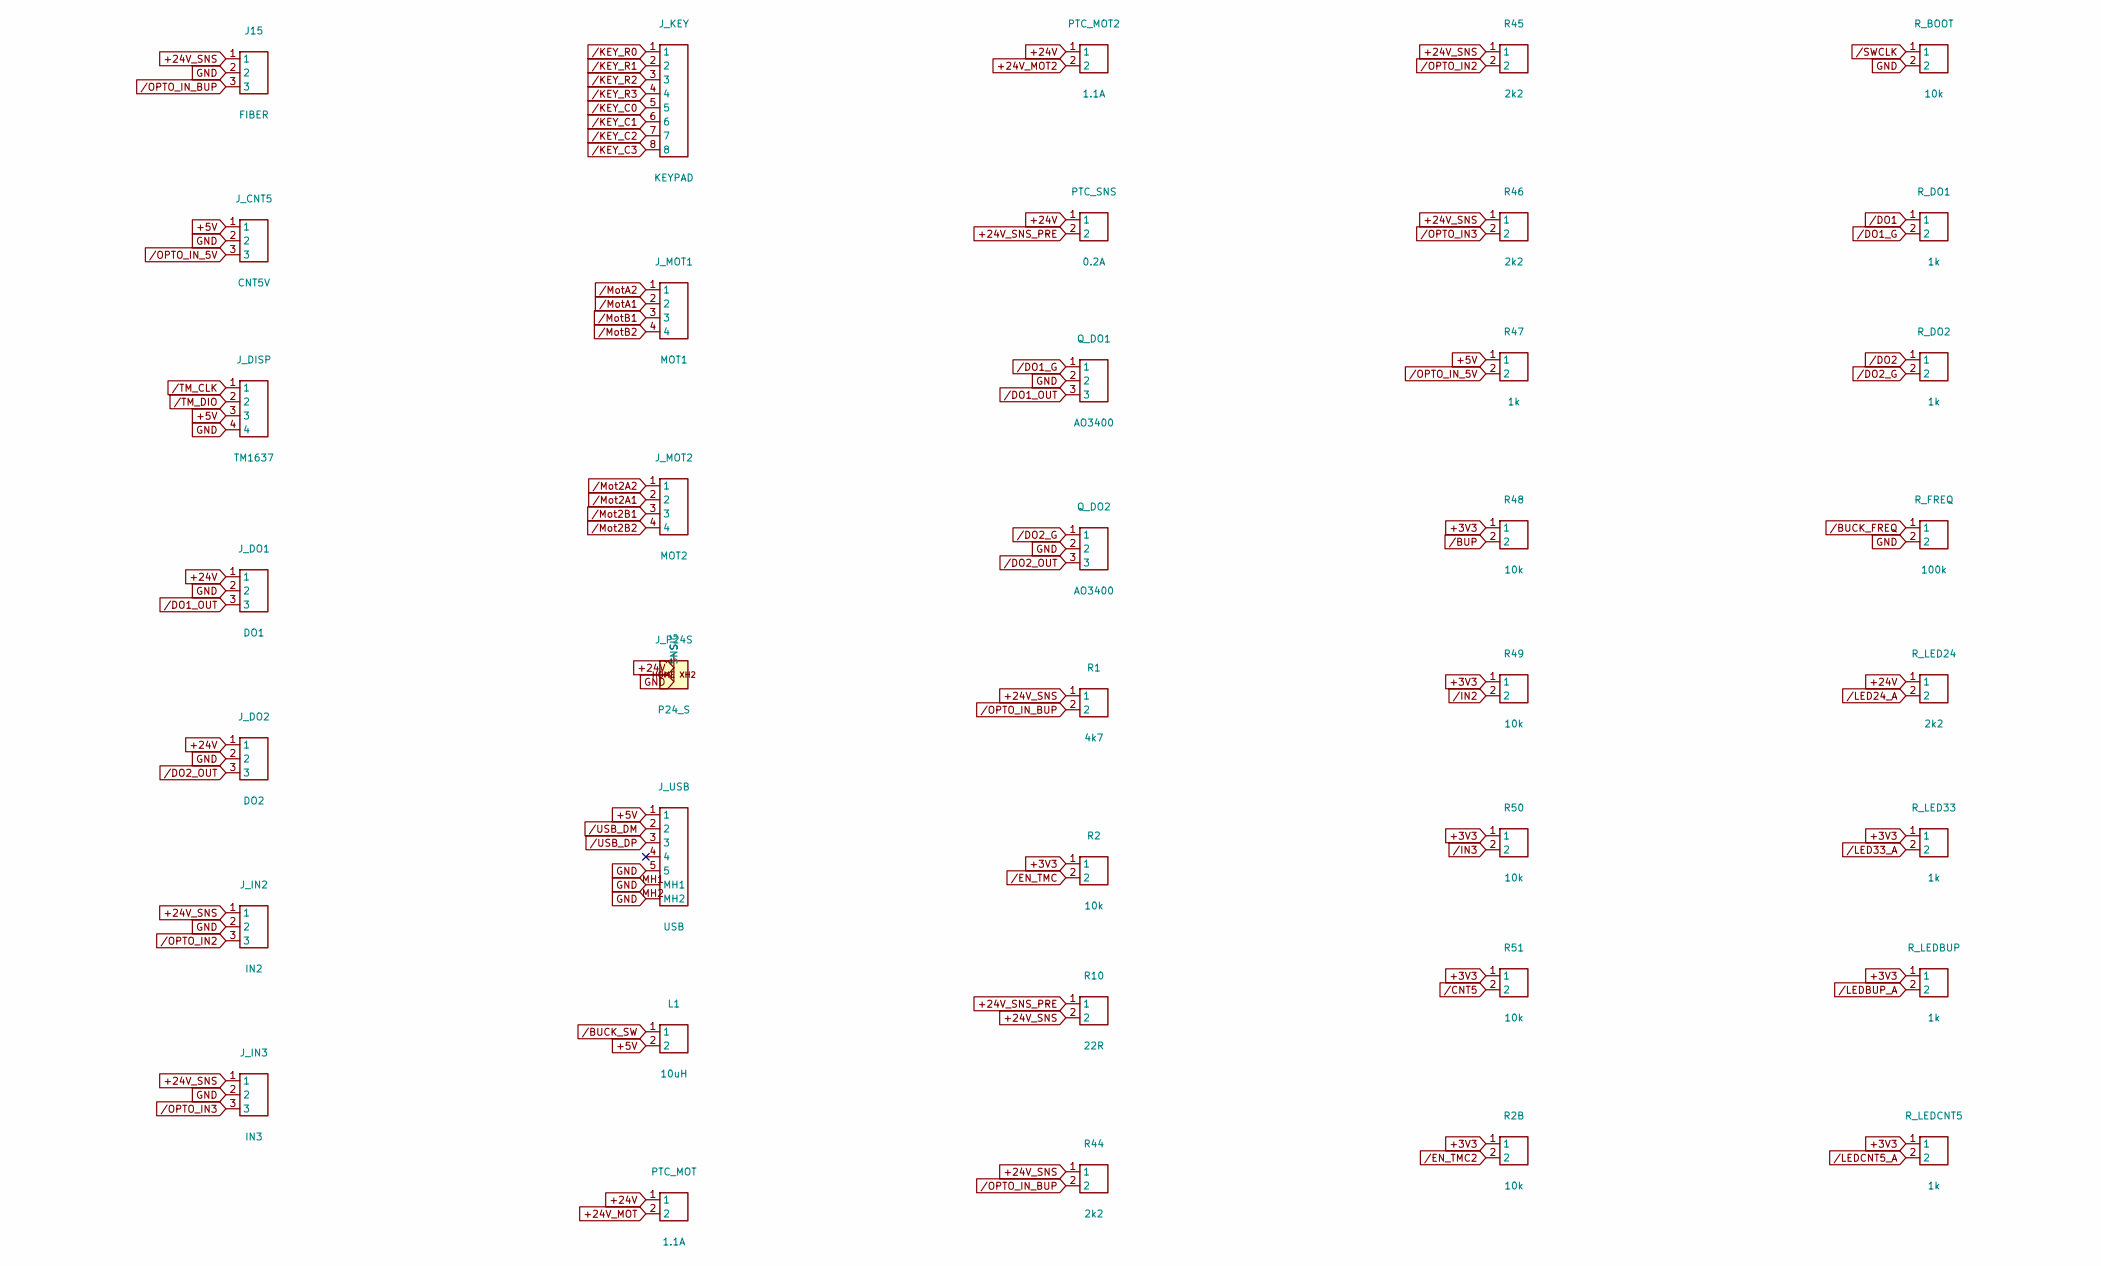
[picture p141: schematic STM32G030C8T6.kicad_sch, part in row 1, column 2]

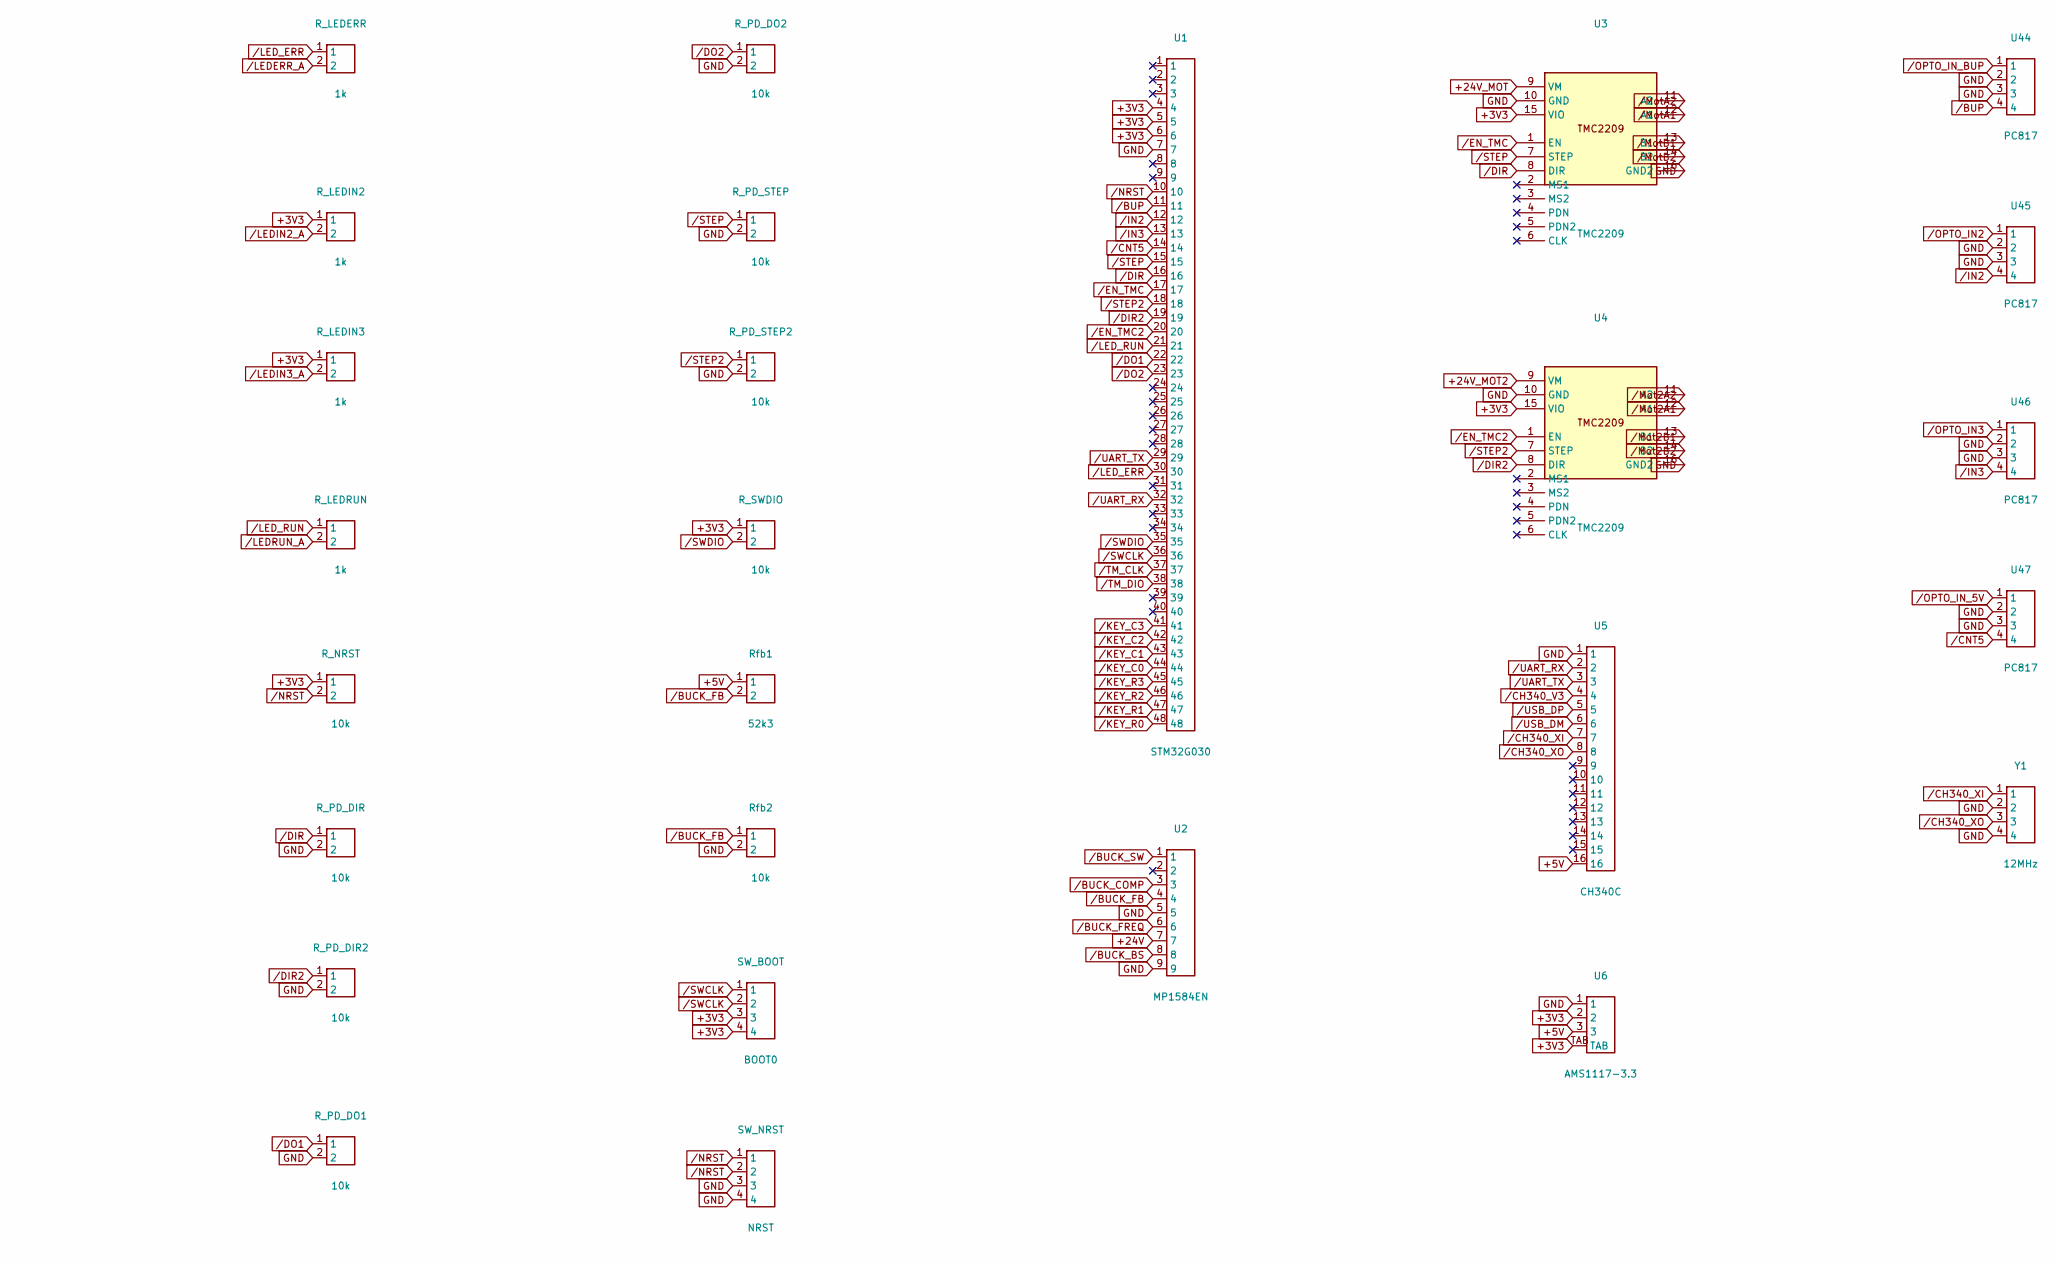
[picture p142: schematic STM32G030C8T6.kicad_sch, part in row 1, column 3]

Parts:
C3, C10, C20B, C21: 47u/50V; CP_SMD_D6.3x8
C5: 100u/16V; CP_SMD_D6.3x5.8
C11, C24, C24B, C26, C27, C31, C51, C52, C53: 100n; C_0805_100n
C20: 220u/50V; CP_SMD_D8x10
C_MCU: 100n; C_0805_100n
C_MCU2: 1u; C_0805
C_NRST: 100n; C_0805_100n
C_V3: 100n; C_0805_100n
C_XI: 22p; C_0805
C_XO: 22p; C_0805
Cbst: 10n; C_0805
Cc: 3n3; C_0805
D1: SMBJ26A; Diode_SMB_TVS
D3, D4: SS54; Diode_SMA
D5: SMBJ5.0A; Diode_SMB_TVS
D_DO1, D_DO2: SS24; Diode_SMA
D_LED3V3: LED_GRN; LED_0805
D_LED24: LED_AMB; LED_0805
D_LEDBUP: LED_YEL; LED_0805
D_LEDCNT5: LED_YEL; LED_0805
D_LEDERR: LED_RED; LED_0805
D_LEDIN2, D_LEDIN3: LED_YEL; LED_0805
D_LEDRUN: LED_GRN; LED_0805
F1: T2A; Fuse_Holder_5x20_Open
J1: 24V_IN; TerminalBlock_2P_5.0mm
J14: BUP_U; JST_XH_04_Socket
J15: FIBER; JST_XH_03_Socket
J_CNT5: CNT5V; JST_XH_03_Socket
J_DISP: TM1637; Disp_XH_04_Socket
J_DO1: DO1; JST_XH_03_Socket
J_DO2: DO2; JST_XH_03_Socket
J_IN2: IN2; JST_XH_03_Socket
J_IN3: IN3; JST_XH_03_Socket
J_KEY: KEYPAD; PinHeader_1x08_Keypad
J_MOT1: MOT1; Mot_XH_04_Socket
J_MOT2: MOT2; Mot_XH_04_Socket
J_P24S: P24_S; JST_XH_02_Socket
J_USB: USB; USB_MicroB
L1: 10uH; L_SMD_6x6
PTC_MOT, PTC_MOT2: 1.1A; PTC_1812
PTC_SNS: 0.2A; PTC_1812
Q_DO1, Q_DO2: AO3400; MOSFET_SOT23
R1: 4k7; R_0805_4k7
R2, R2B, R48, R49, R50, R51: 10k; R_0805_10k
R10: 22R; R_1206_22R
R44, R45, R46: 2k2; R_0805_2k2
R47: 1k; R_0805_1k
R_BOOT: 10k; R_0805_10k
R_DO1, R_DO2: 1k; R_0805_1k
R_FREQ: 100k; R_0805_100k
R_LED24: 2k2; R_0805_2k2
R_LED33: 1k; R_0805_1k
R_LEDBUP: 1k; R_0805_1k
R_LEDCNT5: 1k; R_0805_1k
R_LEDERR: 1k; R_0805_1k
R_LEDIN2, R_LEDIN3: 1k; R_0805_1k
R_LEDRUN: 1k; R_0805_1k
R_NRST: 10k; R_0805_10k
R_PD_DIR, R_PD_DIR2: 10k; R_0805_10k
R_PD_DO1, R_PD_DO2: 10k; R_0805_10k
R_PD_STEP, R_PD_STEP2: 10k; R_0805_10k
R_SWDIO: 10k; R_0805_10k
Rfb1: 52k3; R_0805_4k7
Rfb2: 10k; R_0805_10k
SW_BOOT: BOOT0; SW_Push_6mm_SMD
SW_NRST: NRST; SW_Push_6mm_SMD
U1: STM32G030; STM32G030C8T6_LQFP48
U2: MP1584EN; MP1584EN_SOIC-8-EP
U3, U4: TMC2209; TMC2209_StepStick
U5: CH340C
U6: AMS1117-3.3; AMS1117_SOT223
U44, U45, U46, U47: PC817; PC817_SOP4
Y1: 12MHz; Crystal_SMD_3225

Connections:
+3V3: C3.1, C31.1, C52.1, C_MCU.1, C_MCU2.1, R2.1, R2B.1, R48.1, R49.1, R50.1, R51.1, R_LED33.1, R_LEDBUP.1, R_LEDCNT5.1, R_LEDIN2.1, R_LEDIN3.1, R_NRST.1, R_SWDIO.1, SW_BOOT.3, SW_BOOT.4, U1.4, U1.5, U1.6, U3.15 (VIO), U4.15 (VIO), U6.2, U6.TAB
+5V: C5.1, C27.1, C51.1, C53.1, D5.2, J_CNT5.1, J_DISP.3, J_USB.1, L1.2, R47.1, Rfb1.1, U5.16, U6.3
+24V: C21.1, D1.2, D_DO1.2, D_DO2.2, F1.2, J_DO1.1, J_DO2.1, J_P24S.1 (SIG), PTC_MOT.1, PTC_MOT2.1, PTC_SNS.1, R_LED24.1, U2.7
+24V_MOT: C20.1, C24.1, PTC_MOT.2, U3.9 (VM)
+24V_MOT2: C20B.1, C24B.1, PTC_MOT2.2, U4.9 (VM)
+24V_PRE: D3.2, F1.1
+24V_RAW: D3.1, J1.1 (+12V)
+24V_SNS: C10.1, C11.1, C26.1, J14.1 (GND), J14.4 (ENC_B), J15.1, J_IN2.1, J_IN3.1, R1.1, R10.2, R44.1, R45.1, R46.1
+24V_SNS_PRE: PTC_SNS.2, R10.1
/BUCK_BS: Cbst.1, U2.8
/BUCK_COMP: Cc.1, U2.3
/BUCK_FB: Rfb1.2, Rfb2.1, U2.4
/BUCK_FREQ: R_FREQ.1, U2.6
/BUCK_SW: Cbst.2, D4.2, L1.1, U2.1
/BUP: D_LEDBUP.2, R48.2, U1.11, U44.4
/CH340_V3: C_V3.1, U5.4
/CH340_XI: C_XI.1, U5.7, Y1.1
/CH340_XO: C_XO.1, U5.8, Y1.3
/CNT5: D_LEDCNT5.2, R51.2, U1.14, U47.4
/DIR: R_PD_DIR.1, U1.16, U3.8 (DIR)
/DIR2: R_PD_DIR2.1, U1.19, U4.8 (DIR)
/DO1: R_DO1.1, R_PD_DO1.1, U1.22
/DO1_G: Q_DO1.1, R_DO1.2
/DO1_OUT: D_DO1.1, J_DO1.3, Q_DO1.3
/DO2: R_DO2.1, R_PD_DO2.1, U1.23
/DO2_G: Q_DO2.1, R_DO2.2
/DO2_OUT: D_DO2.1, J_DO2.3, Q_DO2.3
/EN_TMC: R2.2, U1.17, U3.1 (EN)
/EN_TMC2: R2B.2, U1.20, U4.1 (EN)
/IN2: D_LEDIN2.2, R49.2, U1.12, U45.4
/IN3: D_LEDIN3.2, R50.2, U1.13, U46.4
/KEY_C0: J_KEY.5, U1.44
/KEY_C1: J_KEY.6, U1.43
/KEY_C2: J_KEY.7, U1.42
/KEY_C3: J_KEY.8, U1.41
/KEY_R0: J_KEY.1, U1.48
/KEY_R1: J_KEY.2, U1.47
/KEY_R2: J_KEY.3, U1.46
/KEY_R3: J_KEY.4, U1.45
/LED24_A: D_LED24.1, R_LED24.2
/LED33_A: D_LED3V3.1, R_LED33.2
/LEDBUP_A: D_LEDBUP.1, R_LEDBUP.2
/LEDCNT5_A: D_LEDCNT5.1, R_LEDCNT5.2
/LEDERR_A: D_LEDERR.1, R_LEDERR.2
/LEDIN2_A: D_LEDIN2.1, R_LEDIN2.2
/LEDIN3_A: D_LEDIN3.1, R_LEDIN3.2
/LEDRUN_A: D_LEDRUN.1, R_LEDRUN.2
/LED_ERR: R_LEDERR.1, U1.30
/LED_RUN: R_LEDRUN.1, U1.21
/Mot2A1: J_MOT2.2, U4.12 (A1)
/Mot2A2: J_MOT2.1, U4.11 (A2)
/Mot2B1: J_MOT2.3, U4.13 (B1)
/Mot2B2: J_MOT2.4, U4.14 (B2)
/MotA1: J_MOT1.2, U3.12 (A1)
/MotA2: J_MOT1.1, U3.11 (A2)
/MotB1: J_MOT1.3, U3.13 (B1)
/MotB2: J_MOT1.4, U3.14 (B2)
/NRST: C_NRST.1, R_NRST.2, SW_NRST.1, SW_NRST.2, U1.10
/OPTO_IN2: J_IN2.3, R45.2, U45.1
/OPTO_IN3: J_IN3.3, R46.2, U46.1
/OPTO_IN_5V: J_CNT5.3, R47.2, U47.1
/OPTO_IN_BUP: J14.3 (ENC_A), J15.3, R1.2, R44.2, U44.1
/STEP: R_PD_STEP.1, U1.15, U3.7 (STEP)
/STEP2: R_PD_STEP2.1, U1.18, U4.7 (STEP)
/SWCLK: R_BOOT.1, SW_BOOT.1, SW_BOOT.2, U1.36
/SWDIO: R_SWDIO.2, U1.35
/TM_CLK: J_DISP.1, U1.37
/TM_DIO: J_DISP.2, U1.38
/UART_RX: U1.32, U5.2
/UART_TX: U1.29, U5.3
/USB_DM: J_USB.2, U5.6
/USB_DP: J_USB.3, U5.5
GND: C3.2, C5.2, C10.2, C11.2, C20.2, C20B.2, C21.2, C24.2, C24B.2, C26.2, C27.2, C31.2, C51.2, C52.2, C53.2, C_MCU.2, C_MCU2.2, C_NRST.2, C_V3.2, C_XI.2, C_XO.2, Cc.2, D1.1, D4.1, D5.1, D_LED3V3.2, D_LED24.2, D_LEDERR.2, D_LEDRUN.2, J1.2 (GND), J14.2 (3V3), J15.2, J_CNT5.2, J_DISP.4, J_DO1.2, J_DO2.2, J_IN2.2, J_IN3.2, J_P24S.2 (SNS), J_USB.5, J_USB.MH1, J_USB.MH2, Q_DO1.2, Q_DO2.2, R_BOOT.2, R_FREQ.2, R_PD_DIR.2, R_PD_DIR2.2, R_PD_DO1.2, R_PD_DO2.2, R_PD_STEP.2, R_PD_STEP2.2, Rfb2.2, SW_NRST.3, SW_NRST.4, U1.7, U2.5, U2.9, U3.10 (GND), U3.16 (GND2), U4.10 (GND), U4.16 (GND2), U5.1, U6.1, U44.2, U44.3, U45.2, U45.3, U46.2, U46.3, U47.2, U47.3, Y1.2, Y1.4

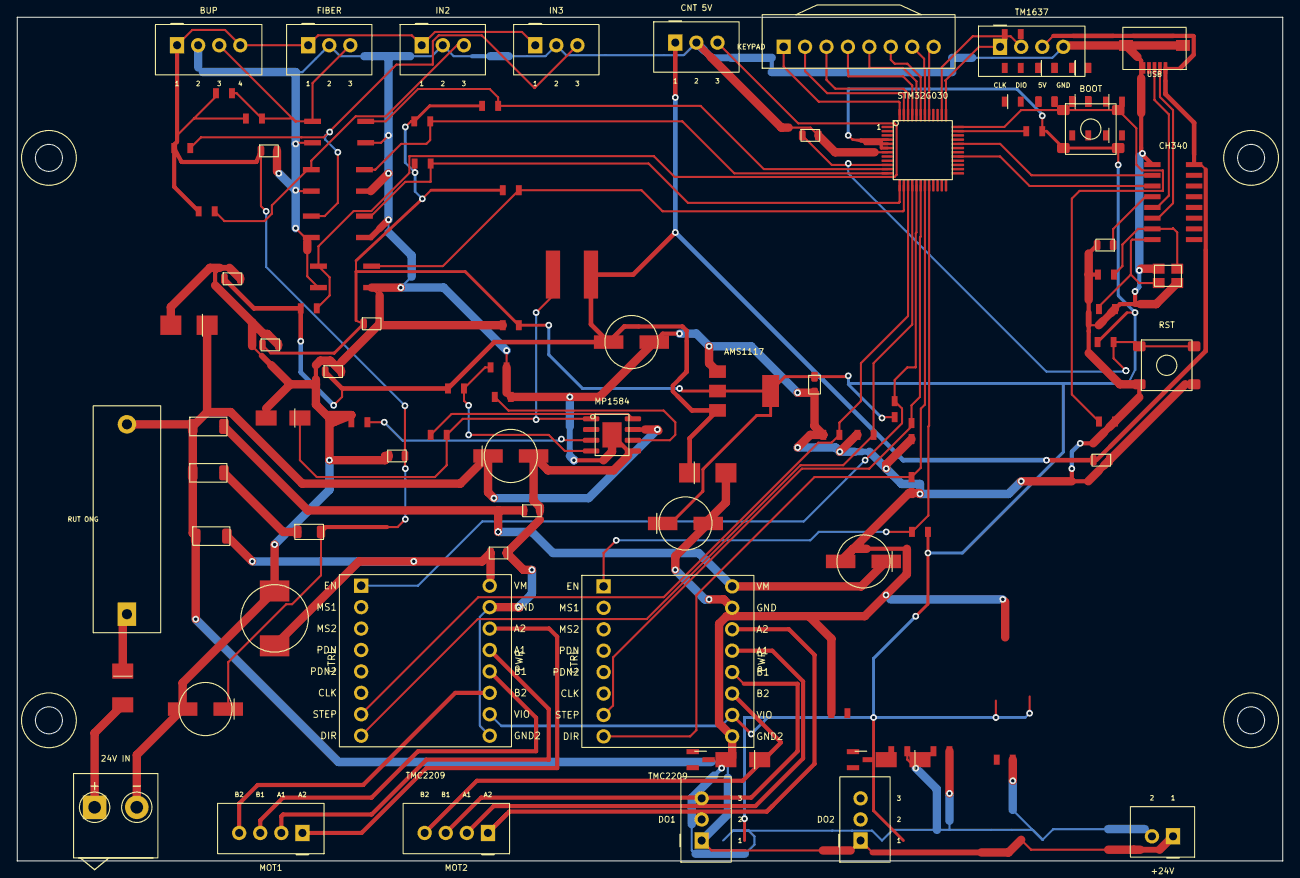
[picture p143: board STM32G030C8T6.kicad_pcb from above]

Board: 2 copper layers, 150.0 x 100.0 mm, 109 parts (0 on the bottom side), 73 nets.

Other parts of the board:
H1, H2, H3, H4: M3; MountingHole_M3
