nguyenduchan/coutingmachine/pcb/STM32G030C8T6/modules/m3_uln2003.kicad_pcb

## KiCad design pcb/STM32G030C8T6/modules/m3_uln2003.kicad_pcb (2026-09-21)

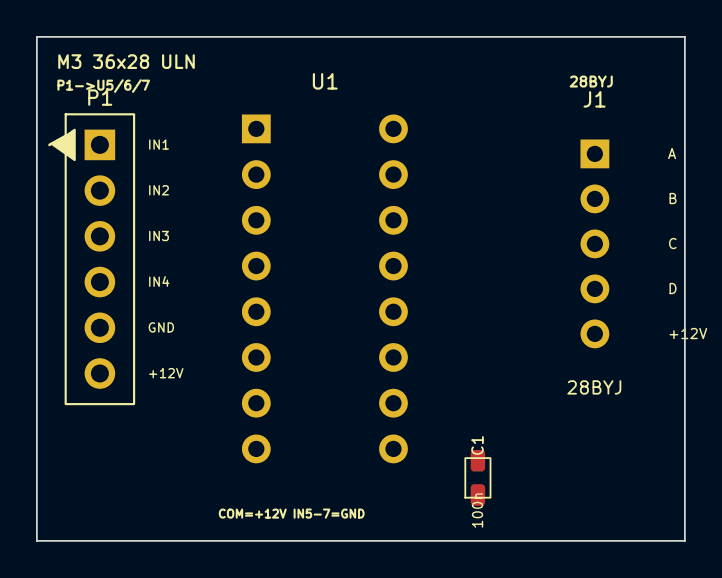
[picture p144: board m3_uln2003.kicad_pcb from above]

Board: 2 copper layers, 36.0 x 28.0 mm, 4 parts (0 on the bottom side), 10 nets, no tracks yet.

Parts:
C1: 100n; C_0805_100n
J1: 28BYJ; JST_XH_05_BYJ
P1: 1x6_to_U5-7; PinHeader_1x06_Module
U1: ULN2003AN

Connections:
+12V: C1.1, J1.5, P1.6, U1.9
GND: C1.2, P1.5, U1.5, U1.6, U1.7, U1.8
IN1: P1.1, U1.1
IN2: P1.2, U1.2
IN3: P1.3, U1.3
IN4: P1.4, U1.4
OUT1: J1.1, U1.16
OUT2: J1.2, U1.15
OUT3: J1.3, U1.14
OUT4: J1.4, U1.13
