nguyenduchan/coutingmachine/pcb/STM32G030C8T6/gen_power_carrier.py

#!/usr/bin/env python3
"""LEGACY — 180×145 ESP32-S3 + ULN/595/TFT carrier.

Fab mới dùng:
    python gen_compact_carrier.py
    python gen_schematic_from_pcb.py
    python verify_compact.py

Board mới: 100×100 mm, WROOM-32 hàn, chỉ TMC còn đế cắm.
"""
# COMPACT_DELEGATE: fab SoT is gen_compact_carrier.py (100×100).

from __future__ import annotations

import json
import os
import re
import sys
import uuid
from pathlib import Path

from placement_floorplan import balanced_placement
from gen_submodules import _m2_layout
from s3_pinmap import (
    BUZZER_GPIO,
    DRV_MOTORS,
    ENC_GPIO,
    LEFT_PINS,
    MOSFET_GPIO,
    OPTO_GPIO,
    PIN_BY_NAME,
    RIGHT_PINS,
    SHIFT_GPIO,
    TFT_GPIO,
    TMC_GPIO,
    pad_local,
)
from maze_router import (
    autoroute_pads,
    emit_service_buses,
    format_routes,
    inject_routes,
    parse_kept_vias,
    parse_hole_sites,
    parse_keepout_holes,
    parse_pads,
    repair_open_pcb,
    strip_routes,
)

ROOT = Path(__file__).resolve().parent
LIB = ROOT / "libraries"
PRETTY = LIB / "STM32G030C8T6.pretty"

# Placement-only: footprints + nets + Eco silk — no tracks / vias / autoroute.
# Set EMIT_TRACKS=1 in the environment to restore copper routing helpers.
EMIT_TRACKS = os.environ.get("EMIT_TRACKS", "") == "1"

# Legacy name: when True, track_*/via() are no-ops (copper from maze/FreeRouting).
USE_MAZE_AUTOROUTE = not EMIT_TRACKS

# In-house maze (slow). Default off — placement only unless EMIT_TRACKS=1 and
# PCB_SKIP_MAZE is unset.
RUN_MAZE = EMIT_TRACKS and os.environ.get("PCB_SKIP_MAZE", "") != "1"

PITCH = 2.54
ROW_SPACING = 25.4
PAD_SIZE = 1.7
PAD_DRILL = 1.0
S3_PINS_PER_SIDE = 22

# MP1584EN mini buck 22 x 17 mm — Shopee item 41383641614 (fixed 5V 3A).
# Pad layout measured from PlantCtrl MP1584_buck_module.kicad_mod (22x17 dual-THT
# per pin — same PCB as adjustable mini MP1584 sold on Shopee/Taobao).
MP1584_W = 22.1
MP1584_H = 17.0
MP1584_PAD_X = 9.271  # |x| column center from board origin
MP1584_PAD_Y_HI = 6.604  # outer hole of each +/− pair
MP1584_PAD_Y_LO = 4.064  # inner hole; HI−LO = 2.54 mm
MP1584_PAD_Y_MID = (MP1584_PAD_Y_HI + MP1584_PAD_Y_LO) / 2  # 5.334
MP1584_PAD_SPAN_X = MP1584_PAD_X * 2  # 18.542 IN ↔ OUT
MP1584_PAD_SPAN_Y = MP1584_PAD_Y_MID * 2  # 10.668 + ↔ −
MP1584_SHOPEE_URL = (
    "https://shopee.vn/MP1584EN-Mini-DC-Buck-41383641614"
)
# Dual THT per pin: 1=VIN+ 2=VIN- 3=VOUT- 4=VOUT+ (PlantCtrl pinout).
MP1584_PADS: list[tuple[str, str, float, float]] = [
    ("1", "VIN+", -MP1584_PAD_X, MP1584_PAD_Y_LO),
    ("1", "VIN+", -MP1584_PAD_X, MP1584_PAD_Y_HI),
    ("2", "VIN-", -MP1584_PAD_X, -MP1584_PAD_Y_LO),
    ("2", "VIN-", -MP1584_PAD_X, -MP1584_PAD_Y_HI),
    ("3", "VOUT-", MP1584_PAD_X, -MP1584_PAD_Y_LO),
    ("3", "VOUT-", MP1584_PAD_X, -MP1584_PAD_Y_HI),
    ("4", "VOUT+", MP1584_PAD_X, MP1584_PAD_Y_LO),
    ("4", "VOUT+", MP1584_PAD_X, MP1584_PAD_Y_HI),
]
# Aliases so older Mini560 layout math keeps working
MINI560_W = MP1584_W
MINI560_H = MP1584_H
MINI560_PAD_SPAN_X = MP1584_PAD_SPAN_X
MINI560_PAD_SPAN_Y = MP1584_PAD_SPAN_Y

TB_PITCH = 5.0
# Default footprint orientation. Per-part ROT_* overrides when rubber-band
# crossings would otherwise force crossed traces (silk labels follow that rot).
PART_ROT = 0
BOTTOM_ROT = PART_ROT  # legacy alias
# Uncross: TMC STEP/DIR/EN vs U1 IO16/17/18; ENC A/B; DIP↔BYJ phase order
ROT_TMC = 270
ROT_ENC = 180
ROT_DIP = 180
ROT_BYJ = 180

TMC_W = 20.4
TMC_H = 20.4
TMC_ROW = 15.24

MOTOR_HEADER = [
    ("1", "A2", 11),
    ("2", "A1", 12),
    ("3", "B1", 13),
    ("4", "B2", 14),
]

# J17 LCD 1×9 + J23 touch 1×5 — contiguous column, MSP3520 / lcdwiki order.
# Module silk (exact): VCC GND CS RESET DC SDI SCK LED SDO | T_CLK T_CS T_DIN T_DO T_IRQ
# Shared SPI: SCK↔T_CLK, MOSI↔T_DIN; LCD SDO (J17.9) NC — T_DO owns MISO.
# EC11 on J18: GPIO47=ENC_A, GPIO45=ENC_B (SW unused — Enter on TFT).
# Avoid IO38 — DevKitC-1 v1.1 onboard WS2812.
TFT_LCD_HEADER = [
    ("1", "VCC"),    # module pin 1
    ("2", "GND"),
    ("3", "CS"),
    ("4", "RESET"),
    ("5", "DC"),
    ("6", "SDI"),    # MOSI
    ("7", "SCK"),
    ("8", "LED"),
    ("9", "SDO"),    # MISO LCD — NC on PCB
]
TFT_TP_HEADER = [
    ("1", "T_CLK"),  # module pin 10
    ("2", "T_CS"),   # 11
    ("3", "T_DIN"),  # 12
    ("4", "T_DO"),   # 13
    ("5", "T_IRQ"),  # 14
]
# Legacy combined list (docs / 1×14 silk names)
TFT_HEADER = TFT_LCD_HEADER + [
    (str(10 + i), name) for i, (_, name) in enumerate(TFT_TP_HEADER)
]
TFT_LCD_PINS = len(TFT_LCD_HEADER)
TFT_TP_PINS = len(TFT_TP_HEADER)
TFT_PINS = TFT_LCD_PINS + TFT_TP_PINS
TFT_LCD_FP = "PinHeader_1x09_TFT_LCD"
TFT_TP_FP = "PinHeader_1x05_TFT_TP"
TFT_FP = TFT_LCD_FP  # primary / sch footprint alias
TFT_LCD_SYM = "Conn_1x09_TFT_LCD"
TFT_TP_SYM = "Conn_1x05_TFT_TP"
TFT_SYM = TFT_LCD_SYM

BUZZER_HEADER = [("1", "VCC5"), ("2", "GND"), ("3", "SIG")]
MOSFET_HEADER = [("1", "PWM"), ("2", "GND"), ("3", "+12V"), ("4", "FAN-")]
# KY-040 / EC11: GND, 3V3, CLK(A), DT(B) — SW not on header (Enter on screen)
ENC_HEADER = [("1", "GND"), ("2", "3V3"), ("3", "ENC_A"), ("4", "ENC_B")]
# Pluggable sub-modules (see gen_submodules.py / modules/)
# M1/M2 mate = straight 2.54 pin header (Shopee PC817-style)
# Field I/O jacks (HOME/BUP/BLW/ENC/BZ) stay JST-XH keyed (pitch 2.5 mm)
XH_PITCH = 2.5  # JST-XH field jacks only
# On-board input protect (was pluggable M1): D3 series + F1 5×20 + D1 TVS
FUSE_5X20_HALF = 11.25  # pad centers ±11.25 mm
FUSE_5X20_FP = "Fuse_Holder_5x20_Open"
# M2: two separate rows — IN 1×6 + OUT 1×5
OPTO_IN_FP = "PinHeader_1x06_OptoIN"
OPTO_IN_PINS = 6
OPTO_IN_HEADER = [
    ("1", "IN1"), ("2", "IN2"), ("3", "IN3"), ("4", "IN4"),
    ("5", "SNS"), ("6", "GND"),
]
OPTO_IN_SYM = "Conn_1x06_OptoIN"
OPTO_OUT_FP = "PinHeader_1x05_OptoOUT"
OPTO_OUT_PINS = 5
OPTO_OUT_HEADER = [
    ("1", "OUT1"), ("2", "OUT2"), ("3", "OUT3"), ("4", "OUT4"), ("5", "3V3"),
]
OPTO_OUT_SYM = "Conn_1x05_OptoOUT"
# Legacy aliases (docs / older helpers)
OPTO4_FP = OPTO_IN_FP
OPTO4_PINS = OPTO_IN_PINS
OPTO4_HEADER = OPTO_IN_HEADER
OPTO4_SYM = OPTO_IN_SYM
HOME_FP = "JST_XH_02_Socket"
HOME_HEADER = [("1", "SIG"), ("2", "SNS")]
BUP_XH_FP = "JST_XH_04_Socket"
BZ_XH_FP = "JST_XH_03_Socket"
BLW_XH_FP = "JST_XH_04_Socket"
ENC_XH_FP = "JST_XH_04_Socket"
ENC_PINS = len(ENC_HEADER)
ENC_FP = ENC_XH_FP
ENC_SYM = "Conn_JST_XH_04_ENC"

VIA12_DRILL = 0.6
VIA12_DIA = 1.1

# Carrier; modules keep ≥ MODULE_EDGE_CLEAR from Edge.Cuts.
# Compact target 180×150 (hand floorplan); E11 gaps unchanged.
BOARD_W = 180.0
BOARD_H = 145.0  # 5 mm multiple; Y layout frozen to LAYOUT_REF_H
BOARD_W_EXTRA = BOARD_W - 185.0
# Keep module world XY from last green 180×155 pack when Edge.Cuts shrinks.
LAYOUT_REF_H = 155.0
MODULE_EDGE_CLEAR = 5.0  # min distance module courtyard → board edge
MODULE_MCU_CLEAR = 10.0  # min gap any non-MCU Eco ↔ MCU Eco
MODULE_CLUSTER_GAP = 6.0  # was 8; on-board OPTO stack needs corridor room (E11.2)

SILK_TEXT_MIN_MM = 0.8  # KiCad board-setup silk text minimum
MOUNT_INSET = 3.5  # M3 hole centers from Edge.Cuts (mounts may sit in margin)
MOUNT_DRILL = 3.2
MOUNT_PAD = 6.5  # silk / keepout diameter
VIA12_COUNT_X = 3
VIA12_COUNT_Y = 2
VIA12_PITCH = 1.8

# Discrete PC817 DIP-4 ×4 (replaces 2× module 4CH). Pinout: 1=A 2=K 3=E 4=C.
DIP4_ROW = 7.62
DIP4_PAD = 1.6
DIP4_DRILL = 0.9
DIP4_BODY_L = 5.2
DIP4_BODY_W = 6.5
OPTO_CH = [
    # (uref, r_led, r_pu, in_id, in_net, out_id, out_net, anode_id, anode_net, tag)
    # Just enough: HOME×3 + BUP (field IN5–8 removed with 74HC595 GPIO reclaim).
    ("U41", "R41", "R45", 25, "/OPTO_IN1", 16, "/OPTO_OUT1", 80, "/OPTO_A1", "HOME1"),
    ("U42", "R42", "R46", 26, "/OPTO_IN2", 17, "/OPTO_OUT2", 81, "/OPTO_A2", "HOME2"),
    ("U43", "R43", "R47", 27, "/OPTO_IN3", 18, "/OPTO_OUT3", 82, "/OPTO_A3", "HOME3"),
    ("U44", "R44", "R48", 28, "/OPTO_IN4", 19, "/OPTO_OUT4", 83, "/OPTO_A4", "BUP"),
]
# Legacy names kept so old schematic helpers that still mention OPTO_FIELD_* compile.
OPTO_FIELD_HEADER = [
    ("1", "GND_I"),
    ("2", "VCC_I"),
    ("3", "IN1"),
    ("4", "IN2"),
    ("5", "IN3"),
    ("6", "IN4"),
]
OPTO_FIELD_PINS = len(OPTO_FIELD_HEADER)
OPTO_FIELD_FP = f"PinHeader_1x{OPTO_FIELD_PINS:02d}_OptoField"
OPTO_FIELD_SYM = f"Conn_1x{OPTO_FIELD_PINS:02d}_OptoField"

BYJ_HEADER = [("1", "A"), ("2", "B"), ("3", "C"), ("4", "D"), ("5", "+12V")]
BYJ_FP = "PinHeader_1x05_BYJ"
BYJ_SYM = "Conn_1x05_BYJ"

# Dry NC limit switch + JST-XH 2P (SIG/SNS) — not CNC 1×04 module.
ENDSTOP_FP = HOME_FP
ENDSTOP_SYM = "Conn_JST_XH_02"
ENDSTOP_HEADER = HOME_HEADER
ENDSTOP_NOTE = "Dry NC limit + JST-XH 2P (SIG/SNS); no CNC 4-pin module"

# DIP-16 (ULN2003AN / 74HC595)
DIP16_ROW = 7.62
# Square, like KiCad's own DIP footprints. The 2.2 mm tall pad bought nothing
# -- the annular ring is set by the 0.9 mm drill either way -- while the A7
# hole check models every pad as a circle of its largest dimension, so an
# oblong pad demanded 0.3 mm more room sideways than its copper actually
# occupies, and reported 55 phantom violations along the DIP rows.
DIP16_PAD_W, DIP16_PAD_H = 1.6, 1.6
# The DIP body (7.0 mm) is narrower than the 7.62 mm pad rows, so a silk
# outline drawn on the body ran straight through all 16 pads. Silk gets its
# own half-width, outside the pads; Fab and CrtYd keep the real body size.
DIP16_SILK_HX = DIP16_ROW / 2 + DIP16_PAD_W / 2 + 0.3
DIP16_DRILL = 0.9
DIP16_BODY_L = 19.5
DIP16_BODY_W = 7.0

# Legacy aliases (DRV_MOTORS emptied in s3_pinmap)
DRV_W = DIP16_BODY_L
DRV_H = DIP16_BODY_W
L298N_MOTORS = DRV_MOTORS
L298N_W = DRV_W
L298N_H = DRV_H

def pad_world(at_x: float, at_y: float, rot_deg: float, lx: float, ly: float) -> tuple[float, float]:
    """Footprint local pad -> board coordinates (KiCad rotation CCW)."""
    import math
    r = math.radians(rot_deg)
    c, s = math.cos(r), math.sin(r)
    return (at_x + lx * c + ly * s, at_y - lx * s + ly * c)


def local_rect_world_aabb(
    at_x: float, at_y: float, rot_deg: float,
    lx0: float, ly0: float, lx1: float, ly1: float,
) -> tuple[float, float, float, float]:
    """World AABB of a local-axis-aligned footprint rectangle after rotation."""
    corners = [(lx0, ly0), (lx1, ly0), (lx1, ly1), (lx0, ly1)]
    xs, ys = [], []
    for lx, ly in corners:
        wx, wy = pad_world(at_x, at_y, rot_deg, lx, ly)
        xs.append(wx)
        ys.append(wy)
    return min(xs), min(ys), max(xs), max(ys)


def write_mounting_hole_m3() -> Path:
    """Non-plated M3 hole for screwing carrier to enclosure wall."""
    lines: list[str] = []
    a = lines.append
    a('(footprint "MountingHole_M3"')
    a("\t(version 20260206)")
    a('\t(generator "gen_power_carrier.py")')
    a('\t(layer "F.Cu")')
    a('\t(descr "M3 NPTH mounting hole 3.2mm drill")')
    a('\t(tags "mounting hole M3")')
    a('\t(property "Reference" "H**"')
    a("\t\t(at 0 -4.5 0)")
    a('\t\t(layer "F.SilkS")')
    a("\t\t(effects (font (size 0.8 0.8) (thickness 0.1)))")
    a("\t)")
    a('\t(property "Value" "M3"')
    a("\t\t(at 0 4.5 0)")
    a('\t\t(layer "F.Fab")')
    a("\t\t(effects (font (size 0.8 0.8) (thickness 0.1)))")
    a("\t)")
    a("\t(attr through_hole exclude_from_pos_files exclude_from_bom)")
    a("\t(fp_circle")
    a("\t\t(center 0 0)")
    a(f"\t\t(end {MOUNT_PAD / 2} 0)")
    a("\t\t(stroke (width 0.12) (type solid))")
    a("\t\t(fill none)")
    a('\t\t(layer "F.SilkS")')
    a("\t)")
    a("\t(fp_circle")
    a("\t\t(center 0 0)")
    a(f"\t\t(end {MOUNT_PAD / 2 + 0.25} 0)")
    a("\t\t(stroke (width 0.05) (type solid))")
    a("\t\t(fill none)")
    a('\t\t(layer "F.CrtYd")')
    a("\t)")
    a('\t(pad "" np_thru_hole circle')
    a("\t\t(at 0 0)")
    a(f"\t\t(size {MOUNT_DRILL} {MOUNT_DRILL})")
    a(f"\t\t(drill {MOUNT_DRILL})")
    a('\t\t(layers "F&B.Cu" "*.Mask")')
    a("\t)")
    a(")")
    out = PRETTY / "MountingHole_M3.kicad_mod"
    out.write_text("\n".join(lines) + "\n", encoding="utf-8")
    return out


def write_pin_header_footprint(n_pins: int, name: str, pin_names: list[str]) -> Path:
    """1xN male pin header on TOP (F.Cu) - pins stick up for external wiring."""
    pitch = PITCH
    span = (n_pins - 1) * pitch
    y0, y1 = -1.8, span + 1.8
    x0, x1 = -1.8, 1.8
    lines: list[str] = []
    a = lines.append
    a(f'(footprint "{name}"')
    a("\t(version 20260206)")
    a('\t(generator "gen_power_carrier.py")')
    a('\t(generator_version "1.0")')
    a('\t(layer "F.Cu")')
    a(f'\t(descr "1x{n_pins} pin header 2.54mm TOP side external wiring")')
    a('\t(tags "PinHeader 2.54mm male top")')
    a('\t(property "Reference" "J**"')
    a(f"\t\t(at 0 {y0 - 2.0} 0)")
    a('\t\t(layer "F.SilkS")')
    a("\t\t(effects (font (size 1 1) (thickness 0.15)))")
    a("\t)")
    a(f'\t(property "Value" "{name}"')
    a(f"\t\t(at 0 {y1 + 2.0} 0)")
    a('\t\t(layer "F.Fab")')
    a("\t\t(effects (font (size 1 1) (thickness 0.15)))")
    a("\t)")
    a('\t(property "Datasheet" "~"')
    a('\t\t(at 0 0 0)')
    a('\t\t(layer "F.Fab")')
    a("\t\t(hide yes)")
    a("\t\t(effects (font (size 1 1) (thickness 0.15)))")
    a("\t)")
    a("\t(attr through_hole)")
    for layer, w in (("F.CrtYd", 0.05), ("F.Fab", 0.1), ("F.SilkS", 0.12)):
        a("\t(fp_rect")
        a(f"\t\t(start {x0} {y0})")
        a(f"\t\t(end {x1} {y1})")
        a(f"\t\t(stroke (width {w}) (type solid))")
        a("\t\t(fill none)")
        a(f'\t\t(layer "{layer}")')
        a("\t)")
    for i, label in enumerate(pin_names):
        y = i * pitch
        a(f'\t(fp_text user "{label}"')
        a(f"\t\t(at {x1 + 2.0} {y} 0)")
        a('\t\t(layer "F.SilkS")')
        a('\t\t(effects (font (size 0.8 0.8) (thickness 0.12)) (justify left))')
        a("\t)")
        shape = "rect" if i == 0 else "circle"
        a(f'\t(pad "{i + 1}" thru_hole {shape}')
        a(f"\t\t(at 0 {y})")
        a("\t\t(size 1.7 1.7)")
        a("\t\t(drill 1.0)")
        a('\t\t(layers "*.Cu" "*.Mask")')
        a("\t\t(remove_unused_layers no)")
        a("\t)")
    a(")")
    out = PRETTY / f"{name}.kicad_mod"
    out.write_text("\n".join(lines) + "\n", encoding="utf-8")
    return out


def write_tmc2209_footprint() -> Path:
    """THT landing for BTT-style TMC2209 stepstick (verify on Shopee module)."""
    # Control column x=-row/2: EN..DIR ; Power column x=+row/2: VM..GND
    ctrl = [
        ("1", "EN"),
        ("2", "MS1"),
        ("3", "MS2"),
        ("4", "PDN"),
        ("5", "PDN2"),
        ("6", "CLK"),
        ("7", "STEP"),
        ("8", "DIR"),
    ]
    pwr = [
        ("9", "VM"),
        ("10", "GND"),
        ("11", "A2"),
        ("12", "A1"),
        ("13", "B1"),
        ("14", "B2"),
        ("15", "VIO"),
        ("16", "GND2"),
    ]
    hx = TMC_ROW / 2
    y0 = -3.5 * PITCH
    lines: list[str] = []
    a = lines.append
    a('(footprint "TMC2209_StepStick"')
    a("\t(version 20260206)")
    a('\t(generator "gen_power_carrier.py")')
    a('\t(generator_version "1.0")')
    a('\t(layer "F.Cu")')
    a(
        '\t(descr "TMC2209 stepstick ~15.24x20.32mm (BTT pinout). '
        'Verify Shopee thegioimodule before fab.")'
    )
    a('\t(tags "TMC2209 stepper driver module NEMA17")')
    a('\t(property "Reference" "U**"')
    a(f'\t\t(at 0 {-TMC_H / 2 - 1.8} 0)')
    a('\t\t(layer "F.SilkS")')
    a("\t\t(effects (font (size 1 1) (thickness 0.15)))")
    a("\t)")
    a('\t(property "Value" "TMC2209"')
    a(f'\t\t(at 0 {TMC_H / 2 + 1.8} 0)')
    a('\t\t(layer "F.SilkS")')
    a("\t\t(effects (font (size 0.9 0.9) (thickness 0.12)))")
    a("\t)")
    a("\t(attr through_hole)")
    for layer, w in (("F.CrtYd", 0.05), ("F.Fab", 0.1), ("F.SilkS", 0.12)):
        a("\t(fp_rect")
        a(f"\t\t(start {-TMC_W / 2} {-TMC_H / 2})")
        a(f"\t\t(end {TMC_W / 2} {TMC_H / 2})")
        a(f"\t\t(stroke (width {w}) (type solid))")
        a("\t\t(fill none)")
        a(f'\t\t(layer "{layer}")')
        a("\t)")
    a('\t(fp_text user "THAY TMC2209"')
    a(f"\t\t(at 0 {TMC_H / 2 + 3.4} 0)")
    a('\t\t(layer "F.SilkS")')
    a('\t\t(effects (font (size 0.7 0.7) (thickness 0.1)))')
    a("\t)")
    a('\t(fp_text user "NEMA=Mot pins"')
    a(f"\t\t(at 0 {TMC_H / 2 + 4.8} 0)")
    a('\t\t(layer "F.SilkS")')
    a('\t\t(effects (font (size 0.65 0.65) (thickness 0.1)))')
    a("\t)")
    a('\t(fp_text user "CTRL"')
    a(f"\t\t(at {-hx - 3.5} 0 90)")
    a('\t\t(layer "F.SilkS")')
    a('\t\t(effects (font (size 0.8 0.8) (thickness 0.12)))')
    a("\t)")
    a('\t(fp_text user "PWR"')
    a(f"\t\t(at {hx + 3.5} 0 90)")
    a('\t\t(layer "F.SilkS")')
    a('\t\t(effects (font (size 0.8 0.8) (thickness 0.12)))')
    a("\t)")
    for i, (num, name) in enumerate(ctrl):
        y = y0 + i * PITCH
        a(f'\t(fp_text user "{name}"')
        a(f"\t\t(at {-hx - 2.8} {y} 0)")
        a('\t\t(layer "F.SilkS")')
        a('\t\t(effects (font (size 0.8 0.8) (thickness 0.1)) (justify right))')
        a("\t)")
        shape = "rect" if i == 0 else "circle"
        a(f'\t(pad "{num}" thru_hole {shape}')
        a(f"\t\t(at {-hx} {y})")
        a("\t\t(size 1.7 1.7)")
        a("\t\t(drill 1.0)")
        a('\t\t(layers "*.Cu" "*.Mask")')
        a("\t)")
    for i, (num, name) in enumerate(pwr):
        y = y0 + i * PITCH
        a(f'\t(fp_text user "{name}"')
        a(f"\t\t(at {hx + 2.8} {y} 0)")
        a('\t\t(layer "F.SilkS")')
        a('\t\t(effects (font (size 0.8 0.8) (thickness 0.1)) (justify left))')
        a("\t)")
        a(f'\t(pad "{num}" thru_hole circle')
        a(f"\t\t(at {hx} {y})")
        a("\t\t(size 1.7 1.7)")
        a("\t\t(drill 1.0)")
        a('\t\t(layers "*.Cu" "*.Mask")')
        a("\t)")
    a(")")
    out = PRETTY / "TMC2209_StepStick.kicad_mod"
    out.write_text("\n".join(lines) + "\n", encoding="utf-8")
    return out


def uid() -> str:
    return str(uuid.uuid4())


def inject_module_groups(
    pcb_text: str,
    cluster_boxes: list[tuple],
    eco_gfx: dict[str, list[str]],
    uid_fn=uid,
    *,
    label_pad_mm: float = 12.0,
) -> str:
    """KiCad groups: footprints + Eco outline + board silk/labels per cluster."""
    import re as _re

    def _hit(x: float, y: float, pad: float) -> str | None:
        best = None
        best_area = 1e30
        for _f, lab, x0, y0, x1, y1 in cluster_boxes:
            if x0 - pad <= x <= x1 + pad and y0 - pad <= y <= y1 + pad:
                area = (x1 - x0) * (y1 - y0)
                if area < best_area:
                    best_area = area
                    best = lab
        return best

    members: dict[str, list[str]] = {
        lab: list(eco_gfx.get(lab, [])) for _f, lab, *_rest in cluster_boxes
    }

    # --- Footprints ---
    fps: list[tuple[str, float, float, str]] = []
    for m in _re.finditer(
        r'\n\t\(footprint [^\n]+\n'
        r'\t\t\(layer [^\n]+\n'
        r'\t\t\(uuid "([^"]+)"\)\n'
        r"\t\t\(at ([-\d.]+) ([-\d.]+)(?: ([-\d.]+))?\)"
        r"[\s\S]*?"
        r'\(property "Reference" "([^"]+)"',
        pcb_text,
    ):
        fps.append((m.group(1), float(m.group(2)), float(m.group(3)), m.group(5)))

    ungrouped_fp: list[str] = []
    for fuuid, fx, fy, ref in fps:
        if ref.startswith("H"):
            continue
        hit = _hit(fx, fy, 0.05)
        if hit is None:
            ungrouped_fp.append(ref)
            continue
        members.setdefault(hit, []).append(fuuid)

    # --- Board graphics (silk / Cmts / Eco labels already in eco_gfx) ---
    # gr_text
    for m in _re.finditer(
        r'\n\t\(gr_text "((?:\\.|[^"\\])*)"\s*\n'
        r"\t\t\(at ([-\d.]+) ([-\d.]+)(?: ([-\d.]+))?\)\s*\n"
        r'\t\t\(layer "([^"]+)"\)[\s\S]*?'
        r'\t\t\(uuid "([^"]+)"\)',
        pcb_text,
    ):
        layer, u = m.group(5), m.group(6)
        if layer.startswith("Eco"):
            continue  # already via eco_gfx
        x, y = float(m.group(2)), float(m.group(3))
        hit = _hit(x, y, label_pad_mm)
        if hit:
            members.setdefault(hit, []).append(u)

    # gr_rect — center of box (skip Eco outlines)
    for m in _re.finditer(
        r"\n\t\(gr_rect\s*\n"
        r"\t\t\(start ([-\d.]+) ([-\d.]+)\)\s*\n"
        r"\t\t\(end ([-\d.]+) ([-\d.]+)\)[\s\S]*?"
        r'\t\t\(layer "([^"]+)"\)\s*\n'
        r'\t\t\(uuid "([^"]+)"\)',
        pcb_text,
    ):
        layer, u = m.group(5), m.group(6)
        if layer.startswith("Eco") or layer == "Edge.Cuts":
            continue
        x0, y0, x1, y1 = map(float, m.group(1, 2, 3, 4))
        cx, cy = (x0 + x1) / 2, (y0 + y1) / 2
        hit = _hit(cx, cy, label_pad_mm)
        if hit:
            members.setdefault(hit, []).append(u)

    # gr_poly — centroid of pts
    for m in _re.finditer(
        r"\n\t\(gr_poly\s*\n"
        r"\t\t\(pts\s*\n"
        r"((?:\t\t\t\(xy [-\d.]+ [-\d.]+\)\n)+)"
        r"\t\t\)[\s\S]*?"
        r'\t\t\(layer "([^"]+)"\)\s*\n'
        r'\t\t\(uuid "([^"]+)"\)',
        pcb_text,
    ):
        layer, u = m.group(2), m.group(3)
        if layer.startswith("Eco"):
            continue
        pts = [
            (float(a), float(b))
            for a, b in _re.findall(r"\(xy ([-\d.]+) ([-\d.]+)\)", m.group(1))
        ]
        if not pts:
            continue
        cx = sum(p[0] for p in pts) / len(pts)
        cy = sum(p[1] for p in pts) / len(pts)
        hit = _hit(cx, cy, label_pad_mm)
        if hit:
            members.setdefault(hit, []).append(u)

    # gr_line — midpoint (assembly key ticks etc.)
    for m in _re.finditer(
        r"\n\t\(gr_line\s*\n"
        r"\t\t\(start ([-\d.]+) ([-\d.]+)\)\s*\n"
        r"\t\t\(end ([-\d.]+) ([-\d.]+)\)[\s\S]*?"
        r'\t\t\(layer "([^"]+)"\)\s*\n'
        r'\t\t\(uuid "([^"]+)"\)',
        pcb_text,
    ):
        layer, u = m.group(5), m.group(6)
        if layer.startswith("Eco") or layer == "Edge.Cuts":
            continue
        x0, y0, x1, y1 = map(float, m.group(1, 2, 3, 4))
        hit = _hit((x0 + x1) / 2, (y0 + y1) / 2, label_pad_mm)
        if hit:
            members.setdefault(hit, []).append(u)

    blocks: list[str] = []
    n_labels = 0
    for _f, lab, *_rest in cluster_boxes:
        uuids = members.get(lab) or []
        seen: set[str] = set()
        uniq = []
        for u in uuids:
            if u not in seen:
                seen.add(u)
                uniq.append(u)
        if not uniq:
            continue
        # count extras beyond footprints+eco (approx): total - eco
        eco_n = len(eco_gfx.get(lab, []))
        n_labels += max(0, len(uniq) - eco_n)
        gname = lab.split(" - ")[0].strip() if " - " in lab else lab[:48]
        mem = "\n".join(f'\t\t\t"{u}"' for u in uniq)
        blocks.append(
            f'\t(group "{gname}"\n'
            f'\t\t(uuid "{uid_fn()}")\n'
            f"\t\t(members\n{mem}\n\t\t)\n"
            f"\t)"
        )

    msg = f"  groups: {len(blocks)} clusters (+silk/labels in group)"
    if ungrouped_fp:
        msg += f"; ungrouped refs: {ungrouped_fp}"
    print(msg)

    if not blocks:
        return pcb_text
    insert = "\n".join(blocks) + "\n"
    stripped = pcb_text.rstrip()
    if not stripped.endswith(")"):
        return pcb_text + insert
    idx = stripped.rfind(")")
    return stripped[:idx] + insert + ")\n"



def write_pc817_dip4_footprint() -> Path:
    """THT DIP-4 for discrete PC817 (1=A, 2=K, 3=E, 4=C)."""
    hx = DIP4_ROW / 2
    y0 = -0.5 * PITCH
    lines: list[str] = []
    a = lines.append
    a('(footprint "PC817_DIP4"')
    a("\t(version 20260206)")
    a('\t(generator "gen_power_carrier.py")')
    a('\t(generator_version "1.0")')
    a('\t(layer "F.Cu")')
    a('\t(descr "PC817 optocoupler DIP-4 THT — A/K/E/C")')
    a('\t(tags "PC817 optocoupler DIP-4")')
    a('\t(property "Reference" "U**"')
    a(f"\t\t(at 0 {-DIP4_BODY_L / 2 - 1.6} 0)")
    a('\t\t(layer "F.SilkS")')
    a("\t\t(effects (font (size 0.8 0.8) (thickness 0.12)))")
    a("\t)")
    a('\t(property "Value" "PC817"')
    a(f"\t\t(at 0 {DIP4_BODY_L / 2 + 1.6} 0)")
    a('\t\t(layer "F.Fab")')
    a("\t\t(effects (font (size 0.8 0.8) (thickness 0.12)))")
    a("\t)")
    a("\t(attr through_hole)")
    silk_hx = DIP4_ROW / 2 + DIP4_PAD / 2 + 0.3
    for layer, w in (("F.CrtYd", 0.05), ("F.Fab", 0.1), ("F.SilkS", 0.12)):
        a("\t(fp_rect")
        hxr = silk_hx if layer.endswith("SilkS") else DIP4_BODY_W / 2 + 0.2
        a(f"\t\t(start {-hxr} {-DIP4_BODY_L / 2 - 0.2})")
        a(f"\t\t(end {hxr} {DIP4_BODY_L / 2 + 0.2})")
        a(f"\t\t(stroke (width {w}) (type solid))")
        a("\t\t(fill none)")
        a(f'\t\t(layer "{layer}")')
        a("\t)")
    a("\t(fp_arc")
    a(f"\t\t(start {-DIP4_BODY_W / 2} {y0})")
    a(f"\t\t(mid 0 {y0 - 1.0})")
    a(f"\t\t(end {DIP4_BODY_W / 2} {y0})")
    a("\t\t(stroke (width 0.12) (type solid))")
    a('\t\t(layer "F.SilkS")')
    a("\t)")
    # pins 1(A),2(K) left; 4(C),3(E) right (DIP numbering)
    pads = [
        ("1", "A", -hx, y0, "rect"),
        ("2", "K", -hx, y0 + PITCH, "circle"),
        ("3", "E", hx, y0 + PITCH, "circle"),
        ("4", "C", hx, y0, "circle"),
    ]
    for num, name, x, y, shape in pads:
        a(f'\t(fp_text user "{name}"')
        j = "right" if x < 0 else "left"
        a(f"\t\t(at {x - 2.2 if x < 0 else x + 2.2} {y} 0)")
        a('\t\t(layer "F.SilkS")')
        a(f'\t\t(effects (font (size 0.7 0.7) (thickness 0.1)) (justify {j}))')
        a("\t)")
        a(f'\t(pad "{num}" thru_hole {shape}')
        a(f"\t\t(at {x} {y})")
        a(f"\t\t(size {DIP4_PAD} {DIP4_PAD})")
        a(f"\t\t(drill {DIP4_DRILL})")
        a('\t\t(layers "*.Cu" "*.Mask")')
        a("\t)")
    a(")")
    out = PRETTY / "PC817_DIP4.kicad_mod"
    out.write_text("\n".join(lines) + "\n", encoding="utf-8")
    return out


def write_pc817_4ch_footprint() -> Path:
    """Deprecated: module footprint removed — discrete DIP-4 only."""
    return write_pc817_dip4_footprint()


def write_pc817_8ch_footprint() -> Path:
    return write_pc817_dip4_footprint()


def write_r_axial_4k7_bup() -> Path:
    """THT axial resistor ~7.5 mm pad pitch for BUP NPN pull-up."""
    lines: list[str] = []
    a = lines.append
    a('(footprint "R_Axial_4k7_BUP"')
    a("\t(version 20260206)")
    a('\t(generator "gen_power_carrier.py")')
    a('\t(generator_version "1.0")')
    a('\t(layer "F.Cu")')
    a('\t(descr "Axial 4k7 pull-up for BUP-30S NPN -> opto")')
    a('\t(tags "resistor axial")')
    a('\t(property "Reference" "R**"')
    a('\t\t(at 0 -2.6 0)')
    a('\t\t(layer "F.SilkS")')
    a("\t\t(effects (font (size 0.8 0.8) (thickness 0.12)))")
    a("\t)")
    a('\t(property "Value" "4k7"')
    a('\t\t(at 0 2.6 0)')
    a('\t\t(layer "F.SilkS")')
    a("\t\t(effects (font (size 0.75 0.75) (thickness 0.1)))")
    a("\t)")
    a("\t(attr through_hole)")
    a('\t(fp_rect (start -3.2 -1.5) (end 3.2 1.5) '
      '(stroke (width 0.12) (type solid)) (fill none) (layer "F.SilkS"))')
    a('\t(fp_rect (start -3.4 -1.7) (end 3.4 1.7) '
      '(stroke (width 0.05) (type solid)) (fill none) (layer "F.CrtYd"))')
    a('\t(pad "1" thru_hole circle (at -3.75 0) (size 1.6 1.6) (drill 0.8) (layers "*.Cu" "*.Mask"))')
    a('\t(pad "2" thru_hole circle (at 3.75 0) (size 1.6 1.6) (drill 0.8) (layers "*.Cu" "*.Mask"))')
    a(")")
    out = PRETTY / "R_Axial_4k7_BUP.kicad_mod"
    out.write_text("\n".join(lines) + "\n", encoding="utf-8")
    return out


def write_star_power_passives() -> list:
    """Bulk 470u, SNS 47u, 100nF 0805, 10R 1206 — Ref+Value on silk + rect outline."""
    outs = []

    def _radial(name: str, d: float, pitch: float, descr: str, silk_val: str):
        r = d / 2
        # Rectangular silk outline around radial can (user request: đường bao chữ nhật)
        hx, hy = r + 0.4, r + 0.4
        lines = [
            f'(footprint "{name}"',
            "	(version 20260206)",
            '	(generator "gen_power_carrier.py")',
            '	(layer "F.Cu")',
            f'	(descr "{descr}")',
            f'	(property "Reference" "C**" (at 0 {-hy - 1.2} 0)',
            '		(layer "F.SilkS") (effects (font (size 0.8 0.8) (thickness 0.12))))',
            f'	(property "Value" "{silk_val}" (at 0 {hy + 1.2} 0)',
            '		(layer "F.SilkS") (effects (font (size 0.75 0.75) (thickness 0.1))))',
            "	(attr through_hole)",
            f'	(fp_rect (start {-hx} {-hy}) (end {hx} {hy}) '
            f'(stroke (width 0.12) (type solid)) (fill none) (layer "F.SilkS"))',
            f'	(fp_circle (center 0 0) (end {r} 0) '
            f'(stroke (width 0.1) (type solid)) (fill none) (layer "F.Fab"))',
            f'	(pad "1" thru_hole rect (at {-pitch / 2} 0) (size 1.8 1.8) (drill 0.9) (layers "*.Cu" "*.Mask"))',
            f'	(pad "2" thru_hole circle (at {pitch / 2} 0) (size 1.8 1.8) (drill 0.9) (layers "*.Cu" "*.Mask"))',
            ")",
        ]
        out = PRETTY / f"{name}.kicad_mod"
        out.write_text("\n".join(lines) + "\n", encoding="utf-8")
        return out

    outs.append(_radial("CP_Radial_D8_470u_25V", 8.0, 3.5, "470uF 25V bulk near TMC2209", "470u/25V"))
    outs.append(_radial("CP_Radial_D6_100u_25V", 6.3, 2.5, "100uF 25V shared ULN COM bulk", "100u/25V"))
    outs.append(_radial("CP_Radial_D6_47u_25V", 6.3, 2.5, "47uF 25V SNS rail", "47u/25V"))

    c0805 = (
        '(footprint "C_0805_100n"\n'
        "\t(version 20260206)\n"
        '\t(generator "gen_power_carrier.py")\n'
        '\t(layer "F.Cu")\n'
        '\t(descr "100nF 0805")\n'
        '\t(property "Reference" "C**" (at 0 -1.8 0) (layer "F.SilkS") '
        "(effects (font (size 0.8 0.8) (thickness 0.1))))\n"
        '\t(property "Value" "100n" (at 0 1.8 0) (layer "F.SilkS") '
        "(effects (font (size 0.7 0.7) (thickness 0.1))))\n"
        "\t(attr smd)\n"
        '\t(fp_rect (start -1.1 -0.7) (end 1.1 0.7) (stroke (width 0.12) (type solid)) '
        '(fill none) (layer "F.SilkS"))\n'
        '\t(fp_rect (start -1.3 -0.9) (end 1.3 0.9) (stroke (width 0.05) (type solid)) '
        '(fill none) (layer "F.CrtYd"))\n'
        '\t(pad "1" smd roundrect (at -0.95 0) (size 0.8 1.2) '
        '(layers "F.Cu" "F.Paste" "F.Mask") (roundrect_rratio 0.25))\n'
        '\t(pad "2" smd roundrect (at 0.95 0) (size 0.8 1.2) '
        '(layers "F.Cu" "F.Paste" "F.Mask") (roundrect_rratio 0.25))\n'
        ")\n"
    )
    p = PRETTY / "C_0805_100n.kicad_mod"
    p.write_text(c0805, encoding="utf-8")
    outs.append(p)

    r1206 = (
        '(footprint "R_1206_10R"\n'
        "\t(version 20260206)\n"
        '\t(generator "gen_power_carrier.py")\n'
        '\t(layer "F.Cu")\n'
        '\t(descr "10 ohm 1206 SNS series filter")\n'
        '\t(property "Reference" "R**" (at 0 -1.9 0) (layer "F.SilkS") '
        "(effects (font (size 0.8 0.8) (thickness 0.1))))\n"
        '\t(property "Value" "10R" (at 0 1.9 0) (layer "F.SilkS") '
        "(effects (font (size 0.7 0.7) (thickness 0.1))))\n"
        "\t(attr smd)\n"
        '\t(fp_rect (start -1.7 -0.9) (end 1.7 0.9) (stroke (width 0.12) (type solid)) '
        '(fill none) (layer "F.SilkS"))\n'
        '\t(fp_rect (start -1.9 -1.1) (end 1.9 1.1) (stroke (width 0.05) (type solid)) '
        '(fill none) (layer "F.CrtYd"))\n'
        '\t(pad "1" smd roundrect (at -1.4 0) (size 1.0 1.5) '
        '(layers "F.Cu" "F.Paste" "F.Mask") (roundrect_rratio 0.25))\n'
        '\t(pad "2" smd roundrect (at 1.4 0) (size 1.0 1.5) '
        '(layers "F.Cu" "F.Paste" "F.Mask") (roundrect_rratio 0.25))\n'
        ")\n"
    )
    p = PRETTY / "R_1206_10R.kicad_mod"
    p.write_text(r1206, encoding="utf-8")
    outs.append(p)
    return outs


def write_dip16_footprint(name: str, descr: str, silk_label: str) -> Path:
    """Standard DIP-16 THT: pitch 2.54, row 7.62, pad ~1.6x2.2, drill 0.9."""
    hx = DIP16_ROW / 2
    y0 = -3.5 * PITCH
    lines: list[str] = []
    a = lines.append
    a(f'(footprint "{name}"')
    a("\t(version 20260206)")
    a('\t(generator "gen_power_carrier.py")')
    a('\t(generator_version "3.0")')
    a('\t(layer "F.Cu")')
    a(f'\t(descr "{descr}")')
    a(f'\t(tags "{name} DIP-16")')
    a('\t(property "Reference" "U**"')
    a(f"\t\t(at 0 {-DIP16_BODY_L / 2 - 1.6} 0)")
    a('\t\t(layer "F.SilkS")')
    a("\t\t(effects (font (size 0.9 0.9) (thickness 0.12)))")
    a("\t)")
    a(f'\t(property "Value" "{name}"')
    a(f"\t\t(at 0 {DIP16_BODY_L / 2 + 1.6} 0)")
    a('\t\t(layer "F.Fab")')
    a("\t\t(effects (font (size 0.9 0.9) (thickness 0.12)))")
    a("\t)")
    a("\t(attr through_hole)")
    for layer, w in (("F.CrtYd", 0.05), ("F.Fab", 0.1), ("F.SilkS", 0.12)):
        a("\t(fp_rect")
        hxr = DIP16_SILK_HX if layer.endswith("SilkS") else DIP16_BODY_W / 2 + 0.3
        a(f"		(start {-hxr} {-DIP16_BODY_L / 2 - 0.3})")
        a(f"		(end {hxr} {DIP16_BODY_L / 2 + 0.3})")
        a(f"\t\t(stroke (width {w}) (type solid))")
        a("\t\t(fill none)")
        a(f'\t\t(layer "{layer}")')
        a("\t)")
    a("\t(fp_arc")
    a(f"\t\t(start {-DIP16_BODY_W / 2} {y0})")
    a(f"\t\t(mid 0 {y0 - 1.2})")
    a(f"\t\t(end {DIP16_BODY_W / 2} {y0})")
    a("\t\t(stroke (width 0.12) (type solid))")
    a('\t\t(layer "F.SilkS")')
    a("\t)")
    a(f'\t(fp_text user "{silk_label}"')
    a("\t\t(at 0 0 0)")
    a('\t\t(layer "F.SilkS")')
    a('\t\t(effects (font (size 0.8 0.8) (thickness 0.12)))')
    a("\t)")
    for i in range(8):
        num = i + 1
        y = y0 + i * PITCH
        shape = "rect" if i == 0 else "oval"
        a(f'\t(pad "{num}" thru_hole {shape}')
        a(f"\t\t(at {-hx} {y})")
        a(f"\t\t(size {DIP16_PAD_W} {DIP16_PAD_H})")
        a(f"\t\t(drill {DIP16_DRILL})")
        a('\t\t(layers "*.Cu" "*.Mask")')
        a("\t)")
    for i in range(8):
        num = 16 - i
        y = y0 + i * PITCH
        a(f'\t(pad "{num}" thru_hole oval')
        a(f"\t\t(at {hx} {y})")
        a(f"\t\t(size {DIP16_PAD_W} {DIP16_PAD_H})")
        a(f"\t\t(drill {DIP16_DRILL})")
        a('\t\t(layers "*.Cu" "*.Mask")')
        a("\t)")
    a(")")
    out = PRETTY / f"{name}.kicad_mod"
    out.write_text("\n".join(lines) + "\n", encoding="utf-8")
    return out


def write_uln2003_footprint() -> Path:
    """Carrier female 1×6 for M3 ULN2003 daughter (IN1-4 + GND + +12V).

    Commercial Shopee ULN boards are Dupont-only and cannot mate flush; M3
    provides the pin-header mate + JST-XH 5P for 28BYJ. Pitch stays PITCH so
    pad centers match `_emit_uln_module` / live routing.
    """
    labels = ["IN1", "IN2", "IN3", "IN4", "GND", "+12V"]
    n = len(labels)
    span = (n - 1) * PITCH
    lines: list[str] = []
    a = lines.append
    a('(footprint "ULN2003_Module"')
    a("\t(version 20260206)")
    a('\t(generator "gen_power_carrier.py")')
    a('\t(generator_version "2.4")')
    a('\t(layer "F.Cu")')
    a(
        '\t(descr "1x6 keyed socket for M3 ULN2003 daughter (IN1-4 GND +12V); '
        '28BYJ on M3 JST-XH 5P")'
    )
    a('\t(tags "keyed header ULN2003 M3 28BYJ")')
    a('\t(property "Reference" "REF**"')
    a("\t\t(at 0 -3.8 0)")
    a('\t\t(layer "F.SilkS")')
    a("\t\t(effects (font (size 0.9 0.9) (thickness 0.12)))")
    a("\t)")
    a('\t(property "Value" "ULN2003"')
    a(f"\t\t(at 0 {span + 3.8} 0)")
    a('\t\t(layer "F.SilkS")')
    a("\t\t(effects (font (size 0.85 0.85) (thickness 0.12)))")
    a("\t)")
    a("\t(attr through_hole)")
    for layer, w in (("F.CrtYd", 0.05), ("F.Fab", 0.1), ("F.SilkS", 0.12)):
        a("\t(fp_rect")
        a("\t\t(start -3.2 -2.0)")
        a(f"\t\t(end 3.2 {span + 2.0})")
        a(f"\t\t(stroke (width {w}) (type solid))")
        a("\t\t(fill none)")
        a(f'\t\t(layer "{layer}")')
        a("\t)")
    a("\t(fp_line (start -3.2 -0.6) (end -4.2 0)")
    a('\t\t(stroke (width 0.15) (type solid)) (layer "F.SilkS")')
    a("\t)")
    a("\t(fp_line (start -4.2 0) (end -3.2 0.6)")
    a('\t\t(stroke (width 0.15) (type solid)) (layer "F.SilkS")')
    a("\t)")
    a('\t(fp_text user "KEY"')
    a("\t\t(at -5.2 0 0)")
    a('\t\t(layer "F.SilkS")')
    a('\t\t(effects (font (size 0.7 0.7) (thickness 0.1)))')
    a("\t)")
    a('\t(fp_text user "cam M3 ULN2003 (board roi, khong day Dupont)"')
    a(f"\t\t(at 0 {span + 5.4} 0)")
    a('\t\t(layer "F.SilkS")')
    a('\t\t(effects (font (size 0.6 0.6) (thickness 0.1)))')
    a("\t)")
    for i, lab in enumerate(labels):
        y = i * PITCH
        a(f'\t(fp_text user "{lab}"')
        a(f"\t\t(at 4.2 {y} 0)")
        a('\t\t(layer "F.SilkS")')
        a("\t\t(effects (font (size 0.65 0.65) (thickness 0.1)) (justify left))")
        a("\t)")
        shape = "rect" if i == 0 else "circle"
        a(f'\t(pad "{i + 1}" thru_hole {shape}')
        a(f"\t\t(at 0 {y})")
        a("\t\t(size 1.6 1.6)")
        a("\t\t(drill 0.9)")
        a('\t\t(layers "*.Cu" "*.Mask")')
        a("\t)")
    a(")")
    out = PRETTY / "ULN2003_Module.kicad_mod"
    out.write_text("\n".join(lines) + "\n", encoding="utf-8")
    write_dip16_footprint(
        "ULN2003AN",
        "DIP-16 on M3 daughter — carrier uses ULN2003_Module 1x6 socket",
        "ULN2003",
    )
    return out


def write_74hc595_footprint() -> Path:
    return write_dip16_footprint(
        "74HC595",
        "74HC595 DIP-16 shift register (VCC=+3V3, /OE shared)",
        "74HC595",
    )


def write_l298n_footprint() -> Path:
    """Dead code: legacy DRV8871 — board uses ULN2003AN instead."""
    return write_uln2003_footprint()



def write_mini560_footprint() -> Path:
    """THT landing for MP1584EN 22x17 mm — Shopee 41383641614 fixed 5V."""
    x0, x1 = -MP1584_W / 2, MP1584_W / 2
    y0, y1 = -MP1584_H / 2, MP1584_H / 2

    lines: list[str] = []
    a = lines.append
    a('(footprint "MP1584_5V3A"')
    a("\t(version 20260206)")
    a('\t(generator "gen_power_carrier.py")')
    a('\t(generator_version "2.1")')
    a('\t(layer "F.Cu")')
    a(
        '\t(descr "MP1584EN mini buck 22x17mm fixed 5V Shopee 41383641614. '
        '8x THT pad (dual hole/pin), span 18.54x10.67mm.")'
    )
    a('\t(tags "MP1584EN buck DC-DC 5V module carrier Shopee")')
    a('\t(property "Reference" "U**"')
    a(f'\t\t(at 0 {y0 - 1.8} 0)')
    a('\t\t(layer "F.SilkS")')
    a("\t\t(effects (font (size 1 1) (thickness 0.15)))")
    a("\t)")
    a('\t(property "Value" "MP1584_5V3A"')
    a(f'\t\t(at 0 {y1 + 1.8} 0)')
    a('\t\t(layer "F.Fab")')
    a("\t\t(effects (font (size 1 1) (thickness 0.15)))")
    a("\t)")
    a('\t(property "Datasheet" "https://www.monolithicpower.com/en/mp1584.html"')
    a('\t\t(at 0 0 0)')
    a('\t\t(layer "F.Fab")')
    a("\t\t(hide yes)")
    a("\t\t(effects (font (size 1 1) (thickness 0.15)))")
    a("\t)")
    a('\t(property "Description" "MP1584EN 12V to 5V fixed Shopee 41383641614"')
    a('\t\t(at 0 0 0)')
    a('\t\t(layer "F.Fab")')
    a("\t\t(hide yes)")
    a("\t\t(effects (font (size 1 1) (thickness 0.15)))")
    a("\t)")
    a("\t(attr through_hole)")

    for layer, w in (("F.CrtYd", 0.05), ("F.Fab", 0.1), ("F.SilkS", 0.12)):
        a("\t(fp_rect")
        a(f"\t\t(start {x0} {y0})")
        a(f"\t\t(end {x1} {y1})")
        a(f"\t\t(stroke (width {w}) (type solid))")
        a("\t\t(fill none)")
        a(f'\t\t(layer "{layer}")')
        a("\t)")

    a('\t(fp_text user "IN"')
    a(f"\t\t(at {-MP1584_PAD_X - 2.8} 0 0)")
    a('\t\t(layer "F.SilkS")')
    a('\t\t(effects (font (size 0.8 0.8) (thickness 0.1)) (justify right))')
    a("\t)")
    a('\t(fp_text user "OUT5V"')
    a(f"\t\t(at {MP1584_PAD_X + 2.8} 0 0)")
    a('\t\t(layer "F.SilkS")')
    a('\t\t(effects (font (size 0.8 0.8) (thickness 0.1)) (justify left))')
    a("\t)")
    a('\t(fp_text user "MP1584"')
    a("\t\t(at 0 0 0)")
    a('\t\t(layer "F.SilkS")')
    a('\t\t(effects (font (size 0.9 0.9) (thickness 0.12)))')
    a("\t)")

    for num, name, x, y in MP1584_PADS:
        shape = "rect" if num == "1" and y > 0 else "circle"
        a(f'\t(pad "{num}" thru_hole {shape}')
        a(f"\t\t(at {x} {y})")
        a("\t\t(size 1.8 1.8)")
        a("\t\t(drill 1.0)")
        a('\t\t(layers "*.Cu" "*.Mask")')
        a("\t\t(remove_unused_layers no)")
        a("\t)")
    for num, name, x, y in [
        ("1", "VIN+", -MP1584_PAD_X, MP1584_PAD_Y_MID),
        ("2", "VIN-", -MP1584_PAD_X, -MP1584_PAD_Y_MID),
        ("3", "VOUT-", MP1584_PAD_X, -MP1584_PAD_Y_MID),
        ("4", "VOUT+", MP1584_PAD_X, MP1584_PAD_Y_MID),
    ]:
        a(f'\t(fp_text user "{name}"')
        j = "right" if x < 0 else "left"
        a(f"\t\t(at {x - 2.5 if x < 0 else x + 2.5} {y} 0)")
        a('\t\t(layer "F.SilkS")')
        a(f'\t\t(effects (font (size 0.8 0.8) (thickness 0.1)) (justify {j}))')
        a("\t)")

    a(")")
    out = PRETTY / "MP1584_5V3A.kicad_mod"
    out.write_text("\n".join(lines) + "\n", encoding="utf-8")
    return out


def write_screw_terminal_footprint() -> Path:
    """2-pin screw terminal block, pitch 5.0 mm (KF301-5.0-2P style)."""
    # Body approx 10 x 7.5 mm, pads at Â±2.5
    bw, bh = 10.2, 8.0
    lines: list[str] = []
    a = lines.append
    a('(footprint "TerminalBlock_2P_5.0mm"')
    a("\t(version 20260206)")
    a('\t(generator "gen_power_carrier.py")')
    a('\t(generator_version "1.0")')
    a('\t(layer "F.Cu")')
    a('\t(descr "2-pin screw terminal pitch 5.0mm for 12V PSU wires")')
    a('\t(tags "screw terminal KF301 5.0mm 2P")')
    a('\t(property "Reference" "J**"')
    a('\t\t(at 0 -5.5 0)')
    a('\t\t(layer "F.SilkS")')
    a("\t\t(effects (font (size 1 1) (thickness 0.15)))")
    a("\t)")
    a('\t(property "Value" "TerminalBlock_2P_5.0mm"')
    a('\t\t(at 0 6.2 0)')
    a('\t\t(layer "F.Fab")')
    a("\t\t(effects (font (size 1 1) (thickness 0.15)))")
    a("\t)")
    a('\t(property "Datasheet" "~"')
    a('\t\t(at 0 0 0)')
    a('\t\t(layer "F.Fab")')
    a("\t\t(hide yes)")
    a("\t\t(effects (font (size 1 1) (thickness 0.15)))")
    a("\t)")
    a('\t(property "Description" "Screw terminal 2P 5.0mm 12V input"')
    a('\t\t(at 0 0 0)')
    a('\t\t(layer "F.Fab")')
    a("\t\t(hide yes)")
    a("\t\t(effects (font (size 1 1) (thickness 0.15)))")
    a("\t)")
    a("\t(attr through_hole)")

    x0, x1 = -bw / 2, bw / 2
    y0, y1 = -bh / 2, bh / 2
    for layer, w in (("F.CrtYd", 0.05), ("F.Fab", 0.1), ("F.SilkS", 0.12)):
        a("\t(fp_rect")
        a(f"\t\t(start {x0} {y0})")
        a(f"\t\t(end {x1} {y1})")
        a(f"\t\t(stroke (width {w}) (type solid))")
        a("\t\t(fill none)")
        a(f'\t\t(layer "{layer}")')
        a("\t)")

    # Wire-entry side marker (front of terminal)
    a("\t(fp_line")
    a(f"\t\t(start {x0} {y1})")
    a(f"\t\t(end {x1} {y1})")
    a("\t\t(stroke (width 0.25) (type solid))")
    a('\t\t(layer "F.SilkS")')
    a("\t)")
    a('\t(fp_text user "+12V_RAW"')
    a(f"\t\t(at {-TB_PITCH / 2} {y0 - 1.6} 0)")
    a('\t\t(layer "F.SilkS")')
    a('\t\t(effects (font (size 0.75 0.75) (thickness 0.12)))')
    a("\t)")
    a('\t(fp_text user "GND"')
    a(f"\t\t(at {TB_PITCH / 2} {y0 - 1.6} 0)")
    a('\t\t(layer "F.SilkS")')
    a('\t\t(effects (font (size 0.8 0.8) (thickness 0.12)))')
    a("\t)")
    a('\t(fp_text user "+"')
    a(f"\t\t(at {-TB_PITCH / 2} 0 0)")
    a('\t\t(layer "F.SilkS")')
    a('\t\t(effects (font (size 1.4 1.4) (thickness 0.2)))')
    a("\t)")
    a('\t(fp_text user "-"')
    a(f"\t\t(at {TB_PITCH / 2} 0 0)")
    a('\t\t(layer "F.SilkS")')
    a('\t\t(effects (font (size 1.4 1.4) (thickness 0.2)))')
    a("\t)")
    a('\t(fp_text user "J1 12V PSU"')
    a(f"\t\t(at 0 {y0 - 3.2} 0)")
    a('\t\t(layer "F.SilkS")')
    a('\t\t(effects (font (size 0.85 0.85) (thickness 0.12)))')
    a("\t)")
    a('\t(fp_text user "RED=+  BLK=-"')
    a(f"\t\t(at 0 {y1 + 3.2} 0)")
    a('\t\t(layer "F.SilkS")')
    a('\t\t(effects (font (size 0.7 0.7) (thickness 0.1)))')
    a("\t)")
    a('\t(fp_text user "NO REVERSE"')
    a(f"\t\t(at 0 {y1 + 1.8} 0)")
    a('\t\t(layer "F.SilkS")')
    a('\t\t(effects (font (size 0.65 0.65) (thickness 0.1)))')
    a("\t)")
    # Triangular polarity cue toward + pad
    a("\t(fp_poly")
    a(f"\t\t(pts (xy {-TB_PITCH / 2 - 1.2} 2.8) (xy {-TB_PITCH / 2 + 1.2} 2.8) (xy {-TB_PITCH / 2} 4.2))")
    a('\t\t(stroke (width 0.12) (type solid))')
    a('\t\t(fill solid)')
    a('\t\t(layer "F.SilkS")')
    a("\t)")

    a('\t(pad "1" thru_hole rect')
    a(f"\t\t(at {-TB_PITCH / 2} 0)")
    a("\t\t(size 2.8 2.8)")
    a("\t\t(drill 1.5)")
    a('\t\t(layers "*.Cu" "*.Mask")')
    a("\t\t(remove_unused_layers no)")
    a("\t)")
    a('\t(pad "2" thru_hole circle')
    a(f"\t\t(at {TB_PITCH / 2} 0)")
    a("\t\t(size 2.8 2.8)")
    a("\t\t(drill 1.5)")
    a('\t\t(layers "*.Cu" "*.Mask")')
    a("\t\t(remove_unused_layers no)")
    a("\t)")
    a(")")
    out = PRETTY / "TerminalBlock_2P_5.0mm.kicad_mod"
    out.write_text("\n".join(lines) + "\n", encoding="utf-8")
    return out


def write_jst_xh_socket(n_pins: int, fp_name: str, pin_names: list[str], title: str) -> Path:
    """JST-XH nP female — polarized shroud, pitch 2.5 mm."""
    pitch = XH_PITCH
    span = (n_pins - 1) * pitch
    lines: list[str] = []
    a = lines.append
    a(f'(footprint "{fp_name}"')
    a("\t(version 20260206)")
    a('\t(generator "gen_power_carrier.py")')
    a('\t(layer "F.Cu")')
    a(f'\t(descr "JST-XH {n_pins}P female keyed — {title}")')
    a('\t(tags "JST XH keyed polarized anti-reverse")')
    a('\t(property "Reference" "J**"')
    a(f"\t\t(at 0 {-2.8} 0)")
    a('\t\t(layer "F.SilkS")')
    a("\t\t(effects (font (size 1 1) (thickness 0.15)))")
    a("\t)")
    a(f'\t(property "Value" "{fp_name}"')
    a(f"\t\t(at 0 {span + 2.8} 0)")
    a('\t\t(layer "F.Fab")')
    a("\t\t(effects (font (size 0.8 0.8) (thickness 0.12)))")
    a("\t)")
    a("\t(attr through_hole)")
    for layer, w in (("F.CrtYd", 0.05), ("F.Fab", 0.1), ("F.SilkS", 0.12)):
        a("\t(fp_rect")
        a(f"\t\t(start -3.2 {-2.0})")
        a(f"\t\t(end 3.2 {span + 2.0})")
        a(f"\t\t(stroke (width {w}) (type solid))")
        a("\t\t(fill none)")
        a(f'\t\t(layer "{layer}")')
        a("\t)")
    a("\t(fp_line")
    a("\t\t(start -3.2 -0.6)")
    a("\t\t(end -4.2 0)")
    a("\t\t(stroke (width 0.15) (type solid))")
    a('\t\t(layer "F.SilkS")')
    a("\t)")
    a("\t(fp_line")
    a("\t\t(start -4.2 0)")
    a("\t\t(end -3.2 0.6)")
    a("\t\t(stroke (width 0.15) (type solid))")
    a('\t\t(layer "F.SilkS")')
    a("\t)")
    a('\t(fp_text user "KEY"')
    a("\t\t(at -5.2 0 0)")
    a('\t\t(layer "F.SilkS")')
    a('\t\t(effects (font (size 0.7 0.7) (thickness 0.1)))')
    a("\t)")
    for i, name in enumerate(pin_names):
        y = i * pitch
        a(f'\t(fp_text user "{name}"')
        a(f"\t\t(at 4.2 {y} 0)")
        a('\t\t(layer "F.SilkS")')
        a('\t\t(effects (font (size 0.65 0.65) (thickness 0.1)) (justify left))')
        a("\t)")
        shape = "rect" if i == 0 else "circle"
        a(f'\t(pad "{i + 1}" thru_hole {shape}')
        a(f"\t\t(at 0 {y})")
        a("\t\t(size 1.6 1.6)")
        a("\t\t(drill 0.9)")
        a('\t\t(layers "*.Cu" "*.Mask")')
        a("\t)")
    a(")")
    out = PRETTY / f"{fp_name}.kicad_mod"
    out.write_text("\n".join(lines) + "\n", encoding="utf-8")
    return out


def write_jst_xh_04_socket() -> Path:
    return write_jst_xh_socket(4, BUP_XH_FP, ["+12V", "GND", "OUT", "CTRL"], "BUP/BLW/ENC")


def write_all_jst_xh_sockets() -> list[Path]:
    """Field I/O XH — pin-header mates for M2 via write_pin_header_footprint."""
    return [
        write_jst_xh_socket(2, HOME_FP, [p[1] for p in HOME_HEADER], "HOME SIG/SNS"),
        write_jst_xh_socket(3, BZ_XH_FP, ["VCC5", "GND", "SIG"], "buzzer"),
        write_jst_xh_socket(4, BUP_XH_FP, ["+12V", "GND", "OUT", "CTRL"], "BUP/BLW/ENC"),
    ]


def write_fuse_holder_5x20() -> Path:
    """Open PCB clips for 5×20 mm cartridge — field-replaceable F1."""
    half = FUSE_5X20_HALF
    lines: list[str] = []
    a = lines.append
    a(f'(footprint "{FUSE_5X20_FP}"')
    a("\t(version 20260206)")
    a('\t(generator "gen_power_carrier.py")')
    a('\t(layer "F.Cu")')
    a('\t(descr "Open fuse clips 5x20mm pad span 22.5mm — replaceable cartridge")')
    a('\t(tags "fuse holder 5x20 replaceable")')
    a('\t(property "Reference" "F**"')
    a(f"\t\t(at 0 {-half - 2.5} 0)")
    a('\t\t(layer "F.SilkS")')
    a("\t\t(effects (font (size 0.9 0.9) (thickness 0.12)))")
    a("\t)")
    a('\t(property "Value" "5x20 T3.15A"')
    a(f"\t\t(at 0 {half + 2.5} 0)")
    a('\t\t(layer "F.SilkS")')
    a("\t\t(effects (font (size 0.7 0.7) (thickness 0.1)))")
    a("\t)")
    a("\t(attr through_hole)")
    for layer, w in (("F.CrtYd", 0.05), ("F.Fab", 0.1), ("F.SilkS", 0.12)):
        a("\t(fp_rect")
        a(f"\t\t(start {-half - 2.2} -4.0)")
        a(f"\t\t(end {half + 2.2} 4.0)")
        a(f"\t\t(stroke (width {w}) (type solid))")
        a("\t\t(fill none)")
        a(f'\t\t(layer "{layer}")')
        a("\t)")
    a('\t(fp_text user "RUT ONG"')
    a("\t\t(at 0 -5.2 0)")
    a('\t\t(layer "F.SilkS")')
    a('\t\t(effects (font (size 0.55 0.55) (thickness 0.08)))')
    a("\t)")
    a('\t(pad "1" thru_hole rect')
    a(f"\t\t(at {-half} 0)")
    a("\t\t(size 2.2 2.8)")
    a("\t\t(drill 1.2)")
    a('\t\t(layers "*.Cu" "*.Mask")')
    a("\t)")
    a('\t(pad "2" thru_hole circle')
    a(f"\t\t(at {half} 0)")
    a("\t\t(size 2.2 2.8)")
    a("\t\t(drill 1.2)")
    a('\t\t(layers "*.Cu" "*.Mask")')
    a("\t)")
    a(")")
    out = PRETTY / f"{FUSE_5X20_FP}.kicad_mod"
    out.write_text("\n".join(lines) + "\n", encoding="utf-8")
    return out


def write_ptc_fuse_footprint() -> Path:
    """Legacy PTC lib (unused on board — prefer write_fuse_holder_5x20)."""
    lines: list[str] = []
    a = lines.append
    a('(footprint "Fuse_PTC_Radial_5.1mm"')
    a("\t(version 20240108)")
    a('\t(generator "gen_power_carrier.py")')
    a('\t(layer "F.Cu")')
    a(
        '\t(descr "Radial PTC resettable fuse lead pitch 5.1mm '
        '(e.g. RXE030 / 30V 3A hold). Unused — board uses 5x20 holder.")'
    )
    a('\t(tags "PTC fuse resettable")')
    a('\t(property "Reference" "F"')
    a("\t\t(at 0 -5.0 0)")
    a('\t\t(layer "F.SilkS")')
    a("\t\t(effects (font (size 1 1) (thickness 0.15)))")
    a("\t)")
    a('\t(property "Value" "PTC_3A"')
    a("\t\t(at 0 5.0 0)")
    a('\t\t(layer "F.SilkS")')
    a("\t\t(effects (font (size 0.8 0.8) (thickness 0.1)))")
    a("\t)")
    a("\t(attr through_hole)")
    a('\t(fp_rect (start -4.2 -4.2) (end 4.2 4.2) '
      '(stroke (width 0.12) (type solid)) (fill none) (layer "F.SilkS"))')
    a('\t(fp_circle (center 0 0) (end 0 -3.5) '
      '(stroke (width 0.1) (type solid)) (fill none) (layer "F.Fab"))')
    a('\t(pad "1" thru_hole rect (at -2.55 0) (size 1.8 1.8) (drill 1.0)')
    a('\t\t(layers "*.Cu" "*.Mask"))')
    a('\t(pad "2" thru_hole circle (at 2.55 0) (size 1.8 1.8) (drill 1.0)')
    a('\t\t(layers "*.Cu" "*.Mask"))')
    a(")")
    out = PRETTY / "Fuse_PTC_Radial_5.1mm.kicad_mod"
    out.write_text("\n".join(lines) + "\n", encoding="utf-8")
    return out


def write_tvs_do41_footprint() -> Path:
    """THT axial TVS DO-41 / DO-15 (P6KE15A / 1.5KE18CA class)."""
    lines: list[str] = []
    a = lines.append
    a('(footprint "Diode_TVS_DO41"')
    a("\t(version 20240108)")
    a('\t(generator "gen_power_carrier.py")')
    a('\t(layer "F.Cu")')
    a(
        '\t(descr "Axial TVS DO-41 ~7.5mm pitch. Use P6KE15A or SMB equiv for 12V bus.")'
    )
    a('\t(tags "TVS diode surge")')
    a('\t(property "Reference" "D"')
    a("\t\t(at 0 -2.6 0)")
    a('\t\t(layer "F.SilkS")')
    a("\t\t(effects (font (size 1 1) (thickness 0.15)))")
    a("\t)")
    a('\t(property "Value" "P6KE15A"')
    a("\t\t(at 0 2.6 0)")
    a('\t\t(layer "F.SilkS")')
    a("\t\t(effects (font (size 0.8 0.8) (thickness 0.1)))")
    a("\t)")
    a("\t(attr through_hole)")
    a('\t(fp_rect (start -3.2 -1.5) (end 3.2 1.5) '
      '(stroke (width 0.12) (type solid)) (fill none) (layer "F.SilkS"))')
    a('\t(fp_line (start 2.2 -1.2) (end 2.2 1.2) '
      '(stroke (width 0.12) (type solid)) (layer "F.SilkS"))')
    a('\t(pad "1" thru_hole rect (at -3.75 0) (size 1.7 1.7) (drill 0.9)')
    a('\t\t(layers "*.Cu" "*.Mask"))')
    a('\t(pad "2" thru_hole circle (at 3.75 0) (size 1.7 1.7) (drill 0.9)')
    a('\t\t(layers "*.Cu" "*.Mask"))')
    a(")")
    out = PRETTY / "Diode_TVS_DO41.kicad_mod"
    out.write_text("\n".join(lines) + "\n", encoding="utf-8")
    return out


def write_esp32_footprint() -> Path:
    """ESP32-S3-DevKitC-1 female socket (2x22)."""
    y_last = (S3_PINS_PER_SIDE - 1) * PITCH
    x0, x1 = -1.8, ROW_SPACING + 1.8
    y0, y1 = -8.0, y_last + 3.0
    lines: list[str] = []
    a = lines.append
    a('(footprint "ESP32_S3_DevKitC_44Pin_Socket"')
    a("\t(version 20260206)")
    a('\t(generator "gen_power_carrier.py")')
    a('\t(generator_version "1.0")')
    a('\t(layer "F.Cu")')
    a('\t(descr "Female header socket for ESP32-S3-DevKitC-1 44-pin")')
    a('\t(tags "ESP32 DevKit socket 44-pin")')
    a('\t(property "Reference" "U**"')
    a('\t\t(at 12.7 -10.5 0)')
    a('\t\t(layer "F.SilkS")')
    a("\t\t(effects (font (size 1 1) (thickness 0.15)))")
    a("\t)")
    a('\t(property "Value" "ESP32_S3_DevKitC_44Pin_Socket"')
    a(f'\t\t(at 12.7 {y_last + 5.0} 0)')
    a('\t\t(layer "F.Fab")')
    a("\t\t(effects (font (size 1 1) (thickness 0.15)))")
    a("\t)")
    a('\t(property "Datasheet" "~"')
    a('\t\t(at 0 0 0)')
    a('\t\t(layer "F.Fab")')
    a("\t\t(hide yes)")
    a("\t\t(effects (font (size 1 1) (thickness 0.15)))")
    a("\t)")
    a('\t(property "Description" "ESP32-S3-DevKitC-1 44-pin socket"')
    a('\t\t(at 0 0 0)')
    a('\t\t(layer "F.Fab")')
    a("\t\t(hide yes)")
    a("\t\t(effects (font (size 1 1) (thickness 0.15)))")
    a("\t)")
    a("\t(attr through_hole)")
    for layer, w in (("F.CrtYd", 0.05), ("F.Fab", 0.1), ("F.SilkS", 0.12)):
        a("\t(fp_rect")
        a(f"\t\t(start {x0} {y0})")
        a(f"\t\t(end {x1} {y1})")
        a(f"\t\t(stroke (width {w}) (type solid))")
        a("\t\t(fill none)")
        a(f'\t\t(layer "{layer}")')
        a("\t)")
    a('\t(fp_text user "USB"')
    a(f"\t\t(at {ROW_SPACING / 2} {y0 + 2.5} 0)")
    a('\t\t(layer "F.SilkS")')
    a('\t\t(effects (font (size 0.8 0.8) (thickness 0.12)))')
    a("\t)")
    for num, name, _ in LEFT_PINS:
        y = (num - 1) * PITCH
        a(f'\t(fp_text user "{name}"')
        a(f"\t\t(at -3.2 {y} 0)")
        a('\t\t(layer "F.SilkS")')
        a('\t\t(effects (font (size 0.8 0.8) (thickness 0.12)) (justify right))')
        a("\t)")
        shape = "rect" if num == 1 else "circle"
        a(f'\t(pad "{num}" thru_hole {shape}')
        a(f"\t\t(at 0 {y})")
        a(f"\t\t(size {PAD_SIZE} {PAD_SIZE})")
        a(f"\t\t(drill {PAD_DRILL})")
        a('\t\t(layers "*.Cu" "*.Mask")')
        a("\t\t(remove_unused_layers no)")
        a("\t)")
    for num, name, _ in RIGHT_PINS:
        y = (num - 23) * PITCH
        a(f'\t(fp_text user "{name}"')
        a(f"\t\t(at {ROW_SPACING + 3.2} {y} 0)")
        a('\t\t(layer "F.SilkS")')
        a('\t\t(effects (font (size 0.8 0.8) (thickness 0.12)) (justify left))')
        a("\t)")
        a(f'\t(pad "{num}" thru_hole circle')
        a(f"\t\t(at {ROW_SPACING} {y})")
        a(f"\t\t(size {PAD_SIZE} {PAD_SIZE})")
        a(f"\t\t(drill {PAD_DRILL})")
        a('\t\t(layers "*.Cu" "*.Mask")')
        a("\t\t(remove_unused_layers no)")
        a("\t)")
    a(")")
    out = PRETTY / "ESP32_S3_DevKitC_44Pin_Socket.kicad_mod"
    out.write_text("\n".join(lines) + "\n", encoding="utf-8")
    return out


def _sym_prop(name: str, value: str, hide: bool = False) -> list[str]:
    lines = [
        f'\t\t(property "{name}" "{value}"',
        "\t\t\t(at 0 0 0)",
    ]
    if hide:
        lines.append("\t\t\t(hide yes)")
    lines.append("\t\t\t(effects (font (size 1.27 1.27)))")
    lines.append("\t\t)")
    return lines


def write_symbol_lib() -> Path:
    pin_ys = [26.67 - i * 2.54 for i in range(S3_PINS_PER_SIDE)]
    body_x = 12.7
    body_top = pin_ys[0] + 2.54
    body_bot = pin_ys[-1] - 2.54

    lines: list[str] = []
    a = lines.append
    a("(kicad_symbol_lib")
    a("\t(version 20251024)")
    a('\t(generator "gen_power_carrier.py")')
    a('\t(generator_version "1.0")')

    # --- ESP32 ---
    a('\t(symbol "ESP32_S3_DevKitC_1"')
    a("\t\t(exclude_from_sim no)")
    a("\t\t(in_bom yes)")
    a("\t\t(on_board yes)")
    a("\t\t(in_pos_files yes)")
    a('\t\t(property "Reference" "U"')
    a(f"\t\t\t(at 0 {body_top + 2.54} 0)")
    a("\t\t\t(effects (font (size 1.27 1.27)))")
    a("\t\t)")
    a('\t\t(property "Value" "ESP32_S3_DevKitC_1"')
    a(f"\t\t\t(at 0 {body_bot - 2.54} 0)")
    a("\t\t\t(effects (font (size 1.27 1.27)))")
    a("\t\t)")
    a('\t\t(property "Footprint" "STM32G030C8T6:ESP32_S3_DevKitC_44Pin_Socket"')
    a("\t\t\t(at 0 0 0)")
    a("\t\t\t(hide yes)")
    a("\t\t\t(effects (font (size 1.27 1.27)))")
    a("\t\t)")
    a('\t\t(property "Datasheet" "~"')
    a("\t\t\t(at 0 0 0)")
    a("\t\t\t(hide yes)")
    a("\t\t\t(effects (font (size 1.27 1.27)))")
    a("\t\t)")
    a('\t\t(property "Description" "ESP32-S3-DevKitC-1 44-pin socket"')
    a("\t\t\t(at 0 0 0)")
    a("\t\t\t(hide yes)")
    a("\t\t\t(effects (font (size 1.27 1.27)))")
    a("\t\t)")
    a('\t\t(symbol "ESP32_S3_DevKitC_1_0_1"')
    a("\t\t\t(rectangle")
    a(f"\t\t\t\t(start {-body_x} {body_top})")
    a(f"\t\t\t\t(end {body_x} {body_bot})")
    a("\t\t\t\t(stroke (width 0.254) (type default))")
    a("\t\t\t\t(fill (type background))")
    a("\t\t\t)")
    a("\t\t)")
    a('\t\t(symbol "ESP32_S3_DevKitC_1_1_1"')
    for (num, name, etype), y in zip(LEFT_PINS, pin_ys):
        a(f"\t\t\t(pin {etype} line")
        a(f"\t\t\t\t(at {-body_x - 5.08} {y} 0)")
        a("\t\t\t\t(length 5.08)")
        a(f'\t\t\t\t(name "{name}" (effects (font (size 1.27 1.27))))')
        a(f'\t\t\t\t(number "{num}" (effects (font (size 1.27 1.27))))')
        a("\t\t\t)")
    for (num, name, etype), y in zip(RIGHT_PINS, pin_ys):
        a(f"\t\t\t(pin {etype} line")
        a(f"\t\t\t\t(at {body_x + 5.08} {y} 180)")
        a("\t\t\t\t(length 5.08)")
        a(f'\t\t\t\t(name "{name}" (effects (font (size 1.27 1.27))))')
        a(f'\t\t\t\t(number "{num}" (effects (font (size 1.27 1.27))))')
        a("\t\t\t)")
    a("\t\t)")
    a("\t)")

    # --- MP1584EN ---
    a('\t(symbol "MP1584_5V3A"')
    a("\t\t(exclude_from_sim no)")
    a("\t\t(in_bom yes)")
    a("\t\t(on_board yes)")
    a("\t\t(in_pos_files yes)")
    a('\t\t(property "Reference" "U"')
    a("\t\t\t(at 0 8.89 0)")
    a("\t\t\t(effects (font (size 1.27 1.27)))")
    a("\t\t)")
    a('\t\t(property "Value" "MP1584_5V3A"')
    a("\t\t\t(at 0 -8.89 0)")
    a("\t\t\t(effects (font (size 1.27 1.27)))")
    a("\t\t)")
    a('\t\t(property "Footprint" "STM32G030C8T6:MP1584_5V3A"')
    a("\t\t\t(at 0 0 0)")
    a("\t\t\t(hide yes)")
    a("\t\t\t(effects (font (size 1.27 1.27)))")
    a("\t\t)")
    a('\t\t(property "Datasheet" "~"')
    a("\t\t\t(at 0 0 0)")
    a("\t\t\t(hide yes)")
    a("\t\t\t(effects (font (size 1.27 1.27)))")
    a("\t\t)")
    a(
        '\t\t(property "Description" '
        '"MP1584EN buck 12V→5V fixed Shopee 41383641614"'
    )
    a("\t\t\t(at 0 0 0)")
    a("\t\t\t(hide yes)")
    a("\t\t\t(effects (font (size 1.27 1.27)))")
    a("\t\t)")
    a('\t\t(symbol "MP1584_5V3A_0_1"')
    a("\t\t\t(rectangle")
    a("\t\t\t\t(start -7.62 6.35)")
    a("\t\t\t\t(end 7.62 -6.35)")
    a("\t\t\t\t(stroke (width 0.254) (type default))")
    a("\t\t\t\t(fill (type background))")
    a("\t\t\t)")
    a('\t\t\t(text "BUCK"')
    a("\t\t\t\t(at 0 0 0)")
    a("\t\t\t\t(effects (font (size 1.27 1.27)))")
    a("\t\t\t)")
    a("\t\t)")
    a('\t\t(symbol "MP1584_5V3A_1_1"')
    for num, name, etype, x, y, rot in [
        ("1", "VIN+", "passive", -12.7, 2.54, 0),
        ("2", "VIN-", "passive", -12.7, -2.54, 0),
        ("3", "VOUT+", "power_out", 12.7, 2.54, 180),
        ("4", "VOUT-", "passive", 12.7, -2.54, 180),
    ]:
        a(f"\t\t\t(pin {etype} line")
        a(f"\t\t\t\t(at {x} {y} {rot})")
        a("\t\t\t\t(length 5.08)")
        a(f'\t\t\t\t(name "{name}" (effects (font (size 1.27 1.27))))')
        a(f'\t\t\t\t(number "{num}" (effects (font (size 1.27 1.27))))')
        a("\t\t\t)")
    a("\t\t)")
    a("\t)")

    # --- Screw terminal ---
    a('\t(symbol "TerminalBlock_2P"')
    a("\t\t(exclude_from_sim no)")
    a("\t\t(in_bom yes)")
    a("\t\t(on_board yes)")
    a("\t\t(in_pos_files yes)")
    a('\t\t(property "Reference" "J"')
    a("\t\t\t(at 0 5.08 0)")
    a("\t\t\t(effects (font (size 1.27 1.27)))")
    a("\t\t)")
    a('\t\t(property "Value" "TerminalBlock_2P"')
    a("\t\t\t(at 0 -5.08 0)")
    a("\t\t\t(effects (font (size 1.27 1.27)))")
    a("\t\t)")
    a('\t\t(property "Footprint" "STM32G030C8T6:TerminalBlock_2P_5.0mm"')
    a("\t\t\t(at 0 0 0)")
    a("\t\t\t(hide yes)")
    a("\t\t\t(effects (font (size 1.27 1.27)))")
    a("\t\t)")
    a('\t\t(property "Datasheet" "~"')
    a("\t\t\t(at 0 0 0)")
    a("\t\t\t(hide yes)")
    a("\t\t\t(effects (font (size 1.27 1.27)))")
    a("\t\t)")
    a('\t\t(property "Description" "Screw terminal 2P for 12V-3A PSU"')
    a("\t\t\t(at 0 0 0)")
    a("\t\t\t(hide yes)")
    a("\t\t\t(effects (font (size 1.27 1.27)))")
    a("\t\t)")
    a('\t\t(symbol "TerminalBlock_2P_0_1"')
    a("\t\t\t(rectangle")
    a("\t\t\t\t(start -5.08 3.81)")
    a("\t\t\t\t(end 5.08 -3.81)")
    a("\t\t\t\t(stroke (width 0.254) (type default))")
    a("\t\t\t\t(fill (type background))")
    a("\t\t\t)")
    a('\t\t\t(text "SCREW"')
    a("\t\t\t\t(at 0 0 0)")
    a("\t\t\t\t(effects (font (size 1.016 1.016)))")
    a("\t\t\t)")
    a("\t\t)")
    a('\t\t(symbol "TerminalBlock_2P_1_1"')
    a("\t\t\t(pin passive line")
    a("\t\t\t\t(at -10.16 0 0)")
    a("\t\t\t\t(length 5.08)")
    a('\t\t\t\t(name "+12V" (effects (font (size 1.27 1.27))))')
    a('\t\t\t\t(number "1" (effects (font (size 1.27 1.27))))')
    a("\t\t\t)")
    a("\t\t\t(pin passive line")
    a("\t\t\t\t(at 10.16 0 180)")
    a("\t\t\t\t(length 5.08)")
    a('\t\t\t\t(name "GND" (effects (font (size 1.27 1.27))))')
    a('\t\t\t\t(number "2" (effects (font (size 1.27 1.27))))')
    a("\t\t\t)")
    a("\t\t)")
    a("\t)")

    # --- Top-side 1x4 motor header ---
    a('\t(symbol "Conn_1x04_Motor"')
    a("\t\t(exclude_from_sim no)")
    a("\t\t(in_bom yes)")
    a("\t\t(on_board yes)")
    a("\t\t(in_pos_files yes)")
    a('\t\t(property "Reference" "J"')
    a("\t\t\t(at 0 7.62 0)")
    a("\t\t\t(effects (font (size 1.27 1.27)))")
    a("\t\t)")
    a('\t\t(property "Value" "Conn_1x04_Motor"')
    a("\t\t\t(at 0 -7.62 0)")
    a("\t\t\t(effects (font (size 1.27 1.27)))")
    a("\t\t)")
    a('\t\t(property "Footprint" "STM32G030C8T6:PinHeader_1x04_Motor"')
    a("\t\t\t(at 0 0 0)")
    a("\t\t\t(hide yes)")
    a("\t\t\t(effects (font (size 1.27 1.27)))")
    a("\t\t)")
    a('\t\t(property "Description" "TOP: NEMA17 phases A2 A1 B1 B2"')
    a("\t\t\t(at 0 0 0)")
    a("\t\t\t(hide yes)")
    a("\t\t\t(effects (font (size 1.27 1.27)))")
    a("\t\t)")
    a('\t\t(symbol "Conn_1x04_Motor_0_1"')
    a("\t\t\t(rectangle")
    a("\t\t\t\t(start -2.54 5.08)")
    a("\t\t\t\t(end 2.54 -5.08)")
    a("\t\t\t\t(stroke (width 0.254) (type default))")
    a("\t\t\t\t(fill (type background))")
    a("\t\t\t)")
    a('\t\t\t(text "NEMA17"')
    a("\t\t\t\t(at 0 0 0)")
    a("\t\t\t\t(effects (font (size 1.016 1.016)))")
    a("\t\t\t)")
    a("\t\t)")
    a('\t\t(symbol "Conn_1x04_Motor_1_1"')
    for num, name, y in [
        ("1", "A2", 3.81),
        ("2", "A1", 1.27),
        ("3", "B1", -1.27),
        ("4", "B2", -3.81),
    ]:
        a("\t\t\t(pin passive line")
        a(f"\t\t\t\t(at 0 {y} 90)")
        a("\t\t\t\t(length 2.54)")
        a(f'\t\t\t\t(name "{name}" (effects (font (size 1.27 1.27))))')
        a(f'\t\t\t\t(number "{num}" (effects (font (size 1.27 1.27))))')
        a("\t\t\t)")
    a("\t\t)")
    a("\t)")

    # --- TMC2209 stepstick (used pins only) ---
    a('\t(symbol "TMC2209_StepStick"')
    a("\t\t(exclude_from_sim no)")
    a("\t\t(in_bom yes)")
    a("\t\t(on_board yes)")
    a("\t\t(in_pos_files yes)")
    a('\t\t(property "Reference" "U"')
    a("\t\t\t(at 0 12.7 0)")
    a("\t\t\t(effects (font (size 1.27 1.27)))")
    a("\t\t)")
    a('\t\t(property "Value" "TMC2209_StepStick"')
    a("\t\t\t(at 0 -12.7 0)")
    a("\t\t\t(effects (font (size 1.27 1.27)))")
    a("\t\t)")
    a('\t\t(property "Footprint" "STM32G030C8T6:TMC2209_StepStick"')
    a("\t\t\t(at 0 0 0)")
    a("\t\t\t(hide yes)")
    a("\t\t\t(effects (font (size 1.27 1.27)))")
    a("\t\t)")
    a('\t\t(property "Description" "TMC2209 stepper driver for NEMA17 (Shopee)"')
    a("\t\t\t(at 0 0 0)")
    a("\t\t\t(hide yes)")
    a("\t\t\t(effects (font (size 1.27 1.27)))")
    a("\t\t)")
    a('\t\t(symbol "TMC2209_StepStick_0_1"')
    a("\t\t\t(rectangle")
    a("\t\t\t\t(start -10.16 10.16)")
    a("\t\t\t\t(end 10.16 -10.16)")
    a("\t\t\t\t(stroke (width 0.254) (type default))")
    a("\t\t\t\t(fill (type background))")
    a("\t\t\t)")
    a('\t\t\t(text "TMC2209"')
    a("\t\t\t\t(at 0 0 0)")
    a("\t\t\t\t(effects (font (size 1.27 1.27)))")
    a("\t\t\t)")
    a("\t\t)")
    a('\t\t(symbol "TMC2209_StepStick_1_1"')
    for num, name, etype, x, y, rot in [
        ("9", "VM", "power_in", -15.24, 7.62, 0),
        ("10", "GND", "passive", -15.24, 5.08, 0),
        ("15", "VIO", "power_in", -15.24, 2.54, 0),
        ("1", "EN", "input", -15.24, -2.54, 0),
        # MS1/MS2/PDN/PDN2/CLK exist on the module and on the footprint. They
        # are left unconnected here, but the symbol still has to declare them:
        # a pad with no matching pin is a schematic-parity error.
        ("2", "MS1", "input", -15.24, -10.16, 0),
        ("3", "MS2", "input", -15.24, -12.7, 0),
        ("4", "PDN", "input", -15.24, -15.24, 0),
        ("5", "PDN2", "input", -15.24, -17.78, 0),
        ("6", "CLK", "input", -15.24, -20.32, 0),
        ("7", "STEP", "input", -15.24, -5.08, 0),
        ("8", "DIR", "input", -15.24, -7.62, 0),
        ("11", "A2", "passive", 15.24, 5.08, 180),
        ("12", "A1", "passive", 15.24, 2.54, 180),
        ("13", "B1", "passive", 15.24, -2.54, 180),
        ("14", "B2", "passive", 15.24, -5.08, 180),
        ("16", "GND2", "passive", 15.24, -7.62, 180),
    ]:
        a(f"\t\t\t(pin {etype} line")
        a(f"\t\t\t\t(at {x} {y} {rot})")
        a("\t\t\t\t(length 5.08)")
        a(f'\t\t\t\t(name "{name}" (effects (font (size 1.27 1.27))))')
        a(f'\t\t\t\t(number "{num}" (effects (font (size 1.27 1.27))))')
        a("\t\t\t)")
    a("\t\t)")
    a("\t)")




    # --- ULN2003AN DIP-16 ---
    a('\t(symbol "ULN2003AN"')
    a("\t\t(exclude_from_sim no)")
    a("\t\t(in_bom yes)")
    a("\t\t(on_board yes)")
    a("\t\t(in_pos_files yes)")
    a('\t\t(property "Reference" "U"')
    a("\t\t\t(at 0 12.7 0)")
    a("\t\t\t(effects (font (size 1.27 1.27)))")
    a("\t\t)")
    a('\t\t(property "Value" "ULN2003AN"')
    a("\t\t\t(at 0 -12.7 0)")
    a("\t\t\t(effects (font (size 1.27 1.27)))")
    a("\t\t)")
    a('\t\t(property "Footprint" "STM32G030C8T6:ULN2003AN"')
    a("\t\t\t(at 0 0 0)")
    a("\t\t\t(hide yes)")
    a("\t\t\t(effects (font (size 1.27 1.27)))")
    a("\t\t)")
    a('\t\t(property "Description" "ULN2003AN DIP-16 for 28BYJ-48; COM=+12V"')
    a("\t\t\t(at 0 0 0)")
    a("\t\t\t(hide yes)")
    a("\t\t\t(effects (font (size 1.27 1.27)))")
    a("\t\t)")
    a('\t\t(symbol "ULN2003AN_0_1"')
    a("\t\t\t(rectangle")
    a("\t\t\t\t(start -10.16 10.16)")
    a("\t\t\t\t(end 10.16 -10.16)")
    a("\t\t\t\t(stroke (width 0.254) (type default))")
    a("\t\t\t\t(fill (type background))")
    a("\t\t\t)")
    a('\t\t\t(text "ULN2003"')
    a("\t\t\t\t(at 0 0 0)")
    a("\t\t\t\t(effects (font (size 1.27 1.27)))")
    a("\t\t\t)")
    a("\t\t)")
    a('\t\t(symbol "ULN2003AN_1_1"')
    for num, name, etype, x, y, rot in [
        ("1", "IN1", "input", -15.24, 8.89, 0),
        ("2", "IN2", "input", -15.24, 6.35, 0),
        ("3", "IN3", "input", -15.24, 3.81, 0),
        ("4", "IN4", "input", -15.24, 1.27, 0),
        ("5", "IN5", "input", -15.24, -1.27, 0),
        ("6", "IN6", "input", -15.24, -3.81, 0),
        ("7", "IN7", "input", -15.24, -6.35, 0),
        ("8", "GND", "power_in", -15.24, -8.89, 0),
        ("9", "COM", "power_in", 15.24, -8.89, 180),
        ("10", "OUT7", "passive", 15.24, -6.35, 180),
        ("11", "OUT6", "passive", 15.24, -3.81, 180),
        ("12", "OUT5", "passive", 15.24, -1.27, 180),
        ("13", "OUT4", "passive", 15.24, 1.27, 180),
        ("14", "OUT3", "passive", 15.24, 3.81, 180),
        ("15", "OUT2", "passive", 15.24, 6.35, 180),
        ("16", "OUT1", "passive", 15.24, 8.89, 180),
    ]:
        a(f"\t\t\t(pin {etype} line")
        a(f"\t\t\t\t(at {x} {y} {rot})")
        a("\t\t\t\t(length 5.08)")
        a(f'\t\t\t\t(name "{name}" (effects (font (size 1.016 1.016))))')
        a(f'\t\t\t\t(number "{num}" (effects (font (size 1.016 1.016))))')
        a("\t\t\t)")
    a("\t\t)")
    a("\t)")

    # --- 74HC595 DIP-16 ---
    a('\t(symbol "74HC595"')
    a("\t\t(exclude_from_sim no)")
    a("\t\t(in_bom yes)")
    a("\t\t(on_board yes)")
    a("\t\t(in_pos_files yes)")
    a('\t\t(property "Reference" "U"')
    a("\t\t\t(at 0 12.7 0)")
    a("\t\t\t(effects (font (size 1.27 1.27)))")
    a("\t\t)")
    a('\t\t(property "Value" "74HC595"')
    a("\t\t\t(at 0 -12.7 0)")
    a("\t\t\t(effects (font (size 1.27 1.27)))")
    a("\t\t)")
    a('\t\t(property "Footprint" "STM32G030C8T6:74HC595"')
    a("\t\t\t(at 0 0 0)")
    a("\t\t\t(hide yes)")
    a("\t\t\t(effects (font (size 1.27 1.27)))")
    a("\t\t)")
    a('\t\t(property "Description" "74HC595 shift register VCC=3V3"')
    a("\t\t\t(at 0 0 0)")
    a("\t\t\t(hide yes)")
    a("\t\t\t(effects (font (size 1.27 1.27)))")
    a("\t\t)")
    a('\t\t(symbol "74HC595_0_1"')
    a("\t\t\t(rectangle")
    a("\t\t\t\t(start -10.16 10.16)")
    a("\t\t\t\t(end 10.16 -10.16)")
    a("\t\t\t\t(stroke (width 0.254) (type default))")
    a("\t\t\t\t(fill (type background))")
    a("\t\t\t)")
    a('\t\t\t(text "74HC595"')
    a("\t\t\t\t(at 0 0 0)")
    a("\t\t\t\t(effects (font (size 1.27 1.27)))")
    a("\t\t\t)")
    a("\t\t)")
    a('\t\t(symbol "74HC595_1_1"')
    for num, name, etype, x, y, rot in [
        ("1", "Q1", "output", -15.24, 8.89, 0),
        ("2", "Q2", "output", -15.24, 6.35, 0),
        ("3", "Q3", "output", -15.24, 3.81, 0),
        ("4", "Q4", "output", -15.24, 1.27, 0),
        ("5", "Q5", "output", -15.24, -1.27, 0),
        ("6", "Q6", "output", -15.24, -3.81, 0),
        ("7", "Q7", "output", -15.24, -6.35, 0),
        ("8", "GND", "power_in", -15.24, -8.89, 0),
        ("9", "QH", "output", 15.24, -8.89, 180),
        ("10", "SRCLR", "input", 15.24, -6.35, 180),
        ("11", "SRCLK", "input", 15.24, -3.81, 180),
        ("12", "RCLK", "input", 15.24, -1.27, 180),
        ("13", "OE", "input", 15.24, 1.27, 180),
        ("14", "SER", "input", 15.24, 3.81, 180),
        ("15", "Q0", "output", 15.24, 6.35, 180),
        ("16", "VCC", "power_in", 15.24, 8.89, 180),
    ]:
        a(f"\t\t\t(pin {etype} line")
        a(f"\t\t\t\t(at {x} {y} {rot})")
        a("\t\t\t\t(length 5.08)")
        a(f'\t\t\t\t(name "{name}" (effects (font (size 1.016 1.016))))')
        a(f'\t\t\t\t(number "{num}" (effects (font (size 1.016 1.016))))')
        a("\t\t\t)")
    a("\t\t)")
    a("\t)")

    a('\t(symbol "Conn_1x05_BYJ"')
    a("\t\t(exclude_from_sim no)")
    a("\t\t(in_bom yes)")
    a("\t\t(on_board yes)")
    a("\t\t(in_pos_files yes)")
    a('\t\t(property "Reference" "J"')
    a("\t\t\t(at 0 7.62 0)")
    a("\t\t\t(effects (font (size 1.27 1.27)))")
    a("\t\t)")
    a('\t\t(property "Value" "Conn_1x05_BYJ"')
    a("\t\t\t(at 0 -7.62 0)")
    a("\t\t\t(effects (font (size 1.27 1.27)))")
    a("\t\t)")
    a('\t\t(property "Footprint" "STM32G030C8T6:PinHeader_1x05_BYJ"')
    a("\t\t\t(at 0 0 0)")
    a("\t\t\t(hide yes)")
    a("\t\t\t(effects (font (size 1.27 1.27)))")
    a("\t\t)")
    a('\t\t(property "Description" "TOP: 28BYJ-48 JST-XH 5P A B C D +12V"')
    a("\t\t\t(at 0 0 0)")
    a("\t\t\t(hide yes)")
    a("\t\t\t(effects (font (size 1.27 1.27)))")
    a("\t\t)")
    a('\t\t(symbol "Conn_1x05_BYJ_0_1"')
    a("\t\t\t(rectangle")
    a("\t\t\t\t(start -2.54 6.35)")
    a("\t\t\t\t(end 2.54 -6.35)")
    a("\t\t\t\t(stroke (width 0.254) (type default))")
    a("\t\t\t\t(fill (type background))")
    a("\t\t\t)")
    a('\t\t\t(text "BYJ"')
    a("\t\t\t\t(at 0 0 0)")
    a("\t\t\t\t(effects (font (size 1.016 1.016)))")
    a("\t\t\t)")
    a("\t\t)")
    a('\t\t(symbol "Conn_1x05_BYJ_1_1"')
    for num, name, y in [("1", "A", 5.08), ("2", "B", 2.54), ("3", "C", 0), ("4", "D", -2.54), ("5", "+12V", -5.08)]:
        a("\t\t\t(pin passive line")
        a(f"\t\t\t\t(at 0 {y} 90)")
        a("\t\t\t\t(length 2.54)")
        a(f'\t\t\t\t(name "{name}" (effects (font (size 1.016 1.016))))')
        a(f'\t\t\t\t(number "{num}" (effects (font (size 1.016 1.016))))')
        a("\t\t\t)")
    a("\t\t)")
    a("\t)")

    a('\t(symbol "Conn_1x04_Endstop"')
    a("\t\t(exclude_from_sim no)")
    a("\t\t(in_bom yes)")
    a("\t\t(on_board yes)")
    a("\t\t(in_pos_files yes)")
    a('\t\t(property "Reference" "J"')
    a("\t\t\t(at 0 7.62 0)")
    a("\t\t\t(effects (font (size 1.27 1.27)))")
    a("\t\t)")
    a('\t\t(property "Value" "Conn_1x04_Endstop"')
    a("\t\t\t(at 0 -7.62 0)")
    a("\t\t\t(effects (font (size 1.27 1.27)))")
    a("\t\t)")
    a(f'\t\t(property "Footprint" "STM32G030C8T6:{ENDSTOP_FP}"')
    a("\t\t\t(at 0 0 0)")
    a("\t\t\t(hide yes)")
    a("\t\t\t(effects (font (size 1.27 1.27)))")
    a("\t\t)")
    a(
        '\t\t(property "Description" '
        '"TOP: CNC endstop 1x04; VCC/GND NC; SIG+SNS dry NC to opto"'
    )
    a("\t\t\t(at 0 0 0)")
    a("\t\t\t(hide yes)")
    a("\t\t\t(effects (font (size 1.27 1.27)))")
    a("\t\t)")
    a('\t\t(symbol "Conn_1x04_Endstop_0_1"')
    a("\t\t\t(rectangle")
    a("\t\t\t\t(start -2.54 5.08)")
    a("\t\t\t\t(end 2.54 -5.08)")
    a("\t\t\t\t(stroke (width 0.254) (type default))")
    a("\t\t\t\t(fill (type background))")
    a("\t\t\t)")
    a('\t\t\t(text "HOME"')
    a("\t\t\t\t(at 0 0 0)")
    a("\t\t\t\t(effects (font (size 1.016 1.016)))")
    a("\t\t\t)")
    a("\t\t)")
    a('\t\t(symbol "Conn_1x04_Endstop_1_1"')
    for num, name, y in [
        ("1", "VCC", 3.81),
        ("2", "GND", 1.27),
        ("3", "SIG", -1.27),
        ("4", "SNS", -3.81),
    ]:
        a("\t\t\t(pin passive line")
        a(f"\t\t\t\t(at 0 {y} 90)")
        a("\t\t\t\t(length 2.54)")
        a(f'\t\t\t\t(name "{name}" (effects (font (size 1.016 1.016))))')
        a(f'\t\t\t\t(number "{num}" (effects (font (size 1.016 1.016))))')
        a("\t\t\t)")
    a("\t\t)")
    a("\t)")

    a('\t(symbol "Conn_1x02_LimitSW"')
    a("\t\t(exclude_from_sim no)")
    a("\t\t(in_bom yes)")
    a("\t\t(on_board yes)")
    a("\t\t(in_pos_files yes)")
    a('\t\t(property "Reference" "J"')
    a("\t\t\t(at 0 5.08 0)")
    a("\t\t\t(effects (font (size 1.27 1.27)))")
    a("\t\t)")
    a('\t\t(property "Value" "Conn_1x02_LimitSW"')
    a("\t\t\t(at 0 -5.08 0)")
    a("\t\t\t(effects (font (size 1.27 1.27)))")
    a("\t\t)")
    a('\t\t(property "Footprint" "STM32G030C8T6:PinHeader_1x02_LimitSW"')
    a("\t\t\t(at 0 0 0)")
    a("\t\t\t(hide yes)")
    a("\t\t\t(effects (font (size 1.27 1.27)))")
    a("\t\t)")
    a('\t\t(property "Description" "TOP: limit SW NC @12V to opto (+12V / SW)"')
    a("\t\t\t(at 0 0 0)")
    a("\t\t\t(hide yes)")
    a("\t\t\t(effects (font (size 1.27 1.27)))")
    a("\t\t)")
    a('\t\t(symbol "Conn_1x02_LimitSW_0_1"')
    a("\t\t\t(rectangle")
    a("\t\t\t\t(start -2.54 3.81)")
    a("\t\t\t\t(end 2.54 -3.81)")
    a("\t\t\t\t(stroke (width 0.254) (type default))")
    a("\t\t\t\t(fill (type background))")
    a("\t\t\t)")
    a('\t\t\t(text "LIM"')
    a("\t\t\t\t(at 0 0 0)")
    a("\t\t\t\t(effects (font (size 1.016 1.016)))")
    a("\t\t\t)")
    a("\t\t)")
    a('\t\t(symbol "Conn_1x02_LimitSW_1_1"')
    for num, name, y in [("1", "+12V", 1.27), ("2", "SW", -1.27)]:
        a("\t\t\t(pin passive line")
        a(f"\t\t\t\t(at 0 {y} 90)")
        a("\t\t\t\t(length 2.54)")
        a(f'\t\t\t\t(name "{name}" (effects (font (size 1.27 1.27))))')
        a(f'\t\t\t\t(number "{num}" (effects (font (size 1.27 1.27))))')
        a("\t\t\t)")
    a("\t\t)")
    a("\t)")


    a('\t(symbol "Conn_1x04_BUP30S"')
    a("\t\t(exclude_from_sim no)")
    a("\t\t(in_bom yes)")
    a("\t\t(on_board yes)")
    a("\t\t(in_pos_files yes)")
    a('\t\t(property "Reference" "J"')
    a("\t\t\t(at 0 7.62 0)")
    a("\t\t\t(effects (font (size 1.27 1.27)))")
    a("\t\t)")
    a('\t\t(property "Value" "Conn_1x04_BUP30S"')
    a("\t\t\t(at 0 -7.62 0)")
    a("\t\t\t(effects (font (size 1.27 1.27)))")
    a("\t\t)")
    a('\t\t(property "Footprint" "STM32G030C8T6:PinHeader_1x04_BUP30S"')
    a("\t\t\t(at 0 0 0)")
    a("\t\t\t(hide yes)")
    a("\t\t\t(effects (font (size 1.27 1.27)))")
    a("\t\t)")
    a('\t\t(property "Description" "TOP: Autonics BUP-30S NPN 12V -> OPTO_IN4"')
    a("\t\t\t(at 0 0 0)")
    a("\t\t\t(hide yes)")
    a("\t\t\t(effects (font (size 1.27 1.27)))")
    a("\t\t)")
    a('\t\t(symbol "Conn_1x04_BUP30S_0_1"')
    a("\t\t\t(rectangle")
    a("\t\t\t\t(start -2.54 5.08)")
    a("\t\t\t\t(end 2.54 -5.08)")
    a("\t\t\t\t(stroke (width 0.254) (type default))")
    a("\t\t\t\t(fill (type background))")
    a("\t\t\t)")
    a('\t\t\t(text "BUP30S"')
    a("\t\t\t\t(at 0 0 0)")
    a("\t\t\t\t(effects (font (size 0.9 0.9)))")
    a("\t\t\t)")
    a("\t\t)")
    a('\t\t(symbol "Conn_1x04_BUP30S_1_1"')
    for num, name, y in [
        ("1", "+12V", 3.81),
        ("2", "GND", 1.27),
        ("3", "OUT", -1.27),
        ("4", "CTRL", -3.81),
    ]:
        a("\t\t\t(pin passive line")
        a(f"\t\t\t\t(at 0 {y} 90)")
        a("\t\t\t\t(length 2.54)")
        a(f'\t\t\t\t(name "{name}" (effects (font (size 1.016 1.016))))')
        a(f'\t\t\t\t(number "{num}" (effects (font (size 1.016 1.016))))')
        a("\t\t\t)")
    a("\t\t)")
    a("\t)")

    a('\t(symbol "R_BUP_Pullup"')
    a("\t\t(exclude_from_sim no)")
    a("\t\t(in_bom yes)")
    a("\t\t(on_board yes)")
    a("\t\t(in_pos_files yes)")
    a('\t\t(property "Reference" "R"')
    a("\t\t\t(at 0 2.54 0)")
    a("\t\t\t(effects (font (size 1.27 1.27)))")
    a("\t\t)")
    a('\t\t(property "Value" "4k7"')
    a("\t\t\t(at 0 -2.54 0)")
    a("\t\t\t(effects (font (size 1.27 1.27)))")
    a("\t\t)")
    a('\t\t(property "Footprint" "STM32G030C8T6:R_Axial_4k7_BUP"')
    a("\t\t\t(at 0 0 0)")
    a("\t\t\t(hide yes)")
    a("\t\t\t(effects (font (size 1.27 1.27)))")
    a("\t\t)")
    a('\t\t(symbol "R_BUP_Pullup_0_1"')
    a("\t\t\t(rectangle")
    a("\t\t\t\t(start -1.016 2.54)")
    a("\t\t\t\t(end 1.016 -2.54)")
    a("\t\t\t\t(stroke (width 0.254) (type default))")
    a("\t\t\t\t(fill (type none))")
    a("\t\t\t)")
    a("\t\t)")
    a('\t\t(symbol "R_BUP_Pullup_1_1"')
    a("\t\t\t(pin passive line")
    a("\t\t\t\t(at 0 3.81 270)")
    a("\t\t\t\t(length 1.27)")
    a('\t\t\t\t(name "~" (effects (font (size 1.27 1.27))))')
    a('\t\t\t\t(number "1" (effects (font (size 1.27 1.27))))')
    a("\t\t\t)")
    a("\t\t\t(pin passive line")
    a("\t\t\t\t(at 0 -3.81 90)")
    a("\t\t\t\t(length 1.27)")
    a('\t\t\t\t(name "~" (effects (font (size 1.27 1.27))))')
    a('\t\t\t\t(number "2" (effects (font (size 1.27 1.27))))')
    a("\t\t\t)")
    a("\t\t)")
    a("\t)")

    # --- PC817 DIP-4 (discrete) ---
    a('\t(symbol "PC817_DIP4"')
    a("\t\t(pin_names")
    a("\t\t\t(offset 1.016)")
    a("\t\t)")
    a("\t\t(exclude_from_sim no)")
    a("\t\t(in_bom yes)")
    a("\t\t(on_board yes)")
    a('\t\t(property "Reference" "U"')
    a("\t\t\t(at 0 5.08 0)")
    a('\t\t\t(effects (font (size 1.27 1.27)))')
    a("\t\t)")
    a('\t\t(property "Value" "PC817_DIP4"')
    a("\t\t\t(at 0 -5.08 0)")
    a('\t\t\t(effects (font (size 1.27 1.27)))')
    a("\t\t)")
    a('\t\t(property "Footprint" "STM32G030C8T6:PC817_DIP4"')
    a("\t\t\t(at 0 0 0)")
    a('\t\t\t(effects (font (size 1.27 1.27)) (hide yes))')
    a("\t\t)")
    a('\t\t(property "Datasheet" "~"')
    a("\t\t\t(at 0 0 0)")
    a('\t\t\t(effects (font (size 1.27 1.27)) (hide yes))')
    a("\t\t)")
    a('\t\t(property "Description" "PC817 optocoupler DIP-4 A/K/E/C"')
    a("\t\t\t(at 0 0 0)")
    a('\t\t\t(effects (font (size 1.27 1.27)) (hide yes))')
    a("\t\t)")
    a('\t\t(symbol "PC817_DIP4_0_1"')
    a("\t\t\t(rectangle")
    a("\t\t\t\t(start -5.08 3.81)")
    a("\t\t\t\t(end 5.08 -3.81)")
    a("\t\t\t\t(stroke (width 0.254) (type default))")
    a("\t\t\t\t(fill (type background))")
    a("\t\t\t)")
    a("\t\t)")
    a('\t\t(symbol "PC817_DIP4_1_1"')
    for num, name, x, y, etype in [
        ("1", "A", -7.62, 2.54, "passive"),
        ("2", "K", -7.62, -2.54, "passive"),
        ("3", "E", 7.62, -2.54, "passive"),
        ("4", "C", 7.62, 2.54, "passive"),
    ]:
        a(f'\t\t\t(pin {etype} line')
        a(f"\t\t\t\t(at {x} {y} {180 if x < 0 else 0})")
        a("\t\t\t\t(length 2.54)")
        a(f'\t\t\t\t(name "{name}" (effects (font (size 1.016 1.016))))')
        a(f'\t\t\t\t(number "{num}" (effects (font (size 1.016 1.016))))')
        a("\t\t\t)")
    a("\t\t)")
    a("\t)")

    # --- Top field header for opto IN (1x06 HOME+BUP) ---
    a(f'\t(symbol "{OPTO_FIELD_SYM}"')
    a("\t\t(exclude_from_sim no)")
    a("\t\t(in_bom yes)")
    a("\t\t(on_board yes)")
    a("\t\t(in_pos_files yes)")
    a('\t\t(property "Reference" "J"')
    a("\t\t\t(at 0 15.24 0)")
    a("\t\t\t(effects (font (size 1.27 1.27)))")
    a("\t\t)")
    a(f'\t\t(property "Value" "{OPTO_FIELD_SYM}"')
    a("\t\t\t(at 0 -15.24 0)")
    a("\t\t\t(effects (font (size 1.27 1.27)))")
    a("\t\t)")
    a(f'\t\t(property "Footprint" "STM32G030C8T6:{OPTO_FIELD_FP}"')
    a("\t\t\t(at 0 0 0)")
    a("\t\t\t(hide yes)")
    a("\t\t\t(effects (font (size 1.27 1.27)))")
    a("\t\t)")
    a('\t\t(property "Description" "TOP: opto field GND/VCC + IN1-4 (HOME+BUP)"')
    a("\t\t\t(at 0 0 0)")
    a("\t\t\t(hide yes)")
    a("\t\t\t(effects (font (size 1.27 1.27)))")
    a("\t\t)")
    a(f'\t\t(symbol "{OPTO_FIELD_SYM}_0_1"')
    a("\t\t\t(rectangle")
    a("\t\t\t\t(start -2.54 7.62)")
    a("\t\t\t\t(end 2.54 -7.62)")
    a("\t\t\t\t(stroke (width 0.254) (type default))")
    a("\t\t\t\t(fill (type background))")
    a("\t\t\t)")
    a('\t\t\t(text "OPTO_IN"')
    a("\t\t\t\t(at 0 0 0)")
    a("\t\t\t\t(effects (font (size 1.016 1.016)))")
    a("\t\t\t)")
    a("\t\t)")
    a(f'\t\t(symbol "{OPTO_FIELD_SYM}_1_1"')
    for i, (num, name) in enumerate(OPTO_FIELD_HEADER):
        y = 6.35 - i * 2.54
        a("\t\t\t(pin passive line")
        a(f"\t\t\t\t(at 0 {y} 90)")
        a("\t\t\t\t(length 2.54)")
        a(f'\t\t\t\t(name "{name}" (effects (font (size 1.016 1.016))))')
        a(f'\t\t\t\t(number "{num}" (effects (font (size 1.016 1.016))))')
        a("\t\t\t)")
    a("\t\t)")
    a("\t)")

    # --- TFT: Conn_1x09 LCD + Conn_1x05 touch (MSP3520 order) ---
    def _emit_conn_header_sym(sym: str, fp: str, header: list, title: str, descr: str):
        n = len(header)
        a(f'\t(symbol "{sym}"')
        a("\t\t(exclude_from_sim no)")
        a("\t\t(in_bom yes)")
        a("\t\t(on_board yes)")
        a("\t\t(in_pos_files yes)")
        a('\t\t(property "Reference" "J"')
        a("\t\t\t(at 0 10.16 0)")
        a("\t\t\t(effects (font (size 1.27 1.27)))")
        a("\t\t)")
        a(f'\t\t(property "Value" "{sym}"')
        a("\t\t\t(at 0 -10.16 0)")
        a("\t\t\t(effects (font (size 1.27 1.27)))")
        a("\t\t)")
        a(f'\t\t(property "Footprint" "STM32G030C8T6:{fp}"')
        a("\t\t\t(at 0 0 0)")
        a("\t\t\t(hide yes)")
        a("\t\t\t(effects (font (size 1.27 1.27)))")
        a("\t\t)")
        a(f'\t\t(property "Description" "{descr}"')
        a("\t\t\t(at 0 0 0)")
        a("\t\t\t(hide yes)")
        a("\t\t\t(effects (font (size 1.27 1.27)))")
        a("\t\t)")
        half = (n - 1) * 1.27 + 1.27
        a(f'\t\t(symbol "{sym}_0_1"')
        a("\t\t\t(rectangle")
        a(f"\t\t\t\t(start -2.54 {half})")
        a(f"\t\t\t\t(end 2.54 {-half})")
        a("\t\t\t\t(stroke (width 0.254) (type default))")
        a("\t\t\t\t(fill (type background))")
        a("\t\t\t)")
        a(f'\t\t\t(text "{title}"')
        a("\t\t\t\t(at 0 0 0)")
        a("\t\t\t\t(effects (font (size 1.016 1.016)))")
        a("\t\t\t)")
        a("\t\t)")
        a(f'\t\t(symbol "{sym}_1_1"')
        for (num, name), y in zip(
            header,
            [(n - 1) * 1.27 - i * 2.54 for i in range(n)],
        ):
            a("\t\t\t(pin passive line")
            a(f"\t\t\t\t(at 0 {y} 90)")
            a("\t\t\t\t(length 2.54)")
            a(f'\t\t\t\t(name "{name}" (effects (font (size 1.27 1.27))))')
            a(f'\t\t\t\t(number "{num}" (effects (font (size 1.27 1.27))))')
            a("\t\t\t)")
        a("\t\t)")
        a("\t)")

    _emit_conn_header_sym(
        TFT_LCD_SYM, TFT_LCD_FP, TFT_LCD_HEADER, "TFT LCD",
        "MSP3520 pins1-9 LCD: VCC GND CS RESET DC SDI SCK LED SDO",
    )
    _emit_conn_header_sym(
        TFT_TP_SYM, TFT_TP_FP, TFT_TP_HEADER, "TFT TP",
        "MSP3520 pins10-14 touch: T_CLK T_CS T_DIN T_DO T_IRQ",
    )
    _emit_conn_header_sym(
        OPTO_IN_SYM, OPTO_IN_FP, OPTO_IN_HEADER, "1x6 M2-IN",
        "J31A 1x6 pin — M2 field IN + SNS/GND",
    )
    _emit_conn_header_sym(
        OPTO_OUT_SYM, OPTO_OUT_FP, OPTO_OUT_HEADER, "1x5 M2-OUT",
        "J31B 1x5 pin — M2 OUT + 3V3",
    )
    _emit_conn_header_sym(
        ENDSTOP_SYM, ENDSTOP_FP, ENDSTOP_HEADER, "HOME XH2",
        "Dry NC limit JST-XH 2P SIG/SNS",
    )

    # --- J18 EC11 encoder ---
    a(f'\t(symbol "{ENC_SYM}"')
    a("\t\t(exclude_from_sim no)")
    a("\t\t(in_bom yes)")
    a("\t\t(on_board yes)")
    a("\t\t(in_pos_files yes)")
    a('\t\t(property "Reference" "J"')
    a("\t\t\t(at 0 7.62 0)")
    a("\t\t\t(effects (font (size 1.27 1.27)))")
    a("\t\t)")
    a(f'\t\t(property "Value" "{ENC_SYM}"')
    a("\t\t\t(at 0 -7.62 0)")
    a("\t\t\t(effects (font (size 1.27 1.27)))")
    a("\t\t)")
    a(f'\t\t(property "Footprint" "STM32G030C8T6:{ENC_FP}"')
    a("\t\t\t(at 0 0 0)")
    a("\t\t\t(hide yes)")
    a("\t\t\t(effects (font (size 1.27 1.27)))")
    a("\t\t)")
    a(
        '\t\t(property "Description" '
        '"Wall-mount EC11/KY-040 jack: GND 3V3 ENC_A ENC_B (no SW)"'
    )
    a("\t\t\t(at 0 0 0)")
    a("\t\t\t(hide yes)")
    a("\t\t\t(effects (font (size 1.27 1.27)))")
    a("\t\t)")
    _eh = (ENC_PINS - 1) * 1.27 + 1.27
    a(f'\t\t(symbol "{ENC_SYM}_0_1"')
    a("\t\t\t(rectangle")
    a(f"\t\t\t\t(start -2.54 {_eh})")
    a(f"\t\t\t\t(end 2.54 {-_eh})")
    a("\t\t\t\t(stroke (width 0.254) (type default))")
    a("\t\t\t\t(fill (type background))")
    a("\t\t\t)")
    a('\t\t\t(text "ENC"')
    a("\t\t\t\t(at 0 0 0)")
    a("\t\t\t\t(effects (font (size 1.016 1.016)))")
    a("\t\t\t)")
    a("\t\t)")
    a(f'\t\t(symbol "{ENC_SYM}_1_1"')
    for (num, name), y in zip(
        ENC_HEADER,
        [(ENC_PINS - 1) * 1.27 - i * 2.54 for i in range(ENC_PINS)],
    ):
        a("\t\t\t(pin passive line")
        a(f"\t\t\t\t(at 0 {y} 90)")
        a("\t\t\t\t(length 2.54)")
        a(f'\t\t\t\t(name "{name}" (effects (font (size 1.27 1.27))))')
        a(f'\t\t\t\t(number "{num}" (effects (font (size 1.27 1.27))))')
        a("\t\t\t)")
    a("\t\t)")
    a("\t)")

    a(")")
    out = LIB / "STM32G030C8T6.kicad_sym"
    out.write_text("\n".join(lines) + "\n", encoding="utf-8")
    return out



def write_lib_tables() -> None:
    (ROOT / "fp-lib-table").write_text(
        "(fp_lib_table\n"
        "  (version 7)\n"
        '  (lib (name "STM32G030C8T6")(type "KiCad")'
        '(uri "${KIPRJMOD}/libraries/STM32G030C8T6.pretty")'
        '(options "")(descr "STM32G030C8T6 footprints"))\n'
        ")\n",
        encoding="utf-8",
    )
    (ROOT / "sym-lib-table").write_text(
        "(sym_lib_table\n"
        "  (version 7)\n"
        '  (lib (name "STM32G030C8T6")(type "KiCad")'
        '(uri "${KIPRJMOD}/libraries/STM32G030C8T6.kicad_sym")'
        '(options "")(descr "STM32G030C8T6 symbols"))\n'
        ")\n",
        encoding="utf-8",
    )


def _embed_from_lib(sym_name: str) -> str:
    """Extract symbol block and rewrite name as Lib:Name for schematic embed."""
    text = (LIB / "STM32G030C8T6.kicad_sym").read_text(encoding="utf-8")
    key = f'(symbol "{sym_name}"'
    start = text.index(key)
    # Find matching close of this symbol at depth 1 inside lib
    i = start
    depth = 0
    end = None
    while i < len(text):
        if text[i] == "(":
            depth += 1
        elif text[i] == ")":
            depth -= 1
            if depth == 0:
                end = i + 1
                break
        i += 1
    assert end is not None
    block = text[start:end]
    block = block.replace(f'(symbol "{sym_name}"', f'(symbol "STM32G030C8T6:{sym_name}"', 1)
    # indent one more tab for lib_symbols
    return "\n".join("\t" + ln if ln else ln for ln in block.splitlines())


def write_schematic() -> Path:
    sch_uuid = uid()
    j1_uuid = uid()
    u2_uuid = uid()
    u1_uuid = uid()

    emb_j = _embed_from_lib("TerminalBlock_2P")
    emb_m = _embed_from_lib("MP1584_5V3A")
    emb_e = _embed_from_lib("ESP32_S3_DevKitC_1")

    # Positions (mm): left = power in, middle = buck, right = ESP32
    # J1 at (40, 50), U2 at (95, 50), U1 at (170, 70)
    lines = [
        "(kicad_sch",
        "\t(version 20250114)",
        '\t(generator "gen_power_carrier.py")',
        '\t(generator_version "1.0")',
        f'\t(uuid "{sch_uuid}")',
        '\t(paper "A4")',
        "\t(title_block",
        '\t\t(title "ESP32 Baseboard - 12V->5V MP1584EN")',
        '\t\t(comment 1 "J1 screw 12V-3A -> U2 MP1584EN -> U1 ESP32-S3 5V")',
        '\t\t(comment 2 "Ready-made modules on carrier PCB")',
        "\t)",
        "\t(lib_symbols",
        emb_j,
        emb_m,
        emb_e,
        "\t)",
        # --- J1 Terminal ---
        f'\t(symbol (lib_id "STM32G030C8T6:TerminalBlock_2P") (at 38.1 50.8 0) (unit 1)',
        f'\t\t(uuid "{j1_uuid}")',
        '\t\t(property "Reference" "J1" (at 38.1 43.18 0)',
        "\t\t\t(effects (font (size 1.27 1.27)))",
        "\t\t)",
        '\t\t(property "Value" "Screw_12V_IN" (at 38.1 58.42 0)',
        "\t\t\t(effects (font (size 1.27 1.27)))",
        "\t\t)",
        '\t\t(property "Footprint" "STM32G030C8T6:TerminalBlock_2P_5.0mm" (at 38.1 50.8 0)',
        "\t\t\t(effects (font (size 1.27 1.27)) (hide yes))",
        "\t\t)",
        '\t\t(property "Datasheet" "~" (at 38.1 50.8 0)',
        "\t\t\t(effects (font (size 1.27 1.27)) (hide yes))",
        "\t\t)",
        "\t\t(pin \"1\" (uuid \"" + uid() + "\"))",
        "\t\t(pin \"2\" (uuid \"" + uid() + "\"))",
        "\t\t(instances",
        f'\t\t\t(project "STM32G030C8T6" (path "/{sch_uuid}" (reference "J1") (unit 1)))',
        "\t\t)",
        "\t)",
        # --- U2 MP1584EN ---
        f'\t(symbol (lib_id "STM32G030C8T6:MP1584_5V3A") (at 88.9 50.8 0) (unit 1)',
        f'\t\t(uuid "{u2_uuid}")',
        '\t\t(property "Reference" "U2" (at 88.9 40.64 0)',
        "\t\t\t(effects (font (size 1.27 1.27)))",
        "\t\t)",
        '\t\t(property "Value" "MP1584_5V3A" (at 88.9 60.96 0)',
        "\t\t\t(effects (font (size 1.27 1.27)))",
        "\t\t)",
        '\t\t(property "Footprint" "STM32G030C8T6:MP1584_5V3A" (at 88.9 50.8 0)',
        "\t\t\t(effects (font (size 1.27 1.27)) (hide yes))",
        "\t\t)",
        '\t\t(property "Datasheet" "~" (at 88.9 50.8 0)',
        "\t\t\t(effects (font (size 1.27 1.27)) (hide yes))",
        "\t\t)",
        "\t\t(pin \"1\" (uuid \"" + uid() + "\"))",
        "\t\t(pin \"2\" (uuid \"" + uid() + "\"))",
        "\t\t(pin \"3\" (uuid \"" + uid() + "\"))",
        "\t\t(pin \"4\" (uuid \"" + uid() + "\"))",
        "\t\t(instances",
        f'\t\t\t(project "STM32G030C8T6" (path "/{sch_uuid}" (reference "U2") (unit 1)))',
        "\t\t)",
        "\t)",
        # --- U1 ESP32 ---
        f'\t(symbol (lib_id "STM32G030C8T6:ESP32_S3_DevKitC_1") (at 165.1 76.2 0) (unit 1)',
        f'\t\t(uuid "{u1_uuid}")',
        '\t\t(property "Reference" "U1" (at 165.1 50.8 0)',
        "\t\t\t(effects (font (size 1.27 1.27)))",
        "\t\t)",
        '\t\t(property "Value" "ESP32_S3_DevKitC_1" (at 165.1 101.6 0)',
        "\t\t\t(effects (font (size 1.27 1.27)))",
        "\t\t)",
        '\t\t(property "Footprint" "STM32G030C8T6:ESP32_S3_DevKitC_44Pin_Socket" (at 165.1 76.2 0)',
        "\t\t\t(effects (font (size 1.27 1.27)) (hide yes))",
        "\t\t)",
        '\t\t(property "Datasheet" "~" (at 165.1 76.2 0)',
        "\t\t\t(effects (font (size 1.27 1.27)) (hide yes))",
        "\t\t)",
    ]
    for n in range(1, 31):
        lines.append(f'\t\t(pin "{n}" (uuid "{uid()}"))')
    lines += [
        "\t\t(instances",
        f'\t\t\t(project "STM32G030C8T6" (path "/{sch_uuid}" (reference "U1") (unit 1)))',
        "\t\t)",
        "\t)",
        # Labels / wires: J1.1 -> +12V -> U2.1 ; J1.2/U2.2/U2.4/U1.17 -> GND ; U2.3 -> +5V -> U1.16
        # Wire J1 pin1 (27.94, 50.8) to U2 pin1 (76.2, 53.34)
        '\t(wire (pts (xy 27.94 50.8) (xy 27.94 40.64) (xy 76.2 40.64) (xy 76.2 53.34))',
        f'\t\t(stroke (width 0) (type default)) (uuid "{uid()}"))',
        '\t(label "+12V" (at 50.8 40.64 0) (fields_autoplaced)',
        f'\t\t(effects (font (size 1.27 1.27)) (justify left bottom)) (uuid "{uid()}"))',
        # GND from J1.2
        '\t(wire (pts (xy 48.26 50.8) (xy 55.88 50.8) (xy 55.88 66.04) (xy 76.2 66.04) (xy 76.2 53.34))',
        f'\t\t(stroke (width 0) (type default)) (uuid "{uid()}"))',
        # Wait - U2 VIN- is at (76.2, 48.26) for pin2: symbol at 88.9, pin2 at x-12.7 = 76.2, y-2.54 = 48.26
        # Fix GND wire to pin2 and pin4
    ]
    # Recalculate pin positions carefully:
    # J1 at (38.1, 50.8): pin1 at 38.1-10.16=27.94, pin2 at 38.1+10.16=48.26, both y=50.8
    # U2 at (88.9, 50.8):
    #   pin1 VIN+ (-12.7, +2.54) -> (76.2, 53.34)
    #   pin2 VIN- (-12.7, -2.54) -> (76.2, 48.26)
    #   pin3 VOUT+ (+12.7, +2.54) -> (101.6, 53.34)
    #   pin4 VOUT- (+12.7, -2.54) -> (101.6, 48.26)
    # U1 at (165.1, 76.2):
    #   VIN pin16 at (+12.7+5.08, +17.78) = (182.88, 93.98)
    #   GND pin17 at (+12.7+5.08, +15.24) = (182.88, 91.44)
    # Actually pin positions are relative to symbol center:
    # RIGHT pins at body_x+5.08 = 17.78 from center
    # pin16 VIN at y = +17.78 -> (165.1+17.78, 76.2-17.78)? 
    # In KiCad, +Y is up in schematic... Actually in KiCad schematic Y increases downward!
    # Symbol pin at (at 17.78 17.78 180) means local coords; when symbol at (165.1, 76.2),
    # pin world = (165.1+17.78, 76.2-17.78) if Y flipped... 
    # KiCad: local +Y of pin goes UP on screen which is DECREASING global Y.
    # Global pin = (at_x + local_x, at_y - local_y) for rotation 0.
    # U1 pin16: local (17.78, 17.78) -> (182.88, 58.42)
    # U1 pin17: local (17.78, 15.24) -> (182.88, 60.96)
    # U1 pin2 GND left: local (-17.78, 15.24) -> (147.32, 60.96)

    # Rebuild wires section properly - replace the broken wire section
    # We'll rewrite the whole file more carefully instead of appending broken wires.

    # Actually the code above already started writing bad wires. Let me rewrite write_schematic completely.
    raise RuntimeError("internal: use write_schematic_v2")
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
