nguyenduchan/coutingmachine/firmware/Core/Src/main.c

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

#include "main.h"
#include "app.h"
#include "board_motors.h"

void SystemClock_Config(void);
static void MX_GPIO_Init(void);

/**
  * @brief  The application entry point.
  */
int main(void)
{
  HAL_Init();

  SystemClock_Config();

  MX_GPIO_Init();

  /* USER CODE BEGIN 2 */
  App_Init();
  /* USER CODE END 2 */

  /* Infinite loop */
  /* USER CODE BEGIN WHILE */
  while (1)
  {
    App_Loop();
    /* USER CODE END WHILE */

    /* USER CODE BEGIN 3 */
  }
  /* USER CODE END 3 */
}

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
