nguyenduchan/coutingmachine/pcb/STM32G030C8T6/route_freerouting.py

#!/usr/bin/env python3
r"""Route the carrier with FreeRouting instead of the in-house maze router.

Pipeline, fully scriptable:
    gen_power_carrier.py   placement + nets (the part that needs judgement)
    ExportSpecctraDSN      hand KiCad's real design rules to the router
    freerouting            industrial autorouter: reads per-netclass clearance
                           and widths from the DSN, does rip-up/reroute and
                           push-and-shove, then optimises
    ImportSpecctraSES      pull the result back into the board
    verify_drc.py          KiCad's own DRC has the last word

Why bother: the in-house router searches on a 0.55 mm grid whose occupancy map
holds one net id per cell, so it cannot express "this cell is 0.30 mm from a
0.70 mm track". FreeRouting works on real geometry and real rules.

Run with the KiCad-bundled Python (it owns the pcbnew module):
    "%LOCALAPPDATA%\Programs\KiCad.0in\python.exe" route_freerouting.py
"""
from __future__ import annotations

import os
import re
import shutil
import subprocess
import sys
from pathlib import Path

HERE = Path(__file__).resolve().parent
PCB = HERE / "STM32G030C8T6.kicad_pcb"
DSN = HERE / "out_freerouting" / "STM32G030C8T6.dsn"
SES = HERE / "out_freerouting" / "STM32G030C8T6.ses"
UNROUTED = HERE / "out_freerouting" / "unrouted.kicad_pcb"
ROUTED = HERE / "out_freerouting" / "routed.kicad_pcb"

# Tuning handed to the autorouter. Raise passes if nets are left unrouted.
# Via cost: moderate — A0 wants pad→via→B.Cu fan-out, so vias are expected;
# too-high -vc keeps long runs on F under modules (violates A0).
# -mt 1 is not optional: FreeRouting itself warns that multi-threaded
# optimisation "is known to generate clearance violations".
# (passes, via cost) per attempt: different effort settings give different
# results, and the loop stops at the first that routes everything.
# A0: pad→via→B.Cu. Start with moderate via cost so FR fans out instead of
# laying long F.Cu buses under modules (high -vc does that).
FR_ATTEMPTS = ((80, 40), (100, 25), (120, 50),
               (160, 90), (200, 50), (80, 25))
if os.environ.get("FR_ATTEMPTS"):
    FR_ATTEMPTS = tuple(
        tuple(int(x) for x in p.split(":"))
        for p in os.environ["FR_ATTEMPTS"].split(",")
    )
FR_THREADS = 1
FR_TIMEOUT_S = int(os.environ.get("FR_TIMEOUT_S", "900"))
if os.environ.get("FR_QUICK") == "1":
    FR_TIMEOUT_S = 420
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
