nguyenduchan/coutingmachine/(commit log)

2026-07-28 tạo mô hình 3d cho đĩa xoay cấp phôi ốc vít
    [_note.scad, assembly_exploded.step, assembly_exploded.stl, assembly_reference.step, assembly_reference.stl, assembly_spiral_exploded.stl, assembly_spiral_reference.step, assembly_spiral_reference.stl]
2026-07-30 vẽ mô hình cấp phôi theo phương pháp step feeder
    [assembly_exploded.stl, assembly_reference.step, assembly_reference.stl, base.step, base.stl, cam.step, cam.stl, cam_A.step]
2026-07-30 thiết kế máy đềm viên thuốc dạng đĩa phẳng refer: https://www.youtube.com/watch?v=CM4_RVPX__8
    [jgb37_motor_bracket.FCStd]
2026-07-31 loại bỏ các file nặng không cần thiết
    [jgb37_motor_bracket.FCStd, step_drive_4plate.blend, step_feeder_blender.blend, step_feeder_compare.blend, step_feeder_video_ref.blend]
2026-07-31 chỉnh sửa thiết kế khay thoát và cơ cấu điều chỉnh động rộng khe thoát
    [jgb37_motor_bracket.FCStd]
2026-08-01 thiết kế lại nắp máy đếm với rãnh dẫn hướng thu hẹp dần
    [jgb37_motor_bracket.FCStd]
2026-08-01 hoàn thiện phần rãnh dẫn hướng cho viên thuốc
    [jgb37_motor_bracket.FCStd]
2026-08-02 thiết kế cơ cấu tạo chuyển động tịnh tiến khi xoay núm vặn
    [HA_Bearing_L.stl, HA_Bearing_R.stl, HA_Bottom_Stop.stl, HA_Collar.stl, HA_Follower.obj, HA_Follower.stl, HA_Follower_vhacd.obj, HA_Friction_Washer.stl]
2026-08-03 thiết kế đối xứng cơ cấu xoay-tịnh tiến
    [HA_Bearing_L.stl, HA_Bearing_R.stl, HA_Bottom_Stop.stl, HA_Collar.stl, HA_Follower.obj, HA_Follower.stl, HA_Follower_vhacd.obj, HA_Friction_Washer.stl]
2026-08-06 thêm cơ cấu chống trượt cho hệ thống tịnh tiến
    [adjustable_chute.FCStd, rotary_linear.FCStd]
2026-08-07 tạo cơ cấu thanh trượt đóng mở chia viên thuốc thành cacác luồng khác nhau
    [disc_access_lid.FCStd, jgb37_motor_bracket.FCStd, l_flap_divert.FCStd]
2026-08-07 sử dụng cơ cấu malta để đóng mở cửa thay cho 2 thanh vuông góc
    [l_flap_divert.FCStd]
2026-08-10 tạo mới cơ cấu dịch chuyển và đổi máng
    [l_flap_divert.FCStd, width_chute_selector.FCStd]
2026-08-13 tạo cơ cấu điều chỉnh hàng đơn và đĩa quay đơn giản
    [Bowl_Tube.stl, Crossbar_Bridge.stl, Exit_Track.stl, Guide_System.stl, Height_Scraper.stl, Inner_Lane_Rail.stl, Rotor_Disc.stl, Scale_Height.stl]
2026-08-14 tách cơ cấu đĩa thành nhiều component nhỏ
    [Backlight_Mount.FCStd, Backlight_Panel.FCStd, Bowl_Tube.FCStd, Camera_Mount.FCStd, Chute_Slide.FCStd, Collection_Funnel.FCStd, Crossbar_Bridge.FCStd, Exit_Camera.FCStd]
2026-08-16 thay cụm chỉnh W/H 12h bằng cổng chặn chiều cao ở đầu lane, dời máng exit về mép đĩa
    - xóa Crossbar_Bridge / Width_Carriage / Height_Scraper / Scale_Width / Scale_Height
    - thêm part_entry_gate.py: Entry_Gate_Post / Slider / Barrier (chỉnh H ở đầu lane)
    - W chỉnh bằng cách trượt Inner_Lane_Rail trên ray T của Chute_Slide
    - máng exit lấy cạnh trái trùng mép đĩa, chạy vào trong dưới đĩa
    - thêm verify_entry_gate.py, verify_exit_chute_catch.py; bỏ verify_adjust_travel.py
    [Bowl_Tube.FCStd, Crossbar_Bridge.FCStd, Entry_Gate_Barrier.FCStd, Entry_Gate_Post.FCStd, Entry_Gate_Slider.FCStd, Exit_Ramp.FCStd, Height_Scraper.FCStd, Scale_Height.FCStd]
2026-08-18 sửa lại cơ cấu để vật trên đĩa luôn đi qua máng thoát hàng đơn
    [Backlight_Mount.FCStd, Backlight_Panel.FCStd, Bowl_Tube.FCStd, Camera_Mount.FCStd, Chute_Slide.FCStd, Collection_Funnel.FCStd, Entry_Gate_Barrier.FCStd, Entry_Gate_Post.FCStd]
2026-08-18 thêm cơ cấy núm xoay bánh cam để dịch chuyển vị trí thanh tịnh tiến
    [Bowl_Tube.FCStd, Entry_Gate_Cam.FCStd, Entry_Gate_Dial.FCStd, Entry_Gate_Knob.FCStd, Entry_Gate_Post.FCStd, Entry_Gate_Slider.FCStd, Exit_Cam.FCStd, Exit_Dial.FCStd]
2026-08-24 tạo model di chuyển tịnh tiến bằng động cơ DC
    [n20_leadscrew_stage.FCStd]
2026-08-24 modul hóa cơ cấu tịnh tiến thành 1 hộp
    [n20_leadscrew_stage.FCStd]
2026-08-25 thu gọn cơ cấu tịnh tiến và tăng hành trình di chuyển
    [n20_leadscrew_stage.FCStd]
2026-08-26 fix các lỗi trên module để tháo lắp được
    [esp32_baseboard.kicad_pcb, esp32_baseboard.kicad_sch, n20_leadscrew_stage.FCStd]
2026-08-27 tạo PCB mạch base board ghép nối các sub module
    [esp32_baseboard.kicad_pcb, esp32_baseboard.kicad_sch]
2026-08-27 tạo cơ cấu mới dùng động cơ step 28BYJ-48 và cơ cấu bánh răng - thanh răng
    [byj_rack_stage.FCStd]
2026-08-28 sửa lỗi ngắn mạch trên board
    [esp32_baseboard.kicad_pcb, esp32_baseboard.kicad_sch]
2026-09-02 sắp xếp và chọn lại linh kiện cho PCB
    [esp32_baseboard.dsn, esp32_baseboard.kicad_pcb, esp32_baseboard.kicad_sch, routed.best.kicad_pcb, routed.kicad_pcb, unrouted.kicad_pcb]
2026-09-03 đi dây cho mạch PCB
    [esp32_baseboard.dsn, esp32_baseboard.kicad_pcb, esp32_baseboard.kicad_sch, routed.best.kicad_pcb, routed.kicad_pcb, unrouted.kicad_pcb]
2026-09-04 update PCB cho phần power và opto và sắp xếp linh kiện
    [esp32_baseboard.dsn, esp32_baseboard.kicad_pcb, esp32_baseboard.kicad_sch, m3_uln2003.kicad_pcb, routed.best.kicad_pcb, routed.kicad_pcb, submodules_panel.kicad_pcb, unrouted.kicad_pcb]
2026-09-07 update kích thước chuẩn của động cơ step 28BYJ-48 và xuất file stl để in 3d
    [28BYJ-48_original.FCStd, 28byj48_reference_split.FCStd, BYJ_Motor_PrintInPlace.stl, Guide_Rod_A.stl, Guide_Rod_B.stl, Guide_Rod_Cap_A.stl, Guide_Rod_Cap_B.stl, Housing.stl]
2026-09-11 update BOM và PCB với danh sách linh kiện mới loại bỏ màn hình cảm ứng và động cơ điều chỉnh độ rộng vách thay bằng led 7 thanh và bàn phím dán
    [esp32_baseboard.kicad_pcb, esp32_baseboard.kicad_sch]
2026-09-13 thêm usb để nạp chương trình và loại bỏ buzz
    [Classic_Style_assembled.stl, Classic_Style_khop_noi.stl, esp32_baseboard.kicad_pcb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]
2026-09-15 thay chip esp32 bằng stm32
    [esp32_baseboard.kicad_pcb, esp32_baseboard.kicad_sch]
2026-09-15 Cập nhật carrier STM32: giắc N/S, USB+BOOT/RESET, courtyard ≥2.5mm.
    Xóa pcb/esp32_soldered/.history và ignore thư mục .history.
    [esp32_baseboard.kicad_pcb, esp32_baseboard.kicad_sch]
2026-09-16 chuẩn hóa layout mạch để phù hợp nhiều loại hộp
    [esp32_baseboard.kicad_pcb]
2026-09-16 update 3d view để khớp với PCB
    [esp32_baseboard.kicad_pcb, esp32_baseboard.kicad_sch]
2026-09-18 thêm review JLCPCB và cập nhật BOM, bỏ tracking JRE/out.
    [esp32_baseboard.kicad_pcb, esp32_baseboard.kicad_sch, jlc_lcsc.csv]
2026-09-19 thu nhỏ board và đi dây bằng tay cho stm32
    [esp32_baseboard.kicad_pcb, esp32_baseboard.kicad_sch]
2026-09-20 đi dây bằng tay hoàn thiện cho board. không dùng LLM AI
    [esp32_baseboard.kicad_pcb, esp32_baseboard.kicad_sch]
2026-09-21 change all folder/file từ esp32 sang STM32G030C8T6
    [STM32G030C8T6.kicad_pcb, STM32G030C8T6.kicad_sch, esp32_baseboard.kicad_pcb, esp32_baseboard.kicad_sch, jlc_lcsc.csv, m3_uln2003.kicad_pcb, submodules_panel.kicad_pcb]
2026-09-21 thêm đèn led báo trạng thái và thêm kịch bản review cho pcb
    [STM32G030C8T6.kicad_pcb, jlc_lcsc.csv]
2026-09-21 viết firmware điều khiển cho máy đếm thuốc/hạt giống
2026-09-22 update logic nhập bàn phím và build project bằng stm32cubeIde
2026-09-22 thay đổi giắc điều khiển máng rung sang on/off phù hợp máy việt nam
    [STM32G030C8T6.kicad_pcb, STM32G030C8T6.kicad_sch]
